timurufa86/kamaz_leveler/README.md

# Kamaz-Leveler

Прошивка системы выравнивания пневмоподвески (ESP32 + FreeRTOS + GitHub OTA).

- Базовая ветка разработки: **`refactor/modular-firmware`**
- Скетч: `kamaz_10_16_8_fr_adafruiti_OTA_NM/`
- Репозиторий: https://github.com/timurufa86/kamaz_leveler

## Аппаратная часть (PCB)

Проект платы (KiCad 10, 2 слоя, корпус 15-8) лежит в [`hardware/`](hardware/README.md).
Там же — документация, рендеры, производственные файлы и скрипты экспорта.

## Toolchain

- **arduino-cli** 1.5.1+
- Ядро: **esp32:esp32 3.3.11+**
- Библиотеки: из `C:\my\libraries` (подключаются через `arduino-cli.yaml`)

## Сборка

Библиотеки подключаются через проектный `arduino-cli.yaml`, где
`directories.user: C:/my` — то есть sketchbook указывает на `C:\my`, а
библиотеки берутся из `C:\my\libraries`.

```powershell
# Компиляция (экспортирует *.bin в build/esp32.esp32.esp32/)
./build.cmd

# Компиляция + прошивка на подключённую плату
./build.cmd COM5
```

Или напрямую:

```powershell
arduino-cli compile --config-file arduino-cli.yaml `
  -b "esp32:esp32:esp32:PartitionScheme=custom,FlashSize=4M" --warnings none --export-binaries `
  --build-property compiler.c.elf.extra_flags=-Wl,--allow-multiple-definition `
  kamaz_10_16_8_fr_adafruiti_OTA_NM
```

> `--warnings none` обязателен: библиотека GEM 1.8.1 содержит функцию без
> `return`, которую ядро ESP32 превращает в ошибку через `-Werror=return-type`.
> (Значение можно передавать как `-Wl,--allow-multiple-definition` или через
> `-D`, главное — попасть в `compiler.c.elf.extra_flags`.)

> `--build-property compiler.c.elf.extra_flags=-Wl,--allow-multiple-definition`
> обязателен, начиная с 8.6.0: библиотека GEM компилируется целиком (включая
> `GEM_u8g2.cpp`), из-за чего в сборку попадает библиотека `U8g2`, а её
> `src/clib/u8g2_fonts.c` дублирует символы шрифтов из
> `U8g2_for_Adafruit_GFX/src/u8g2_fonts.c`. Флаг разрешает дубликаты: линковщик
> оставляет первое определение, неиспользуемые секции удаляются `--gc-sections`.
> Без флага сборка падает на этапе линковки с `multiple definition of
> 'u8g2_font_...'`.

## Карта флеша (4 МБ, своя таблица разделов)

Плата оснащена **4 МБ** флеш-памяти. Штатные OTA-слоты ядра (1.25 МБ) малы
для скетча (~1.6 МБ), поэтому используется **своя схема разделов**
(`kamaz_10_16_8_fr_adafruiti_OTA_NM/partitions.csv`, `PartitionScheme=custom`):

| Раздел | Смещение | Размер | Назначение |
|---|---|---|---|
| `nvs` | 0x9000 | 20 КБ | Wi-Fi/настройки IDF |
| `otadata` | 0xe000 | 8 КБ | выбор OTA-слота |
| `app0` (ota_0) | 0x10000 | **1.75 МБ** | основной слот прошивки |
| `app1` (ota_1) | 0x1D0000 | **1.75 МБ** | слот для OTA-обновления |
| `spiffs` | 0x390000 | 384 КБ | LittleFS (`/config.txt`) |
| `coredump` | 0x3F0000 | 64 КБ | дамп при сбое |

Скетч ~1.6 МБ занимает ~87% слота; запас роста ~230 КБ на слот.

> ⚠️ **Смена карты флеша требует разовой прошивки по USB** (bootloader +
> partitions + app). OTA с прежней 16-мегабайтной схемы разделы НЕ переносит.

## Используемые библиотеки

Резолвятся из `C:\my\libraries`:

| Библиотека | Версия |
|---|---|
| ArduinoJson | 7.4.3 |
| Adafruit BusIO | 1.17.4 |
| Adafruit GFX Library | 1.12.6 |
| Adafruit ST7735 and ST7789 Library | 1.11.0 |
| Adafruit ADS1X15 | 2.6.2 |
| EncButton | 3.7.6 |
| GEM | 1.8.1 |
| GyverFilters | 3.2.0 |
| MPU6050 | 1.4.5 |
| U8g2_for_Adafruit_GFX | 1.8.0 |
| U8g2 (только как источник шрифтов, напрямую не подключается) | 2.36.19 |

## Настройки и сервис (8.8.0)

Новые параметры меню (все сохраняются в `/config.txt`, формат **3**, и подгружаются
при старте; старые `config.txt` форматов 1–2 читаются, новые поля = значения по умолчанию):

| Раздел меню | Пункты | Значение по умолчанию |
|---|---|---|
| Давление | Проверка МП,с | 240 |
| Клапаны | Макс.время,с; Зона нечувств.,бар | 10; 0.20 |
| Авторежим | Грубая зона; Точная зона; Порог «хуже» | 0.40; 0.15; 1.20 |
| Движение | Длительность,с; Успокоение,с; Проверка,с; Допуск,бар; Порог гиро; Порог аксель | 30/30/120/0.2/50/1000 |
| Дисплей | Гасить,мин (0 = никогда); Интервал,мс; Порог углов; Порог давл. | 0; 50; 0.05; 0.03 |
| IMU / MPU6050 | Порог детектора; Нуль X,град; Нуль Y,град | 100; 0.0; 0.0 |

Запись конфига — атомарная (`config.tmp` → `config.txt`, предыдущая версия в
`config.bak`), после записи файл проверяется чтением; при старте и после
сохранения в Serial печатается дамп всех значений (`[CFG] …`). Страница меню
**«Настройки»** показывает текущие значения на экране.

### Новые разделы меню

- **«IMU / MPU6050»**
  - **Обнулить углы** — текущее положение становится нулём (с подтверждением
    КН3/КН4); нуль сохраняется в конфиг и учитывается в показаниях и в авторежиме.
  - **Калибровка офсетов** — библиотечная `CalibrateGyro`/`CalibrateAccel` (DMP на
    время калибровки выключается), 6 офсетов сохраняются в конфиг и применяются при
    старте. Требуется ровная площадка и неподвижная машина 10–20 с.
  - **Диагностика MPU** — DeviceID, температура, углы, сырые `getMotion6`, офсеты,
    признак ошибки MPU.
  - **Порог детектора** — аппаратный `setMotionDetectionThreshold` (20…255).
- **Ручной тест клапанов** (раздел «Тестирование») — 6 выходов: ПЛ, ПП, ЗЛ, ЗП,
  НАКАЧКА, СБРОС. Кн1/Кн2 — выбор, **клапан открыт, пока удерживается КН3**,
  Кн4 — выход с закрытием всех клапанов; страховочный таймаут 15 с; доступно
  только в РУЧНОМ режиме без ошибок и вне OTA; аварийная остановка КН4+КН5
  также закрывает клапаны.
- **Гашение подсветки** — по бездействию N минут (`Дисплей → Гасить,мин`);
  первое нажатие только включает подсветку и не выполняет действие.

## Визуализация: экран ДВИЖЕНИЯ (8.9.0)

В режиме ДВИЖЕНИЯ главный экран автоматически сменяется отдельным «экраном движения»:

- цели передних/задних подушек (из настроек) vs текущие давления и рассогласование Δ
  с цветом по допуску (`Движение → Допуск,бар`);
- четыре карточки подушек: текущее значение, метка цели на полосе, Δ по каждой подушке;
- таймеры: «в движении N с», «СТАБИЛИЗАЦИЯ N с» (полоса), «след. проверка N с»,
  «последняя подкачка N с назад»;
- активные клапаны (накачка/сброс передних/задних) с анимацией «бегущих штрихов»;
- тренд (спарклайн) давлений за 30 с: две линии (перед/зад) + штриховые линии целей;
- режимные иконки из `icon.h` в статус-баре (20×20) и пульсирующий бейдж движения в шапке;
- сглаживание (интерполяция) значений и частичная перерисовка — без мерцания.

Логика движения и выравнивания не менялась — экран только читает данные. Наружу вынесены
две переменные времени последней корректировки (`movementLastAdjustFront/Rear`) и
добавлена отметка начала движения (`movementStartMs`).

## Меню и обновления (8.7.0)

- **Вход в меню** — удержание пары **КН3 + КН4** (GPIO15 + GPIO17, 2 с) из любого
  режима и экрана. **Аварийный стоп** — удержание пары **КН1 + КН4**
  (GPIO13 + GPIO17, 2 с); он обрабатывается первым и подавляет открытие меню.
- В меню: Кн1/Кн2 — навигация, Кн3 — ОК, Кн4 — назад (пункт «Назад» создаёт GEM для
  подстраниц), Кн5 — сохранить и выйти. Подсказка дублируется в шапке меню.
- Раздел **«Обновления»**: проверка GitHub, список до 3 релизов
  (`/releases?per_page=3`), карточка релиза (дата, размер, статус, SHA-256),
  установка последней или выбранной версии, режим ArduinoOTA (Wi-Fi).
- Экран прогресса обновления показывается в любом режиме, шапка «ОБНОВЛЕНИЕ»,
  крупный процент и предупреждение «Не выключайте питание».
- Wi-Fi: пароль единый (`asd12345`), экран выбора сети переведён на U8g2 (шкала
  уровня сигнала, усечение длинных имён).
- Страница «Информация» в меню — живая: версия, режим, MPU, давление в магистрали,
  Wi-Fi (SSID/RSSI), аптайм и свободная RAM, число активных ошибок.

## Home Assistant (10.16.0)

Интеграция по **HTTP REST**, включается в меню **Система → Дом (HA)**. Брокер не
нужен: устройство поднимает сервер на порту 80.

- `GET /api/state` — вся телеметрия; `GET /api/config` — все настройки;
  `POST /api/config` — безопасное подмножество; `POST /api/mode` — АВТО/РУЧНОЙ;
  `POST /api/manual` — start/stop/pulse; `POST /api/action` — reset/save/stop/restart.
- Необязательный токен `X-Api-Key` (Serial: `HA TOKEN <стр>`).
- Готовые файлы: `ha/kamaz_leveler_package.yaml`, `ha/kamaz_leveler_dashboard.yaml`,
  инструкция — `docs/HA_INTEGRATION.md`.
- На время OTA сервер останавливается (освобождает сокеты/кучу) и поднимается после.

## Версионирование и релиз

- SemVer: см. `.cursor/rules/semantic-versioning.mdc` (стиль папок/веток `9.0.0`).
- OTA-релиз: см. `.cursor/rules/github-ota-release.mdc`
  (ассеты `kamaz_leveler.bin` + `kamaz_leveler.bin.sha256`, тег `v9.0.0`).

## Типографика и визуализация (появились в 8.6.0)

Весь текст на экранах выводится через **U8g2_for_Adafruit_GFX** (UTF-8, честные
размеры шрифтов, кириллица) — слой из трёх модулей:

| Модуль | Назначение |
|---|---|
| `ui_theme.h` | палитра RGB565, сетка и метрики экрана (отступы, радиусы, высоты строк) |
| `ui_fonts.h` | шрифтовая лестница `UiFont` (Tiny…Huge) — кириллические шрифты U8g2 |
| `ui_text.h` / `.cpp` | класс `UiText` (экземпляр `ui`): печать по базовой линии, выравнивание и вертикальное центрирование в прямоугольнике, `printf`-варианты без динамической памяти, усечение строк с `..` |

Шрифтовая сетка (все с кириллицей):

| Роль | Шрифт | Применение |
|---|---|---|
| Tiny | `u8g2_font_5x7_t_cyrillic` | подсказки, подписи шкал |
| Small | `u8g2_font_6x13_t_cyrillic` | основной мелкий текст, списки |
| SmallB | `u8g2_font_6x13B_t_cyrillic` | акценты и подписи карточек |
| Body / BodyWide | `u8g2_font_7x13` / `8x13_t_cyrillic` | основной текст |
| Med | `u8g2_font_10x20_t_cyrillic` | заголовки экранов, значения |
| Large / XLarge / Huge | `u8g2_font_inr24/33/46_t_cyrillic` | крупные значения, сплэш |

Важно: `U8g2_for_Adafruit_GFX` **не масштабирует** текст (аналога `setTextSize`
нет), поэтому размер задаётся выбором шрифта — глифы остаются пиксель-в-пиксель
вместо растягивания. Меню GEM (`GEM_adafruit_gfx`) по-прежнему работает на
Adafruit-GFX-шрифтах `CourierCyr7`/`CourierCyr9` из `FontsRus/` — только для
пунктов меню; все остальные экраны переведены на U8g2.
