timurufa86/kamaz_leveler/PROMPT_hardware_schematic_pcb.md

# Промт: проект принципиальной схемы и трассировки платы Kamaz-Leveler

> Как использовать: открой новый проект в Cursor/Claude с этим репозиторием прошивки
> (`kamaz_leveler/`, ветка `refactor/modular-firmware`, скетч `kamaz_10_16_8_fr_adafruiti_OTA_NM/`),
> чтобы агент мог читать `app_pins.h`, `README.md`, `MODULES.md`.
> Скопируй текст ниже целиком как первое сообщение.

---

## 0. Роль

Ты — инженер-схемотехник и PCB-дизайнер с опытом автомобильной электроники (24 В бортсеть,
индуктивные нагрузки, EMC/ESD, ISO 7637-2 / ISO 16750-2). Ты ведёшь проект целиком: от
блок-схемы и принципиальной схемы до трассировки, проверок и выпуска файлов в производство.
Работай в **KiCad 8+** (проект, библиотеки, ERC/DRC, gerbers). Отвечай по-русски, кратко и
по делу; всё неизвестное помечай `TBD`, все допущения — `[ASSUMPTION]`. Ничего не выдумывай:
если данных нет — спрашивай.

## 1. Задача

Разработать с нуля **заказопригодный** проект печатной платы автомобильного блока
управления системой выравнивания пневмоподвески КАМАЗ:

- MCU: **ESP32-WROOM-32** (4 МБ флеш, Wi-Fi, OTA, **без PSRAM** — обязательно WROOM, не WROVER:
  GPIO16/17 заняты);
- 6 пневмоклапанов **24 В** (4 селектора подушек + НАКАЧКА + СБРОС), управление активным HIGH;
- 5 кнопок (на GND, с внешними подтяжками);
- TFT **ST7789 320×240** по SPI (до 40 МГц) с ШИМ-подсветкой;
- датчик давления **JHM1200** (I2C 0x78, 0…1 МПа) и **MPU6050** (I2C 0x68/0x69) на одной шине;
- питание от бортовой сети грузовика **24 В**, UART для прошивки и логов.

## 2. Неизменяемая часть — прошивка (источник истины по пинам)

Прошивка версии **10.16.8**; распиновка задана жёстко в
`kamaz_10_16_8_fr_adafruiti_OTA_NM/app_pins.h`. **Менять назначение GPIO без отдельного
письменного согласования запрещено.**

### 2.1 Занятые пины

| GPIO | Функция | Направление | Особенности / ограничения на плате |
|---|---|---|---|
| 21 | I2C SDA (JHM1200 0x78 + MPU6050 0x68/0x69) | bidir, open-drain | внешняя подтяжка 4.7 кОм к **3.3 В**, шина 100 кГц |
| 22 | I2C SCL | out, open-drain | подтяжка 4.7 кОм к 3.3 В |
| 23 | TFT MOSI (VSPI) | out | короткие дорожки, в стороне от силовых |
| 18 | TFT SCLK, 40 МГц | out | то же |
| 5 | TFT CS | out | **strap-пин**: при старте должен быть HIGH — внешняя подтяжка 10 кОм вверх |
| 16 | TFT DC | out | на WROVER занят PSRAM → только WROOM |
| 19 | TFT RST | out | в VSPI это MISO; MISO не используется, ничего не подключать |
| 4 | TFT BL (подсветка) | ШИМ (analogWrite/LEDC) | ключ на транзисторе/MOSFET + токоограничивающий резистор, если модуль без драйвера |
| 32 | Клапан BUB1 (ПЛ) | out | HIGH = катушка под напряжением |
| 33 | Клапан BUB2 (ПП) | out | HIGH = открыт |
| 25 | Клапан BUB3 (ЗЛ) | out | HIGH = открыт |
| 26 | Клапан BUB4 (ЗП) | out | HIGH = открыт |
| 27 | Клапан INFL (накачка) | out | HIGH = открыт |
| 14 | Клапан DEFL (сброс) | out | HIGH = открыт |
| 13 | КН1 | in, `INPUT_PULLUP` | кнопка на GND; RC-фильтр + ESD |
| 12 | КН2 | in, `INPUT_PULLUP` | **strap MTDI**: недопустим LOW в момент старта (см. §3.4) |
| 15 | КН3 | in, `INPUT_PULLUP` | **strap**: при старте HIGH — кнопка на GND совместима |
| 17 | КН4 | in, `INPUT_PULLUP` | кнопка на GND |
| 34 | КН5 | in, **input-only** | нет внутренних подтяжек → **обязателен внешний резистор 10 кОм на 3.3 В** |
| 1 / 3 | UART0 TX/RX (лог 115200, прошивка) | — | вывести на USB-UART и/или тестовый хедер |
| 6…11 | внутренняя SPI-флешь | — | **не занимать** |
| 0 / 2 | strap (boot) | — | использовать только при необходимости, с подтяжками |

### 2.2 Логика клапанов и безопасность

- `HIGH` = катушка под напряжением, `LOW` = закрыт.
- **Критично:** при отсутствии питания 3.3 В, в reset, при зависании MCU и во время загрузки
  (до `setup()`) все клапаны обязаны быть **аппаратно закрыты** → на каждом входе драйвера
  обязателен **pull-down 10 кОм** и отсутствие подтяжки вверх. Прошивка 10.15.x обесточивает
  выходы в первых строках `setup()`, но до старта ядра GPIO плавают.
- Прошивка не читает состояние клапанов (нет линий диагностики) — силовой каскад должен быть
  самозащищённым (токовое ограничение, термозащита) либо иметь внешние предохранители по каналу.

### 2.3 Датчики

- Давление в 4 подушках и в магистрали измеряется **одним** датчиком JHM1200 (0…1 МПа ≈ 10 бар
  избыточного) через пневматический мультиплексор (клапаны BUB1…4 + INFL/DEFL) → на плате
  **один** разъём датчика давления.
- I2C держать на **100 кГц** (на 400 кГц JHM1200 нестабилен рядом с MPU6050); при выносе
  датчиков — витая пара/экран + феррит, длина минимальна.

### 2.4 Питание и нагрузки

- Вход: бортсеть 24 В (реальный диапазон ~18…32 В + пуски и выбросы).
- Потребители: 6 катушек 24 В, ESP32 (пик до ~0.7 А по 3.3 В с Wi-Fi), TFT, датчики.
- Ток катушки и число одновременно открытых клапанов — **уточнить** (по логике прошивки
  одновременно возможны до 3: два селектора + один INFL/DEFL).

## 3. Обязательные требования к электрике

1. **Вход 24 В**: предохранитель (≥5 А, с расчётом), защита от обратной полярности
   (P-MOS / ideal diode), TVS-супрессор на load dump (ISO 7637-2 pulse 5 / ISO 16750-2),
   входной LC-фильтр (синфазный дроссель + X/Y-конденсаторы) для EMC, ESD-защита на всех
   внешних линиях (кнопки, датчики, разъёмы).
2. **Питание логики**: DC/DC 24→5 В (≥2 А, синхронный buck, вход до 40 В, automotive) и
   5→3.3 В (≥1 А) либо 24→3.3 В напрямую; ёмкости и фильтры по даташитам, thermal-расчёт.
3. **Драйверы клапанов**: защищённый ключ, рассчитанный на индуктивную нагрузку 24 В
   (smart low-side switch, например VNLD/BTS/VND…, либо N-MOSFET + gate resistor + pull-down +
   freewheel-диод/RC-снаббер). Расчёт тока удержания/броска, потерь и температуры корпуса.
4. **Поведение при отказах**: при пропаже 3.3 В или reset MCU — все каналы закрыты (pull-down).
   Опционально (по согласованию) — дублирующее реле/ключ обесточивания по аварийной паре кнопок.
5. **Земли**: единая сплошная GND-плоскость предпочтительна; силовой возврат катушек —
   отдельным путём к точке входа питания (звезда), не через аналоговую/I2C-зону; при 4 слоях
   L2 = сплошная GND.
6. **I2C**: подтяжки 4.7…10 кОм **только к 3.3 В**; дорожки короткие (<15 см).
7. **SPI TFT**: линии короткие, не параллельно силовым; BL через ключ (N-MOSFET/NPN + резистор),
   частота ШИМ ≥1 кГц.
8. **Прошивка/отладка**: USB-UART (CP2102N / CH340C) с auto-reset (DTR/RTS → EN/IO0) **или**
   внешний программатор — выбрать и обосновать; отдельный тестовый хедер TX/RX/GND/EN/IO0.
9. **Индикация**: светодиод питания и статусный светодиод.
10. **Опции** (только по согласованию): внешний watchdog (TPL5010/5011), CAN/RS-485, пищалка.

## 4. Конструктив и трассировка

- Слоёв: минимум 2, рекомендуется 4 (L1 сигнал, L2 GND, L3 питание, L4 сигнал/питание).
- Габарит и крепёж: предложить (ориентир 100×80 мм), 4×M3; согласовать до трассировки.
- Классы проводников: логика 0.25 мм; 3.3 В 0.5 мм; 5 В 1.0 мм; 24 В силовые 1.5…2.0 мм
  (из расчёта тока, ≥1 мм² на 2 А при допустимом перегреве); I2C 0.25 мм.
- Зазоры: 24 В ≥0.5 мм (при >60 В — слот/вырез), смешанные зоны ≥0.3 мм.
- Разъёмы: питание и клапаны — автомобильные с фиксацией (JST-XH/DT/AMP), запас по току,
  strain relief; подписать пины на шелкографии.
- Условия эксплуатации: −40…+85 °C, вибрация, конформное покрытие; тест-поинты GND/3.3/5/24 В,
  TX/RX, I2C, BL, EN/IO0; монтажная маркировка.

## 5. Deliverables

1. KiCad-проект: `.kicad_pro`, иерархия `.kicad_sch` (питание/защита, MCU, драйверы клапанов,
   UI/кнопки, датчики, разъёмы), `.kicad_pcb`, локальные библиотеки символов и футпринтов
   (только проверенные, с MPN).
2. ERC-отчёт: 0 ошибок (предупреждения — с обоснованием).
3. DRC-отчёт: 0 ошибок, 0 неразведённых цепей (ratsnest = 0), нет залитых «островов».
4. BOM CSV: RefDes, Value, MPN, Manufacturer, Package, Qty, поставщик/цена, аналоги + DNP-список.
5. Gerbers + NC drill + BOM/CPL (формат JLCPCB/PCBWay) одним zip, готовые к заказу; STEP 3D.
6. PDF: принципиальная схема (A3) + монтажные слои (F.Cu, F.Silk, F.Fab, F.Mask).
7. `HARDWARE.md`: таблица «GPIO ↔ цепь ↔ пин разъёма», токи/питание, тепловые расчёты
   драйверов и buck, перечень защит, ограничения монтажа, **сверка 1:1 с `app_pins.h`**.
8. Чек-лист ревью и список открытых `TBD`.

## 6. Правила работы

- Сначала — уточняющие вопросы (§7) и блок-схема. Генерацию файлов начинай после ответов;
  если ответов нет — прими явные `[ASSUMPTION]` и пометь их в отчёте.
- Не меняй распиновку прошивки. Предложения по переносу пинов (например GPIO12 из-за strap)
  оформляй отдельным пунктом с обоснованием и последствиями для кода.
- Каждый компонент — с реальным заказопригодным MPN; «Generic» в силовых цепях запрещён.
- Каждую силовую цепь сопровождай расчётом: ток, потери, температура, номинал предохранителя,
  сечение дорожки.
- Этапы с отчётом и подтверждением: **M1** блок-схема → **M2** принципиальная схема →
  **M3** футпринты и размещение → **M4** трассировка → **M5** проверки и выпуск файлов.
- Итоговый ответ по этапу: (1) что сделано, (2) список файлов, (3) ERC/DRC, (4) открытые TBD,
  (5) риски.

## 7. Вопросы до начала работы

1. Тип/модель пневмоклапанов: напряжение (24 В?), ток/мощность катушки, сколько могут быть
   открыты одновременно, требования по времени срабатывания.
2. Как сделано в существующем (as-built) жгуте: high-side или low-side, есть ли реле/драйверы,
   полярность управления (подтвердить HIGH = открыт).
3. Габариты платы, крепление, расположение и тип разъёмов, требования к корпусу и IP.
4. Есть ли в системе 5 В, нужно ли управление по зажиганию (IGN), допустимый ток потребления,
   нужна ли гальваническая развязка.
5. Внешние интерфейсы: только кнопки и экран или нужны CAN/RS-485/доп. датчики (в прошивке
   сейчас их нет).
6. Дисплей: точная модель ST7789 320×240 (2.4"/2.8"/3.5"), тип шлейфа/разъёма, на плату или
   на панель (вынос).
7. Датчики JHM1200 и MPU6050: на плате или выносные, длина шлейфа, нужна ли термостабилизация.
8. Кнопки: 5 шт. на плате или выносная панель; нужна ли подсветка/пищалка.
9. Требования EMC/сертификации, серийность (1 шт. / мелкая серия), бюджет, предпочтительные
   поставщики (JLCPCB/LCSC/Чип и Дип).
10. Обязательные стандарты: ISO 7637-2, ISO 16750-2, ведомственные ТУ/ГОСТ заказчика?

## 8. Критерии приёмки

- ERC и DRC чистые; таблица пинов совпадает с `app_pins.h` **1:1** (приложить сверку).
- Все 6 каналов закрыты при отсутствии 3.3 В, reset MCU и зажатой кнопке — подтверждено
  наличием pull-down на каждом драйвере.
- I2C подтянут к 3.3 В (не к 5 В); strap-требования GPIO12/15/5 выполнены и описаны.
- BOM заказопригоден, gerbers принимаются JLCPCB/PCBWay без правок.
- Есть тепловые расчёты драйверов и преобразователей, рассчитаны предохранитель и TVS.
- Приложены STEP, монтажные слои, PDF схемы, `HARDWARE.md`.

## 9. Запрещено

- Использовать GPIO 6…11; вешать на GPIO12 что-либо, создающее LOW при старте; занимать
  GPIO0/2 без нужды.
- Питать катушки 24 В от 3.3/5 В; ставить драйвер без freewheel-диода и без pull-down.
- Подавать 5 В логику на пины ESP32 без преобразования уровня.
- Оставлять в схеме плавающие входы, необозначенные цепи, «Generic» компоненты в силовых
  цепях, неразведённые узлы.
- Молча менять распиновку прошивки.

## 10. Первый ответ агента

Задай вопросы из §7, предложи блок-схему устройства и план этапов M1…M5 с ожидаемым объёмом
работ, затем жди подтверждения. Файлы не генерируй до подтверждения.
