timurufa86/kamaz_leveler/hardware/HANDOFF.md

# HANDOFF — Kamaz Leveler HW (состояние на 18.10.2026, 07:45)

## Как продолжить

Откройте новый чат и напишите:
> «Прочитай C:\my\HANDOFF.md и продолжи с раздела "Следующие шаги"»

## Проект

Контроллер пневмоподвески КАМАЗ: ESP32 30-pin DevKitC, 6 клапанов 12 В (high-side),
5 кнопок (выносная плата кнопок, на материнской плате — только разъём), дисплей ST7789 (SPI),
JHM1200 + MPU6050 (I²C). Плата 83×58 мм, 2 слоя, компоненты с обеих сторон.

## Файлы

| Файл | Размер | Состояние |
|---|---|---|
| `kamaz_leveler_hw.kicad_sch` | 438 076 б | ✅ **ERC 0/0**. **114 компонентов**: база 72 + индикаторы D11–D16/R23–R28 + J6 (гироскоп) + **U6 PCAL9555APW** + C29 + R29–R38 + **датчики: J7 (скорость), J8 (давление), U11 (78L08), U12 (74LVC1G14), JP1, R39–R42, D17/D18/D20, C30–C33/C35** |
| `...bak_before_valve_leds` | 317 471 б | бэкап ДО индикаторов клапанов (72 компонента) |
| `...bak_before_rm_j6` | 320 913 б | бэкап ДО удаления J6 |
| `...bak_before_L4C28` | 318 687 б | бэкап ДО правок 24 В |
| `kamaz_leveler_hw.kicad_pcb` | — | **Пользовательская расстановка (U7 ESP32-C3, 117 футпринтов = 113+4, совпадение с нетлистом 1:1), 2 слоя. Разводка: 253/284 цепей, 31 не разведена, DRC-электрика чистая (0 shorting/clearance); остались только cosmetic/mechanical (courtyard 9 под модулем, via_dangling 13, track_width 2, silk). Бэкапы: `.routed_user_18`, `.routed_72` |
| `...kicad_pcb.bak_before_reflow` | 554 908 б | рабочее состояние платы (на него откатывались после попыток перекомпоновки) |
| `...kicad_pcb.bak_before_rm_j6`, `...bak_after_j6_rm` | 537 553 б | плата до/после удаления J6 |
| `BOM.csv` | 4 326 б | ✅ из схемы, **114 позиций** |
| `route\` | — | `board4.dsn`, `board4.ses`, `pipeline4.cmd`, `ses_import_fix.py` — headless DSN→FreeRouting→SES→DRC |
| `drc_after_routing.json` | 137 КБ | DRC разведённой платы (48 unconnected) |
| `M7_board_routed.png` | 169 КБ | картинка разведённой платы (без J6) |
| `PLACEMENT_PLAN.png` | 115 КБ | **план размещения компонентов** — зоны, разъёмы, U6/индикаторы/J6, keep-out антенны |
| `PLACEMENT_TABLE.md` | 6 КБ | **таблица плана**: координаты якорей, зоны с полными списками ref, правила |
| `LEDS_PLACEMENT.png` | 73 КБ | детальный план индикаторов: D11–D16 + R23–R28 (клапаны), D4 + R22 (+3V3) — координаты и подключение |
| `GYRO_PINOUT.png` | 106 КБ | **распиновка J6** — отдельный 4-pin разъём гироскопа (VCC/GND/SCL/SDA), схема подключения и место на плате |
| `DESIGN_OPTIONS_pcf8575.md` | 9 КБ | **варианты архитектуры клапанов**: PCF8575 / PCA9555 / PCAL9555A / TCA9535, общий +12 В и низкие ключи — сравнение, решение, реализация |
| `PCAL9555_BLOCK.png` | 74 КБ | блок-схема U6 PCAL9555APW: биты, клапаны/ST/кнопки, fail-safe VLV_EN |
| `LOW_SIDE_OPTION.png` | 115 КБ | блок-схема варианта «общий +12 В + низкий ключ» |
| `M6_schematic_24V.pdf` | 350 507 б | схема A2, актуальна: индикаторы, J6, U6, входы датчиков скорости/давления |
| `erc_final.json`, `netlist_final.net` | — | ERC (0/0) и нетлист схемы |
| `HARDWARE.md` | ~28 КБ | обновлены §2/§3/§4/§8 (24 В), §9 (PCAL9555APW), §10 (датчики) |
| `C:\my\sch3\` | — | скрипты этапа: `core.py`, `router.py`, `reflow*.py`, `place_*.py`, `local_phys.py`, `pack_all*.py`, `verify_net.py`, `add_valve_leds.py`, `add_leds_mcp.py`, `pcb_add_leds.py`, `bom_final3.py` |
| `C:\my\pcb_prep\` | — | read-only разбор платы: `REPORT_pcb_prep.md`, inventory, DRC-пары, координаты L4/C28 |

### 3D-модели (STEP, SnapEDA)

- KiCad: `C:\my\kamaz_leveler_hw\3dmodels\` — TPS54560BDDA.stp, BTS724GXUMA1.stp,
  74HCT541D.stp, AP3211KTR-G1.stp, ESP32-DevKitC.stp (прописаны: U1, U2, U3, U4, U5, U9)
- Proteus: `C:\ProgramData\Labcenter Electronics\Proteus 9 Professional\Models\`
- Исходные архивы: `C:\my\step_extracted\`, `D:\proteus\model\`

## Протеус

| | |
|---|---|
| Проект | `C:\Users\Asus\Documents\kamaz_1.pdsprj` (89 145 б) |
| Пакеты | 76/76 назначены, `Verify Packagings` = 1 ошибка (U1 Pin 9 — термопад) |
| Библиотека | `CMOS176_p9.lib` — регистр ESP32 исправлен (`.bak_case`) |
| Плата ARES | пустая: 0 объектов, нет контура → нужен контур 83×58 (`C:\my\kamaz_board_edge.dxf`) |
| Сторож/обёртка | `C:\my\proteus_ensure.cmd`, `C:\my\pkmcp.ps1` |

## Следующие шаги (по порядку)

### 1. ✅ Защита 24 В — выполнено 17.10.2026

`+24V_IN (J1.1) → F1 5A → VIN_FUSED → L4 10µH → VIN_FILT → Q1 IRF9540N (D→S) → +24V →
D1 1.5KE36CA ‖ C28 330µF/35V ‖ C2 470µF + C1 100nF → U1 TPS54560B → +12V → U2 AP3211K →
+5V → U10 AMS1117 → +3V3`.

- L4: `Device:L` 10µH, (25.4, 50.8), между F1.2 и стоком Q1.2 (`VIN_FILT`).
- C28: `Device:C_Polarized` 330µF/35V, (63.5, 57.15), +24V/GND. D1 → 1.5KE36CA.
- ERC 0/0, BOM пересобран. Бэкапы: `.bak_before_L4C28`, `.bak_24v`.

### 2. Замена U9 на `Conn_02x15_Top_Bottom` — ⚠️ рекомендую не делать

Текущий `kamaz_leveler:ESP32-DevKitC_30P` есть в проектной библиотеке, имеет имена выводов
и сверен с DevKitC 1:1. Generic-символ потеряет имена GPIO и потребует перерисовать 30
подключений без выигрыша.

### 3. Метки → провода — черновик есть, в проект не внедрён

Инструментарий в `C:\my\sch3\`. Черновик `sch3\kamaz_step3.kicad_sch`: разведено 16/47
меточных цепей, ERC 0, нетлист совпадает с исходным 1:1. Не внедрён: остальные 30 цепей
требуют перепланировки листа (блоки разнесены на 150–230 мм). Рекомендация: либо оставить
метки (штатная практика KiCad), либо делать перерисовку листа отдельной сессией.

### 4. Плата — синхронизация и первая трассировка выполнены

- **Синхронизация** (pcbnew Python): L4 `L_Bourns_SRP1245A` (66.5, 27.5, rot 90, B),
  C28 `CP_Elec_8x10` (78.5, 30.0, rot 90, B), цепь `/VIN_FILT`; R17 и J6 удалены.
- **Трассировка** headless: `route\pipeline4.cmd` — `ExportSpecctraDSN` → FreeRouting 2.5
  **через JAR + JRE 25** (native `freerouting-cli.exe` падает с GraalVM-багом), 5 проходов
  ~95 с → `ImportSpecctraSES` → ширина дорожек ≥0.25 мм → DRC.
- Результат: **1190 проводников, 48 unconnected** (было 196); DRC 123 (было 99; новые —
  `via_dangling` 20, `copper_edge_clearance` 3, `clearance` +1 от неразведённых цепей).
- Основной блокер — «левая полоса» (J4/J5 ↔ D5–D10 ↔ L3/C2/C13): 90 % нарушений, лечится
  перекомпоновкой. Разбор всех пар — `C:\my\pcb_prep\REPORT_pcb_prep.md`.

### 5. Перекомпоновка платы под EMC/механику — ПЛАН СОГЛАСОВАН, не выполнена

Требования заказчика: 24 В — с одной грани; остальные разъёмы — с противоположной;
дроссели и силовая часть — подальше от I²C и дисплея; без наводок на антенну ESP32;
вся «сила» — в одной зоне.

**Антенна.** У DevKitC USB — со стороны вывода 1 (локальная −X), антенна — на
противоположном торце (локальная +X). Сейчас модуль стоит в (23.72, 16.3) rot 0 —
антенна смотрит вправо, прямо в силовую зону (L2/L4/F1/U1/C28) — это источник наводок.

**Ограничение:** J2 18.9 + J3 16.3 + J4 11.25 + J5 21.4 = 67.9 мм > 58 мм — все 4 разъёма
на одну грань не помещаются. Согласовано заказчиком:

| Грань | Разъёмы |
|---|---|
| левая | J1 (24 В вход) |
| нижняя | J2 (клапаны, 7-pin) — силовая сторона |
| верхняя | J5 (дисплей), J3 (кнопки), J4 (I²C) — сигнальная сторона |
| правая | нет разъёмов; **antenna keep-out x 74…83, y 8…47** (ни деталей, ни дорожек/pour) |

**Зоны (см. PLACEMENT_PLAN.png):**

| Зона | Координаты | Содержимое |
|---|---|---|
| POWER | левая полоса x 0…32, вся высота | J1, F1, L4, Q1, D1, C28, C1/C2/C4/C5, U1+L2, U2+L3, U10, C6/C7/C11–C14, C19–C22, R1–R10 |
| VALVE | x 4,5…40, y 32…50,5 | U3/U4/U5 (SOIC-20W), R11/R13–R16, D5–D10 (рядом с J2) |
| MCU | x 32…83, y 13…42 | U9 rot 0, pad1 (41, 15): USB влево, антенна на правую грань |
| SIGNAL | верхняя полоса | J5, J3, J4 |
| индикаторы | у J2, x 31…47, y 44…51 | D11–D16 + R23–R28 — по одному LED на пин J2 (2…7) |

Ключевые расстояния: L2/L3/L4 — левая/нижняя часть силовой зоны (≥35 мм от J4/J5,
≥40 мм от антенны); силовые узлы — не ближе ~30 мм к правой грани.

**Полный план размещения (101 футпринт: 97 компонентов + 4 отверстия):**
`PLACEMENT_PLAN.png` — зоны и грани; `PLACEMENT_TABLE.md` — координаты якорей и полные
списки компонентов по зонам. В плане учтены новые позиции: **U6 PCAL9555APW + C29 +
R29–R38** — в зоне под модулем ESP32; **J6** (гироскоп) — на нижней грани справа от J2;
**D11–D16 + R23–R28** — у пинов J2.

**Мелкие SMD под модулем ESP32.** Между двумя рядами гнёзд (ряды на y = 15 и y = 40.4,
шаг 2.54 мм) остаётся свободное поле ~31 × 23 мм (x 42…73, y 16…39). Туда выносится
обвязка МК — 11 шт. 0805/1206: `R18, R19, R20, R21` (подтяжки), `C17, C18` (3V3-развязка),
`C23…C27` (фильтры I2C/кнопок). Правила: только низкопрофильные SMD (высота ≤3 мм;
зазор до модуля ≈8.5 мм при гнездовых разъёмах 2.54), ≥1 мм от падов гнёзд, **не ставить**
дроссели, электролиты и силовые ключи 12 В (наводки под МК/антенну). Резерв — ещё
~25 посадочных мест 0805. Индикаторы клапанов `D11–D16 + R23–R28` — вплотную к `J2`: каждый LED стоит
**точно под своим пином** (2/BUB1, 3/BUB2, 4/BUB3, 5/BUB4, 6/INFL, 7/DEFL), резистор —
над своим LED. Активный канал виден сразу. `D4 + R22` (+3V3) — в силовой зоне у выхода U10.

**Статус:** автоматические попытки раскладки (`sch3\pack_all*.py`, `reflow*.py`,
`place_text*.py`) дают зоны, но не доведены до DRC-чистоты: при переносе футпринтов
появляются пары падов с зазором <0.5 мм. Плата откачена в рабочее разведённое состояние.
Делать итеративно: перенос → DRC (~5 с) → правка пар → повторная трассировка. Оценка 1–2 ч.

### 6. Индикаторы питания клапанов — схема готова, плата ожидает

- В схеме: `D11…D16` (`Device:LED`, 0805) + `R23…R28` (4.7 kΩ, 0805) на цепи
  `VALVE_BUB1…4`, `VALVE_INFL`, `VALVE_DEFL`; цепь `VLV_LED1…6` между катодом LED и R.
  Ток индикации ≈ 2.3 мА при 12 В. ERC 0/0, BOM 85 позиций.
- **В плату ещё не внесены** — внести вместе с перекомпоновкой: LED+R вплотную к `J2`,
  по одному каналу на пин 2…7 (LED под пином, R над LED); пад 2 LED — на `VALVE_x`, R — на GND.
- **J6 — отдельный разъём гироскопа (4 пина, I2C)**: `J6.1 = +3V3`, `J6.2 = GND`,
  `J6.3 = I2C_SCL` (U9.17/GPIO22, R21 4.7k), `J6.4 = I2C_SDA` (U9.20/GPIO21, R20 4.7k).
  Подтяжки уже на плате, J4 (I2C) остаётся — гироскоп и, например, барометр работают
  на одной шине. Распиновка и схема — `GYRO_PINOUT.png`. На плате J6 ставится на нижнюю
  грань справа от J2 (x 50…62, y 52.6, rot 90) — вносится вместе с перекомпоновкой.
- **Плата кнопок — отдельно**: кнопки на материнской плате не стоят, `J3` (1×6) —
  разъём для выносной платы кнопок. Отдельную плату кнопок (5 тактовых кнопок 12 мм +
  разъём 1×6) нужно делать отдельным проектом.

### 7. После перекомпоновки

1. Внести 12 индикаторов, перетрассировать (`route\pipeline4.cmd`).
2. U2: FPID `SOT-23-6`, а внутри SOIC-8-1EP — заменить на настоящий SOT-23-6,
   проверить пады 1–6 (BOOT2/GND/FB2/+12V/+12V/SW2).
3. U1: EP ↔ пады 2/3 (+24В) — 0.11 мм при классе 0.5 мм; ослабить класс до 0.2–0.3 мм.
4. Добить остаток unconnected, DRC → 0, экспорт Gerber/drill/pos/BOM/PDF
   (`kicad-cli pcb export gerbers|drill|pos|pdf`).

### 8. Расширитель I²C PCAL9555APW: кнопки + клапаны + чтение ST (18.10.2026)

Статус: **реализовано в схеме**, в плату вносится на шаге перекомпоновки.
Полный разбор вариантов — `DESIGN_OPTIONS_pcf8575.md`, блок-схема low-side — `LOW_SIDE_OPTION.png`.

**Решение:** PCF8575 заменён на **PCAL9555APW** (NXP, TSSOP-24, 16 бит, push-pull выходы,
Agile I/O: маска/защёлка/фронт прерываний). Силовая часть остаётся **high-side BTS724G**,
общий провод клапанов — `J2.1 = GND`; от варианта «общий +12 В, управление минусом» отказались
(теряются ST/защиты PROFET, КЗ на GND = клапан постоянно включён, нужны плавающие клапаны).

**Чип подтверждён:** PCAL9555APW. **TCA9535PWR** — pin-совместимый fallback (тот же TSSOP-24):
замена = только `Value` у U6, цепи/футпринт не меняются; минусы — без Agile I/O и без
встроенных подтяжек (внешние 10k R29–R32/R19/R33–R36 уже стоят). **PCF8575** — другой
корпус (SSOP-24 5,3×8,2), не подходит.

**Раскладка бит U6** (адрес 0x20, VDD = +3V3, C29 100nF):

| Биты U6 | Пины | Цепь | Назначение |
|---|---|---|---|
| P00…P05 | 4…9 | `VLV_IN1…6` | управление клапанами через U5 74HCT541 → BTS724G |
| P06, P07 | 10, 11 | `ST_U3_12`, `ST_U3_34` | флаги неисправностей U3 (пары каналов) |
| P10, P11 | 13, 14 | `ST_U4_12`, `ST_U4_34` | флаги U4 |
| P12…P16 | 15…19 | `BUT1…BUT5` | кнопки (J3), подтяжки R29–R32 + R19 |
| P17 | 20 | — | no-connect (резерв) |
| INT | 1 | `INT_MCU` → U9.7 (IO33) | прерывание по кнопкам/ST, подтяжка R37 10k |
| SCL/SDA | 22, 23 | `I2C_SCL/SDA` | общая шина (подтяжки R20/R21 уже есть) |

**Перекоммутация:**
- `R11…R16` (10k) переехали с входа на **выход U5**: теперь `VLV_DRVn → GND` — держат вход
  BTS724G в 0, когда буфер в Hi-Z;
- `U5.OE1/OE2` (1,19) — не GND, а цепь **`VLV_EN`** = U9.6 (IO32), подтяжка **R38 10k к +3V3**:
  при reset/зависании GPIO в Hi-Z → OE=1 → U5 Hi-Z → клапаны закрыты (fail-safe);
- ST-выводы U3.4/U3.8/U4.4/U4.8 больше не NC: подтяжки **R33…R36** 10k к +3V3 и входы U6;
- кнопки: `BUT1…4` с ESP32 сняты, подтяжки **R29…R32** 10k к +3V3; `BUT5` — через R19;
- освободились 11 GPIO ESP32 (IO32/IO33 ушли на VLV_EN/INT, IO25/IO26/IO27/IO14/IO12/IO13/
  IO17/IO15/IO34 — no-connect).

**Проверено:** ERC `kicad-cli` = **0 ошибок / 0 предупреждений**; нетлист: `VLV_INn` = U5 + U6,
`VLV_DRVn` = U5 + R1x + BTS.IN, ST = BTS + R + U6, `BUTn` = J3 + C + R + U6,
`VLV_EN` = U9.6 + U5.1/19 + R38.2, `INT_MCU` = U9.7 + U6.1 + R37.2; BOM = 97 позиций.
Бэкап схемы: `kamaz_leveler_hw.kicad_sch.bak_before_pcal9555`.

**Прошивка (требования, отдельный репозиторий):** инициализация PCAL (config 0x06/0x07 —
P00…P05 выходы, остальные входы; выходные защёлки 0; сила выходов 2 мА), затем `VLV_EN`=0;
кнопки — 10k-подтяжки + дебаунс/INT; ST — опрос с расшифровкой «пара каналов → виновник».

### 9. Входы датчиков: скорость и давление (18.10.2026)

Использованы освободившиеся после PCAL9555APW пины ESP32: **IO35** (импульсы скорости),
**IO25** (аварийное давление), **IO34** (аналоговое давление). Добавлено **17 позиций**:
J7, J8, U11 (78L08), U12 (74LVC1G14), JP1, R39–R42, D17/D18/D20, C30–C33, C35.
Схема и формулы — `HARDWARE.md` §10. Итог: ERC 0/0, BOM 114 позиций.
Аналоговый вход давления (J9/IO34) исключён по решению заказчика 18.10.2026.

- **Скорость (J7, 4-pin)**: датчик КАМАЗ 4222.3843/ПД8089-х — 8 имп/об, DIN 72585,
  питание 8 В (встроенный 78L08 или от штатного спидометра через JP1); сигнал 8 В →
  делитель 10k/20k → Шмитт 74LVC1G14 → IO35 (PCNT); V = F·3600/K, K калибруется.
- **Аварийное давление (J8, 2-pin)**: переключатель 6032.3829 (5±0,5 кгс/см²) → RC/клэмп →
  IO25, полярность NO/NC в прошивке.
- Аналоговый вход давления (J9/IO34) **исключён** 18.10.2026; IO34 снова свободен (NC).
- В плату эти 17 футпринтов вносятся вместе с перекомпоновкой (итого 42 недостающих).

**ТЗ на прошивку (v11, плата v2):**

| Файл | Размер | Назначение |
|---|---|---|
| `TZ_v11_PCAL9555_SENSORS.md` | 30 КБ | **ТЗ на прошивку 11.0.0** (PCAL9555APW, ST, скорость, давление) — полное (путь: `C:\my\for cursor\kamaz_leveler\kamaz_10_15_6_fr_adafruiti_OTA_NM`) |
| `TZ_v11_E1_IMPLEMENTATION.md` | 23 КБ | **ТЗ этап E1**: клапаны/кнопки через PCAL, VLV_EN, точные замены и код (путь: `C:\my\for cursor\kamaz_leveler\kamaz_10_15_6_fr_adafruiti_OTA_NM`) |
| `TZ_v11_AGENT_PROMPT.md` | 5 КБ | промпт-стартер для агента-разработчика ПО (путь: `C:\my\for cursor\kamaz_leveler\kamaz_10_15_6_fr_adafruiti_OTA_NM`) |
| `hw_map.h` | 7 КБ | готовая карта пинов/битов платы v2 для прошивки (путь: `C:\my\for cursor\kamaz_leveler\kamaz_10_15_6_fr_adafruiti_OTA_NM`) |

- **Перекомпоновка (в работе):** в плату внесены все **118 футпринтов** (добавлены 42 новых: D11–D16, R23–R28, J6, U6, C29, R29–R38, J7/J8, U11, U12, JP1, R39–R42, D17–D20, C30–C33, C35), старые трассы сняты. Расстановка по зонам плана (power left, valve left-bottom, under-module, flyback right-bottom, LED у J2, разъёмы по граням).
  DRC-отчёт: **244 нарушения**, из них 139 — silk (косметика), реальные: shorting_items 11, clearance 11, courtyards_overlap 18, pth_inside_courtyard 25, solder_mask_bridge 18. Известные причины: плотная левая зона (L2/F1/J1), LED/R у J2 вплотную к падам J2, U9 socket courtyard накрывает детали под модулем (намеренно).
  Следующий шаг: итерации DRC (раздвинуть левую зону, сдвинуть LED/R от J2, поправить U1/U2 пады), затем трассировка FreeRouting.

- **Расстановка (прорыв):** 118 футпринтов размещены, DRC-электрика чистая (0 shorts/clearance). Достигнуто комбинацией: перебалансировка сторон (49 мелких SMD перевёрнуты на B), раскладка «большие детали по анкерам + мелкие растр/перестановки», точечная доводка (nudge) по DRC.
- **Трассировка:** 2 слоя, 83×58 — FreeRouting после 34 проходов держит **~90 unrouted** (из 284) и 5 violations; 2/3 цепей разводится, остальное не влезает. Нужно решение: 4 слоя (рекомендуется) или увеличение платы.

## Что НЕ работает (проверено)

- `freerouting-cli.exe` v2.5.0 падает (GraalVM). Рабочая замена — JAR + JRE 25:
  `C:\my\freerouting\jre25\jdk-25.0.4.1+1-jre\bin\java.exe -cp C:\my\freerouting\freerouting.jar app.freerouting.cli.FreeroutingCli -de x.dsn -do x.ses -mp 5`
- `kicad-cli` не умеет specctra, но `pcbnew` Python умеет `ExportSpecctraDSN` /
  `ImportSpecctraSES` (headless, проверено 10.0.7).
- konnect MCP: файловые инструменты работают headless, «живые» (open_project, save_project,
  update_pcb_from_schematic) требуют запущенного KiCad с IPC. konnect отказывается работать,
  если в папке проекта лежит второй `.kicad_pro` (удалять дубликаты).
- Ручная генерация блоков `.kicad_sch` требует проверки: `kicad-cli` не грузит файл при
  структурных ошибках (шаблон должен брать блок целиком, а не только `(lib_id ...)`).
- Протеус: Packaging Tool/Import DXF disabled, канва недоступна API.
- Proteus открытая схема БЛОКИРУЕТ запись `.kicad_sch`.

## Ключевые факты по схеме

- Каскад: `+24V_IN (J1.1) → F1 5A → VIN_FUSED → L4 10µH → VIN_FILT → Q1 IRF9540N (D→S) →
  +24V → D1 1.5KE36CA ‖ C28 330µF/35V ‖ C2 470µF + C1 100nF → U1 TPS54560B → +12V →
  U2 AP3211K → +5V → U10 AMS1117 → +3V3`.
- Q1: вывод 2 = сток (`VIN_FILT`), 3 = исток (`+24V`), затвор — 47к на +24V / 10к на GND.
- Клапаны: GPIO 32/33/25/26/27/14 → R11–R16 10k↓ → U5 74HCT541 → U3/U4 BTS724G → J2 + D5–D10.
- Индикаторы клапанов: `VALVE_x → D1x(A-K) → R2x 4.7k → GND` (D11–D16, R23–R28).
- Пины: BUT 13/12/15/17/34 (через J3); TFT 23/18/5/16/19/4; I²C 21/22; UART 1/3 (USB-UART
  DevKitC); NC: U9.1(EN), 2,3,5,18,19,27,30.
- J6 (UART/EN, 5-pin) удалён 18.10.2026 — в схеме, плате и BOM его нет.

## Журнал 18.10.2026

- Удалён J6 из схемы/платы/BOM (ERC 0/0). Плата перетрассирована: unconnected 60→48.
- Добавлены индикаторы клапанов в схему (6 LED + 6 R) и разъём гироскопа J6, ERC 0/0, BOM 85 позиций.
- Согласован план перекомпоновки (24 В левая грань, J2 низ, сигнальные верх, антенна
  правая грань с keep-out). Автоматическая раскладка не доведена — плата в рабочем
  разведённом состоянии; скрипты и план — в `C:\my\sch3\` и `LAYOUT_PLAN.png`.

## Журнал 18.10.2026 (PCAL9555APW)
- Чип расширителя подтверждён: **PCAL9555APW**; **TCA9535PWR** зафиксирован как
  pin-совместимый запасной вариант (Value-only замена, без Agile I/O и подтяжек);
  PCF8575 отклонён из-за другого корпуса.

- Добавлен **U6 PCAL9555APW** (TSSOP-24, 0x20, +3V3): управление 6 клапанами (через U5),
  чтение 4 ST-флагов BTS724G, опрос 5 кнопок; INT → IO33. Подтяжки R29–R38, C29 100nF.
- `R11…R16` перенесены на выход U5 (`VLV_DRVn`), `U5.OE` → `VLV_EN` (IO32 + 10k↑) — fail-safe
  «все клапаны закрыты» при reset/зависании. Освобождено 11 GPIO ESP32.
- ERC 0/0, BOM 97 позиций, PDF/нетлист пересобраны. В плату U6/C29/R29–R38 (как и D11–D16,
  R23–R28, J6) вносятся на шаге перекомпоновки.

## Журнал 18.10.2026 (датчики)

- **Исключена опция C** (аналоговый датчик давления J9, R43/R44, D19, C34, цепь `PRES_AN`):
  остаются только A (импульсный вход скорости) и B (аварийный датчик давления).
  IO34 снова свободен (no-connect), BOM 114 позиций.

- Добавлены входы датчиков: **J7** (импульсный датчик скорости КАМАЗ, 4-pin),
  **J8** (аварийно низкое давление в рессивере, 2-pin), **J9** (аналоговое давление
  0…10 бар, 3-pin, опция); формирователи U11 78L08, U12 74LVC1G14, JP1, R39–R44,
  D17–D20, C30–C35. Пины ESP32: IO35 (PCNT), IO25 (прерывание), IO34 (ADC1_CH6).
- Изучена документация: КАМАЗ 4222.3843/ПД8089 — 8 имп/об, DIN 72585 (1=+8 В, 2=GND,
  3=импульс, 4=инф.); 6032.3829 — срабатывание 5±0,5 кгс/см².
- ERC 0/0, BOM 119 позиций, PDF/нетлист обновлены. В плату 22 футпринта — при перекомпоновке.
- По решению заказчика **опция C (аналоговое давление, J9) удалена**: остались только
  A (импульсный вход скорости) и B (аварийный датчик давления). BOM = **114 позиций**,
  IO34 снова свободен (NC), недостающих футпринтов на плате — 42.

## 2026-11-01: перепроектирование под корпус 15-8
- Корпус: плита 58×88, 4×M2 по контуру 28×61.6, отверстия (10.7,15)/(72.3,15)/(10.7,43)/(72.3,43) Ø2.2 NPTH.
- Модуль ESP32-C3 сдвинут на -5 мм по X (центр 44.08,19.65), чтобы пады ушли от отверстия (72.3,15).
- Разъёмы: J1 (24В) и J2 (клапаны) — низ (окно 62×28); J3…J8 — верх в зоне 42×20 (сигналы).
- Расстановка пересобрана (SA по HPWL, 117 футпринтов, DRC-электрика 0), трассировка 2 слоя: 257/284 цепей, 27 не разведено, 1985 трасс/вий.
- Бэкапы: `.case_sa`, `.case_clean`, `.case_placement`, `.before_case` (старая механика, 253/284).
- 2026-11-01 (позже): размещение пересобрано с весами «трудных» цепей (SA+HPWL), трассировка 2 слоя: 275/284 цепей, 9 не разведено, 0 замыканий/зазоров. Осталось: 9 цепей + copper_edge 19, track_width 4, via_dangling 15, silk/courtyard. Бэкапы: .case_w, .best9, .best30.

## 2026-11-04 — перенос в репозиторий
- Проект перенесён: `C:\my\kamaz_leveler_hw` → `C:\my\for cursor\kamaz_leveler\hardware\`.
- Структура: `kicad/` (проект и библиотеки), `docs/`, `images/`, `production/`, `scripts/`, `3d/`, `backups/`.
- Производство перегенерировано из нового расположения (`scripts/export_prod.py`) — проект открывается и экспортируется без правок.
