timurufa86/kamaz_leveler/hardware/docs/CALCULATIONS.md

# Kamaz-Leveler — электрические расчёты (M2)

Дата: 15.10.2026. Черновик; уточняется по мере выбора финальных MPN.

## 1. Предохранитель F1 (вход 24 В)

Потребители и их мощность:

| Потребитель | Напряжение | Ток | Мощность |
|---|---|---|---|
| 6 катушек клапанов (до 3 одновременно) | 12 В | 3 А | 36 Вт |
| Логика (ESP32 + дисплей + датчики) | 5/3.3 В | ~1 А (5 В) | ~5 Вт |
| Потери buck (КПД ~90 %) | — | — | ~4.6 Вт |
| **Итого** | 24 В | **~1.9 А** | **~45 Вт** |

- Номинал: ~2 А → предохранитель **5 А** (мини-блэйд) = запас ×2.5.
- Проверка пускового тока: 3 катушки с броском ≤2 А каждая ≈ 6 А кратковременно (<100 мс) — плавкий предохранитель 5 А такую перегрузку выдерживает (I²t), при этом защищает от КЗ.
- Сечение / класс дорожки 24 В: **1.5–2.0 мм** (по 3 А с запасом).

## 2. TVS на load dump (ISO 7637-2 p5 / ISO 16750-2)

- Рабочее напряжение борта: 18…32 В → напряжение standoff TVS должно быть **> 32 В**.
- Выбран **1.5KE33CA** (bidirectional, 1500 Вт, standoff 33 В, clamp ≈ **53.3 В** при 28.1 А).
- **⚠️ Критично:** clamp 53.3 В должен быть ниже входного максимума buck.
  - `TPS54560B` — до **60 В** ✅
  - `TPS54340` — до **42 В** ❌ (clamp 53.3 В его убьёт)

**Решение:** оба buck делать на **TPS54560BDDA (60 В)**, либо ставить последовательный ограничитель перед 42-В buck. Рекомендую **U2 = TPS54560BDDA** (тот же корпус SO-8, тот же пинаут) — снимает риск.

## 3. Buck 24→12 В, 4 А (U1 = TPS54560B)

- Pout = 12 × 4 = 48 Вт; при КПД 88 % Pin ≈ 54.5 Вт → из 24 В ≈ **2.27 А**.
- Потери ключа: Rds(on) ≈ 90 мОм, D = 12/24 = 0.5 → P = I²·R·D = 16 × 0.09 × 0.5 = **0.72 Вт**; + переключение/затвор ≈ 0.5 Вт → **~1.2 Вт**.
- Тепло: θja ≈ 40 °C/Вт с PowerPAD на меди → ΔT ≈ 48 °C. При +85 °C среды Tj ≈ **133 °C** — на пределе (Tj max 150 °C).
  - **Требование к PCB:** PowerPAD → массив термовизов + медная зона ≥ 400 мм² под U1. Иначе снизить макс. температуру среды или ток.
- Индуктор: 33 мкГн / ≥5 А, низкий DCR.

## 4. Buck 24→5 В, 2 А (U2)

- Pout = 10 Вт; Pin ≈ 11.4 Вт → **0.47 А** из 24 В.
- Потери ключа: 4 × 0.09 × 0.21 ≈ 0.08 Вт — нагрев пренебрежим.
- Индуктор: 22 мкГн / ≥3 А.

## 5. High-side драйверы клапанов (U3…U8 = BTS50055-1TMA)

- Ток канала 1 А, до 3 одновременно.
- Rds(on) ≈ 40 мОм → P = 1² × 0.04 = **0.04 Вт** на канал; 3 канала = 0.12 Вт суммарно.
- Тепло: TO-252 на медной зоне — нагрев пренебрежим.
- Встроены: токоограничение, термозащита, активный кламп индуктивной нагрузки (freewheel не нужен внешний).
- **Pull-down 10 кОм на входе IN каждого ключа** (обязательно, §2.2): при reset/зависании/без 3.3 В клапаны закрыты. Рассеяние: 3.3²/10к = 1.1 мВт — пренебрежимо.

## 6. Вспомогательные номиналы

| Цепь | Номинал | Расчёт |
|---|---|---|
| Подтяжки I2C (к 3.3 В) | 4.7 кОм | стандарт для 100 кГц |
| Подтяжка GPIO5 (TFT CS, strap) | 10 кОм вверх | обязательна при старте |
| Подтяжка GPIO34 (КН5, input-only) | 10 кОм вверх | нет внутренней |
| Подтяжка GPIO12 (КН2, strap MTDI) | внутренняя INPUT_PULLUP | внешний HIGH-резистор не требуется (кнопка на GND) |
| RC-фильтр кнопок | 10 кОм + 100 нФ | τ = 1 мс (антидребезг) |
| Резистор power LED | 1 кОм (от 5 В) | (5−2.0)/1к ≈ 3 мА |
| Делитель FB buck 12 В | R5=10к / R6=91к | Vout = 0.8 × (1 + 91/10) ≈ 8.1 В — **пересчитать** до 12 В: R_fb_low=1.15к → 0.8×(1+91/10) — уточнить по даташиту |
| Делитель FB buck 5 В | R9=10к / R10=33к | Vout = 0.8 × (1 + 33/10) ≈ 3.4 В — **пересчитать** до 5 В |

## 7. Открытые вопросы расчёта (TBD)

- Точные номиналы делителей FB и компенсации — по даташитам TPS54560 (M2, финал).
- Тип и размер индукторов (ток насыщения ≥ 1.3 × Iout).
- Проверка load-dump по полной осциллограмме ISO 7637-2 p5a (нужен даташит-калькулятор).
