timurufa86/kamaz_leveler/hardware/docs/DESIGN_OPTIONS_pcf8575.md

# ОБНОВЛЕНИЕ 18.10.2026: выбран PCAL9555APW (реализован в схеме)

## Сравнение расширителей

| | PCF8575 | PCA9555PW | **PCAL9555APW** | TCA9535PWR |
|---|---|---|---|---|
| Выходы | квазидвунаправленные (~100 мкА «1») | push-pull ±10 мА | **push-pull, программируемая сила, 1,65…5,5 В** | push-pull ±10 мА |
| Прерывания | общий INT, без масок | INT (без маски/защёлки) | **Agile I/O: маска, защёлка входов, выбор фронта** | INT (без маски/защёлки) |
| Регистры | 2 байта I/O | 0x00–0x07 | 0x00–0x07 + Agile 0x40–0x4F (совместим с PCA9555) | 0x00–0x07 |
| Корпус / совместимость | SSOP-24 5,3×8,2 — **не pin-compatible** | TSSOP-24 4,4×7,8 — pin-to-pin | **TSSOP-24 4,4×7,8 (PW) — pin-to-pin** | TSSOP-24 4,4×7,8 — pin-to-pin |
| Внутренние подтяжки | есть (~100 мкА) | есть (слабые) | есть (слабые) | **нет** («w/o pull-ups») |
| Цена/доступность | самая низкая | низкая | средняя | низкая |
| Когда выбирать | кнопки/светодиоды без требований | нужен push-pull | **кнопки + ST-флаги с прерываниями** | push-pull без Agile |

## Решение

- **Выбран PCAL9555APW** (U6): 16 бит хватает на всё — 6 клапанов (P00–P05), 4 ST (P06–P11),
  5 кнопок (P12–P16), INT на GPIO33. Адрес 0x20, питание +3V3, C29 100nF.
- **Силовая часть оставлена high-side** (2 × BTS724G, общий `J2.1 = GND`). Вариант
  «общий +12 В, управление минусом» отклонён: теряются ST/защиты PROFET, КЗ выхода на GND
  даёт постоянно включённый клапан, нужны плавающие клапаны, а дефолт расширителя («все 1»)
  включал бы все клапаны при старте.
- Fail-safe: `R11…R16` перенесены на выход U5 (`VLV_DRVn → GND`), `U5.OE` → `VLV_EN`
  (IO32 + R38 10k↑) — при reset/зависании буфер в Hi-Z и все клапаны закрыты.
- **Чип подтверждён 18.10.2026: PCAL9555APW.** TCA9535PWR — pin-совместимый fallback:
  замена = только `Value` у U6 (тот же корпус TSSOP-24, цепи не меняются); минусы —
  нет Agile I/O (маски/защёлки прерываний, настройки силы выходов) и нет встроенных
  подтяжек (внешние 10k уже стоят: R29–R32, R19, R33–R36). PCF8575 — другой корпус
  (SSOP-24 5,3×8,2), не подходит.
  Реализовано в схеме: ERC 0/0, нетлист проверен, BOM 97 позиций. В плату U6/C29/R29–R38
  вносятся на шаге перекомпоновки.

# Варианты архитектуры выходов клапанов: PCF8575 и низкие ключи

Дата: 18.10.2026. Статус: **исторический разбор вариантов**; актуальное решение —
в начале файла и в `HANDOFF.md` §8 (принят PCAL9555APW).

## Коротко

| Вопрос | Ответ |
|---|---|
| Можно ли PCF8575? | Можно как расширитель ввода/вывода, но **напрямую затворы MOSFET им управлять нельзя**: выход «1» у PCF8575 — это внутренняя подтяжка ~100 мкА, а не нормальный драйвер. Нужен буфер (у нас уже есть U5 74HCT541) или другой расширитель с push-pull выходами — **TCA9535 / PCAL9535A** (16 бит, I²C, ±10 мА, INT). |
| Даёт ли низкий ключ выигрыш? | Да: 6 N-MOSFET SOT-23 вместо 2 × BTS724G SOIC-20W — минус ~500 мм² платы, дешевле, меньше тепла (Rds(on) 30 мОм → 70 мВт на канал при 1,5 А). Но теряется токовая защита/диагностика PROFET, меняется жгут J2 и fail-safe становится хуже. |
| Что рекомендую | Освободить GPIO: **PCAL9555APW + оставить BTS724G (high-side)** — принято и реализовано. Упрощать силовую часть (низкие ключи) — не рекомендую: теряются ST/защиты PROFET и ухудшается fail-safe. PCF8575 без буфера — не рекомендую. TCA9535PWR — только как pin-совместимый запасной вариант при дефиците/цене. |

## Что такое PCF8575 и где он «не тянет»

- 16-битный I²C-расширитель, 400 кГц, INT, питание 2,5…6 В.
- Выходы **квазидвунаправленные** (open-drain + слабая подтяжка ~100 мкА): «1» — это не 5 В/3,3 В с драйвером, а подтяжка.
- Следствия для затвора MOSFET:
  - зарядить затвор (Qg ≈ 3…10 нК) через 100 мкА — десятки–сотни микросекунд (для статического клапана приемлемо, для PWM — нет);
  - нельзя поставить жёсткую подтяжку затвора к GND (100 к и меньше): подтяжка расширителя её не «победит» — клапан не включится;
  - помехоустойчивость слабая: наводка на затвор легко меняет состояние.
- Вывод: **PCF8575 → обязательно буфер** (74HCT541 — уже стоит как U5, 8 каналов) или брать расширитель с push-pull выходами: **PCAL9555APW** (принят; Agile I/O) или **TCA9535PWR** (дешевле, pin-to-pin, но без Agile I/O и без встроенных подтяжек).
- Полезное свойство расширителя: на 16 бит можно повесить **6 клапанов + 5 кнопок + 5 резерв** → освобождаются 11 GPIO ESP32 (пригодятся под дисплей/датчики).
- Важно: у PCF8575 после включения все выходы = «1» (слабая подтяжка). Если управлять затворами напрямую — **все клапаны включатся при старте**. С буфером/подтяжками это лечится, но инициализация «все закрыты» обязательна.

## Низкий ключ: что меняется в схеме

```
+12 В (общий) ── клапан ──┬── D5…D10 (катод на +12 В) ── +12 В
                          │
                          └── сток N-MOS ── исток ── GND
                                │
                                затвор ── 100 Ом ── буфер/расширитель
                                затвор ── 100 к ── GND (fail-safe: закрыт)
```

- **Мосфеты**: 6 × логический N-channel, 30 В, ≥4 А, Rds(on) ≤ 40 мОм при 3,3…4,5 В
  (AO3400A, IRLML6344, Si2302 — SOT-23). Затвор: резистор 100 Ом + подтяжка 100 к на GND.
- **Flyback**: D5–D10 остаются, включение не меняется: анод — на коммутируемый узел (сток),
  катод — на +12 В.
- **J2**: пин 1 теперь **+12 В** (был GND), пины 2…7 — коммутируемые «минусы».
  Меняется жгут; если нужен отдельный провод GND до блока клапанов — сделать J2 1×8
  (+12 В, GND, 6 выходов).
- **Индикаторы D11–D16**: переподключить — анод LED на +12 В, катод → R 4,7k → сток
  (коммутируемый узел). Логика та же: клапан включён → узел ≈ 0 В → LED горит.
- **Убирается**: U3, U4 (BTS724G), при TCA9535 — и U5 (74HCT541). Освобождается ~500 мм².
- **Остаётся**: D1 1.5KE36CA (защита +12 В от выбросов), F1, входной каскад 24 В.

## Плюсы и минусы по пунктам

**Плюсы**
1. Силовая часть проще и дешевле: 6 × SOT-23 против 2 × BTS724G (SOIC-20W).
2. Меньше тепла: 70 мВт/канал против ~200 мВт у PROFET при 1,5 А.
3. Затвор управляется логикой 3,3/5 В — высоковольтный драйвер не нужен.
4. Минус ~500 мм² платы → проще перекомпоновка (как раз то, что сейчас делаем).
5. Расширитель освобождает GPIO ESP32 (6 клапанов + 5 кнопок на одном I²C-чипе).
6. Меньше проводов в жгуте: общий +12 В вместо двух силовых на каждый клапан.

**Минусы / что обязательно учесть**
1. **Нет диагностики**: PROFET давал токовую защиту, детект КЗ и обрыва. Низкий ключ —
   «слепой». Варианты: шунт 10…50 мОм + INA219/INA226/ADC, либо smart low-side
   (HITFET BTS3405G/BTS3800SL, TPS274C65 — с ограничением тока и диагностикой).
2. **Fail-safe хуже**: КЗ провода клапана на GND оставит клапан включённым навсегда
   (для подвески — «залипание» стойки). High-side в этом случае уходит в ограничение тока.
   Меры: предохранитель/PTC на общий +12 В, smart-ключи, контроль тока.
3. **Общий +12 В = общий шум**: коммутационные токи клапанов идут через GND-полигон →
   звон и наводки на I²C/датчики. Нужны: отдельная силовая земля, звезда у J1/C28,
   толстая медь, RC-снабберы/феррит на выходе, развязка по питанию.
4. **Бюджет +12 В**: U1 TPS54560B — 5 А. Шесть клапанов по 1,5 А = 9 А → либо
   программное ограничение «не более N одновременно», либо другой U1 (на 8…10 А),
   либо оставить высокую сторону, где ограничение уже встроено.
5. **J2 и жгут** меняются (пин 1 = +12 В), нужна новая маркировка и проверка монтажа.
6. **Индикаторы** D11–D16 переподключаются (анод на +12 В).
7. **PCF8575**: при прямом управлении затвором — не работает нормально (см. выше);
   нужен буфер или TCA9535.

## Варианты (сравнение)

| | Сейчас (high-side) | PCF8575 + BTS724G | PCF8575 + буфер U5 + низкие ключи | **TCA9535 + низкие ключи** |
|---|---|---|---|---|
| Расширитель | — | PCF8575 | PCF8575 | TCA9535/PCAL9535A |
| Силовые ключи | 2 × BTS724G | 2 × BTS724G (не тянет по логике 3,3 В напрямую — нужен сдвиг/буфер) | 6 × N-MOS | 6 × N-MOS |
| Занимаемая площадь | ~2 × (12 × 13,4) мм | без изменений | ~+250 мм² (MOS) − U3/U4 − U5 ≈ −380 мм² | ≈ −500 мм² |
| Диагностика | ток/КЗ PROFET | ток/КЗ PROFET | нет (если не smart-ключи) | нет (если не smart-ключи) |
| Fail-safe | лучше | лучше | хуже | хуже |
| Стоимость | высокая | высокая + расширитель | низкая | низкая |
| Риск внедрения | — | средний (логика) | средний | средний |

## Рекомендация

1. **Если цель — только PCF8575 ради GPIO**: брать не PCF8575, а **TCA9535** и **оставить
   BTS724G**. Это даёт те же 16 бит и освобождение GPIO без переделки силовой части и без
   изменения жгута. Изменения минимальны: I²C-расширитель + 4 линии управления BTS724G
   через его 3,3-В совместимые входы (проверить Vih BTS724G ≥ 2,0 В — проходит).
2. **Если цель — упростить/удешевить силовую часть**: делать **TCA9535 + 6 низких ключей**
   (логические MOSFET), D5–D10 оставить, J2 → +12 В/выходы, индикаторы переподключить,
   и предусмотреть хотя бы защиту от КЗ (PTC или smart HITFET). Обязательно — подтяжки
   затворов 100 к и инициализация «все закрыты» в прошивке.
3. **Индикаторы** в любом варианте остаются: у низкого ключа — анод на +12 В, катод через
   4,7 к на коммутируемый узел; визуально «горит под своим пином J2» сохраняется.

## Что нужно для внедрения (оценка)

- Схема: заменить U3/U4 (и U5 при TCA9535) на 6 MOSFET + 6×100 Ом + 6×100 к;
  переподключить LED-индикаторы; расширитель на I²C (+ подтяжки 4,7 к уже есть, R20/R21).
- Плата: перекомпоновка (уже запланирована) — освобождается место под дроссели/электролиты.
- Прошивка: драйвер TCA9535 (16 бит, shadow-регистр), инициализация «все закрыты»,
  контроль одновременности, опционально токовая диагностика.
- Проверки: DRC, тепловой расчёт ключей, проверка бюджета +12 В под 6 клапанов.
