timurufa86/kamaz_leveler/hardware/docs/HARDWARE.md

# Kamaz-Leveler — аппаратная часть (черновик M1→M2)

Дата: 15.10.2026. Плата 83×58 мм, 4×M3. MCU: ESP32-DevKitC (WROOM-32, 4 МБ, без PSRAM).

## 1. Карта пинов (GPIO ↔ цепь ↔ разъём) — сверка с app_pins.h 10.15.0

| GPIO | Функция | Направление | Цепь / разъём | Примечание |
|---|---|---|---|---|
| 21 | I2C SDA | bidir OD | J-I2C.2 | подтяжка 4.7 кОм → 3.3 В |
| 22 | I2C SCL | out OD | J-I2C.3 | подтяжка 4.7 кОм → 3.3 В |
| 23 | TFT MOSI | out | J-DISP MOSI | VSPI, короткие дорожки |
| 18 | TFT SCLK | out | J-DISP SCK | до 40 МГц |
| 5 | TFT CS | out | J-DISP CS | **strap: внешняя подтяжка 10 кОм → 3.3 В** |
| 16 | TFT DC | out | J-DISP DC | на WROVER занят PSRAM → только WROOM |
| 19 | TFT RST | out | J-DISP RST | в VSPI это MISO (не используется) |
| 4 | TFT BL | ШИМ (LEDC) | J-DISP BL | ≥1 кГц, ключ уже на плате дисплея |
| 32 | клапан BUB1 (ПЛ) | out | драйвер 1 → J-VALVE BUB1+ | HIGH = открыт |
| 33 | клапан BUB2 (ПП) | out | драйвер 2 → J-VALVE BUB2+ | HIGH = открыт |
| 25 | клапан BUB3 (ЗЛ) | out | драйвер 3 → J-VALVE BUB3+ | HIGH = открыт |
| 26 | клапан BUB4 (ЗП) | out | драйвер 4 → J-VALVE BUB4+ | HIGH = открыт |
| 27 | клапан INFL | out | драйвер 5 → J-VALVE INFL+ | HIGH = открыт |
| 14 | клапан DEFL | out | драйвер 6 → J-VALVE DEFL+ | HIGH = открыт |
| 13 | КН1 | in (INPUT_PULLUP) | J-BUT.2 | RC-фильтр + ESD |
| 12 | КН2 | in (INPUT_PULLUP) | J-BUT.3 | **strap MTDI: запрещён LOW при старте** |
| 15 | КН3 | in (INPUT_PULLUP) | J-BUT.4 | strap: HIGH совместим |
| 17 | КН4 | in (INPUT_PULLUP) | J-BUT.5 | |
| 34 | КН5 | in (input-only) | J-BUT.6 | **обязателен внешний 10 кОм → 3.3 В** |
| 1 | UART0 TX | out | USB-UART DevKitC (встроен) | лог 115200 |
| 3 | UART0 RX | in | USB-UART DevKitC (встроен) | прошивка |
| 5V | питание | — | buck 24→5 В → DevKitC «VIN/5V» | |
| 3V3 | питание | — | выход AM1117 DevKitC | для логики/датчиков |

Запрещено занимать: GPIO 6…11 (флешь), GPIO 0/2 (strap boot) без нужды.

## 2. Дерево питания и бюджет

```
24 В (18…32 В) → J1 → F1 (5 А) → L4 (10 мкГн) → Q1 (обратная полярность) → +24V: D1 TVS + C28 (330 мкФ)
   ├─► U1 TPS54560B (60 В, 5 А, 24→12 В) ──► +12 В ──► U3/U4 BTS724G ──► катушки 12 В (1 А × до 3)
   └─► U2 AP3211K (12→5 В, 1.5 А) ──► +5 В ──► U9 VIN + U5 74HCT541 ──► U10 AMS1117 ──► 3.3 В
```

| Шина | Потребители | Ток (пик) | Источник |
|---|---|---|---|
| 12 В | 6 катушек (1 А, до 3 одновременно) | 3 А | U1 TPS54560B, 5 А |
| 5 В | U9 DevKitC VIN, U5 74HCT541, LED | ~1 А | U2 AP3211K (12→5, 1.5 А) |
| 3.3 В | ESP32 (пик ~0.5 А Wi-Fi) + дисплей (~65 мА) + датчики (~10 мА) | ~0.6 А | U10 AMS1117 |

## 3. Скелет BOM (активные компоненты, MPN — первая редакция)

| Позиция | Функция | MPN (предварительно) | Корпус | В Proteus? |
|---|---|---|---|---|
| F1 | предохранитель 5 А | мини-блэйд 5 А (Littlefuse) | держатель | импорт |
| Q1 | защита от переполюсовки | P-MOS **IRF9540N** / SMD: DMP4015SSSQ | TO-220/SO-8 | создать |
| D1 | TVS load dump | **1.5KE36CA** (36 В, 1500 Вт) | DO-201 | ✅ (SMBJ есть) |
| L4 | входной дроссель LC-фильтра | **10 мкГн / 5 А** | SMD (Bourns SRP1245A) | — |
| C28 | входной электролит | **330 мкФ / 35 В** | CP_Elec_8x10 | — |
| L1 | синфазный дроссель | Würth 744273-xxx | SMD | ✅ EPCOS/FBEADS |
| U1 | buck 24→12 В (≥4 А) | **TPS54560B** (60 В, 5 А) | SO-8 | создать |
| U2 | buck 12→5 В (1.5 А) | **AP3211K** (1.4 МГц) | SOT-23-6 | создать |
| U3, U4 | 2× high-side ключ 12 В, 4 канала | **BTS724G** (4×90 мОм, smart) | SOIC-20W | создать |
| U5 | согласователь 3.3→5 В, 6 каналов | **74HCT541** (буфер, 3-state) | SOIC-20W | создать |
| D5…D10 | обратные диоды катушек | **SS34** (40 В, 3 А) | SMA | создать |
| U9 | MCU | **ESP32-DevKitC** (WROOM-32, 30-pin) | модуль 2×15 | создать |
| — | USB-UART | встроен в DevKitC (CP2102) | — | — |
| J1 | питание 24 В | 2-pin авто | — | ✅/импорт |
| J2 | клапанный блок | 7-pin (GND + 6) | JST-XH | ✅/импорт |
| J3 | кнопки | 6-pin (GND + 5) | JST-XH | ✅ |
| J4 | I2C датчики | 4-pin (3V3/SDA/SCL/GND) | JST-XH | ✅ |
| J5 | дисплей | 8-pin FPC (0.5/1.0 мм) | FPC | импорт |
| D2 | power LED | + R 1 кОм | 0805 | ✅ |

Альтернатива драйвера клапанов (не используется, оставлено для истории): дискрет **P-MOS (IRF9540N) + N-MOS (BSS138) + freewheel (SS34)** на канал. Реализовано: 2× BTS724G + 74HCT541 + 6× SS34 (см. §7).

> **J6 (UART/EN, 5-pin) удалён** 18.10.2026 по решению заказчика — его нет в схеме, плате и BOM.
> UART0 по-прежнему доступен через встроенный USB-UART DevKitC (лог 115200, прошивка);
> на выводах ESP32 IO1/IO3 в схеме стоят флаги no-connect.

## 4. Защиты (требования §3)

- [x] Обратная полярность: Q1 IRF9540N (P-MOS, сток к потребителю, исток к нагрузке, делитель 47к/10к по затвору) — см. §8
- [x] TVS на load dump: D1 1.5KE36CA (клип ≈52 В, ниже 60 В TPS54560B) — см. §8
- [ ] EMI: CM-choke + X/Y-конденсаторы (частично — L4 10 мкГн + C28 330 мкФ, см. §8)
- [ ] ESD на всех внешних линиях (кнопки, I2C, дисплей)
- [x] pull-down 10 кОм на входе каждого high-side ключа (R11…R16, цепи `VLV_INn`) → клапаны закрыты при reset/зависании/без 3.3 В
- [x] freewheel/активный кламп на катушках: внешние **SS34 (D5…D10) на плате** + встроенный кламп BTS724G
- [ ] strap-требования: GPIO5 pull-up 10 кОм, GPIO12 не LOW при старте, GPIO15 совместим

## 5. Допущения [ASSUMPTION] и открытые TBD

| Пункт | Статус |
|---|---|
| MCU = классический ESP32-DevKitC (не S3) | [ASSUMPTION] |
| Ток катушки 1 А, ≤3 одновременно | [ASSUMPTION] (подтверждено «хватит») |
| Точный порядок пинов FPC дисплея (GMT024-08-SPI8P) | TBD — уточнить по даташиту/шелкографии |
| Тип разъёмов J-VALVE/J-BUT/J-I2C = JST-XH 2.54 мм | [ASSUMPTION] |
| IGN-управление отсутствует | [ASSUMPTION] |
| Стандарты: ISO 7637-2, ISO 16750-2 | [ASSUMPTION] |
| Точный MPN buck/драйвера/TVS | финализировать в M2 по даташитам + расчёты |

## 6. Правки по итогам M2 (схема собрана, ERC 0 ошибок)

| Что | Было | Стало | Причина |
|---|---|---|---|
| Делитель FB U1 (12 В) | R5 = 10k | **R5 = 6.49k** | Vout = 0.8·(1+91/6.49) ≈ 12.0 В (с 10k было 8.1 В) |
| Делитель FB U2 (5 В) | R10 = 33k | **R10 = 52.3k** | Vout = 0.8·(1+52.3/10) ≈ 5.0 В (с 33k было 3.4 В) |
| Buck 24→5 (U2) | TPS54340DDA (42 В) | **TPS54560BDDA (60 В)** | clamp TVS 53.3 В > 42 В — TPS54340 вышел бы из строя при load dump |
| Деление схемы | одна простыня | лист **A2** | 159 символов |

**Итог ERC (kicad-cli 10.0.7): 0 ошибок, 0 предупреждений** (на момент M2 было 2 предупреждения `unconnected_wire_endpoint`; устранены в M5 вместе с переработкой блока клапанов, см. §7).

**Ещё не сделано (TBD):** ESD-защита внешних линий, EMI-фильтр (L1 в схеме-скелете), подтверждение MPN/токов L2/L3/F1 по даташитам.

## 7. Блок клапанов: BTS724G + 74HCT541 + диоды (M5, 16.10.2026)

### 7.1 Что заменено

6× одиночных `Power_Management:BTS50055-1TMA` (U3…U8) заменены на:

| Позиция | Компонент | Роль |
|---|---|---|
| U3 | `Power_Management:BTS724G` | 4-канальный high-side ключ: BUB1…BUB4 |
| U4 | `Power_Management:BTS724G` | 4-канальный high-side ключ: INFL, DEFL (каналы 3,4 не используются) |
| U5 | `74xx:74HCT541` | согласователь уровней 3.3 В (ESP32) → 5 В (входы BTS724G), 6 из 8 каналов |
| D5…D10 | `Diode:SS34` | обратные (freewheel) диоды катушек, **на плате** |

Причина: 6× BTS50055-1TMA (TO-263-7, 6 мОм, 70 А) сильно избыточны для катушек 12 В / 1 А;
BTS724G даёт 4 канала в одном SOIC-20 при 90 мОм, что дешевле по BOM и по площади.
74HCT541 включён как формирователь/буфер: входы TTL-порогов (V_IH = 2.0 В) надёжно
принимают 3.3 В логику при питании 5 В, выходы дают 5 В CMOS-размах на входы PROFET.

**Обозначения:** позиции `D4…D9` из ТЗ заняты — `D4` уже используется светодиодом
индикации (`Device:LED`), `D1…D3` — входным TVS и диодами buck-преобразователей.
Поэтому обратные диоды пронумерованы **D5…D10** (сквозная нумерация проекта).

### 7.2 Таблица соответствия: клапан → GPIO → U5 → BTS724G → J2

Сверка с `app_pins.h` (kamaz_10_15_0_fr_adafruiti_OTA_NM), GPIO 32/33/25/26/27/14:

| Клапан | GPIO (app_pins.h) | Пин ESP32 (U9) | Цепь MCU | Подтяжка | U5 (74HCT541) | Цепь драйвера | BTS724G | Пин J2 |
|---|---|---|---|---|---|---|---|---|
| BUB1 (ПЛ) | `PIN_BUB1` = 32 | U9.6 (IO32) | `VLV_IN1` | R11 10k↓ | A0 (pin 2) → Y0 (pin 18) | `VLV_DRV1` | U3.IN1 (3) → U3.OUT1 (18) | J2.2 |
| BUB2 (ПП) | `PIN_BUB2` = 33 | U9.7 (IO33) | `VLV_IN2` | R12 10k↓ | A1 (pin 3) → Y1 (pin 17) | `VLV_DRV2` | U3.IN2 (5) → U3.OUT2 (17) | J2.3 |
| BUB3 (ЗЛ) | `PIN_BUB3` = 25 | U9.8 (IO25) | `VLV_IN3` | R13 10k↓ | A2 (pin 4) → Y2 (pin 16) | `VLV_DRV3` | U3.IN3 (7) → U3.OUT3 (14) | J2.4 |
| BUB4 (ЗП) | `PIN_BUB4` = 26 | U9.9 (IO26) | `VLV_IN4` | R14 10k↓ | A3 (pin 5) → Y3 (pin 15) | `VLV_DRV4` | U3.IN4 (9) → U3.OUT4 (13) | J2.5 |
| INFL | `PIN_INFL` = 27 | U9.10 (IO27) | `VLV_IN5` | R15 10k↓ | A4 (pin 6) → Y4 (pin 14) | `VLV_DRV5` | U4.IN1 (3) → U4.OUT1 (18) | J2.6 |
| DEFL | `PIN_DEFL` = 14 | U9.11 (IO14) | `VLV_IN6` | R16 10k↓ | A5 (pin 7) → Y5 (pin 13) | `VLV_DRV6` | U4.IN2 (5) → U4.OUT2 (17) | J2.7 |

Имена цепей `VLV_IN1…VLV_IN6` (со стороны MCU) сохранены без изменений —
прошивка и разводка со стороны ESP32 не затронуты. Общий провод клапанов — J2.1 (GND).

Цепь каждого клапана целиком: `GPIO → VLV_INn → U5.An → U5.Yn → VLV_DRVn → U3/U4.INn → U3/U4.OUTn → VALVE_xxx → J2.pin → катушка → GND`.
Диод `D5…D10`: анод на `VALVE_xxx`, катод на `+12V`.

### 7.3 Питание и служебные выводы

| Вывод | Цепь | Примечание |
|---|---|---|
| U3.VBB (1, 10, 11, 12, 15, 16, 19, 20) | **+12V** | все 8 выводов VBB запараллелены (символ ставит их в одну точку) |
| U4.VBB (1, 10, 11, 12, 15, 16, 19, 20) | **+12V** | |
| U3.GND1/2 (2), U3.GND3/4 (6) | GND | |
| U4.GND1/2 (2), U4.GND3/4 (6) | GND | |
| U3/U4.ST1/2 (4), ST3/4 (8) | **no-connect** | open-collector статус; прошивка их не читает |
| U4.IN3 (7), IN4 (9) | GND | неиспользуемые каналы принудительно выключены |
| U4.OUT3 (14), OUT4 (13) | no-connect | каналы не используются |
| U5.VCC (20) | **+5V** | питание буфера; входы 3.3 В совместимы (HCT, TTL-пороги) |
| U5.GND (10) | GND | |
| U5.OE1/G1 (1), OE2/G2 (19) | GND | активный низкий → выходы всегда включены |
| U5.A6 (8), A7 (9) | GND | неиспользуемые входы |
| U5.Y6 (12), Y7 (11) | no-connect | неиспользуемые выходы |
| D5…D10.K (1) | **+12V** | катоды всех шести диодов |
| D5…D10.A (2) | `VALVE_BUB1…BUB4`, `VALVE_INFL`, `VALVE_DEFL` | аноды на выходах ключей |
| R11…R16 | 10 кОм вниз, `VLV_INn` → GND | **сохранены**: удерживают клапаны закрытыми при reset/зависании/без 3.3 В |

Проверено по нетлисту: **GPIO-цепи клапанов с BTS724G напрямую не соединены** —
`VLV_INn` содержит только `R1x.1`, `U5.A`, `U9.IOxx`; `VLV_DRVn` — только `U5.Y` и `U3/U4.IN`.
`+12V` после правки питает только VBB обоих BTS724G и катоды D5…D10 (остальные
потребители +12V — без изменений). `+5V` получил единственного нового потребителя — U5.VCC.

### 7.4 Расположение на листе

Новые компоненты размещены в освободившейся зоне бывшего блока клапанов
(U3, U4 — x≈254 мм, U5 — x≈197 мм, D5…D10 — колонка x=317.5 мм); существующие
компоненты (R11…R16, J2, ESP32 U9 и др.) **не перемещались**. Два прежних символа
`power:+12V` (#PWR041, #PWR042), стоявшие на выводах Vbb удалённых BTS50055,
переиспользованы под VBB новых U3/U4; четыре осиротевших (#PWR043…#PWR046) удалены.

### 7.5 ERC и нетлист

- ERC `kicad-cli 10.0.7`: **0 ошибок, 0 предупреждений** (`C:\my\e2.json`).
- Нетлист `C:\my\n2.net`: 65 цепей; все 6 каналов прослежены от GPIO до J2 (см. §7.2).
- Бэкап схемы до правки: `C:\my\_sch_backups\before_bts724g.kicad_sch`.

**TBD:** обновление печатной платы (`kamaz_leveler_hw.kicad_pcb`) под новый блок
клапанов не выполнялось — требуется заново разместить U3/U4/U5/D5…D10 и развести
силовые цепи; корпус D5…D10 выбран по библиотеке KiCad (`Diode_SMD:D_SMA`, DO-214AC) —
при желании заменить на SMC (`D_SMC`) для лучшего теплового запаса.

## 8. Защита от бортсети КАМАЗа (+24 В) — M6

### 8.1 Реальность бортсети грузовика

| Явление | Значение | Комментарий |
|---|---|---|
| Номинал | 24 В (2 × 12 В АКБ) | — |
| Рабочее (генератор) | **28,8 В** | напряжение подзаряда |
| Пуск двигателя | **просадка до 12–16 В** | стартер; контроллер должен переживать |
| Выбросы генератора | 40–60 В | коммутация нагрузки |
| **Load dump** | **60–120 В**, 0,5–5 Дж | отключение АКБ на ходу — самый опасный случай |
| Импульсы ISO 7637-2 | ±100…300 В, 2 мс | быстрые помехи |
| Реверс полярности | −24 В | ошибка подключения |

### 8.2 Что было и чего не хватало

Было: `+24V → F1 5A → Q1 IRF9540N (100 В, реверс) → D1 1.5KE33CA → C11/C12 → U1 TPS54560B (60 В)`.

| Элемент | Оценка |
|---|---|
| F1 5 А | ✅ |
| Q1 IRF9540N (100 В) | ✅ реверс и до 100 В |
| D1 1.5KE33CA | ⚠️ клип ~45 В — запас до 60 В всего 15 В; при load dump 1–5 Дж может деградировать |
| TPS54560B (60 В) | ✅ но без второго барьера |

### 8.3 Доработка (3 элемента)

1. **D1: 1.5KE33CA → `1.5KE36CA`** — standoff 36 В, клип ≈ 52 В. Остаётся ниже 60 В (предел TPS54560B), но энергии рассеивает больше, чем 33CA при том же импульсе.
2. **L4: дроссель 10 µГн / 5 А** последовательно после F1 (или феррит-бусина) — задерживает фронт, даёт TVS время сработать; совместно с C2 470 µФ и C4/C5 10 µФ на входе U1 образует LC-фильтр.
3. **C28: электролит 330 µФ / 35 В** на `+24V` после TVS — поглощает остаточные выбросы, снижает пульсации на входе U1.

### 8.4 Итоговая цепь питания

```
J1 (+24V_IN) → F1 5A → (VIN_FUSED) → L4 10µH → (VIN_FILT) → Q1 IRF9540N (D→S)
            → (+24V) → D1 1.5KE36CA ‖ C28 330µF/35V ‖ C2 470µF + C1 100nF → U1 TPS54560B → +12V
```

Итого 4 детали (~150 ₽). Ожидаемая стойкость: load dump до 120 В / 2 Дж без повреждения.

### 8.5 Статус и реализация в схеме (17.10.2026)

Реализовано в `kamaz_leveler_hw.kicad_sch`:

- [x] **L4** — `Device:L` = 10 µH, корпус `Inductor_SMD:L_Bourns_SRP1245A`, позиция (25.4, 50.8), вывод 1 подключён проводом к F1.2 (цепь `VIN_FUSED`), вывод 2 — метка `VIN_FILT` к стоку Q1.2 (вывод 2 IRF9540N). Дроссель стоит **после F1 и до стока Q1** (в разрыв входной цепи), а не между истоком и шиной +24V.
- [x] **C28** — `Device:C_Polarized` = 330 µF/35 V, корпус `Capacitor_SMD:CP_Elec_8x10`, позиция (63.5, 57.15) под D1: «+» на `+24V` (#PWR085), минус на `GND` (#PWR086).
- [x] **D1** — значение заменено на `1.5KE36CA` (корпус `Diode_THT:D_DO-201AD_P15.24mm_Horizontal`).
- [x] **BOM.csv** пересобран из схемы (`kicad-cli sch export bom`): 73 позиции, добавлены L4/C28, убраны несуществующие C15/C16/R7/R8/R17, синхронизированы D1/D3/L3/U2.
- [x] **ERC** (`kicad-cli sch erc`): **0 ошибок**, 1 предупреждение (`isolated_pin_label` метки `EN` в блоке U9 — было и до правки).
- [x] **Нетлист** (`kicad-cli sch export netlist`): `+24V` = C1.1 C2.1 **C28.1** C4.1 C5.1 D1.1 Q1.3 R2.1 U1.2 U1.3; `VIN_FUSED` = F1.2 **L4.1**; `VIN_FILT` = **L4.2** Q1.2; `GND` включает **C28.2**.
- [ ] Внести L4/C28/D1 в печатную плату (см. `HANDOFF.md`, шаг 4).

Бэкап схемы до правки: `kamaz_leveler_hw.kicad_sch.bak_before_L4C28`.

## 9. Расширитель I/O PCAL9555APW (18.10.2026)

Схема переведена на NXP **PCAL9555APW** (TSSOP-24, I²C 16 бит, 0x20, питание +3V3).
Один чип закрывает: 6 клапанов (через существующий буфер U5 74HCT541 на BTS724G),
4 статус-флага BTS724G (`ST1/2`, `ST3/4`) и 5 кнопок; INT выведен на IO33.

### 9.0 Выбор микросхемы

- **PCAL9555APW** — принят: 16 бит, push-pull выходы, Agile I/O (маска/защёлка прерываний, настройка силы выходов), встроенные слабые подтяжки; корпус TSSOP-24 4,4×7,8.
- **TCA9535PWR** — pin-совместимый fallback (тот же TSSOP-24): замена = только `Value` у U6. Минусы: нет Agile I/O и **нет встроенных подтяжек**; у нас на всех входах уже стоят внешние 10k (R29–R32, R19, R33–R36), поэтому схемотехнически совместим.
- **PCF8575** — не подходит: другой корпус (SSOP-24 5,3×8,2), квазидвунаправленные выходы.

### 9.1 Цепи и биты

| Биты | Пины U6 | Цепь | Куда |
|---|---|---|---|
| P00–P05 | 4–9 | `VLV_IN1…VLV_IN6` | U5.A0…A5 (далее BTS724G.IN) |
| P06, P07 | 10, 11 | `ST_U3_12`, `ST_U3_34` | U3.4, U3.8 (+ R33, R34 10k к +3V3) |
| P10, P11 | 13, 14 | `ST_U4_12`, `ST_U4_34` | U4.4, U4.8 (+ R35, R36 10k) |
| P12–P16 | 15–19 | `BUT1…BUT5` | J3.2…J3.6 (+ R29–R32 10k, R19 для BUT5) |
| P17 | 20 | — | no-connect |
| INT | 1 | `INT_MCU` | U9.7 (IO33) + R37 10k |
| SCL/SDA | 22, 23 | `I2C_SCL/SDA` | общая шина, R20/R21 4.7k |
| VDD/VSS | 24 / 12 | +3V3 / GND | C29 100nF у вывода VDD |

Адрес: A0…A2 = GND → 0x20 (не конфликтует с MPU6050/JHM1200 0x68).

### 9.2 Fail-safe

`R11…R16` (10k) перенесены на **выход** буфера `VLV_DRVn → GND`. `U5.OE1/OE2` (1,19)
подключены к `VLV_EN` (U9.6/IO32) с подтяжкой **R38 10k к +3V3**. При включении/сбросе/
зависании MCU линия `VLV_EN` в Hi-Z → OE=1 → U5 в Hi-Z → входы BTS724G удерживаются в 0 →
**все клапаны закрыты**. PCAL после сброса — все пины входы; прошивка обязана записать
«0» в выходные защёлки и только потом опустить `VLV_EN`.

### 9.3 GPIO ESP32 после правки

Освободились IO25, IO26, IO27, IO14, IO12, IO13, IO17, IO15, IO34 (на них no-connect);
IO32 → `VLV_EN`, IO33 → `INT_MCU`. Остальные функции (дисплей, I²C, UART, клапаны через
расширитель) не менялись.

### 9.4 Проверки

- ERC `kicad-cli sch erc`: **0 ошибок / 0 предупреждений**.
- Нетлист: `VLV_INn` = {U5.An, U6.P0x}; `VLV_DRVn` = {U5.Yn, R1x.1, U3/U4.INn};
  ST = {U3/U4.ST, R3x.2, U6}; `BUTn` = {J3, C2x.1, R2x.2, U6}; `VLV_EN` = {U9.6, U5.1, U5.19, R38.2};
  `INT_MCU` = {U9.7, U6.1, R37.2}.
- BOM: 97 позиций; PDF схемы обновлён.
- Плата: U6, C29, R29–R38 ещё не внесены — на шаге перекомпоновки (см. HANDOFF §5).

## 10. Внешние датчики: скорость автомобиля и давление (18.10.2026)

Добавлены два входных узла на свободные пины ESP32 (были NC): IO35 и IO25.
Аналоговый вход давления (J9/IO34) из плана исключён по решению заказчика — только
дискретный аварийный датчик давления.
Питание узлов — от существующих +12 В / +5 В / +3V3. Разъёмы — на свободных местах граней.

### 10.1 Датчик скорости КАМАЗ (импульсный вход) — J7

| Что | Данные |
|---|---|
| Датчики | 4222.3843 / ПД8089-х (и аналоги), 8 импульсов на оборот |
| Разъём | DIN 72585 (4 контакта); на плате — J7 (1×4, 2.54 мм) |
| Жгут | 1 = +8 В питание датчика, 2 = «−», 3 = сигнальный импульс, 4 = информационный (не используется) |
| Питание | 8 В от штатного спидометра (81.3802/87.3802) либо от бортового U11 (78L08) |
| Альтернатива | снять готовую линию «импульсы скорости» (8 В) с выхода спидометра — J7.3, питание не нужно |

Схема: `J7.1 → +8V_SENS` (U11 78L08 от +12 В, C30 10 µF, C31 100 нФ; `JP1` выбирает
встроенные 8 В или внешние с J7.4); `J7.2 → GND`; `J7.3 → SPEED_SIG → R39 10k → SP_DIV →
R40 20k на GND (8 В → 2,67 В) → D17 BZX84C3V3 (клэмп) + C32 100 нФ → U12 74LVC1G14
(Шмитт, 3,3 В) → SPEED_PULSE → **ESP32 IO35** (PCNT). TVS D20 SMAJ12A на `SPEED_SIG`.

Прошивка: счёт импульсов PCNT за окно 1 с → `F` [Гц]; **V[км/ч] = F·3600 / K**, где
`K` — программируемый коэффициент (имп/км, у штатных спидометров 1001…25000).
Одометр — интеграл импульсов. Если датчик индуктивный 2-проводный (старые исполнения) —
нужен отдельный фронт-энд (LM1815/MAX9924), схема рассчитана на активный импульсный выход.

### 10.2 Датчик аварийно низкого давления в рессивере — J8

| Что | Данные |
|---|---|
| Датчик | 6032.3829 (аналоги ММ124Д, 2702.3829), КАМАЗ/УРАЛ/МАЗ/ЗИЛ |
| Срабатывание | 5 ± 0,5 кгс/см² (≈ 4,9 бар) |
| Разъём | J8 (1×2): 1 = сигнал, 2 = GND |

Схема: `J8.1 → PRES_IN → R42 10k → PRES_SW`; `R41 100k↑ к +3V3`, `D18 BZX84C3V3` +
`C33 100 нФ` на GND; `PRES_SW → ESP32 IO25` (прерывание, антидребезг 50 мс).
Полярность NO/NC — параметр прошивки; в диагностике — контроль «залипания» (нет изменения
при наборе давления).

### 10.3 Свободные ресурсы после добавления

- ESP32: IO34, IO36, IO39, IO25/26/27, IO14/12/13/17/15, IO2 — свободны.
- Аналоговые входы ADC1 свободны: IO34, IO36, IO39 (IO35 занят импульсным входом) —
  до 3 аналоговых каналов без внешнего АЦП.
- PCAL9555APW: 1 свободный бит (P17) — например, второй дискретный вход.
- Кандидаты на следующую итерацию: выход управления компрессором (P17 → MOSFET + реле),
  4 датчика положения подвески через ADS1115 (I²C), CAN (SN65HVD230) при наличии J1939,
  температура компрессора (DS18B20), зуммер аварийного давления, сервисный UART.

### 10.4 Проверки

- ERC `kicad-cli`: **0 ошибок / 0 предупреждений**.
- Нетлист: `SPEED_PULSE` = {U12.4, U9.5}; `PRES_SW` = {J8, R41/R42, D18, C33, U9.8};
  `+8V_SENS` = {U11.1, J7.1, JP1.1, C31.1}; U9.4 (IO34) — no-connect.
- BOM: **114 позиций**; PDF/нетлист обновлены. Плата: +17 футпринтов вносятся при перекомпоновке.
