timurufa86/kamaz_leveler/hardware/docs/PLACEMENT_TABLE.md

# План размещения компонентов — Kamaz Leveler HW

Плата **83 × 58 мм**, 2 слоя, детали с двух сторон. В схеме 114 компонентов; на плате
дополнительно 4 монтажных отверстия → **118 футпринтов**. Координаты — в мм от левого
верхнего угла платы (как в `.kicad_pcb`, начало координат в углу Edge.Cuts).

## 1. Фиксированные позиции (якоря)

| Поз. | Что | X | Y | Поворот | Слой |
|---|---|---|---|---|---|
| J1 | разъём 24 В (1×2) — левая грань | 3,5 | 20,0 | 0° | F |
| J2 | клапаны (1×7) — нижняя грань | 30,0 | 52,6 | 90° | F |
| J6 | гироскоп (1×4, I²C) — нижняя грань | 56,0 | 52,6 | 90° | F |
| J5 | дисплей (1×8) — верхняя грань | 32,2 | 5,0 | 90° | F |
| J3 | кнопки (1×6) — верхняя грань | 46,9 | 5,0 | 90° | F |
| J4 | I²C (1×4) — верхняя грань | 64,3 | 5,0 | 90° | F |
| H1–H4 | монтажные отверстия | 3,5/79,5 | 3,5/54,5 | — | — |
| J7 | датчик скорости (1×4), нижняя грань справа | 68,0 | 52,6 | 90° | F |
| J8 | аварийное давление (1×2), нижняя грань слева | 10,0 | 52,6 | 90° | F |
| U9 | ESP32 DevKitC: pad1 (41,0; 15,0), антенна → правая грань | 41,0 | 15,0 | 0° | F |

**Keep-out антенны:** x 74…83, y 8…47 — без меди, дорожек, полигонов и деталей.

## 2. Зоны размещения

### 2.1 СИЛОВАЯ ЗОНА — левая полоса x 0…32, y 0…32 (F и B)

| Поз. | Компонент | Примечание |
|---|---|---|
| F1 | держатель предохранителя 5×20 (THT) | вход 24 В |
| D1 | 1.5KE36CA (DO-201AD, THT) | защита от выбросов |
| C28 | 330 µF/35 В (CP_Elec_8x10) | после Q1 |
| C2 | 470 µF (CP_Elec_8x10) | вход U1 |
| C6 | 100 µF (CP_Elec_8x10) | вход U2 |
| Q1 | IRF9540N (TO-220, THT) | защита от переполюсовки |
| U1 + L2 | TPS54560B (SOIC-8-1EP) + 33 µH | 24 → 12 В |
| U2 + L3 | AP3211K (SOT-23-6) + 10 µH | 12 → 5 В |
| L4 | 10 µH (SRP1245A) | входной дроссель |
| U10 | AMS1117-3.3 (SOT-223) | 5 → 3,3 В |
| D2, D3 | SS54 / SS34 (SMC) | диоды buck-каскадов |
| C1, C3–C5, C7–C14, C19–C22 | керамика 100 нФ / 10 µF | обвязка U1/U2/U10 |
| R1–R10 | делители/обратные связи (10k, 47k, 100k, 6,49k, 91k, 52,3k) | у соответствующих преобразователей |
| D4 + R22 | LED + 1k — индикатор +3V3 | у выхода U10 |

### 2.2 ДРАЙВЕРЫ КЛАПАНОВ — низ-лево x 0…40, y 32…50,5

| Поз. | Компонент | Примечание |
|---|---|---|
| U3, U4 | BTS724G (SOIC-20W) | high-side 4-канальные ключи |
| U5 | 74HCT541 (SOIC-20W) | буфер 3,3 → 5 В, OE → VLV_EN |
| R11–R16 | 10k на `VLV_DRVn` → GND | fail-safe: держат входы BTS в 0 |
| R38 | 10k к +3V3 на `VLV_EN` | разрешение буфера, fail-safe |

### 2.3 ПОД МОДУЛЕМ ESP32 — x 42…73, y 16…39 (между рядами гнёзд)

| Поз. | Компонент | Примечание |
|---|---|---|
| U6 | PCAL9555APW (TSSOP-24 4,4×7,8) | 16 бит: 6 клапанов + 4 ST + 5 кнопок |
| C29 | 100 нФ | развязка U6 |
| R29–R32 | 10k к +3V3 | подтяжки кнопок BUT1–4 |
| R33–R36 | 10k к +3V3 | подтяжки ST-флагов U3/U4 |
| R37 | 10k к +3V3 | подтяжка INT (INT_MCU) |
| R18–R21 | 10k / 4,7k | подтяжки DISP_CS, BUT5, I²C |
| C17, C18 | 100 нФ / 10 µF | развязка +3V3 у MCU |
| C23–C27 | 100 нФ | фильтры кнопок/шины |

**Ограничения:** только низкопрофильные SMD **(высота ≤ 3 мм)**, зазор ≥ 1 мм от падов
гнёзд; **не ставить** дроссели, электролиты и силовые ключи 12 В (наводки под МК и антенну).
Свободного места хватает ещё примерно на 25 посадок 0805.

### 2.4 ИНДИКАТОРЫ — у J2, x 31…47, y 44…51 (лицевая сторона)

| Поз. | Компонент | Привязка |
|---|---|---|
| D11 | LED 0805, x = 32,54 | пин 2 J2 = `VALVE_BUB1` |
| D12 | LED 0805, x = 35,08 | пин 3 = `VALVE_BUB2` |
| D13 | LED 0805, x = 37,62 | пин 4 = `VALVE_BUB3` |
| D14 | LED 0805, x = 40,16 | пин 5 = `VALVE_BUB4` |
| D15 | LED 0805, x = 42,70 | пин 6 = `VALVE_INFL` |
| D16 | LED 0805, x = 45,24 | пин 7 = `VALVE_DEFL` |
| R23–R28 | 4,7k, y = 45,9 (над своим LED) | катод LED → GND |

Ряд LED: y = 49,2; J2 — y = 52,6. Каждый светодиод стоит точно под своим пином J2,
шелкография подписывает `2/BUB1 … 7/DEFL`.

### 2.5 FLYBACK — x 48…73, y 43…50,6

| Поз. | Компонент | Примечание |
|---|---|---|
| D5–D10 | SS34 (SMA) | анод на `VALVE_x`, катод на +12 В |

### 2.6 РАЗЪЁМЫ ПО ГРАНЯМ (сводно)

- **левая:** J1 (24 В);
- **нижняя:** J2 (клапаны) + J6 (гироскоп);
- **верхняя:** J5 (дисплей), J3 (кнопки), J4 (I²C);
- **правая:** разъёмов нет — граница keep-out антенны.

### 2.7 ВХОДЫ ДАТЧИКОВ (новое, 17 позиций)

| Поз. | Компонент | Размещение |
|---|---|---|
| J7 | разъём 1×4 датчика скорости | нижняя грань, x≈68, y=52,6 |
| J8 | разъём 1×2 аварийного давления | нижняя грань, x≈10 |
| U11 | 78L08 (SOT-89) + C30 10 µF / C31 100 нФ | силовая зона, у +12 В |
| JP1 | перемычка 8 В (встроенные/внешние) | рядом U11 |
| U12 | 74LVC1G14 (SOT-23-5) + C32 | под модулем ESP32 |
| R39/R40, D17, C32 | делитель и клэмп скорости | под модулем ESP32 |
| D20 | SMAJ12A (TVS входа скорости) | у J7 |
| R41/R42, D18, C33 | вход аварийного давления | под модулем ESP32 |
| C35 | 100 нФ развязка U12 (+3V3) | под модулем ESP32 |

Правило: импульсные и аналоговые цепи — вне силовой зоны, ≥ 15 мм от дросселей L2/L3/L4;
входы защищены TVS/клэмпами, «земля» — на общий GND-полигон у разъёмов.

## 3. Правила и приоритеты

1. Сначала фиксируются якоря (разъёмы, отверстия, U9) — они определяют механику.
2. Силовая часть — только в левой полосе; дроссели L2/L3/L4 и электролиты C2/C6/C28 —
   как можно дальше от J4/J5 (≥ 35 мм) и от антенны (≥ 40 мм).
3. Мелкая обвязка МК и расширитель U6 — под модулем (короткие связи I²C/кнопки/ST).
4. Индикаторы D11–D16 — строго у J2, по одному на пин (видно активный канал).
5. Правая полоса x 74…83 — keep-out антенны: меди, деталей и дорожек нет.
6. После расстановки — DRC: цель 0 `courtyard_overlap` / `shorting`; затем трассировка.

## 4. Ориентировочный объём

| Зона | Кол-во |
|---|---|
| силовая (F+B) | 46 |
| драйверы клапанов | 9 |
| под модулем ESP32 | 21 |
| индикаторы | 12 |
| flyback | 6 |
| разъёмы + модуль + отверстия | 3 + U9 + 4 |
| **итого** | **118 футпринтов** |
