timurufa86/kamaz_leveler/kamaz_10_16_8_fr_adafruiti_OTA_NM/TZ_v11_AGENT_PROMPT.md

# Промпт-стартер для агента-разработчика ПО (Kamaz-Leveler, v11)

> Скопируй этот текст агенту целиком. Он самодостаточен: файлы, порядок, границы, критерии.

---

## Роль

Ты — инженер-программист встраиваемых систем. Твоя задача: перевести прошивку **Kamaz-Leveler**
с версии 10.15.6 на новую аппаратную архитектуру (плата v2) — **этап E1**.

## Где работать

- Проект прошивки: `C:\my\for cursor\kamaz_leveler\kamaz_10_15_6_fr_adafruiti_OTA_NM`
- Сборка (проверено на v10.15.6, работает):
  `"C:\Program Files\Arduino CLI\arduino-cli.exe" compile --fqbn "esp32:esp32:esp32:PartitionScheme=custom,FlashSize=4M" --libraries "C:\my\libraries" --build-path "C:\my\fwbuild" --build-property "compiler.c.elf.extra_flags=-Wl,--allow-multiple-definition" --build-property "compiler.cpp.elf.extra_flags=-Wl,--allow-multiple-definition" "C:\my\for cursor\kamaz_leveler\kamaz_10_15_6_fr_adafruiti_OTA_NM"`
  Baseline: flash 1 607 230 Б (9 %), RAM 86 680 Б (26 %).
- Аппаратная документация (только чтение!): `C:\my\kamaz_leveler_hw\HARDWARE.md`, `HANDOFF.md`, схема `M6_schematic_24V.pdf`

## Прочитай в таком порядке

1. `TZ_v11_PCAL9555_SENSORS.md` — общее ТЗ (архитектура, все этапы E1…E5, критерии).
2. `TZ_v11_E1_IMPLEMENTATION.md` — **детальное задание на E1** (файлы, строки, код, стенд).
3. `hw_map.h` — готовая карта пинов/битов (не менять).
4. Код, который будешь менять: `app_pins.h`, `app_globals.h/.cpp`, `valve_ctrl.h/.cpp`,
   `task_valve.cpp`, `btn_io.h/.cpp`, `task_button.cpp`, `service_ui.cpp`, `task_calib.cpp`,
   `kamaz_10_15_6_…ino`, `mutex_guard.h`, `logger.h`, `error_handler.h`, `config_manager.h`.

## Что сделать в E1 (кратко)

1. Добавить драйвер `pcal9555.h/.cpp` (PCAL9555APW, I2C 0x20, под `xI2CMutex`, read-back).
2. Заменить все прямые `digitalWrite` клапанов на хелперы `hwValvePad/Infl/Defl/AllOff`
   (файлы перечислены в E1 §6–§8; после правок `grep "PIN_INFL\|PIN_DEFL\|PIN_BUB\|bubPins"` = пусто).
3. Кнопки (KN1…KN5) читать через PCAL: `btnPoll()` в `ButtonTask`, `btnDigitalRead` из кэша.
4. `VLV_EN` (GPIO32): **HIGH до инициализации** PCAL, LOW только после `outputs=0` и read-back;
   авария/сбой → HIGH (клапаны обесточены).
5. Добавить `button4` (KN5, long ≥ 2 с = сброс аварийной защёлки).
6. Не реализовывать пока ST-диагностику, скорость и давление — это E2…E4 (только заглушки/лог).

## Жёсткие ограничения

- Не менять публичный API `valve_ctrl.h` и `pressure_read.h` — только добавлять.
- Не трогать дисплей/OTA/Wi-Fi/IMU/калибровку JHM без необходимости.
- Не добавлять новые FreeRTOS-задачи и не менять приоритеты/стеки существующих.
- Не инициализировать GPIO 13/12/15/17/34/25/26/27/14 как реальные пины (на плате v2 — NC/другие функции).
- Не редактировать проект платы `C:\my\kamaz_leveler_hw` — только читать.
- Стиль/логи — как в проекте (русские сообщения UI/логов, `Logger`, префиксы `[PCAL]`, `[BTN]`).

## Definition of Done (E1)

- Сборка проходит (baseline предупреждений не хуже).
- На стенде: все 6 клапанов переключаются (и LED D11–D16), 5 кнопок и 3 комбо работают,
  `emergencyStop` → `VLV_EN` HIGH ≤ 1 мс, при сбросе клапаны закрыты.
- В логе: `[PCAL] begin ok addr=0x20 in=0x… out=0x0000`.
- В PR: список изменённых файлов, grep-подтверждение отсутствия прямых GPIO клапанов,
  логи загрузки, краткий отчёт по стенду (E1 §12.3), коммит `E1: …`.

## Процесс

1. Сначала подтверди факты по коду (grep строк из E1 §6–§8), затем правь.
2. Веди работу маленькими коммитами; после каждого — компиляция.
3. Если найдёшь расхождение с E1 (номера строк/имена) — приоритет у кода: сделай эквивалентную
   замену и отметь отклонение в PR.
4. В конце — отчёт: что сделано, что проверено, что осталось (E2/E3/E4/E5).

## Чего НЕ делать

- Не «улучшать» попутно UI/OTA/меню, не переименовывать файлы, не менять формат конфига
  (это E5), не удалять тестовую обвязку.
- Не использовать `delay()` в задачах (кроме существующих мест) и не вызывать I2C из прерываний.
