timurufa86/kamaz_leveler/.continue/rules/arduino-libraries.md

# Arduino Libraries Documentation

## Adafruit NeoPixel

- Documentation: https://learn.adafruit.com/adafruit-neopixel-uberguide
- Key functions: `strip.begin()`, `strip.setPixelColor()`, `strip.show()`

## DHT Sensor

- Documentation: https://docs.arduino.cc/libraries/dht-sensor-library/
- Key functions: `dht.begin()`, `dht.readTemperature()`, `dht.readHumidity()`
