timurufa86/kamaz_leveler/_PARKED_FILES.md

# Отложенные файлы (не трогать до отдельной команды)

Статус: **запаркованы по просьбе владельца** 18.10.2026. Не читать, не коммитить,
не удалять и не использовать в работе, пока владелец не скажет «посмотри в них».

## В папке скетча `kamaz_10_16_0_fr_adafruiti_OTA_NM/` (untracked, не в git)

| Файл | Размер | Дата |
|---|---|---|
| `TZ_v11_AGENT_PROMPT.md` | 5 626 Б | 18.10.2026 14:04 |
| `TZ_v11_E1_IMPLEMENTATION.md` | 24 612 Б | 18.10.2026 14:04 |
| `TZ_v11_PCAL9555_SENSORS.md` | 31 026 Б | 18.10.2026 14:04 |
| `hw_map.h` | 8 141 Б | 18.10.2026 13:43 |

По названиям похоже на ТЗ/реализацию v11 (расширитель PCAL9555 и карта железа),
но содержимое не анализировалось — открывать только по команде.

## В корне репозитория (untracked)

| Файл | Размер | Дата |
|---|---|---|
| `PROMPT_hardware_schematic_pcb.md` | 17 761 Б | 18.10.2026 14:26 |

Промт для проекта схемы/трассировки платы (создан ранее, в git не добавлялся).

## Напоминание
- Ветка: `refactor/modular-firmware`, latest-релиз **v10.16.0** (Home Assistant).
- Плата работает на `V 10.16.0` (установлена по OTA).
