timurufa86/kamaz_leveler/hardware/images/BOARD_2L_case_275of284.png

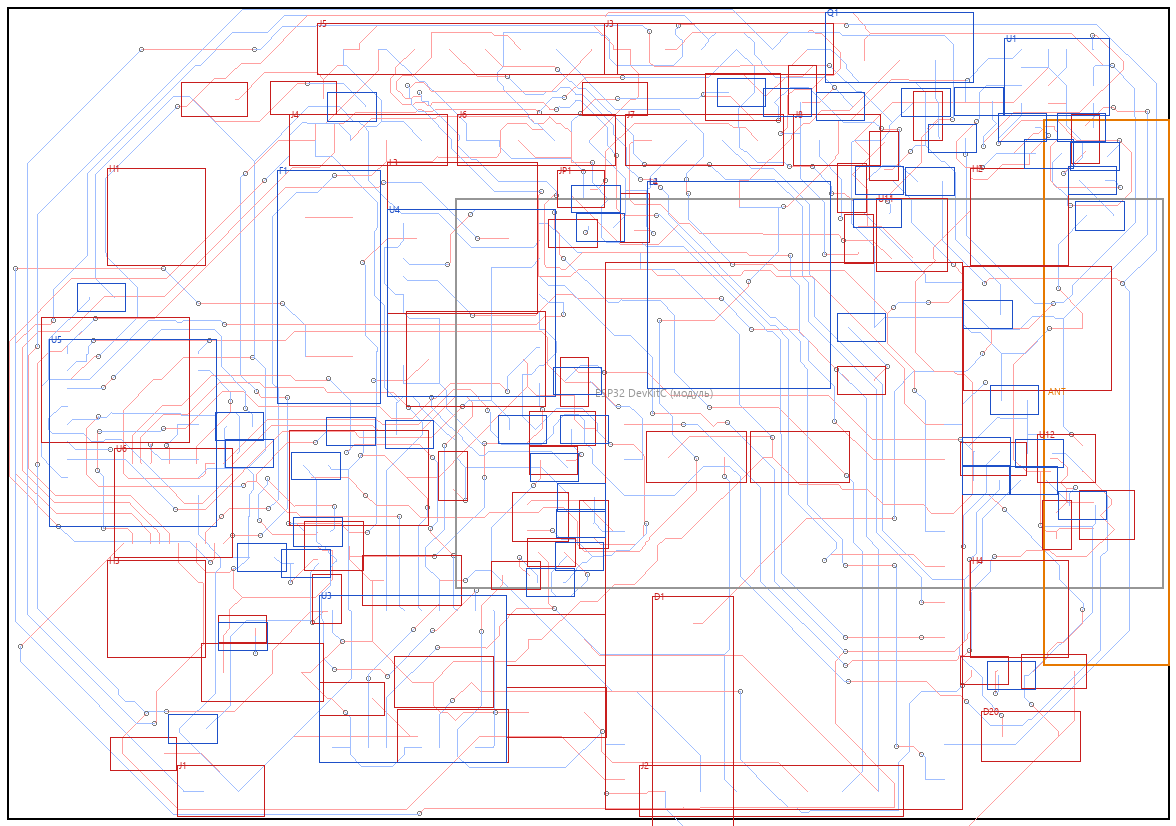
hardware/images/BOARD_2L_case_275of284.png
