timurufa86/kamaz_leveler/hardware/images/BOARD_2L_case_placement.png

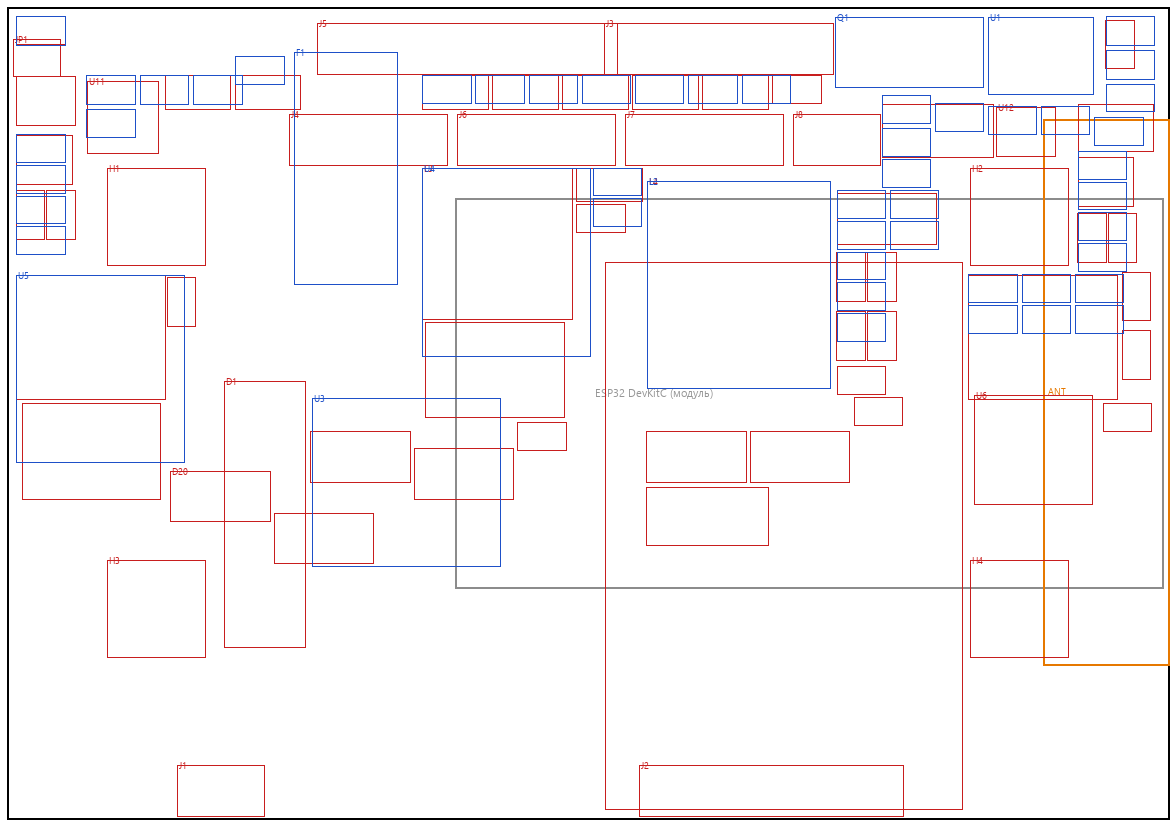
hardware/images/BOARD_2L_case_placement.png
