timurufa86/kamaz_leveler/hardware/images/BOARD_placement.png

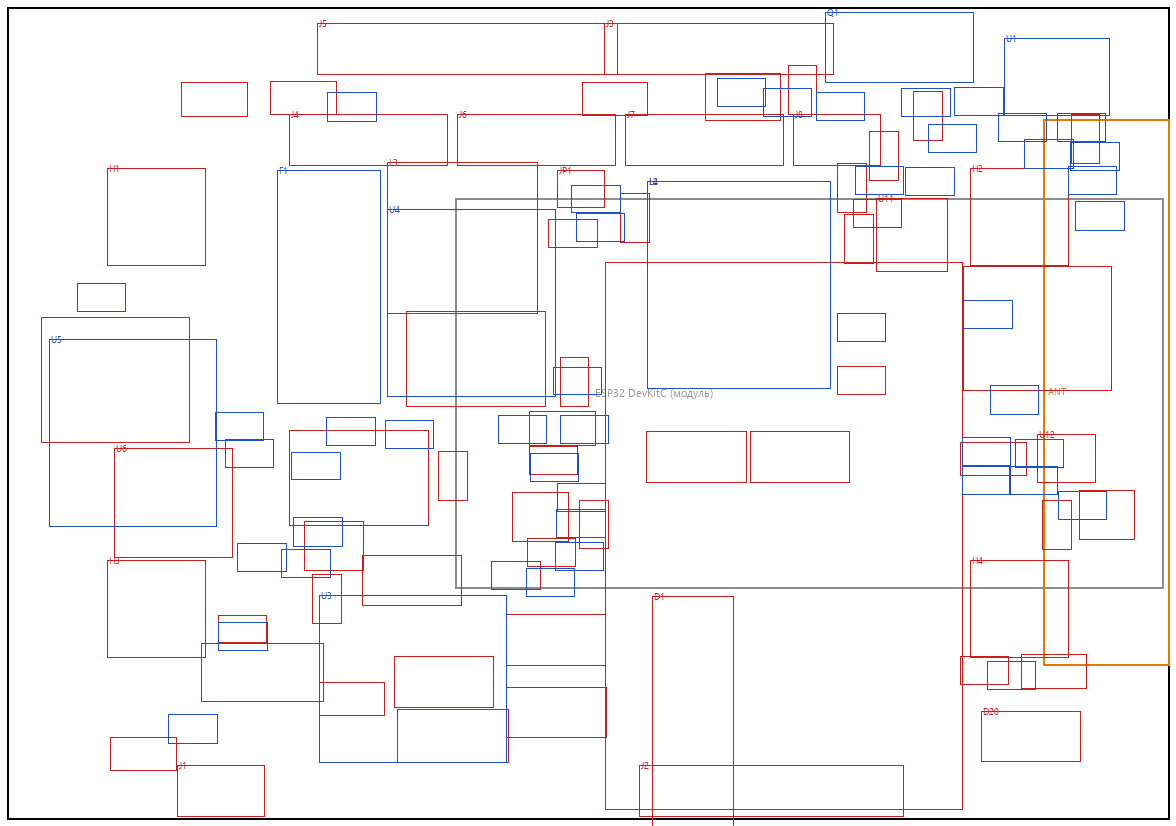
hardware/images/BOARD_placement.png
