timurufa86/kamaz_leveler/hardware/images/SCHEMATIC_esp32.png

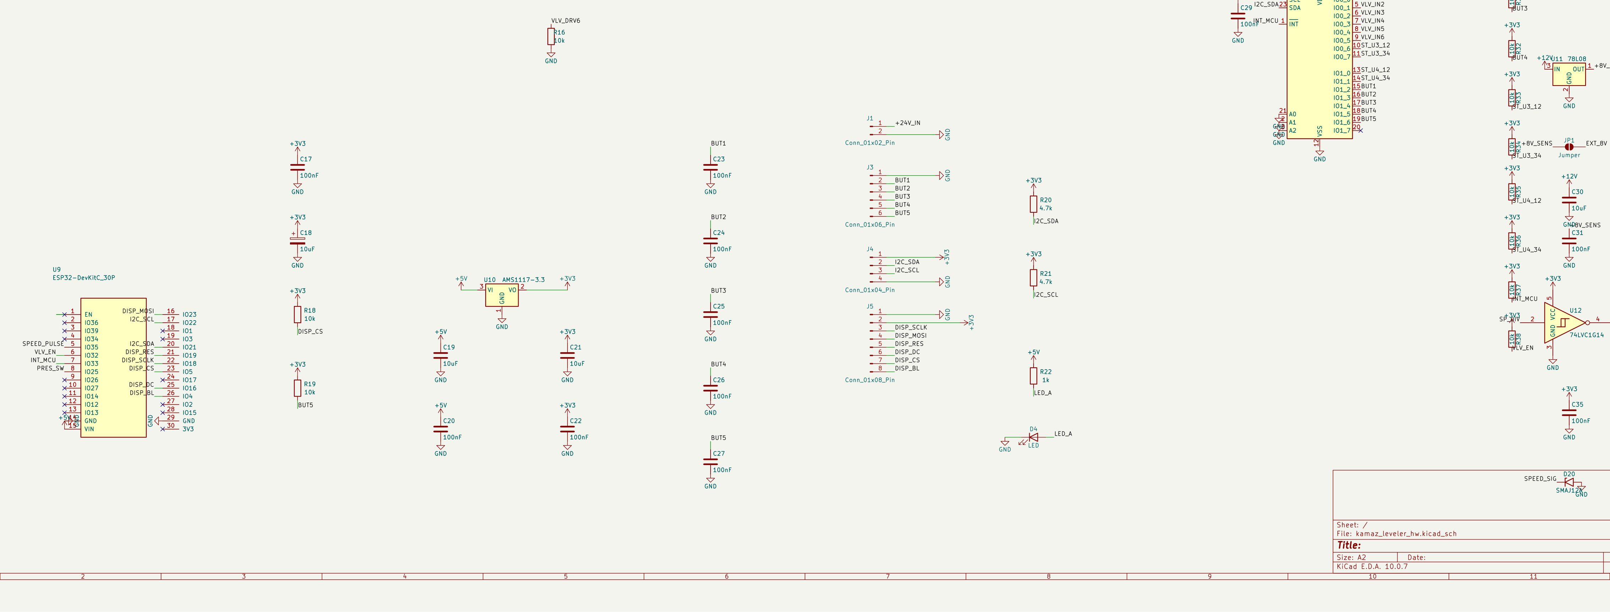
hardware/images/SCHEMATIC_esp32.png
