timurufa86/kamaz_leveler/hardware/images/SCHEMATIC_full.png

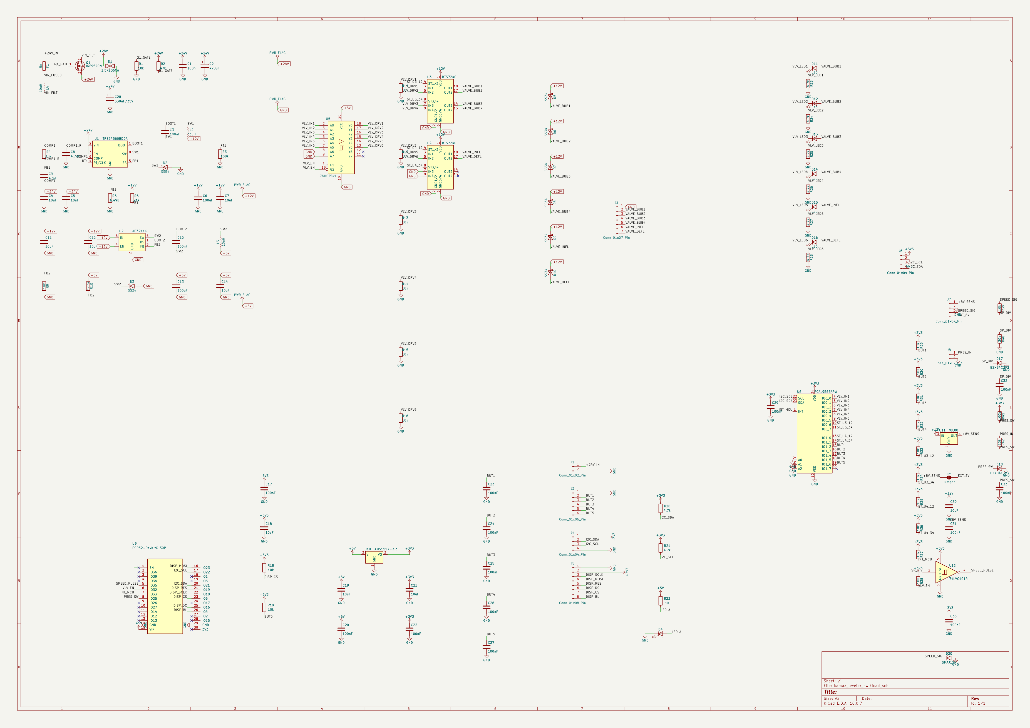
hardware/images/SCHEMATIC_full.png
