timurufa86/kamaz_leveler/hardware/images/SCHEMATIC_sensors.png

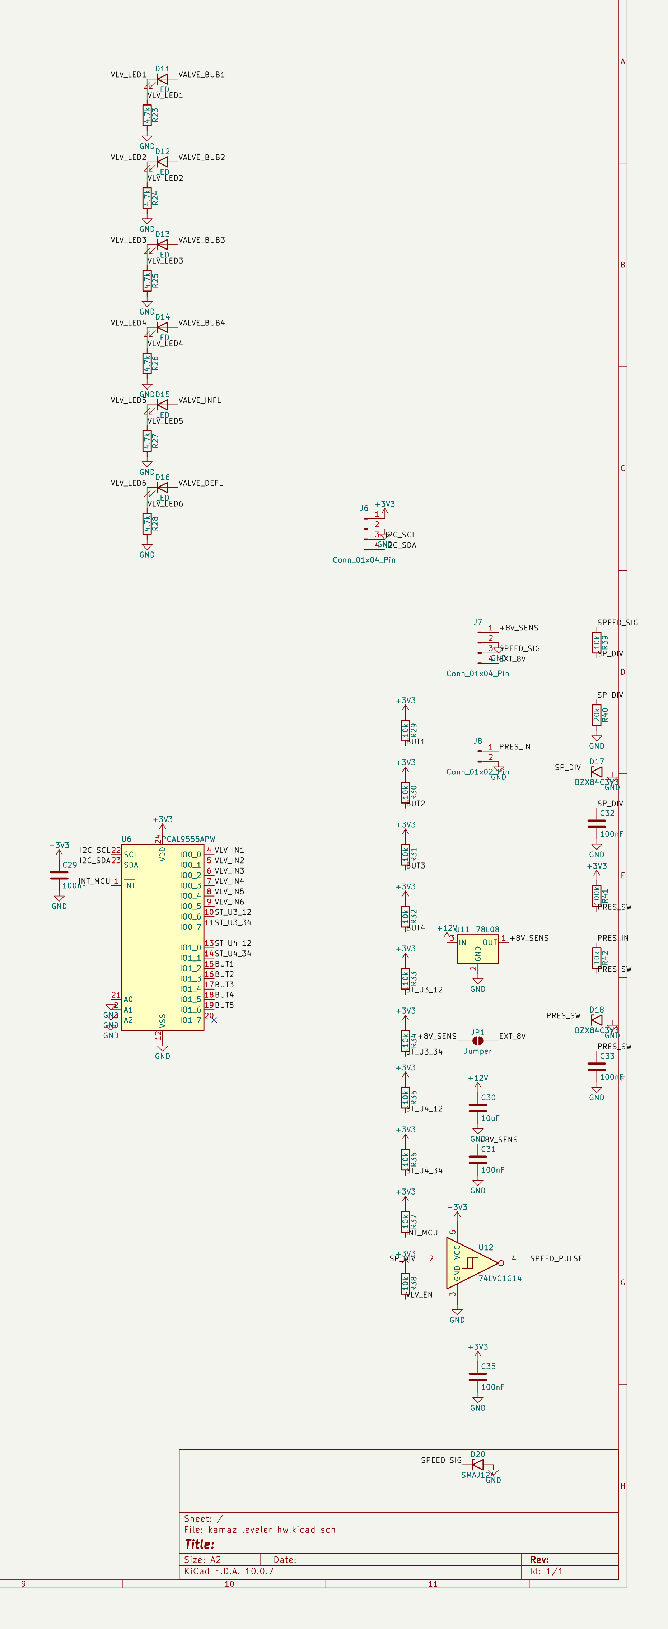
hardware/images/SCHEMATIC_sensors.png
