timurufa86/kamaz_leveler/hardware/images/SCHEMATIC_valves.png

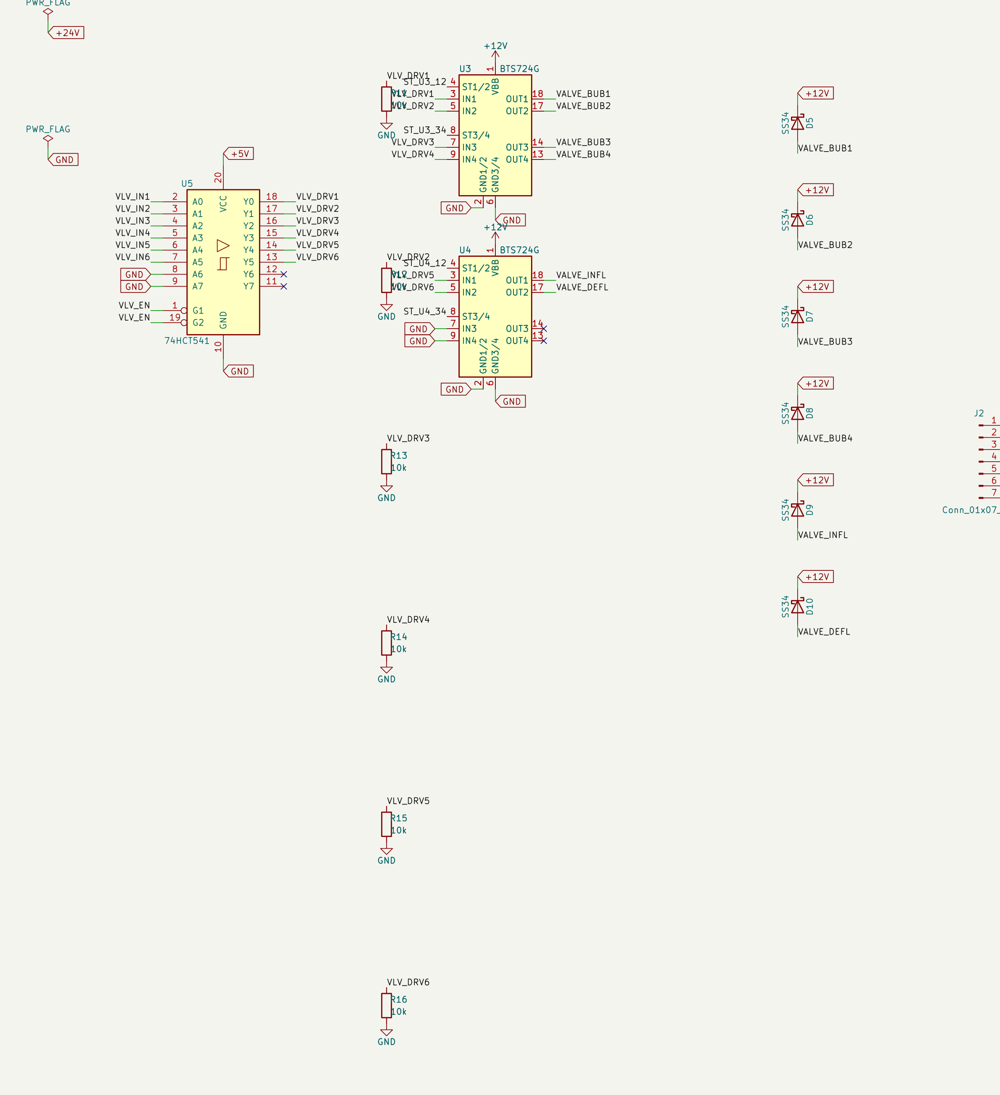
hardware/images/SCHEMATIC_valves.png
