timurufa86/kamaz_leveler/hardware/kicad/BOM.csv

Reference | Value | Footprint | Description
C1,C3,C10,C17,C20,C22-C27,C29,C31-C33,C35 | 100nF | Capacitor_SMD:C_0805_2012Metric | Unpolarized capacitor
C2 | 470uF | Capacitor_SMD:CP_Elec_8x10 | Polarized capacitor
C4,C5,C7,C11,C12,C14,C19,C21,C30 | 10uF | Capacitor_SMD:C_1206_3216Metric | Unpolarized capacitor
C6,C13 | 100uF | Capacitor_SMD:CP_Elec_8x10 | Polarized capacitor
C8 | 4.7nF | Capacitor_SMD:C_0805_2012Metric | Unpolarized capacitor
C9 | 47pF | Capacitor_SMD:C_0805_2012Metric | Unpolarized capacitor
C18 | 10uF | Capacitor_SMD:CP_Elec_5x5.4 | Polarized capacitor
C28 | 330uF/35V | Capacitor_SMD:CP_Elec_8x10 | Polarized capacitor
D1 | 1.5KE36CA | Diode_THT:D_DO-201AD_P15.24mm_Horizontal | 1500W bidirectional TVS diode, DO-201AE
D2 | SS54 | Diode_SMD:D_SMC | Schottky diode
D3 | SS34 | Diode_SMD:D_SMC | Schottky diode
D4,D11-D16 | LED | LED_SMD:LED_0805_2012Metric | Light emitting diode
D5-D10 | SS34 | Diode_SMD:D_SMA | 40V 3A Schottky diode, DO-214AC (SMA) - freewheel diode for valve coil (anode to valve output, cathode to +12V)
D17,D18 | BZX84C3V3 | Package_TO_SOT_SMD:SOT-23 | Zener diode
D20 | SMAJ12A | Diode_SMD:D_SMA | 400W unidirectional Transient Voltage Suppressor, 12.0Vr, SMA(DO-214AC)
F1 | 5A | Fuse:Fuseholder_Blade_Mini_Keystone_3568 | Fuse
J1,J8 | Conn_01x02_Pin | Connector_PinHeader_2.54mm:PinHeader_1x02_P2.54mm_Vertical | Generic connector, single row, 01x02, script generated
J2 | Conn_01x07_Pin | Connector_PinHeader_2.54mm:PinHeader_1x07_P2.54mm_Vertical | Generic connector, single row, 01x07, script generated
J3 | Conn_01x06_Pin | Connector_PinHeader_2.54mm:PinHeader_1x06_P2.54mm_Vertical | Generic connector, single row, 01x06, script generated
J4,J6,J7 | Conn_01x04_Pin | Connector_PinHeader_2.54mm:PinHeader_1x04_P2.54mm_Vertical | Generic connector, single row, 01x04, script generated
J5 | Conn_01x08_Pin | Connector_PinHeader_2.54mm:PinHeader_1x08_P2.54mm_Vertical | Generic connector, single row, 01x08, script generated
JP1 | Jumper | Jumper:SolderJumper-2_P1.3mm_Open_RoundedPad1.0x1.5mm | Solder Jumper, 2-pole, open
L2 | 33uH | Inductor_SMD:L_Bourns_SRP1245A | Inductor
L3 | 10uH | Inductor_SMD:L_Bourns-SRN1060 | Inductor
L4 | 10uH | Inductor_SMD:L_Bourns_SRP1245A | Inductor
Q1 | IRF9540N | Package_TO_SOT_THT:TO-220-3_Vertical | -23A Id, -100V Vds, 117mOhm Rds, P-Channel HEXFET Power MOSFET, TO-220
R1,R4,R9,R11-R16,R18,R19,R29-R39,R42 | 10k | Resistor_SMD:R_0805_2012Metric | Resistor
R2 | 47k | Resistor_SMD:R_0805_2012Metric | Resistor
R3,R41 | 100k | Resistor_SMD:R_0805_2012Metric | Resistor
R5 | 6.49k | Resistor_SMD:R_0805_2012Metric | Resistor
R6 | 91k | Resistor_SMD:R_0805_2012Metric | Resistor
R10 | 52.3k | Resistor_SMD:R_0805_2012Metric | Resistor
R20,R21,R23-R28 | 4.7k | Resistor_SMD:R_0805_2012Metric | Resistor
R22 | 1k | Resistor_SMD:R_0805_2012Metric | Resistor
R40 | 20k | Resistor_SMD:R_0805_2012Metric | Resistor
U1 | TPS54560BDDA | Package_SO:SOIC-8-1EP_3.9x4.9mm_P1.27mm_EP2.95x4.9mm_Mask2.71x3.4mm_ThermalVias | 5A, Step Down DC-DC Converter, 4.5-60V Input Voltage, Texas R-PDSO-G8
U2 | AP3211K | Package_TO_SOT_SMD:SOT-23-6 | 1.5A, Adjustable Step-Down Voltage Regulator, 1.4MHz Frequency, Vin=4.5..18V, Vout=0.81..15V, SOT-23-6
U3,U4 | BTS724G | Package_SO:Infineon_SOIC-20W_7.6x12.8mm_P1.27mm | Smart High-Side Power Switch, PROFET, 4 Channels, RON 90mOhm, IL(NOM) 3.3A, Vbb 5.5...40V, SOIC-20 - valve drivers (U3: BUB1-BUB4, U4: INFL/DEFL)
U5 | 74HCT541 | Package_SO:SOIC-20W_7.5x12.8mm_P1.27mm | 8-bit buffer/line driver, 3-state outputs, TTL input thresholds - 3.3V MCU to 5V level shifter for valve drivers
U6 | PCAL9555APW | Package_SO:TSSOP-24_4.4x7.8mm_P0.65mm | IO expander 16 GPIO, I2C 400kHz, Interrupt, 2.3 - 5.5V, TSSOP-24
U9 | ESP32-DevKitC_30P | kamaz_leveler:ESP32-DevKitC_Socket_2x15_P2.54mm | ESP32 30-pin (15+15) devkit board with USB Type-C, placed in 2x15 socket
U10 | AMS1117-3.3 | Package_TO_SOT_SMD:SOT-223-3_TabPin2 | 1A Low Dropout regulator, positive, 3.3V fixed output, SOT-223
U11 | 78L08 | Package_TO_SOT_SMD:SOT-89-3 | Positive 100mA 30V Linear Regulator, Fixed Output 8V, SOT-89
U12 | 74LVC1G14 | Package_TO_SOT_SMD:SOT-23-5 | Single Schmitt NOT Gate, Low-Voltage CMOS
