timurufa86/kamaz_leveler/menu_tree_10_6_2.xlsx

Sheet: README
Kamaz-Leveler menu tree — V 10.6.3
КАК ПРАВИТЬ
1. Открой лист menu — там все пункты в порядке экрана.
2. Колонку id НЕ меняй и НЕ удаляй — по ней код найдёт пункт.
3. Править можно только колонки new_* , action и comment.
4. Текущие label/unit/min/max/step/options — справочные (как сейчас в прошивке).
КОЛОНКА action (оставь пустой = без изменений по этой строке):
rename — только название/ед. (new_label, new_unit, new_options)
limits — только пределы (new_min, new_max, new_step)
both — и название, и пределы
move — перенос: заполни new_path и/или new_order
delete — убрать пункт из меню
add — новая строка: заполни id (уникальный), path, order, type, new_*
Если заполнил любой new_* без action — будет применено как both/rename по заполненным полям.
ЛИСТ pages — переименование заголовков страниц (new_title).
После правок пришли этот же xlsx в чат. Агент применит изменения в ui_menu_build.cpp.
Версия прошивки-источника: V 10.6.3 FreeRTOS OTA
Файл сгенерирован tools/gen_menu_tree_xlsx.py

Sheet: menu
id | path | order | type | label | unit | min | max | step | options | notes | new_label | new_unit | new_min | new_max | new_step | new_options | new_path | new_order | action | comment
linkSystem | Главное | 1 | link | Система | — |  |  |  |  | → страница Система
linkValveBlock | Главное | 2 | link | Клапанный блок | — |  |  |  |  | → страница Клапанный блок
linkAuto | Главное | 3 | link | Авторежим | — |  |  |  |  | → страница Авторежим
linkMovement | Главное | 4 | link | Движение | — |  |  |  |  | → страница Движение
linkImu | Главное | 5 | link | MPU | — |  |  |  |  | → страница MPU / фильтры
linkSettings | Главное | 6 | link | Просмотр | — |  |  |  |  | → страница Просмотр
itemReset | Главное / Система | 1 | button | Сброс ошибок | —
itemWiFi | Главное / Система | 2 | button | Настроить WiFi | —
linkOta | Главное / Система | 3 | link | Обновления | — |  |  |  |  | → Обновления
linkDisplay | Главное / Система | 4 | link | Дисплей | — |  |  |  |  | → Дисплей
linkInfo | Главное / Система | 5 | link | Информация | — |  |  |  |  | → Информация
itemOtaCurrent | Главное / Система / Обновления | 1 | label | Версия: … | — |  |  |  |  | живая метка; префикс Верс:
itemOtaStatus | Главное / Система / Обновления | 2 | label | Статус: … | — |  |  |  |  | живая метка
itemOtaList | Главное / Система / Обновления | 3 | button | Список прошивок | — |  |  |  |  | → Прошивки (GitHub)
itemOtaInstallLast | Главное / Система / Обновления | 4 | button | Установить последнюю | —
itemOtaArduino | Главное / Система / Обновления | 5 | button | Режим ArduinoOTA (Wi-Fi) | —
itemOtaExit | Главное / Система / Обновления | 6 | button | Выход из режима OTA | — |  |  |  |  | скрыт если OTA не активен
itemOtaListHdr | Главное / Система / Обновления / Прошивки | 1 | label | Статус: … | — |  |  |  |  | заголовок списка
itemOtaRel0 | Главное / Система / Обновления / Прошивки | 2 | button | — | — |  |  |  |  | слот релиза 0 (тег подставляется)
itemOtaRel1 | Главное / Система / Обновления / Прошивки | 3 | button | — | — |  |  |  |  | слот релиза 1
itemOtaRel2 | Главное / Система / Обновления / Прошивки | 4 | button | — | — |  |  |  |  | слот релиза 2
itemCardTag | Главное / Система / Обновления / Прошивки / Релиз | 1 | label | Релиз: — | —
itemCardInfo | Главное / Система / Обновления / Прошивки / Релиз | 2 | label | данных нет | — |  |  |  |  | на экране Инфо:
itemCardStatus | Главное / Система / Обновления / Прошивки / Релиз | 3 | label | обновите список | — |  |  |  |  | на экране Статус:
itemCardSha | Главное / Система / Обновления / Прошивки / Релиз | 4 | label | SHA-256: не проверен | —
itemCardInstall | Главное / Система / Обновления / Прошивки / Релиз | 5 | button | УСТАНОВИТЬ | —
itemCardCheckSha | Главное / Система / Обновления / Прошивки / Релиз | 6 | button | Проверить SHA-256 | —
itemContrast | Главное / Система / Дисплей | 1 | spinner | Яркость,% | % | 10 | 100 | 1 |  | живой preview PWM
itemBacklightOff | Главное / Система / Дисплей | 2 | spinner | Приглуш.,мин | мин | 0 | 30 | 1 |  | 0 = выкл
itemFrameMs | Главное / Система / Дисплей | 3 | spinner | Интервал,мс | мс | 20 | 200 | 5 |  | интервал кадра
itemRedrawAngle | Главное / Система / Дисплей | 4 | spinner | Порог углов,гра | ° | 0.01 | 0.5 | 0.01 |  | порог перерисовки
itemRedrawPressure | Главное / Система / Дисплей | 5 | spinner | Порог давл,бар | бар | 0.01 | 0.5 | 0.01 |  | порог перерисовки
itemInfoVersion | Главное / Система / Информация | 1 | label | Версия: … | — |  |  |  |  | VERSION
itemInfoMode | Главное / Система / Информация | 2 | label | Режим: … | — |  |  |  |  | АВТО/ДВИЖ/РУЧ
itemInfoMpu | Главное / Система / Информация | 3 | label | MPU: … | — |  |  |  |  | OK/ОШИБКА
itemInfoMaster | Главное / Система / Информация | 4 | label | МП: … | бар |  |  |  |  | мастер-давление
itemInfoWiFi | Главное / Система / Информация | 5 | label | Wi-Fi: … | —
itemInfoSystem | Главное / Система / Информация | 6 | label | Аптайм: … | — |  |  |  |  | часы + RAM
itemInfoErrors | Главное / Система / Информация | 7 | label | Ошибки: … | —
linkPressure | Главное / Клапанный блок | 1 | link | Давление | — |  |  |  |  | → Давление
linkValve | Главное / Клапанный блок | 2 | link | Клапаны | — |  |  |  |  | → Клапаны
linkTest | Главное / Клапанный блок | 3 | link | Тестирование | — |  |  |  |  | → Тестирование
itemPressureMin | Главное / Клапанный блок / Давление | 1 | spinner | min Р под, бар | бар | 0.1 | 5 | 0.1
itemPressureMax | Главное / Клапанный блок / Давление | 2 | spinner | max Р под., бар | бар | 1 | 8 | 0.1
itemMasterLow | Главное / Клапанный блок / Давление | 3 | spinner | min P Маг., бар | бар | 0 | 4 | 0.1 |  | подпись 0.00…4.00; пишет в рантайм сразу
itemDeadband | Главное / Клапанный блок / Давление | 4 | spinner | Гистерезис, бар | бар | 0.05 | 0.5 | 0.05
itemMasterCheck | Главное / Клапанный блок / Давление | 5 | spinner | Проверка МП,с | с | 30 | 600 | 30
itemPressStabilize | Главное / Клапанный блок / Давление | 6 | spinner | Выравн.МП,мс | мс | 100 | 2000 | 50
itemPressIdle | Главное / Клапанный блок / Давление | 7 | spinner | Цикл опроса, мин | мин | 2 | 30 | 1
itemReleaseDelay | Главное / Клапанный блок / Клапаны | 1 | spinner | Сброс,с | с | 1 | 10 | 1 |  | импульс сброса
itemInflateDelay | Главное / Клапанный блок / Клапаны | 2 | spinner | Накачка,с | с | 1 | 10 | 1 |  | импульс накачки
itemManualMaxTime | Главное / Клапанный блок / Клапаны | 3 | spinner | Макс.время,с | с | 1 | 30 | 1 |  | лимит ручной операции
itemTest | Главное / Клапанный блок / Тестирование | 1 | button | Запустить тест | — |  |  |  |  | только MANUAL, без ошибок
itemValveTestManual | Главное / Клапанный блок / Тестирование | 2 | button | Тест клапанов (ручной) | —
itemTiltX | Главное / Авторежим | 1 | spinner | Поперечный,гра | ° | 0 | 3 | 0.1
itemTiltY | Главное / Авторежим | 2 | spinner | Продольный,гра | ° | 0 | 3 | 0.1
itemCoarseZone | Главное / Авторежим | 3 | spinner | Грубая,пор. | доля | 0.2 | 0.9 | 0.05 |  | множитель (setMultiplySep)
itemFineZone | Главное / Авторежим | 4 | spinner | Точная,пор. | доля | 0.05 | 0.3 | 0.01 |  | множитель
itemWorsening | Главное / Авторежим | 5 | spinner | Хуже | — | 1.05 | 2 | 0.05 |  | множитель; ед. в подписи нет
itemNivCount | Главное / Авторежим | 6 | spinner | Попыток в час | шт | 1 | 20 | 1
itemTimeInterval | Главное / Авторежим | 7 | spinner | Интервал,мин | мин | 1 | 60 | 1
itemMovementEnabled | Главное / Движение | 1 | checkbox | Режим Движение | вкл/выкл |  |  |  |  | по умолчанию вкл
itemMovementFront | Главное / Движение | 2 | spinner | Давл.перед,бар | бар | 1 | 6 | 0.1
itemMovementRear | Главное / Движение | 3 | spinner | Давл.зад,бар | бар | 1 | 6 | 0.1
itemParkingPressure | Главное / Движение | 4 | spinner | Давл.стоянки,бар | бар | 0 | 6 | 0.1 |  | 0 = как в движении
itemMoveDuration | Главное / Движение | 5 | spinner | До входа,с | с | 10 | 120 | 5
itemMoveSettle | Главное / Движение | 6 | spinner | Успокоение,с | с | 10 | 120 | 5
itemMoveCheck | Главное / Движение | 7 | spinner | Проверка давл.,с | с | 30 | 300 | 10
itemMoveTolerance | Главное / Движение | 8 | spinner | Допуск давл.,бар | бар | 0.1 | 1 | 0.05
itemImuZero | Главное / MPU | 1 | button | Обнулить углы | —
itemImuCalib | Главное / MPU | 2 | button | Калибровка офсетов | —
itemImuDiag | Главное / MPU | 3 | button | Диагностика MPU | —
itemImuAccelFs | Главное / MPU | 4 | spinner | Диапазон accel | G | 0 | 3 | 1 | ±2G|±4G|±8G|±16G | индекс 0…3
itemImuDlpf | Главное / MPU | 5 | spinner | Фильтр DLPF | Гц | 0 | 6 | 1 | 256 Гц|188 Гц|98 Гц|42 Гц|20 Гц|10 Гц|5 Гц | индекс 0…6
itemImuMotionDet | Главное / MPU | 6 | spinner | Чувств. MOT | мг | 20 | 255 | 5 |  | подпись thr×2 мг
itemGyroThr | Главное / MPU | 7 | spinner | Чувств. вибрации | 1…25 | 1 | 25 | 1 |  | слаб≤8 / норм≤16 / жёстк
itemGyroBump | Главное / MPU | 8 | spinner | Чувств. неровн. | 1…25 | 1 | 25 | 1 |  | слаб/норм/жёстк
itemAccelThr | Главное / MPU | 9 | spinner | Чувств. ускорения | LSB | 0 | 4 | 1 | 200 слаб|500 норм|1000|1500|2000 жёстк | индекс 0…4
itemZeroAngleX | Главное / MPU | 10 | spinner | Нуль крен,гра | ° | -45 | 45 | 0.01
itemZeroAngleY | Главное / MPU | 11 | spinner | Нуль тангаж,гра | ° | -45 | 45 | 0.01
itemImuPreset | Главное / MPU | 12 | spinner | Плавность углов | — | 0 | 2 | 1 | Плавно|Быстро|Баланс | грузит скрытые Kalman/EMA/slew
itemImuPollMs | Главное / MPU | 13 | spinner | Опрос,мс | мс | 15 | 100 | 5
itemImuSlew | Главное / MPU | 14 | spinner | Макс.скорость,гра/с | °/с | 5 | 120 | 5
itemSet1 | Главное / Просмотр | 1 | label | Давление: … | — |  |  |  |  | живая сводка
itemSet2 | Главное / Просмотр | 2 | label | Наклон: … | — |  |  |  |  | живая сводка
itemSet3 | Главное / Просмотр | 3 | label | Клапаны: … | — |  |  |  |  | живая сводка
itemSet4 | Главное / Просмотр | 4 | label | Авторежим: … | — |  |  |  |  | живая сводка
itemSet5 | Главное / Просмотр | 5 | label | Движение: … | — |  |  |  |  | живая сводка
itemSet6 | Главное / Просмотр | 6 | label | Дисплей: … | — |  |  |  |  | живая сводка
itemSet7 | Главное / Просмотр | 7 | label | MPU: … | — |  |  |  |  | живая сводка

Sheet: pages
page_id | title | path | new_title | action | comment
mainPage | Главное меню | Главное
systemPage | Система | Главное / Система
valveBlockPage | Клапанный блок | Главное / Клапанный блок
autoPage | Авторежим | Главное / Авторежим
movementPage | Движение | Главное / Движение
imuPage | MPU / фильтры | Главное / MPU
settingsViewPage | Просмотр | Главное / Просмотр
otaPage | Обновления | Главное / Система / Обновления
otaListPage | Прошивки (GitHub) | Главное / Система / Обновления / Прошивки
otaCardPage | Релиз | Главное / Система / Обновления / Прошивки / Релиз
displayPage | Дисплей | Главное / Система / Дисплей
infoPage | Информация | Главное / Система / Информация
pressurePage | Давление | Главное / Клапанный блок / Давление
valvePage | Клапаны | Главное / Клапанный блок / Клапаны
testPage | Тестирование | Главное / Клапанный блок / Тестирование

Sheet: legend
Цвет | Значение
Оранжевый id | НЕ МЕНЯТЬ — ключ для применения в коде
Серый | Текущее состояние прошивки (справочно)
Жёлтый | Поля для твоих правок
type | смысл
link | переход на другую страницу
spinner | числовое значение с min/max/step
checkbox | вкл/выкл
button | действие по нажатию
label | только чтение / живая строка
