timurufa86/kamaz_leveler/hardware/3d/kamaz_leveler_hw.step

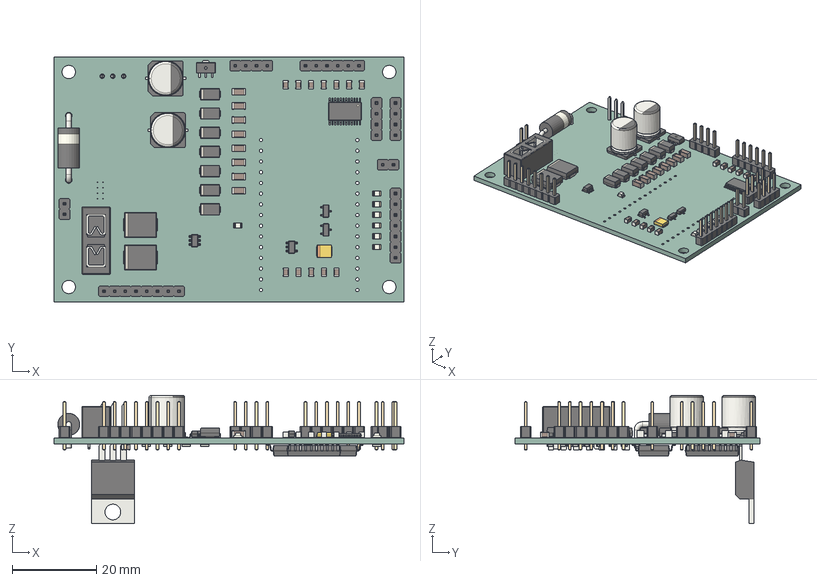
[picture p8: CAD file, 2026-11-04]
hardware/3d/kamaz_leveler_hw.step
83.0 x 58.0 x 30.5 mm
D_SMC x 2
PinHeader_1x04_P254mm_Vertical x 3
C_0805_2012Metric x 19
C_1206_3216Metric x 8
D_DO-201AD_P15.24mm_Horizontal
SOT-23-6
PinHeader_1x07_P254mm_Vertical
LED_0805_2012Metric x 7
D_SMA x 7
PinHeader_1x02_P254mm_Vertical x 2
SOT-23 x 2
A_Keystone_3568
CP_EIA_3528_12_Kemet_T
CP_Elec_8x10 x 2
TSSOP-24_4.4x7.8mm_P0.65mm
PinHeader_1x08_P254mm_Vertical
PinHeader_1x06_P254mm_Vertical
SOT-23-5
adbeea57-9c39-11ed-93f0-dde97e994e83_part
adbeea58-9c39-11ed-93f0-dde97e994e83_part
adbeea59-9c39-11ed-93f0-dde97e994e83_part
R_0805_2012Metric x 39
SOIC-20W_7.5x12.8mm_P1.27mm x 3
TO-220-3_Vertical
kamE6A1_PCB
