timurufa86/kamaz_leveler/hardware/kicad/3dmodels/ESP32-DevKitC.stp

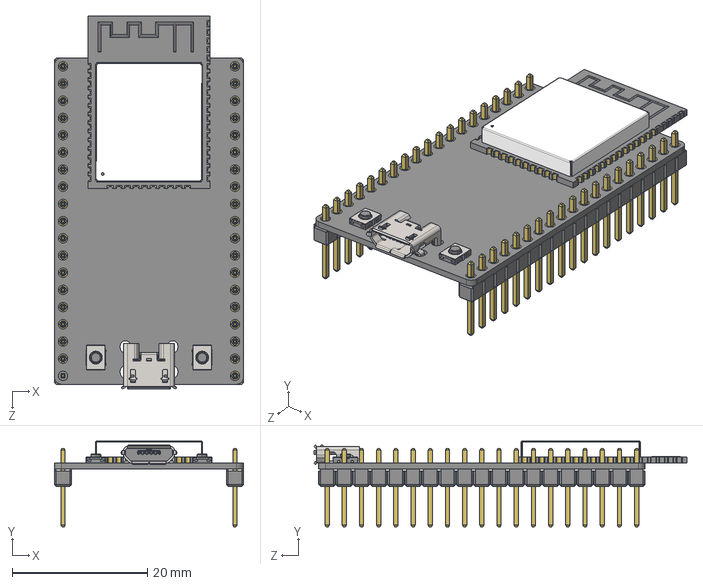
[picture p9: CAD file, 2026-11-04]
hardware/kicad/3dmodels/ESP32-DevKitC.stp
27.9 x 12.7 x 55.1 mm
