timurufa86/kamaz_leveler/hardware/kicad/3dmodels/74HCT541D.stp

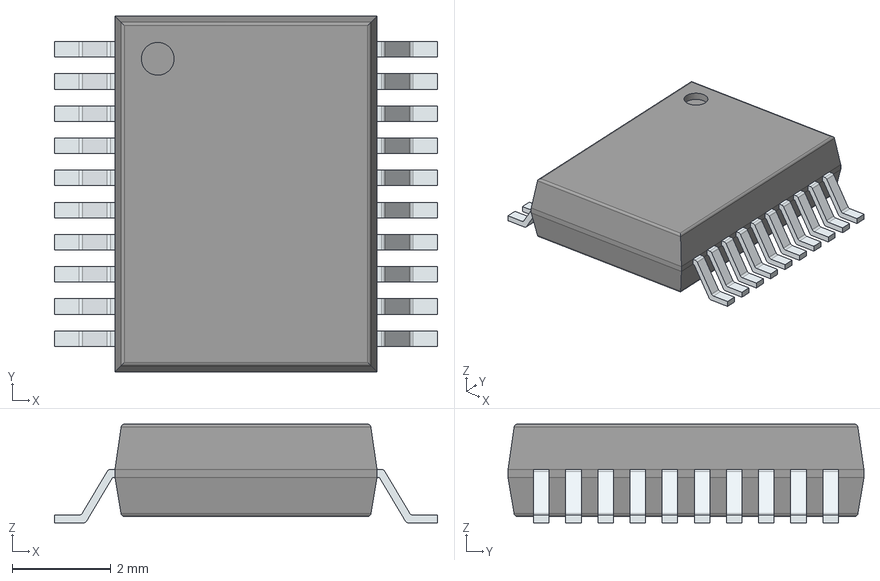
[picture p11: CAD file, 2026-11-04]
hardware/kicad/3dmodels/74HCT541D.stp
7.75 x 7.20 x 2.00 mm
PinsArrayLR
