timurufa86/kamaz_leveler/hardware/kicad/3dmodels/BTS724GXUMA1.stp

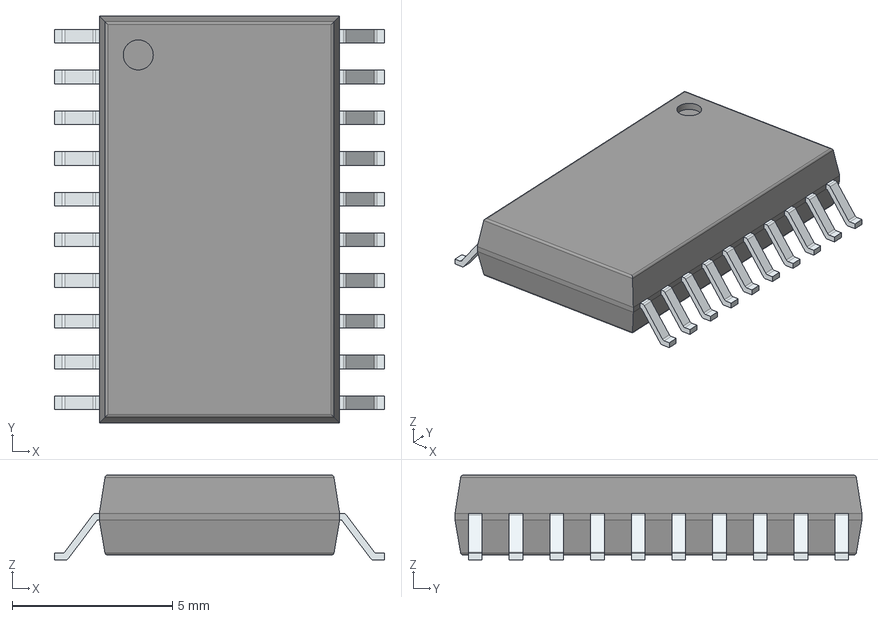
[picture p12: CAD file, 2026-11-04]
hardware/kicad/3dmodels/BTS724GXUMA1.stp
10.3 x 12.7 x 2.65 mm
PinsArrayLR
