timurufa86/kamaz_leveler/hardware/kicad/3dmodels/AP3211KTR-G1.stp

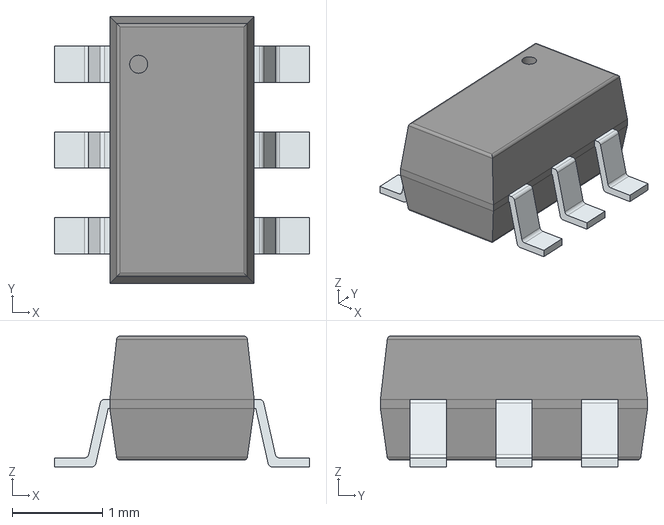
[picture p13: CAD file, 2026-11-04]
hardware/kicad/3dmodels/AP3211KTR-G1.stp
2.83 x 2.96 x 1.45 mm
PinsArrayLR
