timurufa86/kamaz_leveler/runs/wdt_verify.csv

t_ms | mot | mot_st | gyro | gdlt | thr | busy | bump | bdlt | bthr | bbusy | lin | ldlt | lthr | lbusy | hold | was | mode | age | enter | settle_left | exit | pulse_ms | need_ms | int
26303 | 0 | 0x00 | 2.0 | 0.0 | 16.0 | 0 | 1.0 | 0.0 | 16.0 | 0 | 10659.0 | 8.0 | 100.0 | 0 | 0 | 0 | MANUAL | 0.00 | -1.00 | 0.00 | -1.00 | 0 | 25000 | 0x03
26424 | 0 | 0x00 | 2.0 | 0.0 | 16.0 | 0 | 2.0 | 1.0 | 16.0 | 0 | 10658.0 | 9.0 | 100.0 | 0 | 0 | 0 | MANUAL | 0.00 | -1.00 | 0.00 | -1.00 | 0 | 25000 | 0x03
26535 | 0 | 0x00 | 2.0 | 0.0 | 16.0 | 0 | 2.0 | 1.0 | 16.0 | 0 | 10675.0 | 8.0 | 100.0 | 0 | 0 | 0 | MANUAL | 0.00 | -1.00 | 0.00 | -1.00 | 0 | 25000 | 0x03
26651 | 0 | 0x00 | 1.0 | 0.0 | 16.0 | 0 | 1.0 | 0.0 | 16.0 | 0 | 10671.0 | 3.0 | 100.0 | 0 | 0 | 0 | MANUAL | 0.00 | -1.00 | 0.00 | -1.00 | 0 | 25000 | 0x03
26765 | 0 | 0x00 | 1.0 | 0.0 | 16.0 | 0 | 1.0 | 0.0 | 16.0 | 0 | 10669.0 | 3.0 | 100.0 | 0 | 0 | 0 | MANUAL | 0.00 | -1.00 | 0.00 | -1.00 | 0 | 25000 | 0x03
26883 | 0 | 0x00 | 2.0 | 0.0 | 16.0 | 0 | 1.0 | 0.0 | 16.0 | 0 | 10673.0 | 7.0 | 100.0 | 0 | 0 | 0 | MANUAL | 0.00 | -1.00 | 0.00 | -1.00 | 0 | 25000 | 0x03
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
