timurufa86/kamaz_leveler/kamaz_10_6_2_fr_adafruiti_OTA_NM/RELEASE_NOTES.md

# V 10.6.2

- Nested menus: Система / Клапанный блок; removed redundant СОХРАНИТЬ (exit still saves)
- Larger GEM checkbox sprites (2×)
- Menu toggle to disable MOVEMENT mode
- World-frame linear accel for motion RMS (Electronic Cats DMP)
- MPU menu regroup, ±8G accel FS, DLPF default BW_5

## Earlier (10.4.1)

- Fix OTA TLS heap alloc; SHA-256 integrity of `kamaz_leveler.bin`
- Custom 4MB partition table (1.75MB OTA slots)
