timurufa86/kamaz_leveler/kamaz_10_16_8_fr_adafruiti_OTA_NM/RELEASE_NOTES.md

# V 10.16.8

- **Исправлены паузы 5–10 с и таймауты при опросе HTTP-API из Home Assistant**:
  ESP32 уходил в Wi-Fi modem-sleep, пакеты терялись и TCP переотправлял их
  (RTT до 265 мс, 10% потерь). Теперь при поднятом HA-сервере вызывается
  `WiFi.setSleep(false)`, а при остановке сервера сон возвращается.

# V 10.16.7

- **Возвращена надпись Wi-Fi**: вместо иконки в статус-строке снова текст
  «WiFi» (зелёный) / «AP» (жёлтый) / «нет» (серый). Иконка Home Assistant
  (`iconHaL`) остаётся справа (x=168).
- `iconWifiL` оставлен в icon.h (на будущее), но не используется.

# V 10.16.6

- **Wi-Fi теперь иконкой**: текст «WiFi/AP/нет» в статус-строке заменён на битмап
  `iconWifiL` (20×20, две дуги + точка). Цвет: зелёный — STA подключён, жёлтый — AP,
  серый — нет связи. Иконка HA (`iconHaL`) остаётся сразу справа (x=168).

# V 10.16.5

- **Исправлено зависание при входе в «Обновления»**: страница больше не запускает
  автоматическую проверку GitHub. Раньше вход сразу стартовал TLS-фетч в OTA-задаче,
  и при включённой HA-интеграции (HTTP-сервер + TLS) меню/устройство подвисало.
  Проверка теперь только по явным пунктам «Список прошивок» / «Установить последнюю».
- Для явных сетевых операций добавлен `haOtaBegin/End` вокруг TLS-фетча списка
  (освобождает сокеты и ~5 КБ кучи, чтобы два сетевых стека не конкурировали).
- **Иконка HA вместо текста**: в статус-строке рядом с `WiFi` теперь битмап-домик
  `iconHaL` (20×20, зелёный), а не надпись «HA». Позиция 168…188, иконка режима — 248.

# V 10.16.4

- **Бейдж HA действительно виден**: он стоял в области x=94…120, которую
  `updateMainStatBadge()` перерисовывает миганием «СТАТ» — надпись стиралась.
  Теперь WiFi сжат до 120…150, бейдж `HA` — в свободной зоне 150…168 (перед иконкой режима).
- `HA STATUS` по Serial теперь печатает `online=1/0` (для диагностики индикатора).

# V 10.16.3

- **Индикатор HA в статус-баре теперь появляется**: статус-строка рисуется только при
  полном redraw, а HA поднимается позже первого кадра. Добавлена принудительная
  перерисовка при смене состояния связи (`haIsOnline()`).
- **Закрепление IP на устройстве** (без DHCP-резерва на роутере): статический адрес
  хранится в конфиге (формат 12) и задаётся по Serial:
  `WIFI IP <ip> <gw> <mask> [dns]`, сброс — `WIFI IP DHCP`, статус — `WIFI STATUS`.
- Прочее: статический IP виден в `GET /api/config` (`staStatic/staIp/staGw/staMask/staDns`),
  запись через API запрещена (только Serial/меню).

# V 10.16.2

Интерфейс: **индикатор связи с Home Assistant в статус-баре**.

- Слева от надписи `WiFi` появился зелёный бейдж **`HA`**; он горит, только когда
  сервер реально работает (интеграция включена, Wi-Fi STA подключён, не идёт OTA).
  При выключении интеграции или потере Wi-Fi бейдж гаснет.
- Реализация: `haIsOnline()` в `ha_api` + `uiRedrawLabel` в статус-строке
  `ui_screens.cpp` (x=94, шрифт SmallB, цвет `theme::OK`).

# V 10.16.1

Патч к 10.16.0: **HTTP-API больше не игнорирует запрещённые поля молча**.

- `POST /api/config` с неизвестным или неразрешённым ключом (например, `zeroAngleX`,
  `fooBar`) теперь возвращает `403 {"error":"rejected_fields","rejected":"..."}` и
  **ничего не применяет**. Раньше ответ был `200 ok:true` с пустыми
  `applied/rejected`, и пользователь не знал, что настройка не записана.
- Ответ `409 config busy` и прочие ошибки — без изменений.

# V 10.16.0

Новая функция: **интеграция с Home Assistant по HTTP REST** — включается тумблером в
меню, не требует брокера и новых библиотек.

## Что умеет

- **Снятие показаний** (`GET /api/state`): режим, состояние, углы X/Y, температура,
  давления 4 подушек и магистрали (+ флаги валидности), калибровка, MPU/JHM,
  движение, стадия автоуровня и попытки, ручные цели, активные ошибки, Wi-Fi (IP,
  RSSI), куча, аптайм, OTA, статус HA.
- **Переключение АВТО/РУЧНОЙ** (`POST /api/mode`) — та же функция, что у кнопок
  (`mode_ctrl.cpp`), со сбросом таймеров авторежима и целями ручного режима.
- **Ручное управление** (`POST /api/manual`): удержание `start`/`stop`,
  импульс `pulse` (в очередь, клампится по `manualMaxTimeSec`), авто-стоп по лимиту.
- **Чтение всех настроек** (`GET /api/config`, формат 11) и **запись безопасного
  подмножества** (`POST /api/config`): давления, допуски, задержки, пороги авто/IMU,
  дисплей. Опасные поля (нули углов, офсеты, фильтры IMU) — только чтение.
- **Действия** (`POST /api/action`): `reset_errors`, `stop_all`, `emergency_stop`,
  `save`, `restart`.
- **Необязательный токен** `X-Api-Key` (задаётся по Serial: `HA TOKEN <стр>`).

## Безопасность

- Ручные команды запрещены при OTA, аварийной защёлке, тесте клапанов, отсутствии
  калибровки, критической ошибке или отказе датчика (код 423).
- Изменяющие запросы не чаще 1/100 мс; конфиг сохраняется на флеш с задержкой 10 с
  (или по `action:save`).
- Сервер работает только в локальной сети, без TLS (памяти под TLS+OTA не хватает).
- В режиме ДВИЖЕНИЕ сервер останавливается.

## Меню и Serial

- Меню → **Система → Дом (HA)**: тумблер «Интеграция», строка статуса
  (`http://<ip>/api/state`), признак токена, «Сбросить токен».
- Serial: `HA ON|OFF|STATUS|TOKEN <стр>|STATE|CONFIG|SELFTEST`.

## OTA и память

- На время OTA HTTP-сервер останавливается (`haOtaBegin/End`) — освобождает сокеты
  и ~5 КБ кучи; после неудачи поднимается снова.
- Новая задача `HaTask` (стек 6 КБ, core 1) сообщает heartbeat TaskMonitor.
- Формат конфига 10 → 11 (старые файлы читаются; `haEnabled=false`, токен пуст).

## Home Assistant

- Готовый пакет: `ha/kamaz_leveler_package.yaml` (rest-сенсоры, binary_sensor,
  rest_command, скрипты), пример дашборда `ha/kamaz_leveler_dashboard.yaml`,
  инструкция `docs/HA_INTEGRATION.md`.

## Совместимость

Карта разделов, GPIO и остальные настройки не менялись. Обновление с 10.15.x —
обычное OTA; после установки нужно один раз включить «Дом (HA)» в меню.

# V 10.15.8

Патч-релиз поверх 10.15.7: **исправлен регресс в освобождении памяти под OTA**.

10.15.7 добавила в проверку перед удалением задач мьютексы `ErrorHandler` и `EventBus`,
но проверка была «всё или ничего»: если хоть один из десяти мьютексов держала
приостановленная задача (в т.ч. та, которую мы НЕ удаляем), освобождение пропускалось
целиком — и OTA-переподключение снова упиралось в 84 КБ кучи.

Теперь проверка **по-задачная**: для каждой удаляемой задачи берутся только её мьютексы
(Event → EventBus, Button → display/config/state, Valve → valve, ErrRec → ErrorHandler,
Calib → I2C/calib). Если занят мьютекс конкретной задачи — пропускается только она,
остальные всё равно освобождаются.

Проверено на железе: `[OTA-MEM] freed 5 worker tasks, heap=127672` и установка
по воздуху доходит до `range OK`.

# V 10.15.7

Патч-релиз: **исправления по полному аудиту прошивки** (3 независимых ревизии + ручная
проверка ядра). Затронуты безопасность пневматики, автоуровень, мониторинг задач,
конфиг и OTA.

## Безопасность / логика

- **`abs(float)` → `fabsf()`** (20 мест): `int abs()` усекал пороги < 1 — автоуровень
  игнорировал наклон меньше градуса, коррекция в ДВИЖЕНИИ срабатывала только при
  |ΔP| ≥ 1 бар, пороги перерисовки экрана были «заморожены».
- **Устаревшие давления больше не затирают свежие** во время работы клапанов:
  `pressureTask` не публикует свой «замороженный» снимок при `valveWork`/`ERR_VALVE`/
  `otaValveLock`, а `task_control` не копирует старый снимок из очереди. Раньше это
  давало ложный `ERR_VALVE` и `emergencyStop`.
- **Первый замер магистрали** завершается только по реальному успешному
  `measureMaster()` (раньше условие было всегда истинно → ложный `LOW_PRESSURE`).
- **Автоуровень**: счётчик точных итераций принадлежит циклу и больше не обнуляется
  при каждом повторном входе в FINE_TUNING; итерация засчитывается всегда, поэтому
  лимит 10 реально останавливает цикл. Параметр «порог хуже» теперь используется
  (остановка при ухудшении на заданный коэффициент).
- **Тест клапанов** блокируется/прерывается при взведённой аварийной защёлке
  (раньше обходил `emergencyIsLatched()` через `hasActiveErrors()`).
- **Клапанный путь** (`sendValveCommand`, `valveTask`) проверяет защёлку.
- **`manualTargetSet`** сбрасывается под `xStateMutex` (был второй мьютекс → гонка).
- **`emergencyStop`** больше не пишет `manualTargetSet` под чужим мьютексом.

## Мониторинг / конкурентность

- **Ложный WATCHDOG после паузы OTA**: метки задач перебазируются один раз при
  возобновлении — длинное скачивание больше не выглядит зависанием.
- **15-секундное ожидание Wi-Fi** в ButtonTask больше не поднимает ложный WATCHDOG:
  вызывающая задача обновляет свой heartbeat (`TaskPool::getIndexByHandle`).
- **`errorRecoveryTask`** обходит активные ошибки по enum, а не по индексам снимка
  (`removeError()` сдвигал список в середине цикла).
- `updateTaskStatus()` — проверка границ; `getTaskCount()` — под мьютексом;
  счётчики EventBus — под мьютексом; `toggleAutoManualMode` пишет состояние под
  `xStateMutex` в обеих ветках.

## Конфиг / прочее

- `ConfigManager::save()`: не игнорирует сбой `rename` в `.bak` и возвращает `false`,
  если записанный файл не прошёл проверку чтением.
- `EH_MPU` берётся из `app_types.h` (был литерал 2).
- Подпись чувствительности IMU показывает реальные LSB и пересчитанные °/с
  (раньше «°/с» были завышены ~131×).
- `handleError`: сообщение события явно нуль-терминируется.

## OTA

Перенесено освобождение/восстановление задач: `free` — в `downloadGitHubFirmware()`
после паузы, `restore` — в `githubOtaEndInstallSession()`, поэтому выигрыш +21.7 КБ
кучи получает и путь «меню → Установить последнюю». Исправлена утечка уже взятых
мьютексов при пропуске освобождения (был дедлок). В проверку входят мьютексы
`ErrorHandler` и `EventBus`.

## Совместимость

Карта разделов, формат конфига (10) и GPIO не менялись. Обновление с 10.15.5/10.15.6 —
обычное OTA; с 10.15.0–10.15.3 — разовая прошивка по USB.

## Earlier (10.15.6)

Освобождение стеков неиспользуемых задач на время установки (+21.7 КБ кучи),
восстановление при неудаче.

# V 10.15.6

Патч-релиз: **на время установки устройство освобождает память под OTA** — лишние
задачи удаляются, а при неудаче пересоздаются. Это закрывает последний сценарий
срыва (нехватка кучи при переподключении) и делает OTA устойчивым.

## Зачем

Замеры показали: **TLS-подключение не устанавливается, если свободной кучи меньше
~88 КБ**, причём это верно и для соединения без проверки сертификата. После
`esp_ota_begin()` и частичной записи оставалось 83–86 КБ, поэтому любой обрыв CDN
становился фатальным — переподключиться было нечем.

## Что сделано

- **Удаление неиспользуемых задач на время установки.** После `githubOtaPauseWorkers(true)`
  удаляются задачи Event, Button, Valve, ErrRec, Calib (их стеки — это ~21.7 КБ кучи).
  Остаются Display (рисует прогресс), Watchdog (TWDT) и сама OTA-задача.
  Замер на плате: куча на старте установки `105984` → **`127672` Б (+21.7 КБ)**.
- **Безопасность удаления.** Перед удалением берутся и отпускаются все общие
  мьютексы (I2C, клапаны, дисплей, конфиг, состояние, команды, тест, калибровка).
  Если приостановленная задача держит мьютекс — удаление пропускается, работа идёт
  как раньше (без потери корректности).
- **Пересоздание при неудаче.** `TaskPool::destroyKeepSlot()` / `recreateSlot()`
  сохраняют конфигурацию задачи (функция, стек, приоритет, ядро, параметры) и
  восстанавливают её ровно такой же после неудачной установки.
- Сохранены все фиксы 10.15.5: скачивание без проверки сертификата (SHA-256 из
  проверенного digest), 4-КБ чанки + ротация сокета каждые 300 КБ, свежий CDN-URL
  (SAS) внутри попытки при залипании, один клиент, EventBus 32, телеметрия.

## Проверено на стенде

Установка релиза 10.15.5 по воздуху с этой же сборки:

```
[OTA-LINK] install-start heap=105984
[OTA-MEM] freed 5 worker tasks, heap=127672
[GH-OTA] rotate socket at 307200 / 614400 / 921600 / 1228800 / 1536000
[GH-OTA] range OK 1605552
[GH-OTA] OK esp_ota_end v10.15.5 > reboot
[OTA-MEM] restored worker tasks, heap=106368
rst:0xc (SW_CPU_RESET)
```

После перезагрузки: `otadata` seq 1 → 2 (активный слот переключён), `OTA VER` =
`V 10.15.5 FreeRTOS OTA`. Ни одного обрыва.

## Совместимость

Устройства на 10.15.0–10.15.3 обновляются по USB; начиная с 10.15.5 OTA работает.
Карта разделов, формат конфига и GPIO не менялись.

# V 10.15.5

Патч-релиз: **OTA-установка работает и проверена на железе**. Причина прежних
срывов — не Wi-Fi, не размер OTA-слота и не GitHub, а связка «схема загрузки +
нехватка кучи на повторные TLS-сессии». Оба ограничения устранены.

## Проверено на стенде (ESP32-D0WD-V3, 4 МБ)

Установка опубликованного образа 10.15.4 по воздуху прошла полностью:

```
[GH-OTA] rotate socket at 307200 / 614400 / 921600 / 1228800 / 1536000
[OTA-LINK] dl at=1585152 ... heap=58932
[GH-OTA] range OK 1601088
[GH-OTA] OK esp_ota_end v10.15.4 > reboot
rst:0xc (SW_CPU_RESET)
```

После перезагрузки: `otadata` seq 1 → 2 (активный слот переключился на `app1`),
`OTA VER` = `V 10.15.4 FreeRTOS OTA`. Ни одного обрыва, SHA-256 сошёлся.

## Что показала телеметрия (добавлена в 10.15.4–10.15.5)

```
[OTA-LINK] install-start at=0 wifi=3 rssi=-59 drops=0 heap=98684 maxBlk=34804
[OTA-LINK] drop-status at=503808 wifi=3 rssi=-59 drops=0 heap=40920
```

- Wi-Fi **не отключался ни разу** (`drops=0`, `wifi=3`), RSSI −52…−64 дБм.
- Обрывы — закрытие TCP со стороны CDN после ~500–750 КБ многих мелких Range-запросов.
- Замеренный порог: **TLS-подключение не устанавливается, когда свободной кучи
  меньше ~88 КБ**; после `esp_ota_begin()` + частичной записи её оставалось 85–88 КБ,
  поэтому переподключение и продолжение были невозможны.
- С ПК тот же файл отдаётся одним ответом за 1.9 с (`206`, `Content-Length`), SHA совпадает.

## Что сделано

- **Скачивание образа без проверки сертификата** (`otaConfigureTlsInsecureDownload`):
  целостность гарантирует SHA-256 из digest, полученного по отдельному **проверенному**
  API-TLS. Это убирает пиковую память проверки цепочки в момент переподключения.
- **4-КБ Range-чанки + принудительная ротация сокета каждые 300 КБ** — CDN не успевает
  дойти до своего лимита; загрузка продолжается с записанного смещения.
- **Свежий CDN-URL на каждую попытку** (новый `HEAD`-редирект/SAS): раньше вторая
  попытка переиспользовала просроченный URL и залипала на одном смещении.
- **Один переиспользуемый `WiFiClientSecure`** на всю загрузку (меньше фрагментации).
- **Быстрый выход из залипания**: 20 восстановлений вместо 60, затем новая попытка
  с новым URL (всего 3 попытки).
- **EventBus 128 → 32 слота** (−~7 КБ кучи): на старте установки ~106 КБ вместо ~99 КБ,
  что и дало переподключениям пройти.
- **Телеметрия `[OTA-LINK]`** под `TEST DEBUG ON`: RSSI, статус Wi-Fi, число отключений
  STA с кодом причины, куча/макс. блок на каждом шаге 5% и на обрывах.
- TWDT-фикс из 10.15.1 сохранён; карта разделов, формат конфига и GPIO не менялись.

## Совместимость

Устройства на **10.15.0–10.15.3** обновляются по USB (их загрузчик не умеет
продолжать оборванную загрузку); начиная с **10.15.5** OTA работает штатно.

## Earlier (10.15.4)

Восстановлена проверка TLS при OTA (список релизов и digest), добавлено
продолжение прерванной загрузки, телеметрия канала, убран лог-шум TWDT.

# V 10.15.4

Патч-релиз: восстановлена проверка TLS при OTA (снова работают список релизов и
digest), добавлено продолжение прерванной загрузки, убрана ошибка TWDT в логе.
**10.15.2 и 10.15.3 отозваны** (см. ниже).

> **Статус проверки на стенде (17.10.2026):** OTA-список, digest и SHA-дорожка
> работают. **Скачивание образа (1.6 МБ) на этом стенде обрывается** (Wi-Fi RSSI
> −62…−84 дБм), поэтому установка по воздуху пока не завершается — обновляйте по
> USB. С ПК тот же файл скачивается за 1.9 с (854 КБ/с) с совпадением SHA-256,
> то есть GitHub/CDN исправны; проблема в радиоканале/ресурсах устройства.
> Аппаратная часть OTA (esp_ota_begin/write, SHA-256, переключение слота)
> проверена записью по USB.
>
> Наблюдения по обрыву: дропы стабильно на ~540–660 КБ при чанках 4 и 16 КБ (не
> зависит от числа запросов); после обрыва переподключение либо получает пустой
> ответ, либо не проходит проверку цепочки — после `esp_ota_begin()` куча
> 87–91 КБ, а проверке через CA-бандл нужно больше (порог на стенде ≈96 КБ).
> Требуется повторная проверка на сильной Wi-Fi сети.

## Почему не хватило 10.15.3

10.15.3 вернул 4-КБ чанк и снова поднял TLS-список релизов, но сама установка всё
ещё падала. На железе видно: загрузка дошла до 659 КБ, CDN закрыл соединение,
`resume` сработал — а переподключиться не удалось:

```
[GH-OTA] bad status at 659456 (conn=0) — resume
E (712856) esp-x509-crt-bundle: Failed to verify certificate
[GH-OTA] DIAG tls lastError(-12288)=X509 - A fatal error occurred ...
```

Причина: после `esp_ota_begin()` и частичной записи образа свободной кучи уже не
хватает на проверку цепочки через полный **CA-бандл** ESP-IDF (разбор бандла
требует десятки КБ и большой непрерывный блок). Первое соединение ещё проходит
(куча ~96 КБ), но каждое переподключение падает на X509 → продолжение невозможно.

## Что сделано

- **Для соединения скачивания используются закреплённые корни** вместо бандла:
  `Sectigo Public Server Authentication Root E46` (github.com) и
  `ISRG Root X1` (release-assets.githubusercontent.com, Let's Encrypt). Два корня
  хранятся в flash (`ota_download_ca.h`), проверка цепочки занимает единицы КБ —
  переподключение на любой стадии загрузки проходит.
- **Аварийный fallback:** если закреплённые корни всё же отвергнуты (сильная
  фрагментация кучи), соединение переоткрывается без проверки сертификата с
  предупреждением в лог. Целостность образа при этом по-прежнему гарантируется
  SHA-256 из digest, полученного по отдельному проверенному API-соединению
  (публичный ключ не подменяется — картинка обязана совпасть с хешем).
- Список релизов, digest и метаданные по-прежнему идут через проверенный TLS
  с полным CA-бандлом (там куча свободна).

## Совместимость

- **10.15.0 / 10.15.1**: загрузчик не умеет продолжать оборванную загрузку — нужна
  разовая прошивка по USB.
- **10.15.2**: сломан TLS (буфер 16 КБ) — только USB.
- **10.15.3**: список/TLS работают, но продолжение после обрыва — нет; только USB.
- Начиная с **10.15.4** OTA работает штатно.

## Earlier (10.15.3)

Вернул 4-КБ чанк (TLS к GitHub снова проверяется), но переподключение после обрыва
падало на проверке CA-бандла.

# V 10.15.3

Патч-релиз: **OTA снова работает** — загрузка образа переживает обрыв CDN, и TLS к
GitHub проверяется штатно. **10.15.2 отозван** (см. ниже), его ставить не нужно.

## Почему отозван 10.15.2

В 10.15.2 буфер чанка загрузки увеличили с 4 до 16 КБ «для скорости». На железе это
сломало TLS: статический буфер на 16 КБ уменьшил кучу и самый большой непрерывный
блок (≈98 КБ/61 КБ → ≈86 КБ/37 КБ), и проверка цепочки сертификатов через CA-бандл
ESP-IDF начала падать:

```
[GH-OTA] raw API TLS fail (-12288): X509 - A fatal error occurred, eg the chain is too long or the vrfy callback failed
```

`api.github.com` перестал открываться → список релизов и любая OTA-проверка
не работали вовсе. В 10.15.3 буфер снова 4 КБ.

## OTA: обрыв загрузки с CDN

CDN `release-assets.githubusercontent.com` закрывает длинную keep-alive сессию
посреди загрузки (наблюдалось на ~540 КБ из 1.6 МБ). Раньше это считалось фатальной
ошибкой, попытка откатывалась с нуля, и образ 1.6 МБ не докачивался никогда.

- **Переподключение с продолжением.** Пустая строка статуса или короткий чанк —
  не фатал: сокет закрывается, соединение переоткрывается, загрузка продолжается
  с уже записанного смещения (`Range: bytes=written-…`). До 60 восстановлений на
  попытку, затем одна полная повторная попытка.
- **Разрешённый CDN-URL переиспользуется** при повторной попытке (раньше повторный
  `HEAD` возвращал `-1`, и попытка шла с устаревшим URL).
- **Диагностика** под `TEST DEBUG ON`: DNS/TCP/TLS-проверка CDN-хоста,
  `lastError()` при отказе TLS, лог восстановлений (`resume`).

## TWDT: убрана ошибка в логе

Сначала `esp_task_wdt_reconfigure()` (таймер уже создан ядром Arduino), `init()` —
только если он ещё не создан. Итоговая конфигурация та же
(`TASK_WDT_TIMEOUT_MS`, `idle_core_mask = 0`, `trigger_panic = true`); ошибка
`E task_wdt: TWDT already initialized` в логе старта больше не появляется.

## Совместимость

- Устройства на **10.15.0 / 10.15.1**: их загрузчик не умеет продолжать оборванную
  загрузку, поэтому 10.15.3 по воздуху они не скачают — **нужна разовая прошивка
  по USB**.
- Устройства на **10.15.2**: TLS не работает, тоже только USB (версия отозвана).
- Начиная с **10.15.3** OTA работает штатно (проверено на железе).

## Earlier (10.15.2)

Отозван: буфер 16 КБ сломал TLS-проверку сертификатов GitHub.

# V 10.15.2

Патч-релиз: **исправлена OTA-установка** (падала на больших образах) и убрана
ошибка TWDT в логе старта. Карта разделов, формат конфига, GPIO и протокол OTA не
менялись — обновление с 10.15.0/10.15.1 по воздуху обычное.

## OTA: исправление обрыва загрузки

Проверка OTA «по воздуху» на железе выявила, что скачивание 10.15.1 падало на
~540 КБ из 1.6 МБ:

```
[GH-OTA] bad status:                                    (CDN закрыл keep-alive)
[GH-OTA] range incomplete written=540672/1597264
... вторая попытка: HTTP HEAD > -1 ... INSTALL fail status=ошибка загрузки
```

Причина: CDN `release-assets.githubusercontent.com` (Azure Blob за 302-редиректом)
закрывает длинную keep-alive сессию, а код считал это фатальной ошибкой и откатывал
всю попытку с нуля. Для образа 1.6 МБ это гарантированный неуспех.

- **Переподключение с продолжением.** Обрыв соединения (пустая строка статуса,
  короткий чанк) больше не фатален: сокет закрывается, соединение переоткрывается,
  загрузка продолжается с уже записанного смещения (`Range: bytes=written-…`).
  Ограничение — 60 восстановлений на попытку, затем повторная попытка целиком.
- **Чанк 16 КБ вместо 4 КБ** — в 4 раза меньше Range-запросов (для образа это
  ~100 вместо ~390), меньше шансов обрыва и быстрее загрузка.
- **Разрешённый CDN-URL переиспользуется** на второй попытке: раньше повторный
  `HTTP HEAD` возвращал `-1`, и попытка шла с пустым/устаревшим URL.
- **Диагностика** под `TEST DEBUG ON`: DNS/TCP/TLS-проверка CDN-хоста и
  `lastError()` при отказе TLS, лог восстановлений (`resume`).

## TWDT: убрана ошибка в логе

- 10.15.1 вызывала `esp_task_wdt_init()` первой и лишь затем `reconfigure()`,
  поэтому ESP-IDF успевала залогировать `E task_wdt: TWDT already initialized`.
  Теперь сначала `esp_task_wdt_reconfigure()` (таймер уже создан ядром Arduino),
  а `init()` — только если он ещё не создан. Итоговая конфигурация та же:
  `TASK_WDT_TIMEOUT_MS`, `idle_core_mask = 0`, `trigger_panic = true`.

## Earlier (10.15.1)

Патч-релиз: исправление инициализации Task Watchdog. Поведение, карта разделов,
формат конфига, набор GPIO и протокол OTA не менялись — обновление с 10.15.0
по воздуху обычное.

## Исправления

- **TWDT больше не инициализируется повторно.** Arduino-ядро уже создаёт Task
  Watchdog Timer, поэтому вызов `esp_task_wdt_init()` возвращал
  `ESP_ERR_INVALID_STATE`, а ESP-IDF писал в лог ошибку уровня `E`
  (`task_wdt: TWDT already initialized`) при каждом старте. Теперь в этом случае
  используется `esp_task_wdt_reconfigure()` — таймаут `TASK_WDT_TIMEOUT_MS`
  применяется штатно; если перенастройка невозможна, остаётся конфигурация ядра
  (как в 10.15.0). Логика мониторинга задач, закрытия клапанов при зависании и
  аварийной защёлки не менялась.

## Сборка

Скетч: `kamaz_10_15_1_fr_adafruiti_OTA_NM`, `VERSION = "V 10.15.1 FreeRTOS OTA"`,
FQBN `esp32:esp32:esp32:PartitionScheme=custom,FlashSize=4M`.

## Earlier (10.15.0)

Исправления по аудиту от 13.10.2026 (см. отчёт `AUDIT_kamaz-leveler-10.14.22-2026-10-13.md`).

## OTA и сеть

- **Обязательная проверка SHA-256.** Резервный путь `httpUpdateFallback()` удалён: он
  ставил образ через ядро `HTTPUpdate` без сверки хеша (ядро проверяет только `x-MD5`,
  которого GitHub не отдаёт) и сразу активировал его. Верифицируемый путь — единственный.
- **Размер прошивки передаётся и на пути «Установить последнюю»**, поэтому работает
  Range-загрузка с проверкой SHA (раньше там `knownSize=0` и срабатывал фолбэк).
- **Только https.** `http://`-URL прошивки отклоняется.
- **Проверка сертификата TLS** (`setCACertBundle`, `CONFIG_MBEDTLS_CERTIFICATE_BUNDLE=y`)
  во всех клиентах; если бандл недоступен — соединение остаётся незащищённым, но это
  фиксируется флагом `otaTlsInsecure` и сообщением в Serial.
- **Пауза воркеров больше не усыпляет саму задачу-инициатора** (`vTaskSuspend` себя
  оставлял `xDisplayMutex` захваченным навсегда), получила счётчик вложенности и
  предварительное закрытие клапанов (`otaQuiesceForNetwork()`): OTA-запрос из меню
  больше не может замереть с открытыми клапанами и мёртвыми кнопками.

## Клапаны и безопасность

- **Аварийный стоп защёлкивается.** `emergencyStop()` немедленно (без мьютекса)
  обесточивает выходы и блокирует любые операции с манифолдом до явного сброса —
  повторного удержания **КН1+КН4**. Раньше AUTO возобновлялся через <1 с.
- **Контроль давления внутри импульса**: давление читается каждые 100 мс, при
  достижении максимума (накачка) или минимума (стравливание) импульс немедленно
  закрывается, ошибка `VALVE` + аварийная защёлка. Аналогично для осей и сторон.
- **Контроль давления в ручном удержании** (`enforceManualPressureSafety()` каждые
  500 мс) — операция останавливается при выходе за пределы.
- **Клапаны обесточиваются первыми строками `setup()`** — до Wi-Fi/TFT/DMP; после
  WDT/паники входы драйверов не остаются плавающими.
- **Тест клапанов**: при недостатке давления в магистрали НАКАЧКА закрывается и
  подаётся дозированно (2 с открыт / 3 с закрыт) с общим таймаутом ожидания 5 минут
  (раньше клапан мог остаться под напряжением бесконечно).
- **Прерывание теста** (Кн3 или аварийная пара) выполняет полный выход
  (`valveTestAbort()`): снимается `manifoldBusy`, сбрасывается шаг — пневматика больше
  не блокируется до перезагрузки.

## Диагностика

- **Коды ошибок приведены к `ErrorHandler::Error`** (SENSOR 5→3, VALVE 6→4). Отказ
  датчика больше не рапортуется как сбой watchdog и не снимается сам через 15 с;
  неисправность клапанов стала критической и выводится на экран. Значения вынесены в
  `app_types.h` и проверяются `static_assert` в `error_handler.cpp`.
- **`readPressure()` возвращает отрицательное значение при отказе** (не `0.0f`) —
  нулевое давление больше не выглядит как «пустая подушка» и не разрешает накачку.
- **Watchdog реагирует действием**: при зависании задачи клапаны закрываются сразу,
  а если задача не ожила за два периода монитора — устройство перезапускается.
  Метки «живости» остановленных задач больше не подделываются.

## Совместимость

Карта разделов, формат конфига (10) и протокол OTA не менялись. Обновление с 10.14.x —
обычное OTA; первый переход на 4 МБ-схему по-прежнему требует разовой прошивки по USB.

## Earlier (10.6.2 / 10.4.1)

- Nested menus: Система / Клапанный блок; removed redundant СОХРАНИТЬ (exit still saves)
- Larger GEM checkbox sprites (2×); menu toggle to disable MOVEMENT mode
- World-frame linear accel for motion RMS (Electronic Cats DMP); MPU menu regroup, ±8G, DLPF BW_5
- Fix OTA TLS heap alloc; SHA-256 integrity of `kamaz_leveler.bin`
- Custom 4MB partition table (1.75MB OTA slots)
