timurufa86/kamaz_leveler/hardware/production/schematic.pdf

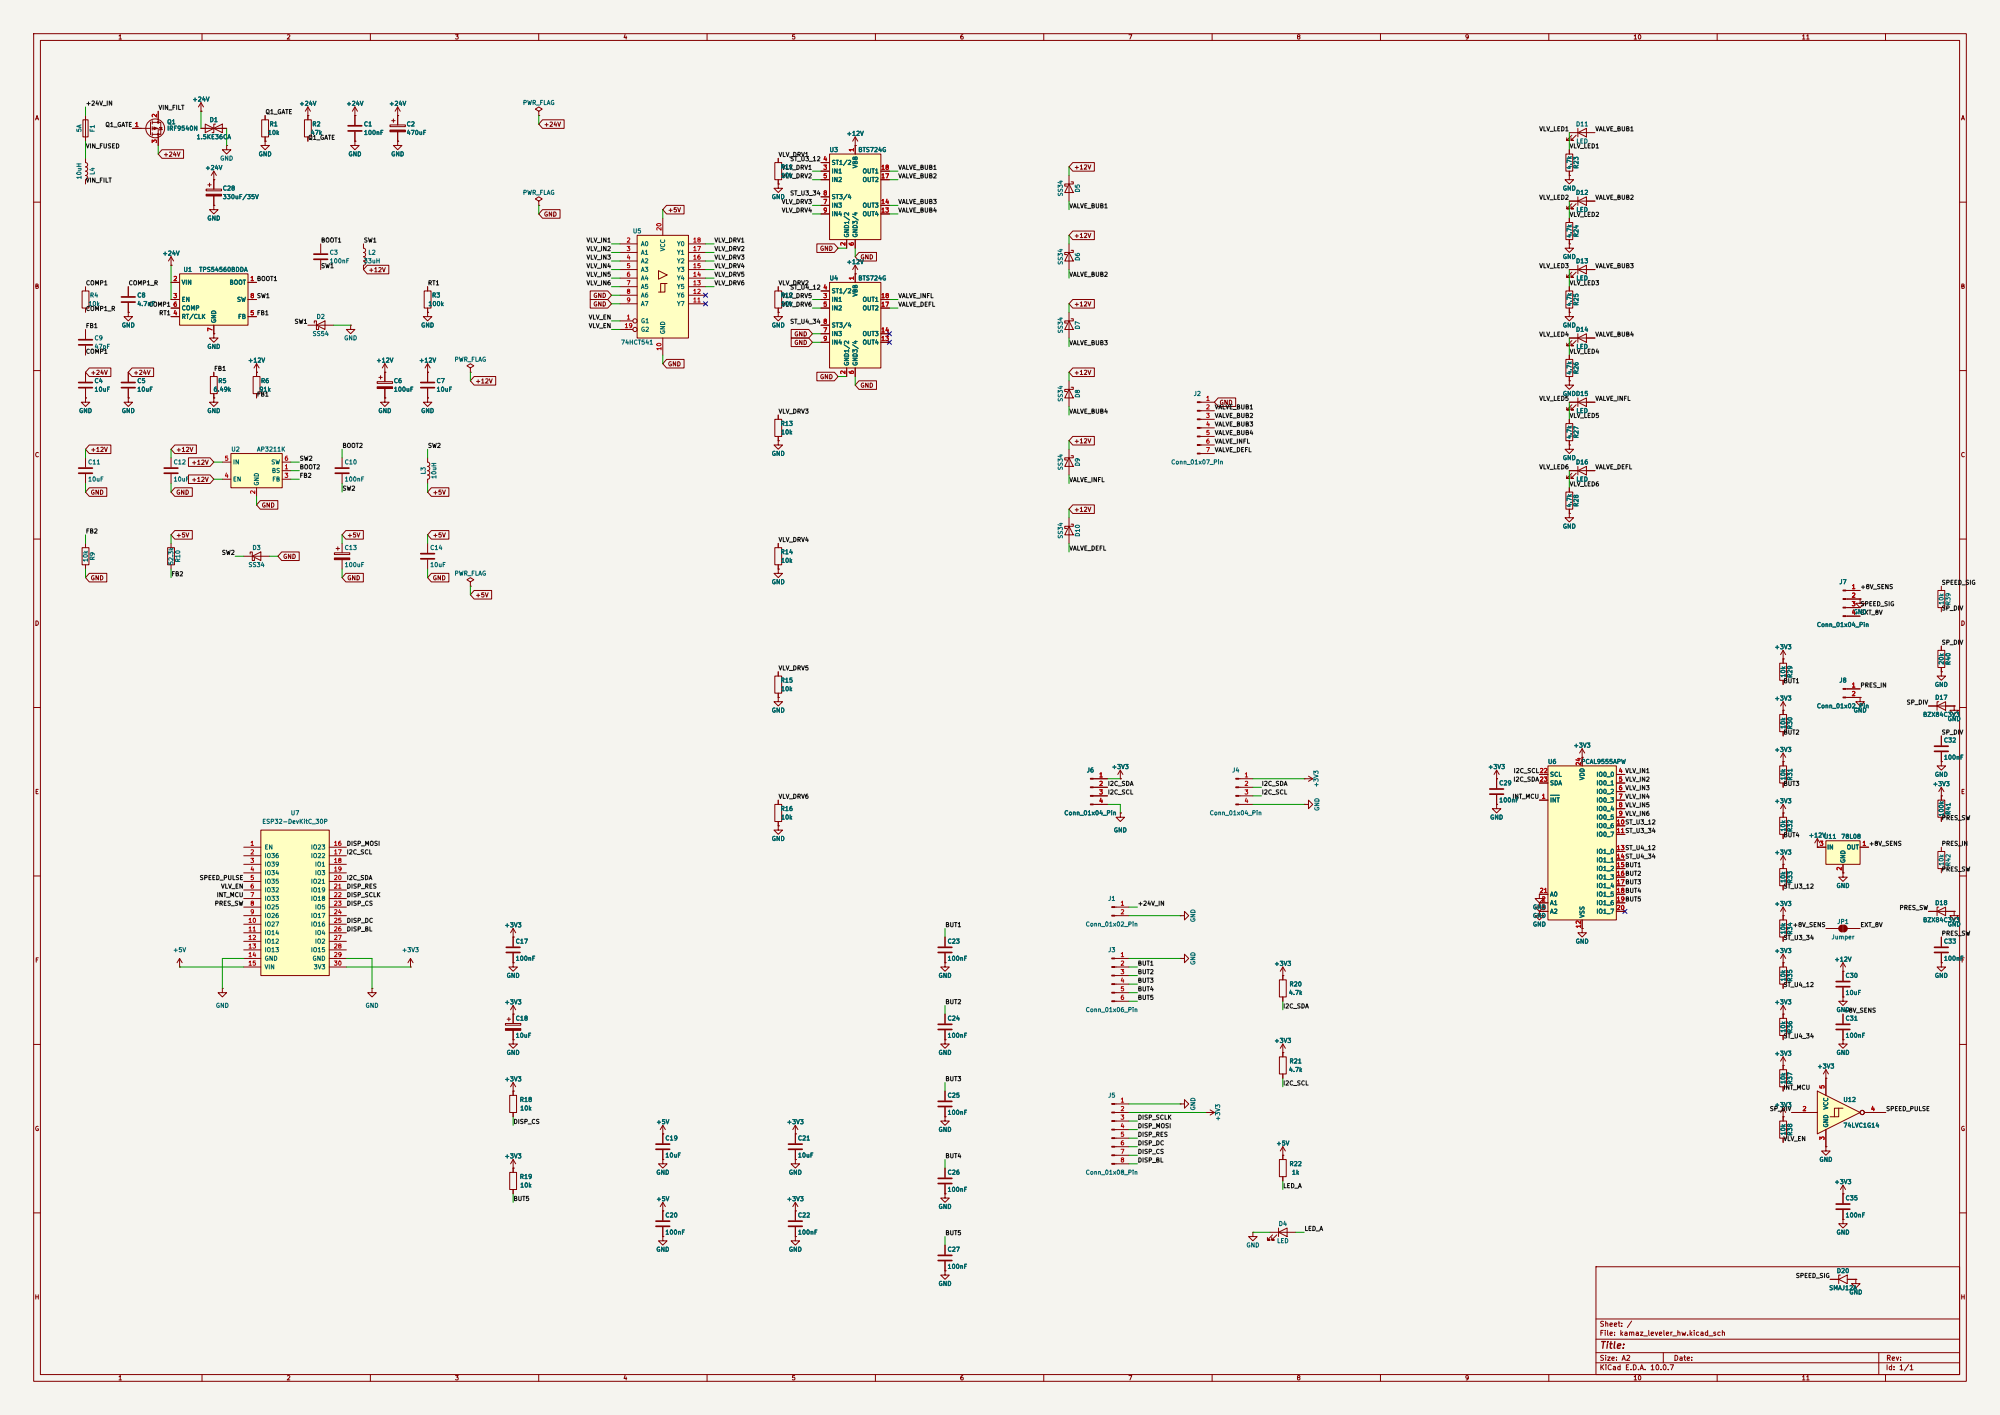
[picture p14: page 1]

Size: A2 | Rev:
KiCad E.D.A. 10.0.7 | Id: 1/1
