timurufa86/kamaz_leveler/hardware/production/board.pdf

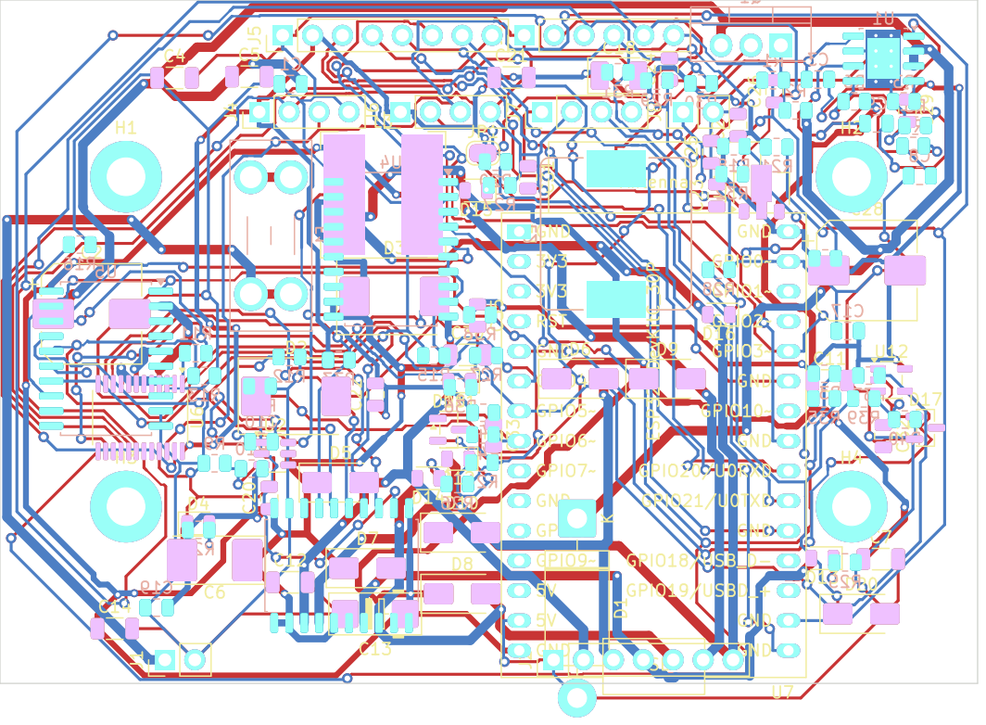
[picture p15: page 1]
