timurufa86/kamaz_leveler/hardware/kicad/kamaz_leveler_hw.kicad_pcb

## KiCad design hardware/kicad/kamaz_leveler_hw.kicad_pcb (2026-11-04)

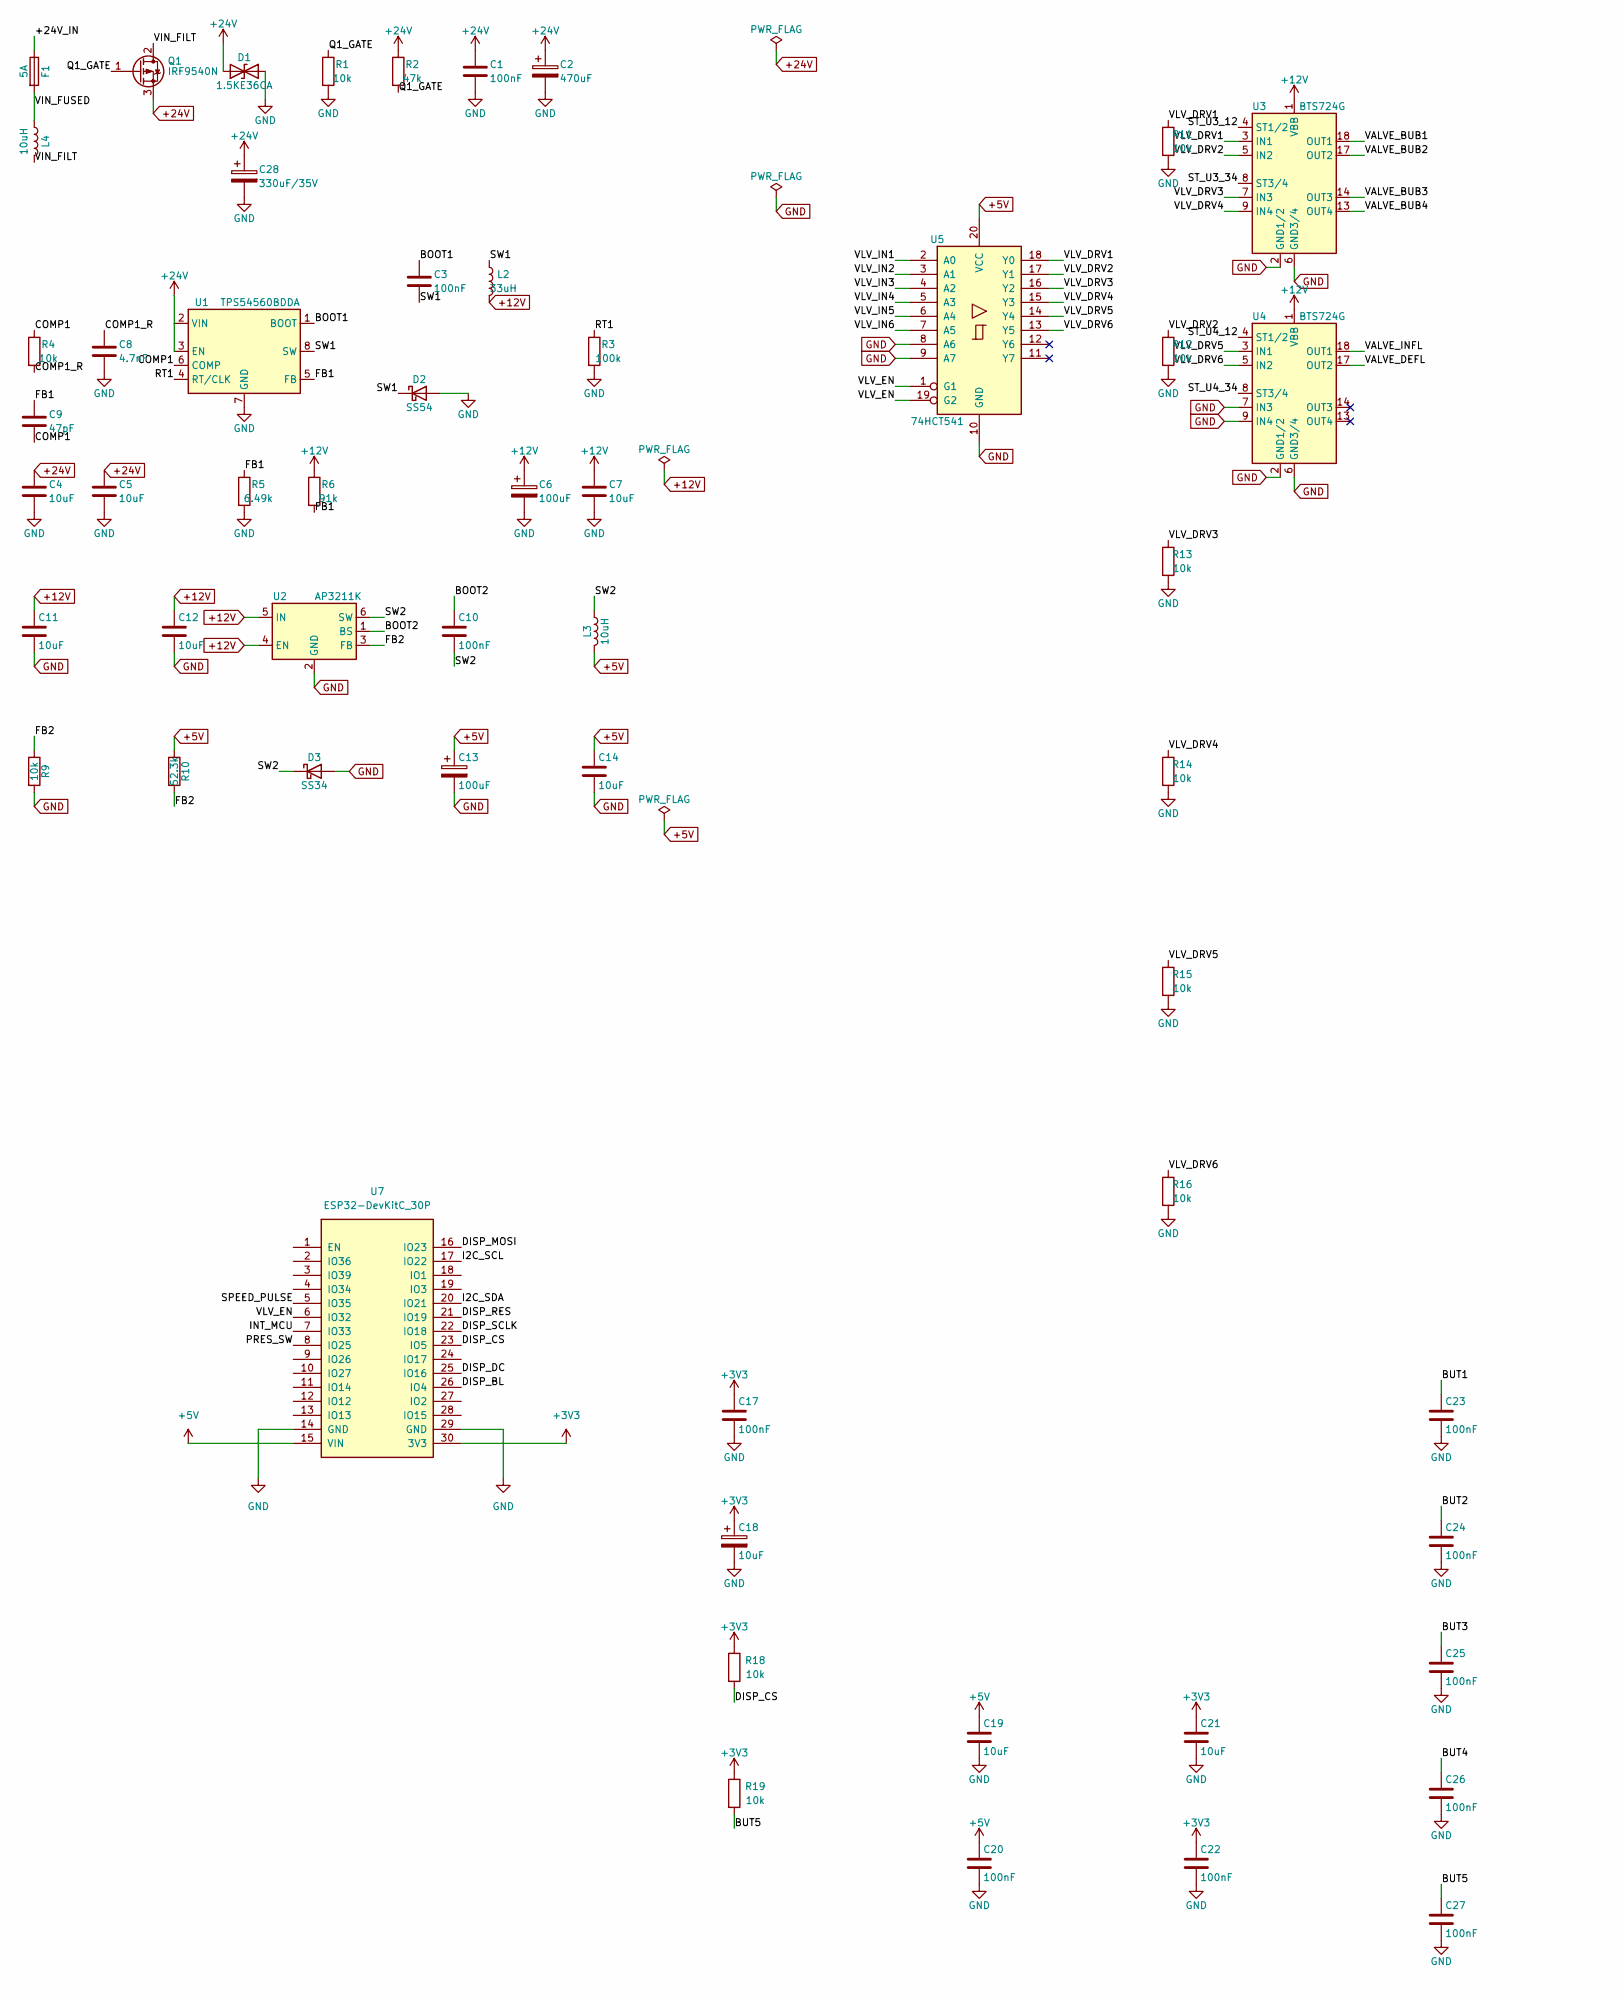
[picture p16: schematic kamaz_leveler_hw.kicad_sch, part in row 1, column 1]

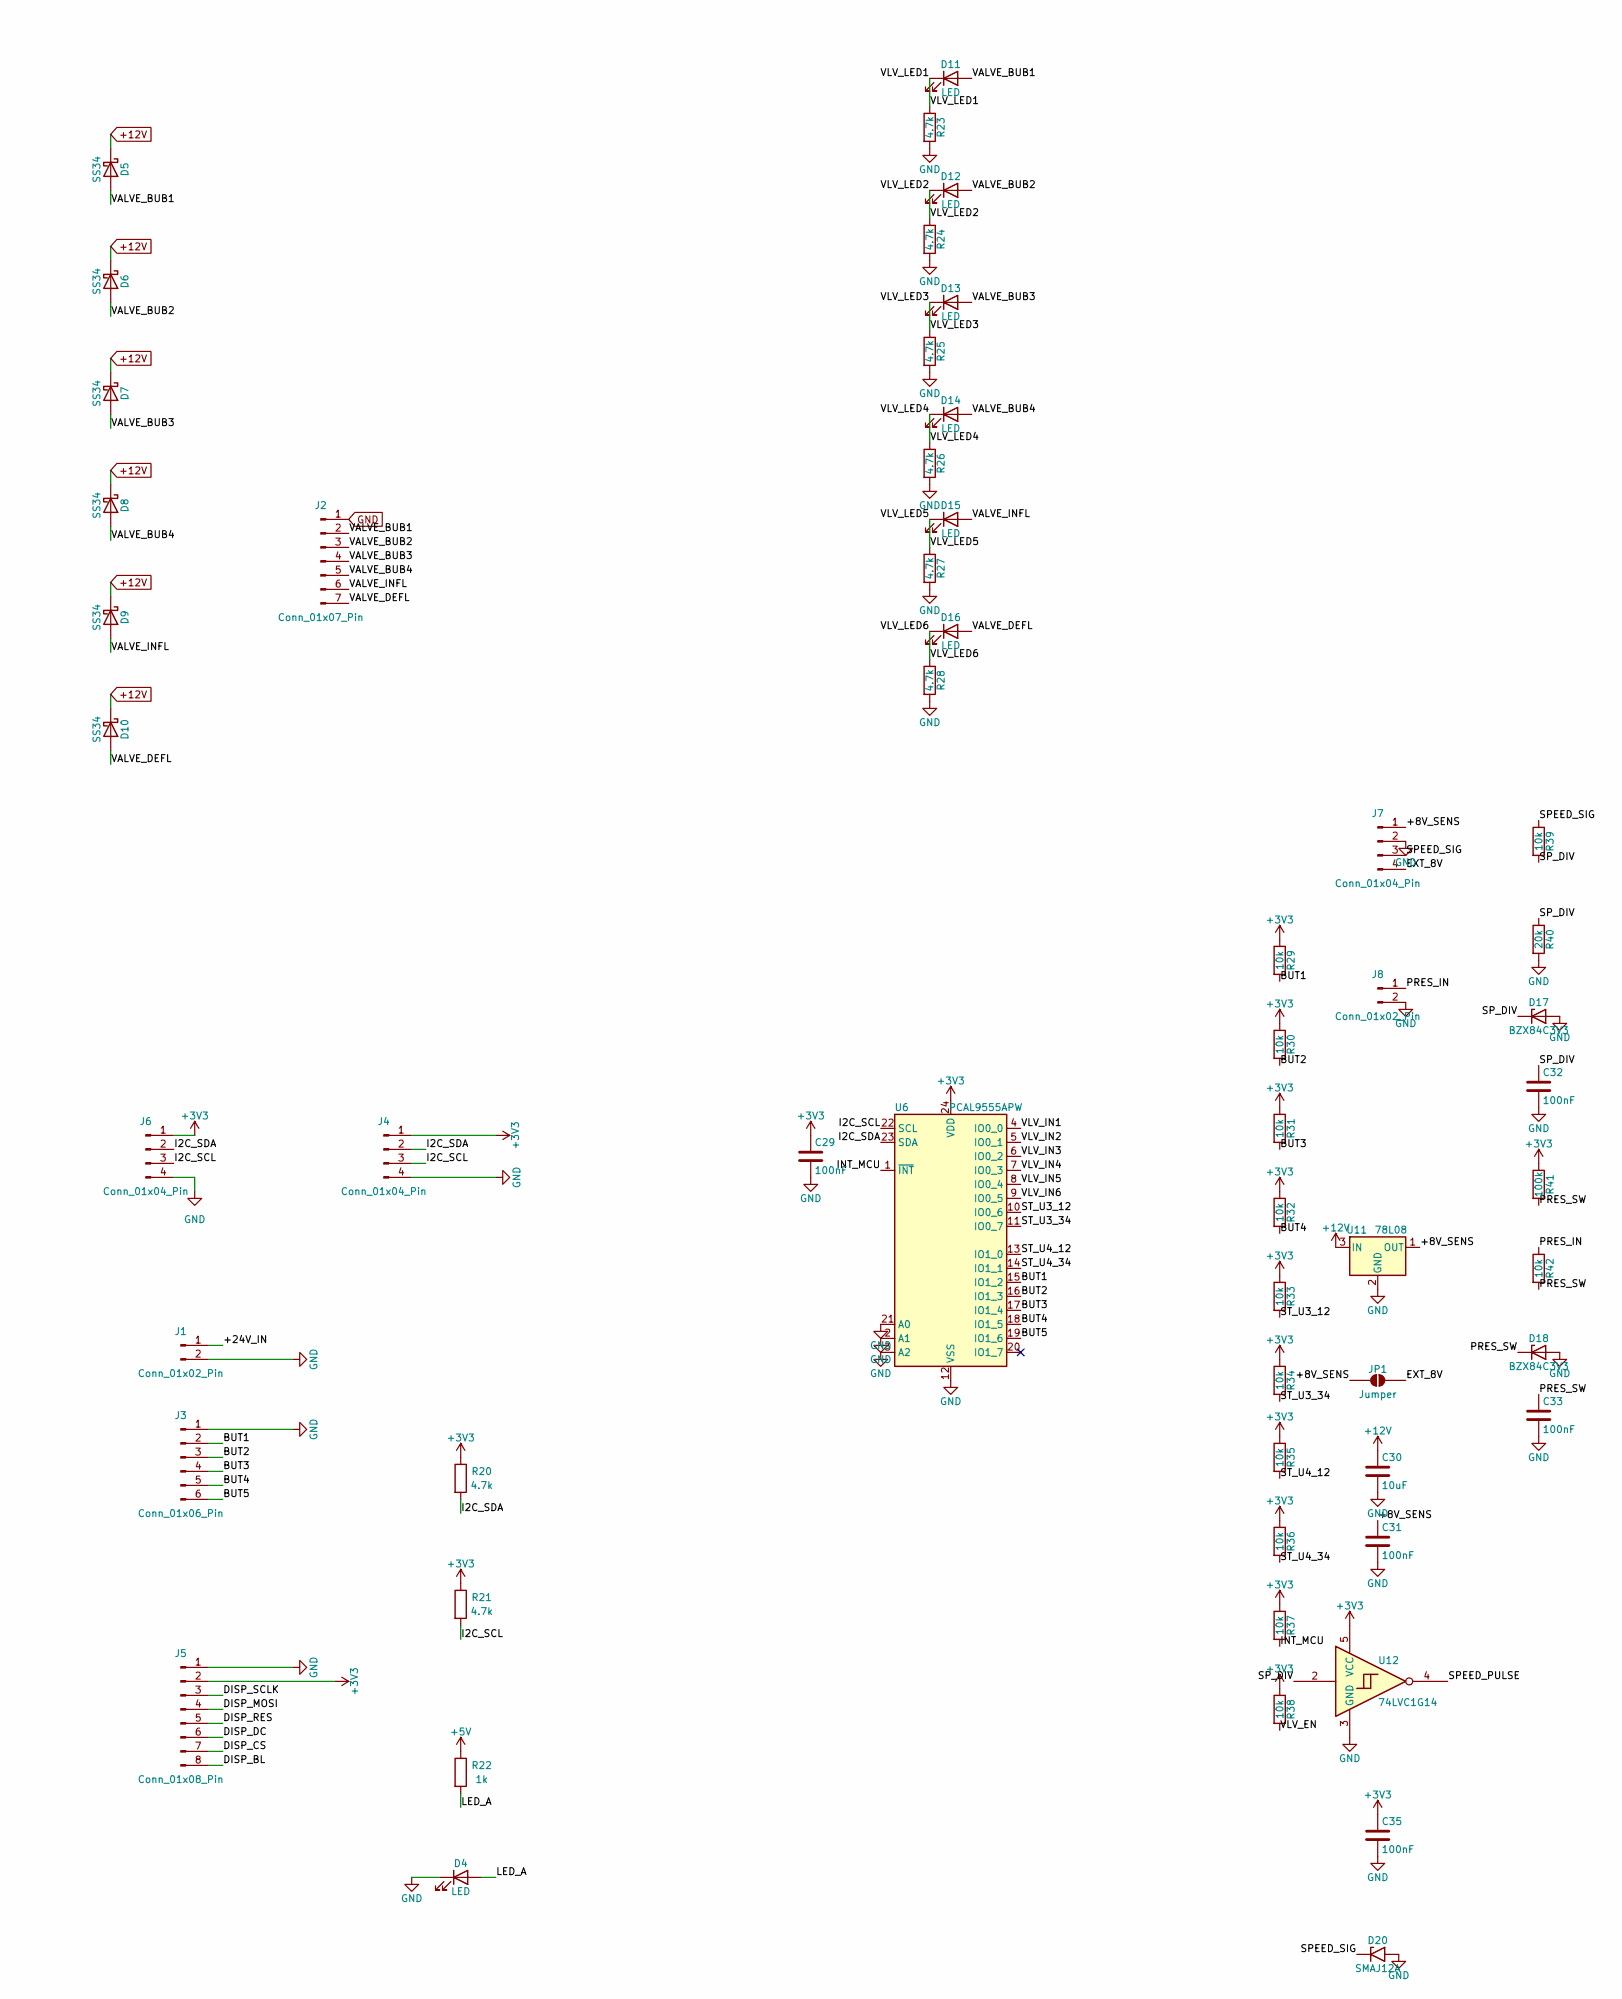
[picture p17: schematic kamaz_leveler_hw.kicad_sch, part in row 1, column 2]

Parts:
C1, C3, C10, C17, C20, C22, C23, C24, C25, C26, C27, C29, C31, C32, C33, C35: 100nF; C_0805_2012Metric
C2: 470uF; CP_Elec_8x10
C4, C5, C7, C11, C12, C14, C21, C30: 10uF; C_1206_3216Metric
C6: 100uF; CP_EIA-7132-20_AVX-U
C8: 4.7nF; C_0805_2012Metric
C9: 47pF; C_0805_2012Metric
C13: 100uF; CP_EIA-6032-15_Kemet-U_Pad2.25x2.35mm_HandSolder
C18: 10uF; CP_EIA-3528-12_Kemet-T_HandSolder
C19: 10uF; C_0805_2012Metric
C28: 330uF/35V; CP_Elec_8x10
D1: 1.5KE36CA; D_DO-201AD_P15.24mm_Horizontal
D2: SS54; D_SMC
D3: SS34; D_SMC
D4, D11, D12, D13, D14, D15, D16: LED; LED_0805_2012Metric
D5, D6, D7, D8, D9, D10: SS34; D_SMA
D17, D18: BZX84C3V3; SOT-23
D20: SMAJ12A; D_SMA
F1: 5A; Fuseholder_Blade_Mini_Keystone_3568
J1, J8: Conn_01x02_Pin; PinHeader_1x02_P2.54mm_Vertical
J2: Conn_01x07_Pin; PinHeader_1x07_P2.54mm_Vertical
J3: Conn_01x06_Pin; PinHeader_1x06_P2.54mm_Vertical
J4, J6, J7: Conn_01x04_Pin; PinHeader_1x04_P2.54mm_Vertical
J5: Conn_01x08_Pin; PinHeader_1x08_P2.54mm_Vertical
JP1: Jumper; SolderJumper-2_P1.3mm_Open_RoundedPad1.0x1.5mm
L2: 33uH; L_Bourns_SRP1245A
L3: 10uH; L_Bourns-SRN1060
L4: 10uH; L_Bourns_SRP1245A
Q1: IRF9540N; TO-220-3_Vertical
R1, R4, R9, R11, R12, R13, R14, R15, R16, R18, R19, R29, R30, R31, R32, R33, R34, R35, R36, R37, R38, R39, R42: 10k; R_0805_2012Metric
R2: 47k; R_0805_2012Metric
R3, R41: 100k; R_0805_2012Metric
R5: 6.49k; R_0805_2012Metric
R6: 91k; R_0805_2012Metric
R10: 52.3k; R_0805_2012Metric
R20, R21, R23, R24, R25, R26, R27, R28: 4.7k; R_0805_2012Metric
R22: 1k; R_0805_2012Metric
R40: 20k; R_0805_2012Metric
U1: TPS54560BDDA; SOIC-8-1EP_3.9x4.9mm_P1.27mm_EP2.95x4.9mm_Mask2.71x3.4mm_Th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
U2: AP3211K; SOT-23-6
U3, U4: BTS724G; Infineon_SOIC-20W_7.6x12.8mm_P1.27mm
U5: 74HCT541; SOIC-20W_7.5x12.8mm_P1.27mm
U6: PCAL9555APW; TSSOP-24_4.4x7.8mm_P0.65mm
U7: ESP32-DevKitC_30P; ESP32-C3-DevKitC-02
U11: 78L08; SOT-89-3
U12: 74LVC1G14; SOT-23-5

Connections:
+3V3: C17.1, C18.1, C21.1, C22.1, C29.1, C35.1, J4.1, J5.2, J6.1, R18.1, R19.1, R20.1, R21.1, R29.1, R30.1, R31.1, R32.1, R33.1, R34.1, R35.1, R36.1, R37.1, R38.1, R41.1, U6.24 (VDD), U7.30 (3V3), U12.5 (VCC)
+5V: C13.1, C14.1, C19.1, C20.1, L3.2, R10.1, R22.1, U5.20 (VCC), U7.15 (VIN)
+12V: C6.1, C7.1, C11.1, C12.1, C30.1, D5.1 (K), D6.1 (K), D7.1 (K), D8.1 (K), D9.1 (K), D10.1 (K), L2.2, R6.1, U2.4 (EN), U2.5 (IN), U3.1 (VBB), U3.10 (VBB), U3.11 (VBB), U3.12 (VBB), U3.15 (VBB), U3.16 (VBB), U3.19 (VBB), U3.20 (VBB), U4.1 (VBB), U4.10 (VBB), U4.11 (VBB), U4.12 (VBB), U4.15 (VBB), U4.16 (VBB), U4.19 (VBB), U4.20 (VBB), U11.3 (IN)
+24V: C1.1, C2.1, C4.1, C5.1, C28.1, D1.1 (A1), Q1.3 (S), R2.1, U1.2 (VIN), U1.3 (EN)
/+8V_SENS: C31.1, J7.1, JP1.1 (A), U11.1 (OUT)
/+24V_IN: F1.1, J1.1
/BOOT1: C3.1, U1.1 (BOOT)
/BOOT2: C10.1, U2.1 (BS)
/BUT1: C23.1, J3.2, R29.2, U6.15 (IO1_2)
/BUT2: C24.1, J3.3, R30.2, U6.16 (IO1_3)
/BUT3: C25.1, J3.4, R31.2, U6.17 (IO1_4)
/BUT4: C26.1, J3.5, R32.2, U6.18 (IO1_5)
/BUT5: C27.1, J3.6, R19.2, U6.19 (IO1_6)
/COMP1: C9.2, R4.1, U1.6 (COMP)
/COMP1_R: C8.1, R4.2
/DISP_BL: J5.8, U7.26 (IO4)
/DISP_CS: J5.7, R18.2, U7.23 (IO5)
/DISP_DC: J5.6, U7.25 (IO16)
/DISP_MOSI: J5.4, U7.16 (IO23)
/DISP_RES: J5.5, U7.21 (IO19)
/DISP_SCLK: J5.3, U7.22 (IO18)
/EXT_8V: J7.4, JP1.2 (B)
/FB1: C9.1, R5.1, R6.2, U1.5 (FB)
/FB2: R9.1, R10.2, U2.3 (FB)
/I2C_SCL: J4.3, J6.3, R21.2, U6.22 (SCL), U7.17 (IO22)
/I2C_SDA: J4.2, J6.2, R20.2, U6.23 (SDA), U7.20 (IO21)
/INT_MCU: R37.2, U6.1 (~INT), U7.7 (IO33)
/LED_A: D4.2 (A), R22.2
/PRES_IN: J8.1, R42.1
/PRES_SW: C33.1, D18.1 (K), R41.2, R42.2, U7.8 (IO25)
/Q1_GATE: Q1.1 (G), R1.1, R2.2
/RT1: R3.1, U1.4 (RT/CLK)
/SPEED_PULSE: U7.5 (IO35), U12.4
/SPEED_SIG: D20.1 (A1), J7.3, R39.1
/SP_DIV: C32.1, D17.1 (K), R39.2, R40.1, U12.2
/ST_U3_12: R33.2, U3.4 (ST1/2), U6.10 (IO0_6)
/ST_U3_34: R34.2, U3.8 (ST3/4), U6.11 (IO0_7)
/ST_U4_12: R35.2, U4.4 (ST1/2), U6.13 (IO1_0)
/ST_U4_34: R36.2, U4.8 (ST3/4), U6.14 (IO1_1)
/SW1: C3.2, D2.1 (K), L2.1, U1.8 (SW)
/SW2: C10.2, D3.1 (K), L3.1, U2.6 (SW)
/VALVE_BUB1: D5.2 (A), D11.2 (A), J2.2, U3.18 (OUT1)
/VALVE_BUB2: D6.2 (A), D12.2 (A), J2.3, U3.17 (OUT2)
/VALVE_BUB3: D7.2 (A), D13.2 (A), J2.4, U3.14 (OUT3)
/VALVE_BUB4: D8.2 (A), D14.2 (A), J2.5, U3.13 (OUT4)
/VALVE_DEFL: D10.2 (A), D16.2 (A), J2.7, U4.17 (OUT2)
/VALVE_INFL: D9.2 (A), D15.2 (A), J2.6, U4.18 (OUT1)
/VIN_FILT: L4.2, Q1.2 (D)
/VIN_FUSED: F1.2, L4.1
/VLV_DRV1: R11.1, U3.3 (IN1), U5.18 (Y0)
/VLV_DRV2: R12.1, U3.5 (IN2), U5.17 (Y1)
/VLV_DRV3: R13.1, U3.7 (IN3), U5.16 (Y2)
/VLV_DRV4: R14.1, U3.9 (IN4), U5.15 (Y3)
/VLV_DRV5: R15.1, U4.3 (IN1), U5.14 (Y4)
/VLV_DRV6: R16.1, U4.5 (IN2), U5.13 (Y5)
/VLV_EN: R38.2, U5.1 (G1), U5.19 (G2), U7.6 (IO32)
/VLV_IN1: U5.2 (A0), U6.4 (IO0_0)
/VLV_IN2: U5.3 (A1), U6.5 (IO0_1)
/VLV_IN3: U5.4 (A2), U6.6 (IO0_2)
/VLV_IN4: U5.5 (A3), U6.7 (IO0_3)
/VLV_IN5: U5.6 (A4), U6.8 (IO0_4)
/VLV_IN6: U5.7 (A5), U6.9 (IO0_5)
/VLV_LED1: D11.1 (K), R23.1
/VLV_LED2: D12.1 (K), R24.1
/VLV_LED3: D13.1 (K), R25.1
/VLV_LED4: D14.1 (K), R26.1
/VLV_LED5: D15.1 (K), R27.1
/VLV_LED6: D16.1 (K), R28.1
GND: C1.2, C2.2, C4.2, C5.2, C6.2, C7.2, C8.2, C11.2, C12.2, C13.2, C14.2, C17.2, C18.2, C19.2, C20.2, C21.2, C22.2, C23.2, C24.2, C25.2, C26.2, C27.2, C28.2, C29.2, C30.2, C31.2, C32.2, C33.2, C35.2, D1.2 (A2), D2.2 (A), D3.2 (A), D4.1 (K), D17.2 (A), D18.2 (A), D20.2 (A2), J1.2, J2.1, J3.1, J4.4, J5.1, J6.4, J7.2, J8.2, R1.2, R3.2, R5.2, R9.2, R11.2, R12.2, R13.2, R14.2, R15.2, R16.2, R23.2, R24.2, R25.2, R26.2, R27.2, R28.2, R40.2, U1.7 (GND), U1.9 (GND), U2.2 (GND), U3.2 (GND1/2), U3.6 (GND3/4), U4.2 (GND1/2), U4.6 (GND3/4), U4.7 (IN3), U4.9 (IN4), U5.8 (A6), U5.9 (A7), U5.10 (GND), U6.2 (A1), U6.3 (A2), U6.12 (VSS), U6.21 (A0), U7.14 (GND), U7.29 (GND), U11.2 (GND), U12.3 (GND)

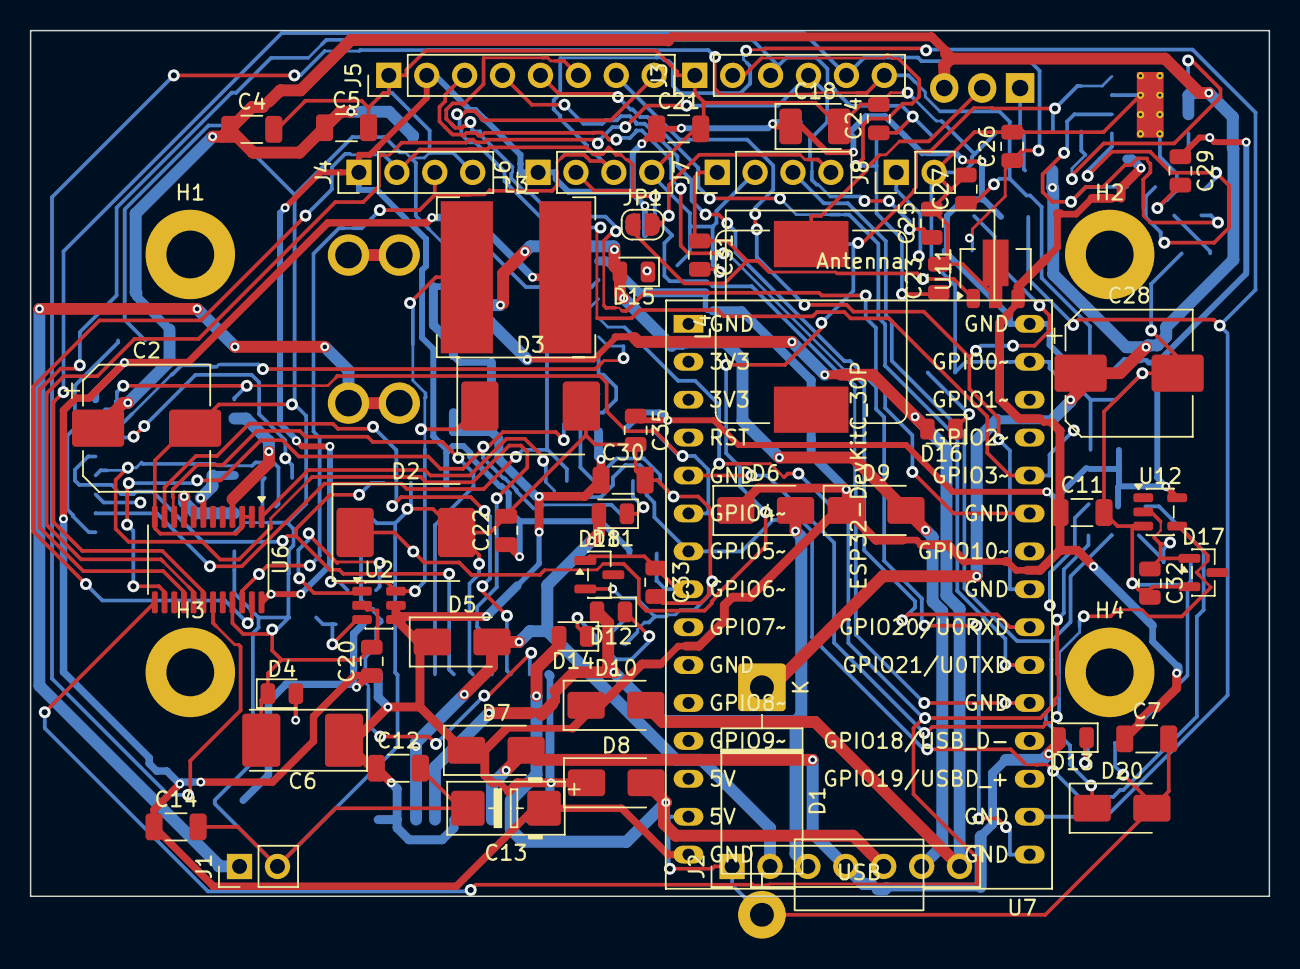
[picture p18: board kamaz_leveler_hw.kicad_pcb from above]

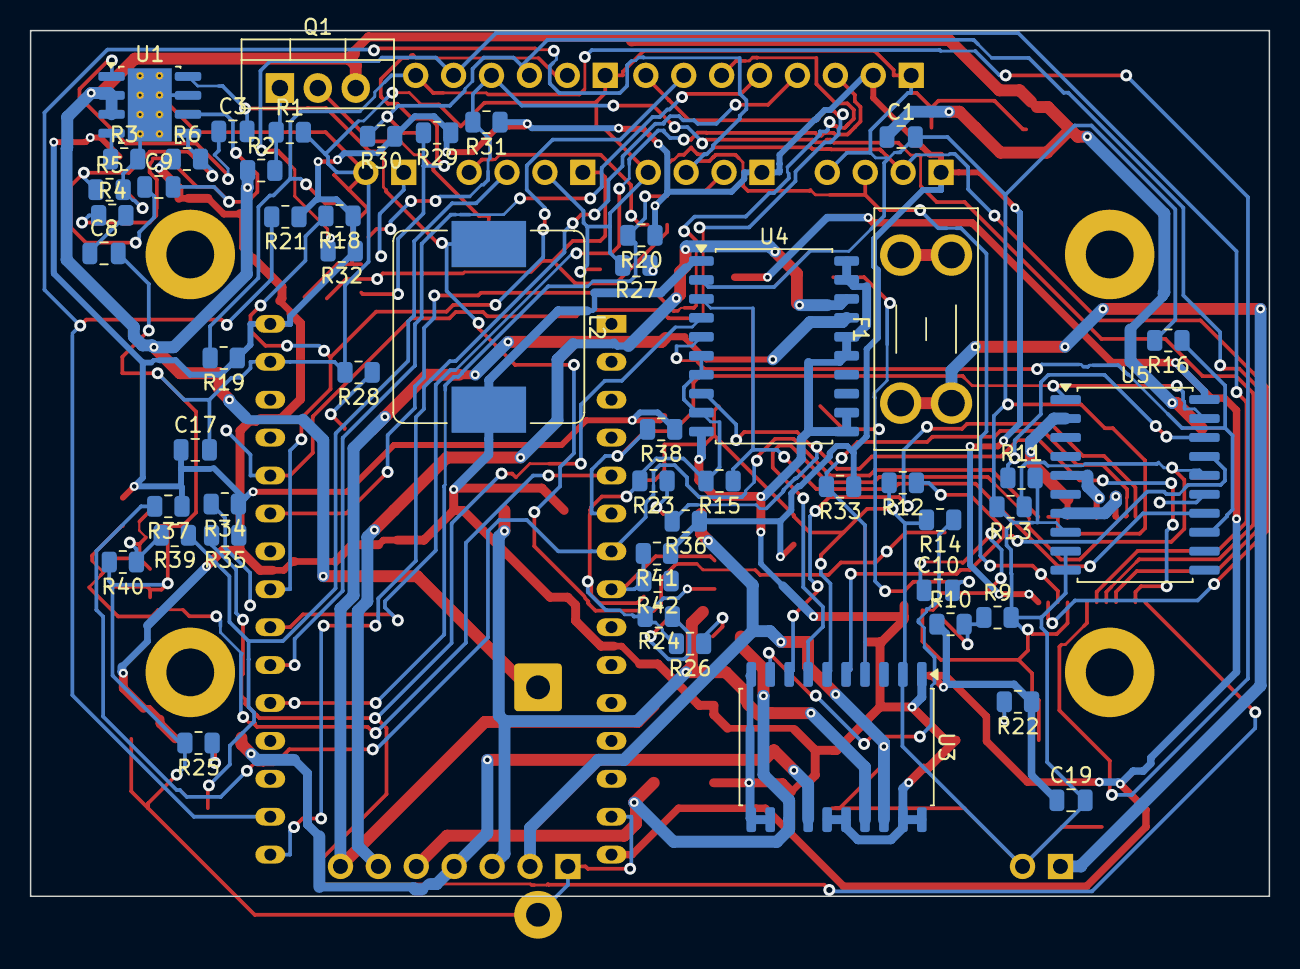
[picture p19: board kamaz_leveler_hw.kicad_pcb from below]

Board: 2 copper layers, 83.0 x 58.0 mm, 117 parts (53 on the bottom side), 69 nets.

Other parts of the board:
H1, H2, H3, H4: MountingHole; MountingHole_3.2mm_M3_Pad6
