timurufa86/kamaz_leveler/kamaz_8_9_0_fr_adafruiti_OTA_NM/kamaz_8_9_0_fr_adafruiti_OTA_NM.ino

/****************************************************************************************
 *  Kamaz-Leveler - FreeRTOS + OTA (версия 8.7.0)
 *  Оптимизации: RAII мьютексы, EventBus, TaskPool, улучшенная обработка ошибок
 *  Типографика: U8g2_for_Adafruit_GFX (модули ui_theme.h / ui_fonts.h / ui_text.*)
 *  Меню: вход — удержание пары КН3+КН4 (GPIO15+GPIO17); аварийный стоп — КН4+КН5
 *****************************************************************************************/

#include <Arduino.h>
#include "mutex_guard.h"
#include "semver_utils.h"
#include "github_ota_request.h"
#include "icon.h"
#include "ui_theme.h"    // палитра и сетка UI
#include "ui_fonts.h"    // шрифтовая сетка U8g2
#include "ui_text.h"     // типографский слой (единственный экземпляр: ui)
#include <ArduinoOTA.h>
#include <WiFi.h>
#include <WiFiClientSecure.h>
#include <HTTPClient.h>
#include <Update.h>
#include <LittleFS.h>
#include <ArduinoJson.h>
#include <esp_task_wdt.h>
#include "I2Cdev.h"
#include "MPU6050_6Axis_MotionApps20.h"
#include <GyverFilters.h>
#include <Adafruit_GFX.h>
#include <Adafruit_ST7789.h>
#include <Adafruit_ADS1X15.h>
#include <U8g2_for_Adafruit_GFX.h>   // типографика (также включается из ui_fonts.h/ui_text.h)
#include <SPI.h>
#include <EncButton.h>

#include <freertos/FreeRTOS.h>
#include <freertos/task.h>
#include <freertos/semphr.h>
#include <freertos/queue.h>
#include "FontsRus/CourierCyr7.h"   // GFX-шрифты оставлены только для GEM-меню
#include "FontsRus/CourierCyr9.h"

#include <esp_heap_caps.h>
#include <cstring>
#include <cstdlib>
#include <mbedtls/sha256.h>
#include <GEM_adafruit_gfx.h>

// Forward declaration
class ErrorHandler;

/* ====================  РЕЖИМЫ СИМУЛЯЦИИ ==================== */
#define ENABLE_MPU6050 1
#define ENABLE_SIMULATION 0
#define SIMULATE_AUTO_MODE 0
#define SIMULATE_ERRORS 0
#define SIMULATE_MENU_AUTO_ENTER 0
#define DEBUG_PRINT 0
#define DEBUG_STACK 0

#define EB_NO_FOR
#define EB_NO_CALLBACK
#define EB_NO_COUNTER
#define EB_NO_BUFFER

#define EB_DEB_TIME 50
#define EB_CLICK_TIME 500
#define EB_HOLD_TIME 600
#define EB_STEP_TIME 200

//const uint8_t PAD_COUNT = 4;
#define PAD_COUNT 4

bool adsInitialized = false;  // флаг готовности ADS1015

/* ====================  КОНСТАНТЫ ==================== */
constexpr int16_t SCREEN_WIDTH = 320;
constexpr int16_t SCREEN_HEIGHT = 240;

constexpr uint32_t DISPLAY_UPDATE_INTERVAL_MS = 50;

/* ====================  НАСТРОЙКИ МЕНЮ ====================  ST77XX_WHITE */
constexpr uint8_t MENU_COLS = 60;          // символов в строке
constexpr uint8_t MENU_ROWS = 9;           // строк на экране (240/24 ≈ 10)
constexpr uint8_t MENU_TOP_OFFSET = 14;    // отступ сверху
constexpr uint8_t MENU_LEFT_PADDING = 15;  // отступ слева (для внешних панелей)
constexpr uint8_t ROW_HEIGHT = 22;         // высота строки (важно!)
constexpr uint8_t CURSOR_WIDTH = 2;
// Колонка значений в меню GEM. Раньше сюда ошибочно ставился MENU_LEFT_PADDING (15),
// из-за чего длина заголовка считалась как (15-5)/6 = 1 символ и подписи пунктов
// обрезались до одной буквы. 150 px даёт 24 символа заголовка и 27 символов значения.
constexpr uint8_t MENU_VALUES_LEFT_OFFSET = 150;

/* ====================  КОМБИНАЦИИ КНОПОК ====================
 *  Меню открывается удержанием ПАРЫ кнопок «КН3 + КН4» (GPIO15 + GPIO17)
 *  из любого режима и экрана. Аварийная остановка — удержание пары
 *  «КН4 + КН5» (GPIO17 + GPIO34); она обрабатывается первой и подавляет меню.
 */
constexpr uint32_t MENU_COMBO_HOLD_MS = 2000;      // удержание пары для меню
constexpr uint32_t MENU_COMBO_DEBOUNCE_MS = 50;    // антидребезг пары
constexpr uint32_t EMERGENCY_HOLD_MS = 2000;       // удержание пары для аварийного стопа
constexpr uint16_t MENU_BG_COLOR = ST77XX_BLACK;
constexpr uint16_t MENU_TEXT_COLOR = ST77XX_WHITE;
constexpr uint16_t MENU_SEL_COLOR = ST77XX_BLUE;

/* ====================  НАСТРОЙКИ ТЕСТА ==================== */
constexpr uint32_t TEST_VALVE_OPEN_TIME_MS = 1500;
constexpr uint32_t TEST_STABILIZE_TIME_MS = 500;
constexpr uint32_t TEST_PRESSURE_EQUALIZE_TIME_MS = 3000;
constexpr uint32_t TEST_TIMEOUT_MS = 90000;
constexpr float TEST_MIN_PRESS_FOR_TEST = 0.8f;
constexpr float TEST_ZERO_THRESHOLD = 0.1f;
constexpr float TEST_PRESSURE_CHANGE_THRESHOLD = 0.2f;



/* ====================  ПЕРЕМЕННЫЕ ==================== */
uint32_t uptimeHours = 0;

/* ====================  ПАРАМЕТРЫ ==================== */
constexpr const char *VERSION = "V 8.9.0 FreeRTOS OTA";

/* 8.9.0: предварительное объявление типа — Arduino автогенерирует прототипы функций
   и вставляет их ВЫШЕ первого определения функции в файле, поэтому тип для
   прототипов (MvData — структура данных экрана ДВИЖЕНИЯ) объявляем заранее. */
struct MvData;

/* Пины */
constexpr uint8_t PIN_OLED_SDA = 21;
constexpr uint8_t PIN_OLED_SCL = 22;
constexpr uint8_t PIN_TFT_MOSI = 23;
constexpr uint8_t PIN_TFT_SCLK = 18;
constexpr uint8_t PIN_TFT_CS = 5;
constexpr uint8_t PIN_TFT_DC = 16;
constexpr uint8_t PIN_TFT_RST = 19;
constexpr uint8_t PIN_TFT_BL = 4;

constexpr uint8_t PIN_BUB1 = 32;
constexpr uint8_t PIN_BUB2 = 33;
constexpr uint8_t PIN_BUB3 = 25;
constexpr uint8_t PIN_BUB4 = 26;
constexpr uint8_t PIN_INFL = 27;
constexpr uint8_t PIN_DEFL = 14;

constexpr uint8_t PIN_BUT1 = 13;
constexpr uint8_t PIN_BUT2 = 12;
constexpr uint8_t PIN_BUT3 = 15;
constexpr uint8_t PIN_BUT4 = 17;
// GPIO34 is input-only and has no internal pull-up. Use an external pull-up.
constexpr uint8_t PIN_BUT5 = 34;


// ========== ADS1015 НАСТРОЙКИ ==========
constexpr uint8_t ADS1015_ADDRESS = 0x48;        // Адрес по умолчанию
uint8_t adsDetectedAddress = ADS1015_ADDRESS;
constexpr uint8_t ADS1015_PRESSURE_CHANNEL = 0;  // Канал 0 для датчика давления
constexpr float ADS1015_MAX_VOLTAGE = 3.3f;      // Опорное напряжение
constexpr uint16_t ADS1015_MAX_VALUE = 2047;     // 11-битный АЦП (2048 шагов)

/* Параметры времени */
constexpr uint32_t CALIB_TIME_MS = 15000;
constexpr uint32_t MANUAL_MAX_TIME = 10000;
constexpr uint32_t MASTER_PRESSURE_CHECK_INTERVAL_MS = 240000;
constexpr uint32_t MANUAL_PRESSURE_CHECK_INTERVAL_MS = 120000;
constexpr uint32_t LEVELING_ATTEMPT_COOLDOWN_MS = 3600000;
constexpr uint32_t PRESSURE_LIMIT_WARNING_DURATION_MS = 5000;
constexpr uint32_t MOVEMENT_PRESSURE_CHECK_INTERVAL_MS = 120000;
constexpr uint32_t MOVEMENT_DURATION_MS = 30000;
constexpr uint32_t MOVEMENT_SETTLE_TIME_MS = 30000;
constexpr float MOVEMENT_PRESSURE_TOLERANCE = 0.2f;
constexpr int GYRO_MOTION_THRESHOLD = 50;
constexpr int ACCEL_MOTION_THRESHOLD = 1000;

/* Переменные для меню */
static int editReleaseDelay;
static int editInflateDelay;
static float editTiltX;
static float editTiltY;
static float editPressureMin;
static float editPressureMax;
static int editNivCount;
static int editTimeInterval;
static int editContrast;
static float editMovementPressureFront;
static float editMovementPressureRear;
static bool settingsChanged = false;

/* ===== 8.8.0: зеркала новых параметров меню ===== */
static int   editMasterCheck;        // период проверки магистрали, с
static int   editManualMaxTime;      // максимальное время ручной операции, с
static float editDeadband;           // зона нечувствительности по давлению, бар
static float editCoarseZone;         // грубая зона авторежима (доля порога)
static float editFineZone;           // точная зона авторежима (доля порога)
static float editWorsening;          // порог «стало хуже» (множитель)
static int   editMoveDuration;       // длительность ожидания движения, с
static int   editMoveSettle;         // время успокоения после движения, с
static int   editMoveCheck;          // период проверки давления после движения, с
static float editMoveTolerance;      // допуск давления после движения, бар
static int   editGyroThreshold;      // порог гироскопа детектора движения
static int   editAccelThreshold;     // порог акселерометра детектора движения
static int   editBacklightOff;       // гашение подсветки, мин (0 = никогда)
static int   editFrameMs;            // интервал кадра дисплея, мс
static float editRedrawAngle;        // порог перерисовки по углу, °
static float editRedrawPressure;     // порог перерисовки по давлению, бар
static int   editImuMotionDet;       // аппаратный порог детектора движения MPU
static float editZeroAngleX;         // программный нуль углов X, °
static float editZeroAngleY;         // программный нуль углов Y, °

/* 8.8.0: обработчик изменения пункта меню со спиннером объявлен НИЖЕ по файлу
   (перед initGEM) — в .ino первое определение функции не должно предшествовать
   объявлению типов/enum'ов и глобальных переменных, иначе автогенерация прототипов
   Arduino вставляет прототипы в начало файла и компиляция падает. */


/* ====================  SPINNER ДЛЯ МЕНЮ ==================== */

// --- Spinner для целых чисел (1-10, шаг 1) ---
GEMSpinnerBoundariesInt spinnerInt1_10 = { .step = 1, .min = 1, .max = 10 };
GEMSpinner spinnerRelease(spinnerInt1_10);  // Вр.СБРОС
GEMSpinner spinnerInflate(spinnerInt1_10);  // Вр.НАКАЧ

// --- Spinner для целых чисел (1-20, шаг 1) ---
GEMSpinnerBoundariesInt spinnerInt1_20 = { .step = 1, .min = 1, .max = 20 };
GEMSpinner spinnerNivCount(spinnerInt1_20);  // Попыток в час

// --- Spinner для целых чисел (1-60, шаг 1) ---
GEMSpinnerBoundariesInt spinnerInt1_60 = { .step = 1, .min = 1, .max = 60 };
GEMSpinner spinnerTimeInterval(spinnerInt1_60);  // Интервал

// --- Spinner для целых чисел (1-100, шаг 1) ---
GEMSpinnerBoundariesInt spinnerInt1_100 = { .step = 1, .min = 1, .max = 100 };
GEMSpinner spinnerContrast(spinnerInt1_100);  // Яркость

// --- Spinner для float (0.0-3.0, шаг 0.1) ---
GEMSpinnerBoundariesFloat spinnerFloat0_3 = { .step = 0.1f, .min = 0.0f, .max = 3.0f };
GEMSpinner spinnerTiltX(spinnerFloat0_3);  // Поперечный
GEMSpinner spinnerTiltY(spinnerFloat0_3);  // Продольный

// --- Spinner для float (0.1-5.0, шаг 0.1) ---
GEMSpinnerBoundariesFloat spinnerFloat0_1_5 = { .step = 0.1f, .min = 0.1f, .max = 5.0f };
GEMSpinner spinnerPressureMin(spinnerFloat0_1_5);  // P.МИНИМУМ

// --- Spinner для float (1.0-8.0, шаг 0.1) ---
GEMSpinnerBoundariesFloat spinnerFloat1_8 = { .step = 0.1f, .min = 1.0f, .max = 8.0f };
GEMSpinner spinnerPressureMax(spinnerFloat1_8);  // P.МАКСИМУМ

// --- Spinner для float (1.0-6.0, шаг 0.1) ---
GEMSpinnerBoundariesFloat spinnerFloat1_6 = { .step = 0.1f, .min = 1.0f, .max = 6.0f };
GEMSpinner spinnerMovementFront(spinnerFloat1_6);  // ПЕРЕДНИЕ
GEMSpinner spinnerMovementRear(spinnerFloat1_6);   // ЗАДНИЕ

/* ===== 8.8.0: спиннеры новых параметров ===== */
// --- целочисленные ---
GEMSpinnerBoundariesInt spinnerInt30_600 = { .step = 30, .min = 30, .max = 600 };     // Проверка МП
GEMSpinnerBoundariesInt spinnerInt1_30 = { .step = 1, .min = 1, .max = 30 };          // Макс. время операции
GEMSpinnerBoundariesInt spinnerInt10_120 = { .step = 5, .min = 10, .max = 120 };      // Длительность/успокоение
GEMSpinnerBoundariesInt spinnerInt30_300 = { .step = 10, .min = 30, .max = 300 };     // Проверка давления
GEMSpinnerBoundariesInt spinnerInt10_200 = { .step = 5, .min = 10, .max = 200 };      // Порог гироскопа
GEMSpinnerBoundariesInt spinnerInt200_3000 = { .step = 100, .min = 200, .max = 3000 }; // Порог акселерометра
GEMSpinnerBoundariesInt spinnerInt0_30 = { .step = 1, .min = 0, .max = 30 };          // Гасить подсветку
GEMSpinnerBoundariesInt spinnerInt20_200 = { .step = 5, .min = 20, .max = 200 };      // Интервал кадра
GEMSpinnerBoundariesInt spinnerInt20_255 = { .step = 5, .min = 20, .max = 255 };      // Порог детектора MPU

// --- float ---
GEMSpinnerBoundariesFloat spinnerFloat005_05 = { .step = 0.05f, .min = 0.05f, .max = 0.5f };  // Зона нечувствительности
GEMSpinnerBoundariesFloat spinnerFloat02_09 = { .step = 0.05f, .min = 0.2f, .max = 0.9f };    // Грубая зона
GEMSpinnerBoundariesFloat spinnerFloat005_03 = { .step = 0.01f, .min = 0.05f, .max = 0.3f };  // Точная зона
GEMSpinnerBoundariesFloat spinnerFloat105_2 = { .step = 0.05f, .min = 1.05f, .max = 2.0f };   // «Стало хуже»
GEMSpinnerBoundariesFloat spinnerFloat01_1 = { .step = 0.05f, .min = 0.1f, .max = 1.0f };     // Допуск давления
GEMSpinnerBoundariesFloat spinnerFloat001_05 = { .step = 0.01f, .min = 0.01f, .max = 0.5f };  // Пороги перерисовки
GEMSpinnerBoundariesFloat spinnerFloatNeg3_3 = { .step = 0.01f, .min = -3.0f, .max = 3.0f };  // Нуль углов

GEMSpinner spinnerMasterCheck(spinnerInt30_600);        // Проверка МП
GEMSpinner spinnerManualMaxTime(spinnerInt1_30);        // Макс. время операции
GEMSpinner spinnerDeadband(spinnerFloat005_05);         // Зона нечувствительности
GEMSpinner spinnerCoarseZone(spinnerFloat02_09);        // Грубая зона
GEMSpinner spinnerFineZone(spinnerFloat005_03);         // Точная зона
GEMSpinner spinnerWorsening(spinnerFloat105_2);         // Порог «стало хуже»
GEMSpinner spinnerMoveDuration(spinnerInt10_120);       // Длительность движения
GEMSpinner spinnerMoveSettle(spinnerInt10_120);         // Время успокоения
GEMSpinner spinnerMoveCheck(spinnerInt30_300);          // Проверка давления после движения
GEMSpinner spinnerMoveTolerance(spinnerFloat01_1);      // Допуск давления
GEMSpinner spinnerGyroThr(spinnerInt10_200);            // Порог гироскопа
GEMSpinner spinnerAccelThr(spinnerInt200_3000);         // Порог акселерометра
GEMSpinner spinnerBacklightOff(spinnerInt0_30);         // Гасить подсветку, мин
GEMSpinner spinnerFrameMs(spinnerInt20_200);            // Интервал кадра
GEMSpinner spinnerRedrawAngle(spinnerFloat001_05);      // Порог перерисовки углов
GEMSpinner spinnerRedrawPressure(spinnerFloat001_05);   // Порог перерисовки давления
GEMSpinner spinnerImuMotionDet(spinnerInt20_255);       // Порог детектора движения MPU
GEMSpinner spinnerZeroAngleX(spinnerFloatNeg3_3);       // Нуль углов X
GEMSpinner spinnerZeroAngleY(spinnerFloatNeg3_3);       // Нуль углов Y

/* Переменные состояния */
enum Pad : uint8_t {
  PAD_FRONT_LEFT,
  PAD_FRONT_RIGHT,
  PAD_REAR_LEFT,
  PAD_REAR_RIGHT,
  PAD_COUNT_ENUM
};

enum class SystemState {
  BOOT,
  CALIBRATING,
  RUNNING,
  ERROR,
  OTA_MODE
};

enum class SystemMode : uint8_t {
  MANUAL,
  AUTO,
  MOVEMENT
};

enum class TestState {
  IDLE,
  STARTING,
  TESTING_PAD,
  WAITING_BETWEEN_PHASES,
  COMPLETED
};

enum class Mode : uint8_t {
  MANUAL,
  AUTO
};

enum class TestStep : uint8_t {
  IDLE = 0,
  PREPARE_CHECK_SUPPLY,
  PREPARE_WAIT_PRESSURIZE,
  PREPARE_EQUALIZE_PADS,
  TEST_DEFLATE_VALVE,
  TEST_INFLATE_VALVE,
  TEST_PAD_VALVE_RESET,
  TEST_PAD_VALVE_OPEN,
  TEST_PAD_VALVE_CLOSE,
  COMPLETED
};

constexpr uint16_t COLOR_BG = ST77XX_BLACK;
constexpr uint16_t COLOR_TEXT = ST77XX_WHITE;
constexpr uint16_t COLOR_HIGHLIGHT = ST77XX_BLUE;
constexpr uint16_t COLOR_ERROR = ST77XX_RED;
constexpr uint16_t COLOR_SUCCESS = ST77XX_GREEN;
constexpr uint16_t COLOR_WARNING = ST77XX_YELLOW;
constexpr uint16_t COLOR_OTA = ST77XX_CYAN;
constexpr uint16_t COLOR_WHITE = ST77XX_WHITE;

/* Глобальные переменные */
bool errorScreenBlocking = false;

volatile bool calibrationCompleted = false;          // флаг калибровки
volatile bool firstPressureMeasurementDone = false;  // ← ДОБАВИТЬ

bool forceErrorScreenRedraw = false;


#define COLOR_SKY ST77XX_CYAN
#define COLOR_GROUND ST77XX_ORANGE
#define COLOR_HORIZON ST77XX_WHITE
#define COLOR_ROLL ST77XX_WHITE

char wifi_ssid[32] = "Kamaz-OTA-AP";
char wifi_password[64] = "";
char sta_ssid[33] = "";
constexpr char WIFI_STA_PASSWORD[] = "asd12345";
constexpr uint8_t WIFI_SCAN_MAX_NETWORKS = 8;
char wifi_scan_ssids[WIFI_SCAN_MAX_NETWORKS][33] = {};
int8_t wifi_scan_rssi[WIFI_SCAN_MAX_NETWORKS] = {};
uint8_t wifi_scan_count = 0;
uint8_t wifi_scan_selected = 0;
volatile bool wifiSetupActive = false;
volatile bool wifiScanInProgress = false;
volatile bool wifiConnected = false;
IPAddress local_ip(192, 168, 4, 1);
IPAddress gateway(192, 168, 4, 1);
IPAddress subnet(255, 255, 255, 0);

constexpr uint16_t OTA_PORT = 8266;
constexpr char OTA_HOSTNAME[] = "Kamaz-leveling-system";
char ota_password[64] = "";
constexpr char GITHUB_API_URL[] =
    "https://api.github.com/repos/timurufa86/kamaz_leveler/releases/latest";
constexpr char GITHUB_ASSET_NAME[] = "kamaz_leveler.bin";
constexpr char GITHUB_SHA256_ASSET_NAME[] = "kamaz_leveler.bin.sha256";
constexpr uint32_t VALVE_OPERATION_TIMEOUT_MS = 15000;
constexpr uint32_t VALVE_MAX_COMMAND_MS = 15000;
// 8.8.0: формат конфигурации 3 — добавлены параметры меню (магистраль/клапаны/авторежим/
// движение/дисплей) и калибровка IMU. Файлы версий 1 и 2 читаются, новые поля = значения по умолчанию.
constexpr uint32_t CONFIG_FORMAT_VERSION = 3;

constexpr uint32_t WDT_TIMEOUT_MS = 30000;
constexpr uint32_t TASK_WDT_TIMEOUT_MS = 10000;
constexpr uint8_t TASK_COUNT = 10;

constexpr uint32_t MANUAL_TARGET_CHECK_INTERVAL_MS = 120000;
constexpr uint32_t MANUAL_ADJUSTMENT_COOLDOWN_MS = 3000;
constexpr float MANUAL_PRESSURE_TOLERANCE = 0.1f;

/* ========== МЬЮТЕКС ДЛЯ ЗАЩИТЫ currentState ========== */
SemaphoreHandle_t xStateMutex = nullptr;

SystemState currentState = SystemState::BOOT;
SystemMode currentSystemMode = SystemMode::MANUAL;
SystemMode previousMode = SystemMode::MANUAL;
TestState currentTestState = TestState::IDLE;

// ========== ГЛОБАЛЬНАЯ ПЕРЕМЕННАЯ displayDirty (ОБЪЯВЛЕНА) ==========
volatile bool displayDirty = true;




/* ========== БЕЗОПАСНЫЕ ФУНКЦИИ ДЛЯ РАБОТЫ С СОСТОЯНИЕМ ========== */
bool setSystemState(SystemState newState) {
  if (xStateMutex == nullptr) return false;

  if (!takeMutexWithRetry(xStateMutex, pdMS_TO_TICKS(100), 3, "setSystemState")) {
    Serial.println("[STATE] Failed to take state mutex");
    return false;
  }

  SystemState oldState = currentState;
  currentState = newState;
  xSemaphoreGive(xStateMutex);

  Serial.printf("[STATE] Changed from %d to %d\n", (int)oldState, (int)newState);
  displayDirty = true;
  return true;
}

SystemState getSystemState() {
  if (xStateMutex == nullptr) return SystemState::ERROR;

  MutexGuard guard(xStateMutex);
  if (!guard) return SystemState::ERROR;

  return currentState;
}

/* ====================  EventBus ==================== */
enum class EventType : uint8_t {
  NONE = 0,
  IMU_UPDATE,
  PRESSURE_UPDATE,
  MODE_CHANGE,
  ERROR_OCCURRED,
  ERROR_CLEARED,
  VALVE_COMMAND,
  LEVELING_START,
  LEVELING_END,
  MOVEMENT_DETECTED,
  MOVEMENT_ENDED,
  OTA_START,
  OTA_PROGRESS,
  OTA_END,
  OTA_ERROR,
  DISPLAY_UPDATE,
  CONFIG_CHANGED,
  CALIBRATION_DONE,
  TEST_STATE_CHANGE,
  MANUAL_OPERATION_START,
  MANUAL_OPERATION_END,
  LOW_MEMORY_WARNING,
  CRITICAL_MEMORY
};

struct Event {
  EventType type;
  uint32_t timestamp;
  union {
    struct {
      float angleX, angleY, temperature;
    } imu;
    struct {
      float pressure[4], masterPressure;
    } pressure;
    struct {
      uint8_t pad;
      bool inflate;
      uint32_t duration;
    } valve;
    struct {
      uint8_t errorCode;
      char message[64];
    } error;
    struct {
      uint8_t fromMode, toMode;
    } modeChange;
    struct {
      uint8_t progress;
      char status[32];
    } ota;
    struct {
      uint8_t testState;
      uint8_t padIndex;
    } test;
    struct {
      uint8_t pad;
      bool inflate;
    } manualOp;
    struct {
      uint32_t freeHeap;
      uint32_t minHeap;
    } memory;
  } data;
};

class EventBus {
private:
  static QueueHandle_t eventQueue_;
  static constexpr size_t QUEUE_SIZE = 128;
  static SemaphoreHandle_t mutex_;
  static uint32_t droppedEvents_;
  static uint32_t maxDepth_;

public:
  static bool init() {
    mutex_ = xSemaphoreCreateMutex();
    if (mutex_ == nullptr) return false;

    eventQueue_ = xQueueCreate(QUEUE_SIZE, sizeof(Event));
    if (eventQueue_ == nullptr) return false;

    Serial.println("[EVENTBUS] Queue created");
    return true;
  }

  static bool publish(const Event &event, TickType_t timeout = pdMS_TO_TICKS(100)) {
    if (eventQueue_ == nullptr) return false;

    if (xSemaphoreTake(mutex_, pdMS_TO_TICKS(10)) == pdTRUE) {
      if (uxQueueSpacesAvailable(eventQueue_) == 0) {
        droppedEvents_++;
        if (droppedEvents_ % 10 == 1) {
          Serial.printf("[WARN] EventBus queue full, dropped %d events\n", droppedEvents_);
        }
        xSemaphoreGive(mutex_);
        return false;
      }
      xSemaphoreGive(mutex_);
    }

    Event eventCopy = event;
    BaseType_t result = xQueueSend(eventQueue_, &eventCopy, timeout);
    size_t depth = uxQueueMessagesWaiting(eventQueue_);
    if (depth > maxDepth_) maxDepth_ = depth;
    if (result != pdTRUE) droppedEvents_++;
    return result == pdTRUE;
  }

  static bool receive(Event &event, TickType_t timeout = portMAX_DELAY) {
    if (eventQueue_ == nullptr) return false;
    return xQueueReceive(eventQueue_, &event, timeout) == pdTRUE;
  }

  static size_t available() {
    if (eventQueue_ == nullptr) return 0;
    return uxQueueMessagesWaiting(eventQueue_);
  }

  static void flush() {
    if (eventQueue_ == nullptr) return;
    xQueueReset(eventQueue_);
    droppedEvents_ = 0;
  }

  static uint32_t getDroppedCount() {
    return droppedEvents_;
  }

  static uint32_t dropped() { return droppedEvents_; }
  static uint32_t maxDepth() { return maxDepth_; }
};

QueueHandle_t EventBus::eventQueue_ = nullptr;
SemaphoreHandle_t EventBus::mutex_ = nullptr;
uint32_t EventBus::droppedEvents_ = 0;
uint32_t EventBus::maxDepth_ = 0;

/* ====================  TaskPool ==================== */
struct TaskConfig {
  const char *name;
  TaskFunction_t function;
  uint32_t stackSize;
  UBaseType_t priority;
  BaseType_t coreId;
  uint32_t periodMs;
  void *parameters;
};

class TaskPool {
private:
  struct TaskHandle {
    TaskHandle_t handle;
    const char *name;
    uint32_t periodMs;
    uint32_t lastRun;
    bool enabled;
    UBaseType_t minStackFree;
  };

  static TaskHandle tasks_[16];
  static uint8_t taskCount_;
  static SemaphoreHandle_t poolMutex_;

public:
  static bool init() {
    poolMutex_ = xSemaphoreCreateMutex();
    return poolMutex_ != nullptr;
  }

  static uint8_t addTask(const TaskConfig &config) {
    if (poolMutex_ == nullptr) return 0xFF;
    if (xSemaphoreTake(poolMutex_, pdMS_TO_TICKS(100)) != pdTRUE) return 0xFF;

    if (taskCount_ >= 16) {
      xSemaphoreGive(poolMutex_);
      return 0xFF;
    }

    TaskHandle_t handle = nullptr;
    BaseType_t result = xTaskCreatePinnedToCore(
      config.function,
      config.name,
      config.stackSize,
      config.parameters,
      config.priority,
      &handle,
      config.coreId);

    if (result != pdPASS) {
      xSemaphoreGive(poolMutex_);
      return 0xFF;
    }

    tasks_[taskCount_].handle = handle;
    tasks_[taskCount_].name = config.name;
    tasks_[taskCount_].periodMs = config.periodMs;
    tasks_[taskCount_].lastRun = 0;
    tasks_[taskCount_].enabled = true;
    tasks_[taskCount_].minStackFree = uxTaskGetStackHighWaterMark(handle);

    uint8_t index = taskCount_++;
    xSemaphoreGive(poolMutex_);
    return index;
  }

  static bool removeTask(uint8_t index) {
    if (poolMutex_ == nullptr) return false;
    if (xSemaphoreTake(poolMutex_, pdMS_TO_TICKS(100)) != pdTRUE) return false;

    if (index >= taskCount_) {
      xSemaphoreGive(poolMutex_);
      return false;
    }

    if (tasks_[index].handle != nullptr) {
      vTaskDelete(tasks_[index].handle);
      vTaskDelay(pdMS_TO_TICKS(10));
    }

    for (uint8_t i = index; i < taskCount_ - 1; i++) {
      tasks_[i] = tasks_[i + 1];
    }
    taskCount_--;

    xSemaphoreGive(poolMutex_);
    return true;
  }

  static void enableTask(uint8_t index) {
    if (poolMutex_ == nullptr) return;
    if (index >= taskCount_) return;

    if (xSemaphoreTake(poolMutex_, pdMS_TO_TICKS(10)) == pdTRUE) {
      if (index < taskCount_) tasks_[index].enabled = true;
      xSemaphoreGive(poolMutex_);
    }
  }

  static void disableTask(uint8_t index) {
    if (poolMutex_ == nullptr) return;
    if (xSemaphoreTake(poolMutex_, pdMS_TO_TICKS(10)) == pdTRUE) {
      if (index < taskCount_) tasks_[index].enabled = false;
      xSemaphoreGive(poolMutex_);
    }
  }

  static bool isTaskEnabled(uint8_t index) {
    if (poolMutex_ == nullptr) return false;
    bool result = false;
    if (xSemaphoreTake(poolMutex_, pdMS_TO_TICKS(10)) == pdTRUE) {
      if (index < taskCount_) result = tasks_[index].enabled;
      xSemaphoreGive(poolMutex_);
    }
    return result;
  }

  static const char *getTaskName(uint8_t index) {
    if (poolMutex_ == nullptr) return nullptr;
    const char *name = nullptr;
    if (xSemaphoreTake(poolMutex_, pdMS_TO_TICKS(10)) == pdTRUE) {
      if (index < taskCount_) name = tasks_[index].name;
      xSemaphoreGive(poolMutex_);
    }
    return name;
  }

  static void markRun(uint8_t index) {
    if (poolMutex_ == nullptr) return;
    if (index >= taskCount_) return;

    if (xSemaphoreTake(poolMutex_, pdMS_TO_TICKS(10)) == pdTRUE) {
      if (index < taskCount_) {
        tasks_[index].lastRun = millis();
        if (tasks_[index].handle != nullptr) {
          UBaseType_t currentStack = uxTaskGetStackHighWaterMark(tasks_[index].handle);
          if (currentStack < tasks_[index].minStackFree) {
            tasks_[index].minStackFree = currentStack;
            if (currentStack < 200) {
              Serial.printf("[TASKPOOL] ⚠️ Task '%s' stack critical: %d bytes free\n",
                            tasks_[index].name, currentStack);
            }
          }
        }
      }
      xSemaphoreGive(poolMutex_);
    }
  }

  static uint32_t getTimeUntilNextRun(uint8_t index) {
    if (poolMutex_ == nullptr) return UINT32_MAX;
    uint32_t result = UINT32_MAX;
    if (xSemaphoreTake(poolMutex_, pdMS_TO_TICKS(10)) == pdTRUE) {
      if (index < taskCount_ && tasks_[index].enabled) {
        uint32_t elapsed = millis() - tasks_[index].lastRun;
        if (tasks_[index].periodMs > elapsed) {
          result = tasks_[index].periodMs - elapsed;
        } else {
          result = 0;
        }
      }
      xSemaphoreGive(poolMutex_);
    }
    return result;
  }

  static uint8_t getTaskCount() {
    return taskCount_;
  }

  static UBaseType_t getTaskMinStack(uint8_t index) {
    if (poolMutex_ == nullptr) return 0;
    UBaseType_t result = 0;
    if (xSemaphoreTake(poolMutex_, pdMS_TO_TICKS(10)) == pdTRUE) {
      if (index < taskCount_) result = tasks_[index].minStackFree;
      xSemaphoreGive(poolMutex_);
    }
    return result;
  }
};

TaskPool::TaskHandle TaskPool::tasks_[16];
uint8_t TaskPool::taskCount_ = 0;
SemaphoreHandle_t TaskPool::poolMutex_ = nullptr;

uint8_t taskIndex_Event = 0xFF;
uint8_t taskIndex_Button = 0xFF;
uint8_t taskIndex_Display = 0xFF;
uint8_t taskIndex_IMU = 0xFF;
uint8_t taskIndex_Pressure = 0xFF;
uint8_t taskIndex_Control = 0xFF;
uint8_t taskIndex_Calib = 0xFF;
uint8_t taskIndex_Watchdog = 0xFF;
uint8_t taskIndex_OTA = 0xFF;
uint8_t taskIndex_ErrRec = 0xFF;
uint8_t taskIndex_Valve = 0xFF;

/* ====================  ГЛОБАЛЬНЫЕ ПЕРЕМЕННЫЕ ==================== */
SPIClass spi(VSPI);
Adafruit_ST7789 tft(&spi, PIN_TFT_CS, PIN_TFT_DC, PIN_TFT_RST);
GEM_adafruit_gfx gem(tft);  // передаём ссылку на TFT

void menuExitAction();   // Кн4 на главной странице меню: сохранить и закрыть

GEMPage mainPage("Главное меню", menuExitAction);
// Подстраницы создаются сразу с родителем: GEM сам добавляет первым пунктом
// «Назад» (стрелка влево) и корректно обрабатывает возврат по Кн4.
GEMPage systemPage("Система", mainPage);
GEMPage testPage("Тестирование", mainPage);
GEMPage valvePage("Клапаны", mainPage);
GEMPage tiltPage("Наклон", mainPage);
GEMPage pressurePage("Давление", mainPage);
GEMPage autoPage("Авторежим", mainPage);
GEMPage displayPage("Дисплей", mainPage);
GEMPage movementPage("Движение", mainPage);
GEMPage infoPage("Информация", mainPage);
// 8.8.0: новые страницы — ручной тест клапанов, IMU/MPU6050 и просмотр настроек
GEMPage imuPage("IMU / MPU6050", mainPage);
GEMPage settingsViewPage("Настройки", mainPage);

/* --- Страница «Информация»: строки обновляются динамически (refreshInfoPage) ---
 * Важно: LABEL-пункт создаётся конструктором с ОДНИМ аргументом (GEMItem.cpp:43
 * выставляет type = GEM_ITEM_LABEL). Вариант ("текст", nullptr, GEM_ITEM_LABEL)
 * даёт readonly-ссылку, а не метку.
 */
static GEMItem itemInfoVersion("Версия: …");
// 8.8.0: строки страницы «Настройки» (обновляются в refreshSettingsView)
static GEMItem itemSet1("Давление: …");
static GEMItem itemSet2("Наклон: …");
static GEMItem itemSet3("Клапаны: …");
static GEMItem itemSet4("Авторежим: …");
static GEMItem itemSet5("Движение: …");
static GEMItem itemSet6("Дисплей: …");
static GEMItem itemSet7("IMU: …");
static GEMItem itemInfoMode("Режим: …");
static GEMItem itemInfoMpu("MPU: …");
static GEMItem itemInfoMaster("МП: …");
static GEMItem itemInfoWiFi("Wi-Fi: …");
static GEMItem itemInfoSystem("Аптайм: …");
static GEMItem itemInfoErrors("Ошибки: …");


MPU6050 mpu;
GKalman filterX(40, 40, 0.5f);
GKalman filterY(40, 40, 0.5f);
GMedian<5, int> pressureFilter;

// ========== ADS1015 ==========
Adafruit_ADS1015 ads;  // Объект для работы с ADS1015

Button button0(PIN_BUT1, INPUT_PULLUP, LOW);
Button button1(PIN_BUT2, INPUT_PULLUP, LOW);
Button button2(PIN_BUT3, INPUT_PULLUP, LOW);
Button button3(PIN_BUT4, INPUT_PULLUP, LOW);
// GPIO34 has no internal pull-up; install an external pull-up resistor.
Button button4(PIN_BUT5, INPUT, LOW);

VirtButton emergencyButton;
VirtButton menuCombo;   // пара КН3+КН4 (GPIO15+GPIO17) — открытие меню

SemaphoreHandle_t xValveMutex = nullptr;
SemaphoreHandle_t xDisplayMutex = nullptr;
SemaphoreHandle_t xConfigMutex = nullptr;
SemaphoreHandle_t xCalibMutex = nullptr;
SemaphoreHandle_t xTestMutex = nullptr;
SemaphoreHandle_t xCommandMutex = nullptr;

QueueHandle_t xIMUQueue = nullptr;
QueueHandle_t xPressureQueue = nullptr;
QueueHandle_t xValveQueue = nullptr;
QueueHandle_t xPressureWakeupQueue = nullptr;

struct ValveCommandMsg {
  union {
    struct {
      Pad pad;
      bool inflate;
      uint32_t durationMs;
      QueueHandle_t ackQueue;
    } sync;
    struct {
      Pad pad;
      bool inflate;
      TickType_t duration;
    } async;
  };
};

struct IMUData {
  float angleX;
  float angleY;
  float temperature;
};

struct PressureData {
  float pressure[PAD_COUNT];
  float masterPressure;
};

float angleX = 0, angleY = 0, temperature = 0;
float pressure[PAD_COUNT] = { 0 };
float masterPressure = 0;
volatile bool mpuOk = false;
volatile bool menuVisible = false;
//bool menuRendered = false;         // ← ДОБАВИТЬ!
uint32_t lastMenuInteraction = 0;  // ← ДОБАВИТЬ!

bool isMoving = false;
bool prolongedMovementDetected = false;
//uint32_t lastMovementTime = 0;
uint32_t movementStartTime = 0;

bool manualControlActive = false;
Pad manualPadIndex = PAD_FRONT_LEFT;
bool manualInflate = false;
uint32_t manualStartTime = 0;

Mode currentMode = Mode::MANUAL;

bool otaMode = false;
volatile bool otaInProgress = false;
volatile bool otaValveLock = false;
int otaProgress = 0;
char otaStatus[32] = "";

constexpr uint8_t bubPins[PAD_COUNT] = { PIN_BUB1, PIN_BUB2, PIN_BUB3, PIN_BUB4 };
constexpr const char *padNames[PAD_COUNT] = { "ПЛ", "ПП", "ЗЛ", "ЗП" };

uint32_t lastLevelingCheckTime = 0;
uint32_t lastLevelingAttemptTime = 0;
volatile uint32_t levelingAttemptsThisHour = 0;
uint32_t lastHourResetTime = 0;

uint32_t lastMasterPressureCheckTime = 0;
uint32_t lastManualPressureCheckTime = 0;
float manualTargetPressure[PAD_COUNT] = { 3.0f, 3.0f, 3.0f, 3.0f };
bool manualTargetSet[PAD_COUNT] = { true, true, true, true };
bool pressureLimitReached = false;

uint32_t movementEndTime = 0;
bool movementModeActive = false;
uint32_t movementPressureLastCheck = 0;

/* ===== 8.9.0: данные для «живого» экрана ДВИЖЕНИЯ ===== */
uint32_t movementLastAdjustFront = 0;     // время последней корректировки передних подушек
uint32_t movementLastAdjustRear = 0;      // время последней корректировки задних подушек
int8_t movementLastAdjustFrontDir = 0;    // +1 — накачка, -1 — стравливание
int8_t movementLastAdjustRearDir = 0;
uint32_t movementStartMs = 0;             // начало обнаруженного движения (для «в движении N с»)
bool mvScreenWasActive = false;           // активен ли сейчас экран ДВИЖЕНИЯ

volatile bool calibrationValid = false;
int g_pressureZeroRaw = 0;


IMUData lastDisplayedIMU = { 0 };
PressureData lastDisplayedPressure = { 0 };
SystemMode lastDisplayedMode = SystemMode::MANUAL;
bool lastDisplayedMoving = false;

struct LastCommand {
  uint32_t startTime = 0;
  uint32_t duration = 0;
  Pad pad;
  bool inflate;
  float pressureBefore = 0;
  bool waitingForCompletion = false;
  bool commandActive = false;
};

struct ValveErrorCounter {
  uint8_t consecutiveFailures = 0;
  uint8_t requiredFailures = 3;
  uint32_t lastFailureTime = 0;
  bool valveErrorActive = false;
};

static LastCommand lastCmd;
static ValveErrorCounter valveErrorCounter;
static volatile uint32_t valveQueueDropCount = 0;
static volatile uint32_t eventQueueDropCount = 0;
static volatile uint32_t imuQueueDropCount = 0;
static volatile uint32_t pressureQueueDropCount = 0;
static volatile uint32_t valveEmergencyStopCount = 0;
static volatile uint32_t maxValveQueueDepth = 0;
static volatile uint32_t maxEventQueueDepth = 0;
static volatile uint32_t maxStackLowEvents = 0;
static volatile bool valveStopRequested = false;

static TestStep currentTestStep = TestStep::IDLE;
static uint32_t testStepStartTime = 0;
static uint8_t testPadIndex = 0;
static float testReferencePressure = 0;
static uint32_t testStartTime = 0;
static bool waitingForUser = false;

struct TestResult {
  bool supplyPressureOk;
  float supplyPressure;
  float equalizedPressure;
  bool inflateValveWorks;
  bool deflateValveWorks;
  bool padValvesWorks[PAD_COUNT];
  float pressureReadings[PAD_COUNT][3];
};

static TestResult testResult;

/* ====================  ПРОТОТИПЫ ==================== */
void setDisplayDirty();
void emergencyStop();
void startManualOperation(Pad padIdx, bool inflate);
void stopManualOperation();
void closeAllValves();
void setValve(Pad pad, bool state);
void sendValveCommand(Pad pad, bool inflate, uint32_t durationMs);
float readPressure();
void initWatchdog();
void initOTA();
void startOTAMode();
void stopOTAMode();
void handleOTA();
void displayOTAScreen();
void displayWiFiSetupScreen();
void displayErrorScreen();
void displayMainScreen();
void displayCalibrationScreen();
//void buildMenu(gm::Builder &b);
bool initFileSystem();
bool loadConfig();
bool saveConfig();
bool loadWiFiConfig();
bool saveWiFiConfig();
void startWiFiSetup();
void connectConfiguredWiFi();
void startFallbackAccessPoint();
void initializeDMP();
void resetSystemErrors();
bool checkPressureLimits();
void saveMenuSettings();
void applyRuntimeSettings();  // 8.8.0: применение настроек к железу без перезагрузки
bool sendValveCommandSync(Pad pad, bool inflate, uint32_t durationMs, uint32_t waitAfterMs);
void maintainMovementPressure();
bool detectMotionFromIMU();
void checkAndAdjustMasterPressure();
void maintainManualPressure();
void setManualTargetPressure(Pad pad);
void setAllManualTargetsFromCurrent();
void startValveTest();
void runValveTestLogic();
void updateTestDisplay();
void requestPressureMeasurement();
void forceDisplayReset(bool force = false);
void initializeDefaultCredentials();
bool checkGitHubUpdate(bool install);
bool downloadGitHubFirmware(const char *firmwareUrl, const char *sha256Url,
                            const char *releaseTag);

void buttonTask(void *pvParameters);
void displayTask(void *pvParameters);
void imuTask(void *pvParameters);
void pressureTask(void *pvParameters);
void controlTask(void *pvParameters);
void calibrationTask(void *pvParameters);
void watchdogTask(void *pvParameters);
void otaTask(void *pvParameters);
void errorRecoveryTask(void *pvParameters);
void valveTask(void *pvParameters);
void eventHandlerTask(void *pvParameters);

void drawIconB(int16_t x, int16_t y, const unsigned char *icon, uint16_t color);
void drawIcon(int16_t x, int16_t y, const unsigned char *icon, uint16_t color);
void drawIconL(int16_t x, int16_t y, const unsigned char *icon, uint16_t color);

/* ====================  ConfigManager ==================== */
/* ====================  РАЗДЕЛ «ОБНОВЛЕНИЯ» (GitHub)  ====================
 *  Список последних релизов, карточка релиза и установка выбранной версии.
 *  Сетевые операции выполняет otaTask (см. github_ota_request.h), здесь —
 *  хранение списка, страницы GEM и обработчики пунктов меню.
 */
constexpr uint8_t OTA_LIST_MAX = 5;
constexpr char GITHUB_RELEASES_URL[] =
    "https://api.github.com/repos/timurufa86/kamaz_leveler/releases?per_page=5";

struct OtaRelease {
  char tag[16] = "";
  char date[11] = "";   // YYYY-MM-DD
  uint32_t size = 0;
  char binUrl[176] = "";
  char shaUrl[176] = "";
  char sha256[65] = "";  // заполняется проверкой sha256-ассета
};

OtaRelease otaReleases[OTA_LIST_MAX];
volatile uint8_t otaReleaseCount = 0;
volatile int8_t otaSelectedIndex = -1;
char otaListStatus[64] = "список не загружен";

// --- Страницы раздела ---
GEMPage otaPage("Обновления", mainPage);
GEMPage otaListPage("Прошивки (GitHub)", otaPage);
GEMPage otaCardPage("Релиз", otaListPage);

// --- Прототипы обработчиков пунктов (реализация ниже) ---
static void otaFetchList();
static void otaInstallLast();
static void otaSelectRelease(uint8_t idx);
static void otaCardInstall();
static void otaCardCheckSha();
static void otaArduinoMode();
static void otaExitMode();
static void otaListRefresh();
static void refreshOtaCard();

// --- Пункты страницы «Обновления» ---
static GEMItem itemOtaCurrent("Версия: …");
static GEMItem itemOtaStatus("Состояние: …");
static GEMItem itemOtaFetch("Проверить обновления", []() { otaFetchList(); });
static GEMItem itemOtaList("Список прошивок", otaListPage);
static GEMItem itemOtaInstallLast("Установить последнюю", []() { otaInstallLast(); });
static GEMItem itemOtaArduino("Режим ArduinoOTA (Wi-Fi)", []() { otaArduinoMode(); });
static GEMItem itemOtaExit("Выход из режима OTA", []() { otaExitMode(); });

// --- Пункты страницы «Прошивки (GitHub)» ---
static char otaItemTitle[OTA_LIST_MAX][34];
static GEMItem itemOtaRel0("— нет данных —", []() { otaSelectRelease(0); });
static GEMItem itemOtaRel1("— нет данных —", []() { otaSelectRelease(1); });
static GEMItem itemOtaRel2("— нет данных —", []() { otaSelectRelease(2); });
static GEMItem itemOtaRel3("— нет данных —", []() { otaSelectRelease(3); });
static GEMItem itemOtaRel4("— нет данных —", []() { otaSelectRelease(4); });
static GEMItem *const otaRelItems[OTA_LIST_MAX] = {
  &itemOtaRel0, &itemOtaRel1, &itemOtaRel2, &itemOtaRel3, &itemOtaRel4
};
static GEMItem itemOtaListRefresh("Обновить список", []() { otaListRefresh(); });

// --- Пункты карточки релиза ---
static GEMItem itemCardTag("Релиз: —");
static GEMItem itemCardInfo("данных нет");
static GEMItem itemCardStatus("обновите список");
static GEMItem itemCardSha("SHA-256: не проверен");
static GEMItem itemCardInstall("УСТАНОВИТЬ", []() { otaCardInstall(); });
static GEMItem itemCardCheckSha("Проверить SHA-256", []() { otaCardCheckSha(); });

/* --- Сетевые операции (вызываются из otaTask) --- */

/** Загрузить список последних релизов. true, если получен хотя бы один. */
static bool fetchGitHubReleaseList() {
  if (WiFi.status() != WL_CONNECTED) {
    strlcpy(otaListStatus, "нет Wi-Fi", sizeof(otaListStatus));
    Serial.println("[GH-OTA] Список: нет Wi-Fi");
    return false;
  }

  WiFiClientSecure client;
  client.setInsecure();
  HTTPClient http;
  if (!http.begin(client, GITHUB_RELEASES_URL)) {
    strlcpy(otaListStatus, "ошибка соединения", sizeof(otaListStatus));
    return false;
  }
  http.addHeader("User-Agent", "kamaz-leveler");
  http.setFollowRedirects(HTTPC_STRICT_FOLLOW_REDIRECTS);
  const int code = http.GET();
  if (code != HTTP_CODE_OK) {
    snprintf(otaListStatus, sizeof(otaListStatus), "GitHub HTTP %d", code);
    Serial.printf("[GH-OTA] Список: HTTP %d\n", code);
    http.end();
    return false;
  }

  JsonDocument filter;
  filter[0]["tag_name"] = true;
  filter[0]["published_at"] = true;
  filter[0]["assets"][0]["name"] = true;
  filter[0]["assets"][0]["size"] = true;
  filter[0]["assets"][0]["browser_download_url"] = true;

  JsonDocument doc;
  const DeserializationError err =
      deserializeJson(doc, http.getStream(), DeserializationOption::Filter(filter));
  http.end();
  if (err) {
    strlcpy(otaListStatus, "ошибка JSON", sizeof(otaListStatus));
    Serial.printf("[GH-OTA] Список: JSON %s\n", err.c_str());
    return false;
  }

  uint8_t n = 0;
  for (JsonObject rel : doc.as<JsonArray>()) {
    if (n >= OTA_LIST_MAX) break;
    OtaRelease &r = otaReleases[n];
    strlcpy(r.tag, rel["tag_name"] | "", sizeof(r.tag));
    const char *published = rel["published_at"] | "";
    if (strlen(published) >= 10) {
      memcpy(r.date, published, 10);
      r.date[10] = '\0';
    } else {
      r.date[0] = '\0';
    }
    r.size = 0;
    r.binUrl[0] = '\0';
    r.shaUrl[0] = '\0';
    r.sha256[0] = '\0';

    for (JsonObject asset : rel["assets"].as<JsonArray>()) {
      const char *name = asset["name"] | "";
      const char *url = asset["browser_download_url"] | "";
      if (strcmp(name, GITHUB_ASSET_NAME) == 0) {
        strlcpy(r.binUrl, url, sizeof(r.binUrl));
        r.size = asset["size"] | 0UL;
      } else if (strcmp(name, GITHUB_SHA256_ASSET_NAME) == 0) {
        strlcpy(r.shaUrl, url, sizeof(r.shaUrl));
      }
    }
    if (r.binUrl[0] != '\0' && r.shaUrl[0] != '\0') n++;
  }

  otaReleaseCount = n;
  snprintf(otaListStatus, sizeof(otaListStatus), "релизов: %u", n);
  Serial.printf("[GH-OTA] Получено релизов: %u\n", n);
  return n > 0;
}

/** Скачать sha256-ассет релиза (только проверка, без установки). */
static bool fetchReleaseSha256(uint8_t idx) {
  if (idx >= otaReleaseCount) return false;
  OtaRelease &r = otaReleases[idx];
  if (r.shaUrl[0] == '\0' || WiFi.status() != WL_CONNECTED) return false;

  WiFiClientSecure client;
  client.setInsecure();
  HTTPClient http;
  if (!http.begin(client, r.shaUrl)) return false;
  http.addHeader("User-Agent", "kamaz-leveler");
  http.setFollowRedirects(HTTPC_STRICT_FOLLOW_REDIRECTS);
  const int code = http.GET();
  String body = (code == HTTP_CODE_OK) ? http.getString() : String();
  http.end();
  body.trim();
  if (body.length() < 64) {
    strlcpy(otaListStatus, "sha256 недоступен", sizeof(otaListStatus));
    return false;
  }
  strlcpy(r.sha256, body.substring(0, 64).c_str(), sizeof(r.sha256));
  strlcpy(otaListStatus, "sha256 получен", sizeof(otaListStatus));
  Serial.printf("[GH-OTA] %s sha256: %s\n", r.tag, r.sha256);
  return true;
}

/** Установить релиз из списка (вызывается из otaTask). */
static bool installGitHubReleaseIndex(int8_t idx) {
  if (idx < 0 || idx >= static_cast<int8_t>(otaReleaseCount)) return false;
  const OtaRelease &r = otaReleases[idx];
  if (r.binUrl[0] == '\0' || r.shaUrl[0] == '\0') return false;

  Serial.printf("[GH-OTA] Установка релиза %s\n", r.tag);
  otaValveLock = true;
  emergencyStop();
  if (!downloadGitHubFirmware(r.binUrl, r.shaUrl, r.tag)) {
    otaValveLock = false;
    return false;
  }
  ESP.restart();
  return true;
}

/* --- Обработчики пунктов меню --- */

static void otaFetchList() {
  requestGitHubOtaFetchList();
  strlcpy(otaListStatus, "запрос отправлен…", sizeof(otaListStatus));
  displayDirty = true;
  Serial.println("[GH-OTA] Запрос списка релизов отправлен в otaTask");
}

static void otaListRefresh() { otaFetchList(); }

static void otaInstallLast() {
  requestGitHubOtaCheckAndInstall();
  menuVisible = false;   // показываем экран прогресса установки
  displayDirty = true;
  Serial.println("[GH-OTA] Запрос на установку последнего релиза");
}

static void otaSelectRelease(uint8_t idx) {
  if (idx >= otaReleaseCount) {
    strlcpy(otaListStatus, "сначала обновите список", sizeof(otaListStatus));
    displayDirty = true;
    return;
  }
  otaSelectedIndex = static_cast<int8_t>(idx);
  gem.setMenuPageCurrent(otaCardPage);
  displayDirty = true;
}

static void otaCardInstall() {
  if (otaSelectedIndex < 0) return;
  requestGitHubOtaInstallIndex(otaSelectedIndex);
  menuVisible = false;   // показываем экран прогресса установки
  displayDirty = true;
  Serial.printf("[GH-OTA] Запрос на установку релиза #%d\n", (int)otaSelectedIndex);
}

static void otaCardCheckSha() {
  if (otaSelectedIndex < 0 || otaSelectedIndex >= static_cast<int8_t>(otaReleaseCount)) return;
  // Ассет 64 байта — качаем синхронно (короткая операция), затем обновляем карточку.
  fetchReleaseSha256(static_cast<uint8_t>(otaSelectedIndex));
  refreshOtaCard();
  displayDirty = true;
}

static void otaArduinoMode() {
  menuVisible = false;
  displayDirty = true;
  startOTAMode();
}

static void otaExitMode() {
  stopOTAMode();
  displayDirty = true;
}

class ConfigManager {
private:
  struct Config {
    uint32_t formatVersion = CONFIG_FORMAT_VERSION;
    // ===== прежние параметры (8.6.x / 8.7.x) =====
    float pressureMin = 1.0f;
    float pressureMax = 7.0f;
    float tiltThresholdX = 0.5f;
    float tiltThresholdY = 0.5f;
    int contrast = 50;
    int nivCount = 5;
    int timeInterval = 5;
    int inflateDelay = 4;
    int releaseDelay = 7;
    float movementPressureFront = 3.5f;
    float movementPressureRear = 4.0f;

    // ===== 8.8.0: магистраль / клапаны =====
    int masterCheckSec = 240;        // период проверки магистрали, с
    int manualMaxTimeSec = 10;       // максимальное время ручной операции, с
    float pressureDeadband = 0.2f;   // зона нечувствительности по давлению, бар

    // ===== 8.8.0: авторежим =====
    float coarseZoneRatio = 0.4f;    // грубая зона = доля порога
    float fineZoneRatio = 0.15f;     // точная зона = доля порога
    float worseningRatio = 1.2f;     // порог «стало хуже» (множитель)

    // ===== 8.8.0: движение =====
    int movementDurationSec = 30;    // длительность ожидания движения, с
    int movementSettleSec = 30;      // время успокоения после движения, с
    int movementCheckSec = 120;      // период проверки давления после движения, с
    float movementTolerance = 0.2f;  // допуск давления после движения, бар
    int gyroThreshold = 50;          // порог гироскопа для детектора движения
    int accelThreshold = 1000;       // порог акселерометра для детектора движения

    // ===== 8.8.0: дисплей =====
    int backlightOffMin = 0;         // гашение подсветки, мин (0 = никогда)
    int frameMs = 50;                // интервал кадра дисплея, мс
    float redrawAngleThr = 0.05f;    // порог перерисовки по углу, °
    float redrawPressureThr = 0.03f; // порог перерисовки по давлению, бар

    // ===== 8.8.0: IMU / MPU6050 =====
    int imuMotionDet = 100;          // аппаратный порог детектора движения MPU
    int imuGyroOffX = 0;             // офсеты гироскопа (калибровка)
    int imuGyroOffY = 0;
    int imuGyroOffZ = 0;
    int imuAccelOffX = 0;            // офсеты акселерометра (калибровка)
    int imuAccelOffY = 0;
    int imuAccelOffZ = 0;
    float zeroAngleX = 0.0f;         // программный нуль углов (поперечный), °
    float zeroAngleY = 0.0f;         // программный нуль углов (продольный), °
  };

  static Config currentConfig;

public:
  static bool load() {
    Serial.println("[CFG] Загрузка конфигурации");

    if (!LittleFS.totalBytes()) {
      Serial.println("[CFG] LittleFS не смонтирована");
      return false;
    }

    MutexGuard guard(xConfigMutex, pdMS_TO_TICKS(500));
    if (!guard) {
      Serial.println("[CFG] Не удалось получить доступ к мьютексу конфигурации!");
      return false;
    }

    File file = LittleFS.open("/config.txt", "r");
    if (!file) {
      Serial.println("[CFG] Нет файла конфигурации — применяю значения по умолчанию");
      currentConfig = Config{};  // 8.8.0: все дефолты заданы в структуре Config
      currentConfig.formatVersion = CONFIG_FORMAT_VERSION;
      dumpToSerial();
      return true;
    }

    StaticJsonDocument<2048> doc;
    DeserializationError error = deserializeJson(doc, file);
    file.close();

    if (error) {
      Serial.println("[CFG] Ошибка десериализации JSON");
      return false;
    }

    uint32_t formatVersion = doc["formatVersion"] | 1;
    if (formatVersion > CONFIG_FORMAT_VERSION) {
      Serial.printf("[CFG] Неподдерживаемая версия конфигурации: %u\n", formatVersion);
      return false;
    }

    // 8.8.0: стартуем с дефолтов — поля, которых нет в старом файле (форматы 1 и 2),
    // останутся значениями по умолчанию из структуры Config
    currentConfig = Config{};
    currentConfig.formatVersion = CONFIG_FORMAT_VERSION;
    float val = doc["pressureMin"] | 1.0f;
    currentConfig.pressureMin = constrain(val, 0.1f, 5.0f);

    val = doc["pressureMax"] | 7.0f;
    currentConfig.pressureMax = constrain(val, 1.0f, 8.0f);

    val = doc["tiltThresholdX"] | 0.5f;
    currentConfig.tiltThresholdX = constrain(val, 0.0f, 5.0f);

    val = doc["tiltThresholdY"] | 0.5f;
    currentConfig.tiltThresholdY = constrain(val, 0.0f, 5.0f);

    currentConfig.contrast = constrain(doc["contrast"] | 50, 1, 100);
    currentConfig.nivCount = constrain(doc["nivCount"] | 5, 1, 20);
    currentConfig.timeInterval = constrain(doc["timeInterval"] | 5, 1, 60);
    currentConfig.inflateDelay = constrain(doc["inflateDelay"] | 4, 1, 10);
    currentConfig.releaseDelay = constrain(doc["releaseDelay"] | 7, 1, 10);

    val = doc["movementPressureFront"] | 3.5f;
    currentConfig.movementPressureFront = constrain(val, 1.0f, 6.0f);

    val = doc["movementPressureRear"] | 4.0f;
    currentConfig.movementPressureRear = constrain(val, 1.0f, 6.0f);

    // ===== 8.8.0: магистраль / клапаны =====
    currentConfig.masterCheckSec = constrain((int)(doc["masterCheckSec"] | 240), 30, 600);
    currentConfig.manualMaxTimeSec = constrain((int)(doc["manualMaxTimeSec"] | 10), 1, 30);
    val = doc["pressureDeadband"] | 0.2f;
    currentConfig.pressureDeadband = constrain(val, 0.05f, 0.5f);

    // ===== 8.8.0: авторежим =====
    val = doc["coarseZoneRatio"] | 0.4f;
    currentConfig.coarseZoneRatio = constrain(val, 0.2f, 0.9f);
    val = doc["fineZoneRatio"] | 0.15f;
    currentConfig.fineZoneRatio = constrain(val, 0.05f, 0.3f);
    val = doc["worseningRatio"] | 1.2f;
    currentConfig.worseningRatio = constrain(val, 1.05f, 2.0f);

    // ===== 8.8.0: движение =====
    currentConfig.movementDurationSec = constrain((int)(doc["movementDurationSec"] | 30), 10, 120);
    currentConfig.movementSettleSec = constrain((int)(doc["movementSettleSec"] | 30), 10, 120);
    currentConfig.movementCheckSec = constrain((int)(doc["movementCheckSec"] | 120), 30, 300);
    val = doc["movementTolerance"] | 0.2f;
    currentConfig.movementTolerance = constrain(val, 0.1f, 1.0f);
    currentConfig.gyroThreshold = constrain((int)(doc["gyroThreshold"] | 50), 10, 200);
    currentConfig.accelThreshold = constrain((int)(doc["accelThreshold"] | 1000), 200, 3000);

    // ===== 8.8.0: дисплей =====
    currentConfig.backlightOffMin = constrain((int)(doc["backlightOffMin"] | 0), 0, 30);
    currentConfig.frameMs = constrain((int)(doc["frameMs"] | 50), 20, 200);
    val = doc["redrawAngleThr"] | 0.05f;
    currentConfig.redrawAngleThr = constrain(val, 0.01f, 0.5f);
    val = doc["redrawPressureThr"] | 0.03f;
    currentConfig.redrawPressureThr = constrain(val, 0.01f, 0.5f);

    // ===== 8.8.0: IMU / MPU6050 =====
    currentConfig.imuMotionDet = constrain((int)(doc["imuMotionDet"] | 100), 20, 255);
    currentConfig.imuGyroOffX = constrain((int)(doc["imuGyroOffX"] | 0), -32768, 32767);
    currentConfig.imuGyroOffY = constrain((int)(doc["imuGyroOffY"] | 0), -32768, 32767);
    currentConfig.imuGyroOffZ = constrain((int)(doc["imuGyroOffZ"] | 0), -32768, 32767);
    currentConfig.imuAccelOffX = constrain((int)(doc["imuAccelOffX"] | 0), -32768, 32767);
    currentConfig.imuAccelOffY = constrain((int)(doc["imuAccelOffY"] | 0), -32768, 32767);
    currentConfig.imuAccelOffZ = constrain((int)(doc["imuAccelOffZ"] | 0), -32768, 32767);
    val = doc["zeroAngleX"] | 0.0f;
    currentConfig.zeroAngleX = constrain(val, -3.0f, 3.0f);
    val = doc["zeroAngleY"] | 0.0f;
    currentConfig.zeroAngleY = constrain(val, -3.0f, 3.0f);

    Serial.printf("[CFG] Конфигурация загружена успешно (формат файла: %u)\n", formatVersion);
    dumpToSerial();
    return true;
  }

  static bool save() {
    Serial.println("[CFG] Сохранение конфигурации");

    if (!LittleFS.totalBytes()) {
      Serial.println("[CFG] LittleFS не смонтирована");
      return false;
    }

    MutexGuard guard(xConfigMutex, pdMS_TO_TICKS(500));
    if (!guard) {
      Serial.println("[CFG] Не удалось получить доступ к мьютексу конфигурации!");
      return false;
    }

    StaticJsonDocument<2048> doc;  // 8.8.0: увеличено под новые параметры
    doc["pressureMin"] = currentConfig.pressureMin;
    doc["formatVersion"] = CONFIG_FORMAT_VERSION;
    doc["pressureMax"] = currentConfig.pressureMax;
    doc["tiltThresholdX"] = currentConfig.tiltThresholdX;
    doc["tiltThresholdY"] = currentConfig.tiltThresholdY;
    doc["contrast"] = currentConfig.contrast;
    doc["nivCount"] = currentConfig.nivCount;
    doc["timeInterval"] = currentConfig.timeInterval;
    doc["inflateDelay"] = currentConfig.inflateDelay;
    doc["releaseDelay"] = currentConfig.releaseDelay;
    doc["movementPressureFront"] = currentConfig.movementPressureFront;
    doc["movementPressureRear"] = currentConfig.movementPressureRear;

    // ===== 8.8.0 =====
    doc["masterCheckSec"] = currentConfig.masterCheckSec;
    doc["manualMaxTimeSec"] = currentConfig.manualMaxTimeSec;
    doc["pressureDeadband"] = currentConfig.pressureDeadband;
    doc["coarseZoneRatio"] = currentConfig.coarseZoneRatio;
    doc["fineZoneRatio"] = currentConfig.fineZoneRatio;
    doc["worseningRatio"] = currentConfig.worseningRatio;
    doc["movementDurationSec"] = currentConfig.movementDurationSec;
    doc["movementSettleSec"] = currentConfig.movementSettleSec;
    doc["movementCheckSec"] = currentConfig.movementCheckSec;
    doc["movementTolerance"] = currentConfig.movementTolerance;
    doc["gyroThreshold"] = currentConfig.gyroThreshold;
    doc["accelThreshold"] = currentConfig.accelThreshold;
    doc["backlightOffMin"] = currentConfig.backlightOffMin;
    doc["frameMs"] = currentConfig.frameMs;
    doc["redrawAngleThr"] = currentConfig.redrawAngleThr;
    doc["redrawPressureThr"] = currentConfig.redrawPressureThr;
    doc["imuMotionDet"] = currentConfig.imuMotionDet;
    doc["imuGyroOffX"] = currentConfig.imuGyroOffX;
    doc["imuGyroOffY"] = currentConfig.imuGyroOffY;
    doc["imuGyroOffZ"] = currentConfig.imuGyroOffZ;
    doc["imuAccelOffX"] = currentConfig.imuAccelOffX;
    doc["imuAccelOffY"] = currentConfig.imuAccelOffY;
    doc["imuAccelOffZ"] = currentConfig.imuAccelOffZ;
    doc["zeroAngleX"] = currentConfig.zeroAngleX;
    doc["zeroAngleY"] = currentConfig.zeroAngleY;

    File file = LittleFS.open("/config.tmp", "w");
    if (!file) {
      Serial.println("[CFG] Не удалось создать временный файл");
      return false;
    }

    size_t bytesWritten = serializeJson(doc, file);
    file.close();

    if (bytesWritten == 0) {
      Serial.println("[CFG] Ошибка записи JSON");
      LittleFS.remove("/config.tmp");
      return false;
    }

    // 8.8.0: сохраняем предыдущую версию как резервную копию
    if (LittleFS.exists("/config.txt")) {
      LittleFS.remove("/config.bak");
      LittleFS.rename("/config.txt", "/config.bak");
    }
    if (LittleFS.rename("/config.tmp", "/config.txt")) {
      // 8.8.0: проверяем, что записанный файл читается и содержит нужную версию формата
      bool verified = false;
      File check = LittleFS.open("/config.txt", "r");
      if (check) {
        String content = check.readString();
        check.close();
        verified = (content.length() > 0) &&
                   (content.indexOf(String("\"formatVersion\":") + String(CONFIG_FORMAT_VERSION)) >= 0);
      }
      Serial.printf("[CFG] Конфигурация сохранена (%u Б, проверка чтением: %s)\n",
                    (unsigned)bytesWritten, verified ? "OK" : "ОШИБКА");
      if (!verified) {
        Serial.println("[CFG] ВНИМАНИЕ: файл конфигурации не прошёл проверку — оставлена копия /config.bak");
      }
      dumpToSerial();

      Event event;
      event.type = EventType::CONFIG_CHANGED;
      event.timestamp = millis();
      EventBus::publish(event);
      return true;
    } else {
      Serial.println("[CFG] Ошибка переименования файла");
      LittleFS.remove("/config.tmp");
      return false;
    }
  }

  static float getPressureMin() {
    return currentConfig.pressureMin;
  }
  static float getPressureMax() {
    return currentConfig.pressureMax;
  }
  static float getTiltThresholdX() {
    return currentConfig.tiltThresholdX;
  }
  static float getTiltThresholdY() {
    return currentConfig.tiltThresholdY;
  }
  static int getContrast() {
    return currentConfig.contrast;
  }
  static int getNivCount() {
    return currentConfig.nivCount;
  }
  static int getTimeInterval() {
    return currentConfig.timeInterval;
  }
  static int getInflateDelay() {
    return currentConfig.inflateDelay;
  }
  static int getReleaseDelay() {
    return currentConfig.releaseDelay;
  }
  static float getMovementPressureFront() {
    return currentConfig.movementPressureFront;
  }
  static float getMovementPressureRear() {
    return currentConfig.movementPressureRear;
  }

  static float getMovementPressure(int pad) {
    return (pad == PAD_FRONT_LEFT || pad == PAD_FRONT_RIGHT)
             ? currentConfig.movementPressureFront
             : currentConfig.movementPressureRear;
  }

  static void setPressureMin(float v) {
    currentConfig.pressureMin = v;
  }
  static void setPressureMax(float v) {
    currentConfig.pressureMax = v;
  }
  static void setTiltThresholdX(float v) {
    currentConfig.tiltThresholdX = v;
  }
  static void setTiltThresholdY(float v) {
    currentConfig.tiltThresholdY = v;
  }
  static void setContrast(int v) {
    currentConfig.contrast = v;
  }
  static void setNivCount(int v) {
    currentConfig.nivCount = v;
  }
  static void setTimeInterval(int v) {
    currentConfig.timeInterval = v;
  }
  static void setInflateDelay(int v) {
    currentConfig.inflateDelay = v;
  }
  static void setReleaseDelay(int v) {
    currentConfig.releaseDelay = v;
  }
  static void setMovementPressureFront(float v) {
    currentConfig.movementPressureFront = v;
  }
  static void setMovementPressureRear(float v) {
    currentConfig.movementPressureRear = v;
  }

  /* ===== 8.8.0: аксессоры новых параметров ===== */
#define CFG_INT_ACCESSOR(Name, field)                     \
  static int get##Name() { return currentConfig.field; }  \
  static void set##Name(int v) { currentConfig.field = v; }
#define CFG_FLOAT_ACCESSOR(Name, field)                     \
  static float get##Name() { return currentConfig.field; }  \
  static void set##Name(float v) { currentConfig.field = v; }

  CFG_INT_ACCESSOR(MasterCheckSec, masterCheckSec)
  CFG_INT_ACCESSOR(ManualMaxTimeSec, manualMaxTimeSec)
  CFG_FLOAT_ACCESSOR(PressureDeadband, pressureDeadband)
  CFG_FLOAT_ACCESSOR(CoarseZoneRatio, coarseZoneRatio)
  CFG_FLOAT_ACCESSOR(FineZoneRatio, fineZoneRatio)
  CFG_FLOAT_ACCESSOR(WorseningRatio, worseningRatio)
  CFG_INT_ACCESSOR(MovementDurationSec, movementDurationSec)
  CFG_INT_ACCESSOR(MovementSettleSec, movementSettleSec)
  CFG_INT_ACCESSOR(MovementCheckSec, movementCheckSec)
  CFG_FLOAT_ACCESSOR(MovementTolerance, movementTolerance)
  CFG_INT_ACCESSOR(GyroThreshold, gyroThreshold)
  CFG_INT_ACCESSOR(AccelThreshold, accelThreshold)
  CFG_INT_ACCESSOR(BacklightOffMin, backlightOffMin)
  CFG_INT_ACCESSOR(FrameMs, frameMs)
  CFG_FLOAT_ACCESSOR(RedrawAngleThr, redrawAngleThr)
  CFG_FLOAT_ACCESSOR(RedrawPressureThr, redrawPressureThr)
  CFG_INT_ACCESSOR(ImuMotionDet, imuMotionDet)
  CFG_INT_ACCESSOR(ImuGyroOffX, imuGyroOffX)
  CFG_INT_ACCESSOR(ImuGyroOffY, imuGyroOffY)
  CFG_INT_ACCESSOR(ImuGyroOffZ, imuGyroOffZ)
  CFG_INT_ACCESSOR(ImuAccelOffX, imuAccelOffX)
  CFG_INT_ACCESSOR(ImuAccelOffY, imuAccelOffY)
  CFG_INT_ACCESSOR(ImuAccelOffZ, imuAccelOffZ)
  CFG_FLOAT_ACCESSOR(ZeroAngleX, zeroAngleX)
  CFG_FLOAT_ACCESSOR(ZeroAngleY, zeroAngleY)
#undef CFG_INT_ACCESSOR
#undef CFG_FLOAT_ACCESSOR

  /** 8.8.0: разовый перенос офсетов IMU (после калибровки) — без отдельных сеттеров. */
  static void setImuOffsets(int gx, int gy, int gz, int ax, int ay, int az) {
    currentConfig.imuGyroOffX = gx;
    currentConfig.imuGyroOffY = gy;
    currentConfig.imuGyroOffZ = gz;
    currentConfig.imuAccelOffX = ax;
    currentConfig.imuAccelOffY = ay;
    currentConfig.imuAccelOffZ = az;
  }

  /** 8.8.0: печать всех параметров конфигурации в Serial (проверка после загрузки и сохранения). */
  static void dumpToSerial() {
    Serial.printf("[CFG] v%u | Pmin=%.2f Pmax=%.2f Наклон X=%.2f Y=%.2f Ярк=%d Попыток=%d Инт=%d СБРОС=%d НАКАЧ=%d\n",
                  (unsigned)currentConfig.formatVersion, currentConfig.pressureMin, currentConfig.pressureMax,
                  currentConfig.tiltThresholdX, currentConfig.tiltThresholdY, currentConfig.contrast,
                  currentConfig.nivCount, currentConfig.timeInterval,
                  currentConfig.releaseDelay, currentConfig.inflateDelay);
    Serial.printf("[CFG] Движение: перед=%.2f зад=%.2f длит=%dс усп=%dс пров=%dс доп=%.2f гиро=%d акс=%d\n",
                  currentConfig.movementPressureFront, currentConfig.movementPressureRear,
                  currentConfig.movementDurationSec, currentConfig.movementSettleSec, currentConfig.movementCheckSec,
                  currentConfig.movementTolerance, currentConfig.gyroThreshold, currentConfig.accelThreshold);
    Serial.printf("[CFG] Магистраль=%dс | Клапаны: макс=%dс зона=%.2f | Авто: грубая=%.2f точная=%.2f хуже=%.2f\n",
                  currentConfig.masterCheckSec, currentConfig.manualMaxTimeSec, currentConfig.pressureDeadband,
                  currentConfig.coarseZoneRatio, currentConfig.fineZoneRatio, currentConfig.worseningRatio);
    Serial.printf("[CFG] Дисплей: подсветка=%dмин кадр=%dмс углы=%.2f давл=%.2f | IMU: det=%d гиро=%d,%d,%d акс=%d,%d,%d нуль=%.2f,%.2f\n",
                  currentConfig.backlightOffMin, currentConfig.frameMs, currentConfig.redrawAngleThr,
                  currentConfig.redrawPressureThr, currentConfig.imuMotionDet,
                  currentConfig.imuGyroOffX, currentConfig.imuGyroOffY, currentConfig.imuGyroOffZ,
                  currentConfig.imuAccelOffX, currentConfig.imuAccelOffY, currentConfig.imuAccelOffZ,
                  currentConfig.zeroAngleX, currentConfig.zeroAngleY);
  }
};

ConfigManager::Config ConfigManager::currentConfig;



/* ====================  ErrorHandler ==================== */
class ErrorHandler {
public:
  enum class Error : uint8_t {
    NONE = 0,
    LOW_PRESSURE,
    MPU,
    SENSOR,
    VALVE,
    WATCHDOG,
    OTA,
    COUNT
  };

  struct ActiveError {
    Error error;
    uint32_t lastSeenTime;
  };

  struct PendingClear {
    Error error;
    uint32_t clearRequestTime;
  };

  // ========== ДОБАВЛЕН МЬЮТЕКС ==========
  static SemaphoreHandle_t mutex_;

  static ActiveError activeErrors[8];
  static uint8_t activeCount;
  static PendingClear pendingClear[8];
  static uint8_t pendingCount;
  static constexpr uint32_t ERROR_TIMEOUT_MS = 3000;
  static uint8_t currentDisplayIndex;
  static uint32_t lastDisplaySwitch;
  static bool hasError;

  // ========== ИНИЦИАЛИЗАЦИЯ МЬЮТЕКСА ==========
  static bool initMutex() {
    mutex_ = xSemaphoreCreateMutex();
    return mutex_ != nullptr;
  }

  static void handleError(Error error, const char *message) {
    if ((uint8_t)error >= (uint8_t)Error::COUNT) {
      Serial.printf("[ERROR] Invalid error code %d\n", (int)error);
      return;
    }

    if (error == Error::LOW_PRESSURE) {
      static uint32_t lastAttempt = 0;
      if (millis() - lastAttempt < 1500) return;
      lastAttempt = millis();
    }

    MutexGuard guard(mutex_, pdMS_TO_TICKS(100));
    if (!guard) {
      Serial.println("[ERROR] Failed to lock mutex in handleError!");
      return;
    }

    Serial.printf("[ERROR] %s\n", message);
    removeFromPendingClearLocked(error);
    updateActiveBufferLocked(error);
    hasError = true;

    if (isCriticalError(error)) emergencyStop();

    Event event;
    event.type = EventType::ERROR_OCCURRED;
    event.timestamp = millis();
    event.data.error.errorCode = static_cast<uint8_t>(error);
    strncpy(event.data.error.message, message, sizeof(event.data.error.message) - 1);
    EventBus::publish(event);
  }

  static void updateErrorTime(Error error) {
    bool found = false;

    // Проверяем, есть ли уже такая ошибка
    {
      MutexGuard guard(mutex_, pdMS_TO_TICKS(100));
      if (guard) {
        for (int i = 0; i < activeCount; i++) {
          if (activeErrors[i].error == error) {
            activeErrors[i].lastSeenTime = millis();
            found = true;
            break;
          }
        }
      }
      // Мьютекс освободится здесь автоматически
    }

    // Если не нашли - создаем новую (без мьютекса, handleError сама захватит)
    if (!found) {
      handleError(error, "Error detected");
    }
  }

  static void markErrorCleared(Error error) {
    MutexGuard guard(mutex_, pdMS_TO_TICKS(100));
    if (!guard) return;

    bool found = false;
    for (int i = 0; i < activeCount; i++) {
      if (activeErrors[i].error == error) {
        found = true;
        break;
      }
    }
    if (!found) return;

    for (int i = 0; i < pendingCount; i++) {
      if (pendingClear[i].error == error) {
        pendingClear[i].clearRequestTime = millis();
        return;
      }
    }

    if (pendingCount < 8) {
      pendingClear[pendingCount].error = error;
      pendingClear[pendingCount].clearRequestTime = millis();
      pendingCount++;
      Serial.printf("[ERROR] Ошибка %d будет удалена через 3 сек\n", (int)error);
    }
  }

  static bool isCriticalError(Error error) {
    return error == Error::MPU || error == Error::VALVE || error == Error::WATCHDOG;
  }

  static void forceClearAllErrors() {
    MutexGuard guard(mutex_, pdMS_TO_TICKS(100));
    if (!guard) return;

    activeCount = 0;
    pendingCount = 0;
    hasError = false;
    errorScreenBlocking = false;
    currentDisplayIndex = 0;
    lastDisplaySwitch = 0;
    memset(activeErrors, 0, sizeof(activeErrors));
    memset(pendingClear, 0, sizeof(pendingClear));
    forceDisplayReset(true);
    Serial.println("[ERROR] Все ошибки сброшены");
  }

  static bool getErrorInfo(int index, Error &error, int &total) {
    MutexGuard guard(mutex_, pdMS_TO_TICKS(100));
    if (!guard) return false;

    pruneActiveBufferLocked();
    total = activeCount;
    if (index >= 0 && index < activeCount) {
      error = activeErrors[index].error;
      return true;
    }
    return false;
  }

  static bool hasActiveErrors() {
    MutexGuard guard(mutex_, pdMS_TO_TICKS(100));
    if (!guard) return false;
    pruneActiveBufferLocked();
    return activeCount > 0;
  }

  static int getActiveErrorCount() {
    MutexGuard guard(mutex_, pdMS_TO_TICKS(100));
    if (!guard) return 0;
    pruneActiveBufferLocked();
    return activeCount;
  }

  static bool isErrorActive(Error error) {
    MutexGuard guard(mutex_, pdMS_TO_TICKS(100));
    if (!guard) return false;
    pruneActiveBufferLocked();
    for (int i = 0; i < activeCount; i++) {
      if (activeErrors[i].error == error) return true;
    }
    return false;
  }

  static void removeError(Error error) {
    MutexGuard guard(mutex_, pdMS_TO_TICKS(100));
    if (!guard) return;

    for (int i = 0; i < activeCount; i++) {
      if (activeErrors[i].error == error) {
        for (int j = i; j < activeCount - 1; j++) {
          activeErrors[j] = activeErrors[j + 1];
        }
        activeCount--;
        break;
      }
    }
    removeFromPendingClearLocked(error);

    if (activeCount == 0) {
      hasError = false;
      errorScreenBlocking = false;
      forceDisplayReset(true);
    }
    displayDirty = true;
  }

  static Error getCurrentActiveError() {
    MutexGuard guard(mutex_, pdMS_TO_TICKS(100));
    if (!guard) return Error::NONE;

    pruneActiveBufferLocked();
    if (activeCount == 0) return Error::NONE;

    if (currentDisplayIndex >= activeCount) {
      currentDisplayIndex = 0;
    }

    uint32_t now = millis();
    static bool initialized = false;
    if (!initialized) {
      initialized = true;
      currentDisplayIndex = 0;
      lastDisplaySwitch = now;
    }

    if (activeCount > 1 && (now - lastDisplaySwitch) >= 2000) {
      currentDisplayIndex = (currentDisplayIndex + 1) % activeCount;
      lastDisplaySwitch = now;
    }

    if (currentDisplayIndex >= activeCount) {
      currentDisplayIndex = 0;
    }

    return activeErrors[currentDisplayIndex].error;
  }

  static int getCurrentDisplayIndex() {
    MutexGuard guard(mutex_, pdMS_TO_TICKS(100));
    if (!guard) return 0;
    return currentDisplayIndex;
  }

  static Error getActiveErrorAt(int index) {
    MutexGuard guard(mutex_, pdMS_TO_TICKS(100));
    if (!guard) return Error::NONE;
    pruneActiveBufferLocked();
    if (index >= 0 && index < activeCount) {
      return activeErrors[index].error;
    }
    return Error::NONE;
  }

  static const char *getErrorMessage(Error error) {
    switch (error) {
      case Error::NONE: return "НЕТ ОШИБКИ";
      case Error::LOW_PRESSURE: return "НИЗКОЕ ДАВЛЕНИЕ";
      case Error::MPU: return "ОШИБКА MPU6050";
      case Error::SENSOR: return "ОШИБКА ДАТЧИКА ДАВЛЕНИЯ";
      case Error::VALVE: return "ОШИБКА КЛАПАНА";
      case Error::WATCHDOG: return "ОШИБКА WATCHDOG";
      case Error::OTA: return "ОШИБКА OTA";
      default: return "НЕИЗВЕСТНАЯ ОШИБКА";
    }
  }

  static bool isPendingClear(Error error) {
    MutexGuard guard(mutex_, pdMS_TO_TICKS(100));
    if (!guard) return false;
    for (int i = 0; i < pendingCount; i++) {
      if (pendingClear[i].error == error) return true;
    }
    return false;
  }

static void cancelClear(Error error) {
    MutexGuard guard(mutex_, pdMS_TO_TICKS(100));
    if (!guard) return;
    
    for (int i = 0; i < pendingCount; i++) {
        if (pendingClear[i].error == error) {
            for (int j = i; j < pendingCount - 1; j++) {
                pendingClear[j] = pendingClear[j + 1];
            }
            pendingCount--;
            Serial.printf("[ERROR] Отменено удаление ошибки %d\n", (int)error);
            return;
        }
    }
}

private:
  static void updateActiveBufferLocked(Error error) {
    uint32_t now = millis();
    for (int i = 0; i < activeCount; i++) {
      if (activeErrors[i].error == error) {
        activeErrors[i].lastSeenTime = now;
        return;
      }
    }
    if (activeCount < 8) {
      activeErrors[activeCount].error = error;
      activeErrors[activeCount].lastSeenTime = now;
      activeCount++;
    }
  }

  static void removeFromPendingClearLocked(Error error) {
    for (int i = 0; i < pendingCount; i++) {
      if (pendingClear[i].error == error) {
        for (int j = i; j < pendingCount - 1; j++) {
          pendingClear[j] = pendingClear[j + 1];
        }
        pendingCount--;
        break;
      }
    }
  }

  static void pruneActiveBufferLocked() {
    uint32_t now = millis();
    bool anyRemoved = false;

    for (int i = 0; i < pendingCount;) {
      if (now - pendingClear[i].clearRequestTime > ERROR_TIMEOUT_MS) {
        bool found = false;
        for (int j = 0; j < activeCount; j++) {
          if (activeErrors[j].error == pendingClear[i].error) {
            for (int k = j; k < activeCount - 1; k++) {
              activeErrors[k] = activeErrors[k + 1];
            }
            activeCount--;
            found = true;
            anyRemoved = true;
            Serial.printf("[ERROR] Удалена ошибка %d\n", (int)pendingClear[i].error);
            break;
          }
        }

        for (int k = i; k < pendingCount - 1; k++) {
          pendingClear[k] = pendingClear[k + 1];
        }
        pendingCount--;
      } else {
        i++;
      }
    }

    if (anyRemoved) {
      displayDirty = true;
    }

    if (activeCount == 0 && hasError) {
      hasError = false;
      errorScreenBlocking = false;
      forceDisplayReset(true);
      Serial.println("[ERROR] Все ошибки удалены");
    }
  }
};

// ========== ОПРЕДЕЛЕНИЕ СТАТИЧЕСКИХ ЧЛЕНОВ ==========
SemaphoreHandle_t ErrorHandler::mutex_ = nullptr;
ErrorHandler::ActiveError ErrorHandler::activeErrors[8];
uint8_t ErrorHandler::activeCount = 0;
ErrorHandler::PendingClear ErrorHandler::pendingClear[8];
uint8_t ErrorHandler::pendingCount = 0;
uint8_t ErrorHandler::currentDisplayIndex = 0;
uint32_t ErrorHandler::lastDisplaySwitch = 0;
bool ErrorHandler::hasError = false;



class ZeroCalibrator {
private:
  bool calibrationDone_ = false;
  uint32_t stepStartTime_ = 0;
  enum CalibStep : uint8_t {
    STEP_IDLE,
    STEP_OPEN_VALVE,
    STEP_WAIT_STABILIZE,
    STEP_MEASURE,
    STEP_CLOSE_VALVE,
    STEP_DONE
  } currentStep_ = STEP_IDLE;
  int measurements_[20] = { 0 };
  uint8_t measureCount_ = 0;
  int finalZeroValue_ = 0;
  
  // Константы калибровки
  static constexpr int ZERO_MIN = 80;      // Минимальное значение АЦП при 0 давлении
  static constexpr int ZERO_MAX = 140;     // Максимальное значение АЦП при 0 давлении
  static constexpr int ZERO_ERROR_THRESHOLD_LOW = 50;   // Ниже этого - обрыв цепи
  static constexpr int ZERO_ERROR_THRESHOLD_HIGH = 180;  // Выше этого - завышение

public:
  void start() {
    if (calibrationDone_) {
      Serial.println("[CALIB] start() ignored - already done");
      return;
    }
    if (currentStep_ != STEP_IDLE) {
      Serial.println("[CALIB] start() ignored - already started");
      return;
    }

#if ENABLE_SIMULATION
    Serial.println("[CALIB] SIM: Запуск калибровки пропущен");
    calibrationDone_ = true;
    return;
#else
    calibrationDone_ = false;
    currentStep_ = STEP_OPEN_VALVE;
    stepStartTime_ = millis();
    measureCount_ = 0;
    
    int testRaw = ads.readADC_SingleEnded(ADS1015_PRESSURE_CHANNEL);
    Serial.printf("[CALIB] start(): testRaw=%d\n", testRaw);
    
    for (int i = 0; i < 5; i++) {
        int raw = ads.readADC_SingleEnded(ADS1015_PRESSURE_CHANNEL);
        if (raw > 10 && raw < 2040) {
            pressureFilter.filtered(raw);
        }
        vTaskDelay(pdMS_TO_TICKS(50));
    }
    Serial.println("[CALIB] Фильтр инициализирован");
    
    Serial.println("\n========================================");
    Serial.println("     АВТОМАТИЧЕСКАЯ КАЛИБРОВКА НУЛЯ");
    Serial.println("========================================");
#endif
  }

  void process() {
    if (calibrationDone_) return;

#if ENABLE_SIMULATION
    calibrationDone_ = true;
    Serial.println("[CALIB] SIM: Калибровка пропущена");
    return;
#endif

    uint32_t now = millis();

    switch (currentStep_) {
      case STEP_OPEN_VALVE:
        {
          MutexGuard guard(xValveMutex);
          if (guard) {
            closeAllValves();
            digitalWrite(PIN_DEFL, HIGH);
            Serial.println("[CALIB] Клапан сброса ОТКРЫТ");
            currentStep_ = STEP_WAIT_STABILIZE;
            stepStartTime_ = now;
          }
          break;
        }

      case STEP_WAIT_STABILIZE:
        {
          uint32_t elapsed = now - stepStartTime_;
          if (elapsed >= 3000) {
            Serial.printf("[CALIB] Ожидание стабилизации завершено (прошло %d мс)\n", elapsed);
            currentStep_ = STEP_MEASURE;
            stepStartTime_ = now;
            measureCount_ = 0;
          }
          break;
        }

      case STEP_MEASURE:
        if (measureCount_ < 20) {
          static uint32_t lastMeasureTime = 0;
          if (now - lastMeasureTime >= 200) {
            int raw = ads.readADC_SingleEnded(ADS1015_PRESSURE_CHANNEL);

#if ENABLE_SIMULATION
            if (raw == 0) raw = 512;
#endif

            if (raw == 0) {
              static uint32_t lastWarn = 0;
              if (now - lastWarn > 3000) {
                lastWarn = now;
                Serial.printf("[CALIB] ⚠️ Ошибка чтения ADS1015! raw=%d (пропуск)\n", raw);
              }
              lastMeasureTime = now;  // не копим одно и то же, ждём следующее окно
              break;
            }

            int filtered = pressureFilter.filtered(raw);
            measurements_[measureCount_++] = filtered;
            lastMeasureTime = now;

            Serial.printf("[CALIB] Измерение %d: raw=%d, filtered=%d\n",
                          measureCount_, raw, filtered);
          }
        } else {
          // Вычисляем среднее
          long sum = 0;
          int minVal = measurements_[5];
          int maxVal = measurements_[5];

          for (int i = 5; i < 20; i++) {
            sum += measurements_[i];
            if (measurements_[i] < minVal) minVal = measurements_[i];
            if (measurements_[i] > maxVal) maxVal = measurements_[i];
          }

          int range = maxVal - minVal;
          finalZeroValue_ = sum / 15;

          Serial.printf("[CALIB] Среднее (последние 15): %d, Разброс: %d\n",
                        finalZeroValue_, range);

          // ============================================================
          // ✅ ПРОВЕРКА ДАТЧИКА
          // ============================================================
          
          // 1. Проверка на обрыв цепи (слишком низкое значение)
          if (finalZeroValue_ < ZERO_ERROR_THRESHOLD_LOW) {
            Serial.printf("[CALIB] ❌ ОБРЫВ ЦЕПИ! АЦП=%d (норма: %d-%d)\n",
                          finalZeroValue_, ZERO_MIN, ZERO_MAX);
            if (!ErrorHandler::isErrorActive(ErrorHandler::Error::SENSOR)) {
              ErrorHandler::handleError(ErrorHandler::Error::SENSOR,
                                        "Датчик давления - обрыв цепи");
            } else {
              ErrorHandler::updateErrorTime(ErrorHandler::Error::SENSOR);
            }
            // Сохраняем значение, но помечаем как невалидное
            calibrationValid = false;
          }
          // 2. Проверка на КЗ (слишком высокое значение)
          else if (finalZeroValue_ > ZERO_ERROR_THRESHOLD_HIGH) {
            Serial.printf("[CALIB] ❌ ДАТЧИК ЗАВЫШАЕТ ПОКАЗАНИЯ! АЦП=%d (норма: %d-%d)\n",
                          finalZeroValue_, ZERO_MIN, ZERO_MAX);
            Serial.println("[CALIB] При открытом клапане сброса давление должно быть 0");
            Serial.println("[CALIB] Датчик завышает показания! Требуется проверка.");
            
            if (!ErrorHandler::isErrorActive(ErrorHandler::Error::SENSOR)) {
              ErrorHandler::handleError(ErrorHandler::Error::SENSOR,
                                        "Датчик давления завышает показания");
            } else {
              ErrorHandler::updateErrorTime(ErrorHandler::Error::SENSOR);
            }
            // Сохраняем значение, но помечаем как невалидное
            calibrationValid = false;
          }
          // 3. Датчик исправен
          else if (finalZeroValue_ >= ZERO_MIN && finalZeroValue_ <= ZERO_MAX) {
            Serial.printf("[CALIB] ✅ Датчик исправен (АЦП=%d в норме %d-%d)\n",
                          finalZeroValue_, ZERO_MIN, ZERO_MAX);
            
            // Удаляем ошибку SENSOR, если она была
            if (ErrorHandler::isErrorActive(ErrorHandler::Error::SENSOR)) {
              ErrorHandler::removeError(ErrorHandler::Error::SENSOR);
              Serial.println("[CALIB] Ошибка SENSOR удалена (датчик исправен)");
            }
            calibrationValid = true;
          }
          // 4. Пограничное значение - предупреждение
          else {
            Serial.printf("[CALIB] ⚠️ НЕОБЫЧНОЕ ЗНАЧЕНИЕ НУЛЯ: %d! (норма: %d-%d)\n",
                          finalZeroValue_, ZERO_MIN, ZERO_MAX);
            Serial.println("[CALIB] Датчик работает, но возможны проблемы.");
            // Не создаём ошибку, но помечаем как сомнительное
            calibrationValid = true;
          }

          // Проверка стабильности
          if (range > 15) {
            Serial.printf("[CALIB] ⚠️ Нестабильные измерения! Разброс: %d\n", range);
            Serial.println("[CALIB] Возможны проблемы с питанием или датчиком.");
          }

          currentStep_ = STEP_CLOSE_VALVE;
          stepStartTime_ = now;
        }
        break;

      case STEP_CLOSE_VALVE:
        {
          MutexGuard guard(xValveMutex);
          if (guard) {
            digitalWrite(PIN_DEFL, LOW);
            Serial.println("[CALIB] Клапан сброса ЗАКРЫТ");
            currentStep_ = STEP_DONE;
          }
          break;
        }

      case STEP_DONE:
        {
          MutexGuard guard(xCalibMutex);
          if (guard) {
            int correctedZero = finalZeroValue_;
            if (correctedZero < 0) correctedZero = 0;

            // Сохраняем значение даже если датчик неисправен
            g_pressureZeroRaw = correctedZero;
            calibrationDone_ = true;
            
            // Если датчик исправен - устанавливаем флаг
            if (calibrationValid) {
              calibrationValid = true;
            }

            Serial.printf("[CALIB] Исходное среднее: %d\n", finalZeroValue_);
            Serial.printf("[CALIB] Новая калибровка: filtered -= %d\n", g_pressureZeroRaw);
            Serial.println("========================================");
            Serial.println("     КАЛИБРОВКА НУЛЯ ЗАВЕРШЕНА");
            Serial.println("========================================\n");

            Event event;
            event.type = EventType::CALIBRATION_DONE;
            event.timestamp = millis();
            EventBus::publish(event);
          }
          break;
        }

      default: break;
    }
  }

  bool isDone() const {
    return calibrationDone_;
  }
  int getZeroValue() const {
    return finalZeroValue_;
  }
};


/* ====================  ПЕРЕМЕННЫЕ ДЛЯ СИМУЛЯЦИИ ==================== */
// Эти переменные используются даже когда симуляция выключена
float simAngleX = 0;
float simAngleY = 0;
float simPressures[PAD_COUNT] = { 2.0f, 2.5f, 3.0f, 3.5f };
float simMasterPressure = 4.0f;
int simDirectionX = 1;
int simDirectionY = 1;
uint32_t lastSimUpdate = 0;

// ✅ ДОБАВЛЕНО: Эти переменные теперь всегда объявлены
// чтобы их можно было использовать в forceDisplayReset()
static uint32_t menuAutoEnterTime = 0;
static bool menuAutoEnterDone = false;
static bool errorSimulated = false;
static ErrorHandler::Error simulatedError = ErrorHandler::Error::NONE;

#if ENABLE_SIMULATION
// Эти переменные нужны только когда симуляция включена
static uint32_t lastAutoSimTime = 0;
static uint32_t autoSimPhase = 0;
static uint32_t lastErrorSimTime = 0;
#endif





/* ====================  Logger ==================== */
class Logger {
public:
  enum Level { DEBUG = 0,
               INFO = 1,
               WARNING = 2,
               ERROR = 3 };

  static void log(Level level, const char *tag, const char *message) {
    const char *levelStr[] = { "DEBUG", "INFO", "WARNING", "ERROR" };
    Serial.printf("[%s][%s] %s\n", levelStr[level], tag, message);
  }

  static void logf(Level level, const char *tag, const char *format, ...) {
    const char *levelStr[] = { "DEBUG", "INFO", "WARNING", "ERROR" };
    Serial.printf("[%s][%s] ", levelStr[level], tag);
    va_list args;
    va_start(args, format);
    vprintf(format, args);
    va_end(args);
    Serial.println();
  }
};

/* ====================  TaskMonitor ==================== */
class TaskMonitor {
private:
  struct TaskInfo {
    const char *name;
    uint32_t lastRunTime;
    bool isRunning;
  };
  static TaskInfo tasks[TASK_COUNT];

public:
  enum TaskIndex : uint8_t {
    TASK_EVENT = 0,
    TASK_BUTTON,
    TASK_DISPLAY,
    TASK_IMU,
    TASK_PRESSURE,
    TASK_CONTROL,
    TASK_CALIB,
    TASK_WATCHDOG,
    TASK_OTA,
    TASK_VALVE,
    TASK_ERROR_RECOVERY
  };

  static void updateTaskStatus(TaskIndex index) {
    tasks[index].lastRunTime = millis();
    tasks[index].isRunning = true;
  }

  static void checkTasks() {
    uint32_t currentTime = millis();
    for (int i = 0; i < TASK_COUNT; i++) {
      if (currentTime - tasks[i].lastRunTime > TASK_WDT_TIMEOUT_MS) {
        Logger::logf(Logger::ERROR, "WATCHDOG", "Task %s is not responding", tasks[i].name);
        ErrorHandler::handleError(ErrorHandler::Error::WATCHDOG, "Task timeout");
      }
    }
  }

  static void init() {
    tasks[TASK_EVENT] = { "Event", 0, false };
    tasks[TASK_BUTTON] = { "Button", 0, false };
    tasks[TASK_DISPLAY] = { "Display", 0, false };
    tasks[TASK_IMU] = { "IMU", 0, false };
    tasks[TASK_PRESSURE] = { "Pressure", 0, false };
    tasks[TASK_CONTROL] = { "Control", 0, false };
    tasks[TASK_CALIB] = { "Calib", 0, false };
    tasks[TASK_WATCHDOG] = { "Watchdog", 0, false };
    tasks[TASK_OTA] = { "OTA", 0, false };
    tasks[TASK_VALVE] = { "Valve", 0, false };
    tasks[TASK_ERROR_RECOVERY] = { "ErrorRecovery", 0, false };
  }
};

TaskMonitor::TaskInfo TaskMonitor::tasks[TASK_COUNT];

/* ====================  MemoryMonitor ==================== */
class MemoryMonitor {
private:
  static uint32_t lastCheckTime;
  static uint32_t minFreeHeap;
  static uint32_t lastWarningTime;
  static constexpr uint32_t LOW_MEMORY_THRESHOLD = 8192;
  static constexpr uint32_t CRITICAL_MEMORY_THRESHOLD = 4096;
  static bool lowMemoryReported;
  static bool criticalMemoryReported;

public:
  static void init() {
    lastCheckTime = millis();
    minFreeHeap = ESP.getFreeHeap();
    lastWarningTime = 0;
    lowMemoryReported = false;
    criticalMemoryReported = false;
    Serial.printf("[MEM] Начально свободно: %d байт\n", minFreeHeap);
  }

  static void checkMemory() {
    uint32_t currentFree = ESP.getFreeHeap();
    uint32_t now = millis();

    if (currentFree < minFreeHeap) {
      minFreeHeap = currentFree;
      Serial.printf("[MEM] Новый минимум: %d байт\n", minFreeHeap);
    }

    if (currentFree < CRITICAL_MEMORY_THRESHOLD) {
      if (!criticalMemoryReported) {
        criticalMemoryReported = true;
        Serial.printf("[MEM] ⚠️ КРИТИЧЕСКИЙ УРОВЕНЬ ПАМЯТИ! %d байт\n", currentFree);

        Event event;
        event.type = EventType::CRITICAL_MEMORY;
        event.timestamp = now;
        event.data.memory.freeHeap = currentFree;
        event.data.memory.minHeap = minFreeHeap;
        EventBus::publish(event);

        emergencyStop();
        closeAllValves();
      }
    } else if (currentFree < LOW_MEMORY_THRESHOLD) {
      if (!lowMemoryReported && (now - lastWarningTime > 60000)) {
        lowMemoryReported = true;
        lastWarningTime = now;
        Serial.printf("[MEM] ⚠️ НИЗКИЙ УРОВЕНЬ ПАМЯТИ! %d байт\n", currentFree);

        Event event;
        event.type = EventType::LOW_MEMORY_WARNING;
        event.timestamp = now;
        event.data.memory.freeHeap = currentFree;
        event.data.memory.minHeap = minFreeHeap;
        EventBus::publish(event);
      }
    } else {
      if (criticalMemoryReported && currentFree > CRITICAL_MEMORY_THRESHOLD + 2048) {
        criticalMemoryReported = false;
        Serial.printf("[MEM] ✅ Память восстановлена: %d байт\n", currentFree);
      }
      if (lowMemoryReported && currentFree > LOW_MEMORY_THRESHOLD + 2048) {
        lowMemoryReported = false;
        Serial.printf("[MEM] ✅ Уровень памяти нормализован: %d байт\n", currentFree);
      }
    }

    if (now - lastCheckTime > 60000) {
      lastCheckTime = now;
      Serial.printf("[MEM] Свободно: %d байт (минимум: %d)\n", currentFree, minFreeHeap);
    }
  }
};

uint32_t MemoryMonitor::lastCheckTime = 0;
uint32_t MemoryMonitor::minFreeHeap = 0;
uint32_t MemoryMonitor::lastWarningTime = 0;
bool MemoryMonitor::lowMemoryReported = false;
bool MemoryMonitor::criticalMemoryReported = false;

/* ====================  РЕАЛИЗАЦИЯ ФУНКЦИЙ ==================== */

void setDisplayDirty() {
  displayDirty = true;
  Event event;
  event.type = EventType::DISPLAY_UPDATE;
  event.timestamp = millis();
  EventBus::publish(event, 0);
}

void closeAllValves() {
  for (auto pin : bubPins) digitalWrite(pin, LOW);
  digitalWrite(PIN_INFL, LOW);
  digitalWrite(PIN_DEFL, LOW);
}

void setValve(Pad pad, bool state) {
  if (pad >= PAD_COUNT) return;
  digitalWrite(bubPins[pad], state);
}

void emergencyStop() {
  static SemaphoreHandle_t mutex = nullptr;
  if (mutex == nullptr) mutex = xSemaphoreCreateMutex();

  if (!takeMutexWithRetry(mutex, pdMS_TO_TICKS(100), 3, "emergencyStop/outer")) {
    Serial.println("[EMERGENCY] outer mutex failed — forcing valve pins LOW");
    for (auto pin : bubPins) digitalWrite(pin, LOW);
    digitalWrite(PIN_INFL, LOW);
    digitalWrite(PIN_DEFL, LOW);
    valveStopRequested = true;
    return;
  }

  if (!takeMutexWithRetry(xValveMutex, pdMS_TO_TICKS(150), 3, "emergencyStop/valve")) {
    Serial.println("[EMERGENCY] valve mutex failed — forcing valve pins LOW");
    closeAllValves();
    valveStopRequested = true;
    xSemaphoreGive(mutex);
    return;
  }

  Logger::log(Logger::WARNING, "EMERGENCY", "Остановка всех клапанов!");
  closeAllValves();
  manualControlActive = false;
  for (int i = 0; i < PAD_COUNT; i++) {
    manualTargetSet[i] = false;
  }
  valveStopRequested = true;
  valveEmergencyStopCount++;
  xSemaphoreGive(xValveMutex);
  xSemaphoreGive(mutex);
}

void sendValveCommand(Pad pad, bool inflate, uint32_t durationMs) {
  for (int attempt = 0; attempt < 3; attempt++) {
    MutexGuard commandGuard(xCommandMutex, pdMS_TO_TICKS(100));
    if (!commandGuard) {
      if (attempt == 2) {
        Serial.println("[VALVE] Command state mutex unavailable after retries");
      }
      continue;
    }

    if (xValveQueue == nullptr) {
      Serial.println("[ERROR] Valve queue not created!");
      return;
    }

    if (otaMode || otaInProgress || otaValveLock) {
      Serial.println("[VALVE] Command rejected while OTA mode is active");
      lastCmd.waitingForCompletion = false;
      lastCmd.commandActive = false;
      return;
    }

    if (pad >= PAD_COUNT) {
      Serial.printf("[ERROR] Invalid pad: %d\n", (int)pad);
      return;
    }

    if (durationMs > 0) {
      float currentMaster;
      {
        MutexGuard guard(xStateMutex);
        if (!guard) return;
        currentMaster = masterPressure;
      }

      float minPressure = ConfigManager::getPressureMin();
      if (currentMaster < minPressure - ConfigManager::getPressureDeadband()) {
        static uint32_t lastLog = 0;
        if (millis() - lastLog > 5000) {
          lastLog = millis();
          Serial.printf("[VALVE] ❌ Команда заблокирована! Давление: %.1f бар (мин: %.1f)\n",
                        currentMaster, minPressure);
        }

        lastCmd.waitingForCompletion = false;
        lastCmd.commandActive = false;
        return;
      }
    }
    uint32_t safeDuration;
    if (durationMs == 0 || durationMs == UINT32_MAX) {
      safeDuration = 0;
    } else {
      safeDuration = (durationMs > VALVE_MAX_COMMAND_MS) ? VALVE_MAX_COMMAND_MS : durationMs;
    }

    if (safeDuration > 0 && durationMs != UINT32_MAX && !ErrorHandler::isErrorActive(ErrorHandler::Error::SENSOR) && !ErrorHandler::isErrorActive(ErrorHandler::Error::MPU)) {

      if (lastCmd.waitingForCompletion) {
        Serial.println("[VALVE] Новая команда до анализа предыдущей, предыдущая отменена");
        lastCmd.waitingForCompletion = false;
      }

      lastCmd.startTime = millis();
      lastCmd.duration = safeDuration;
      lastCmd.pad = pad;
      lastCmd.inflate = inflate;
      lastCmd.waitingForCompletion = true;
      lastCmd.commandActive = true;

      MutexGuard guard(xStateMutex);
      if (guard) {
        lastCmd.pressureBefore = pressure[pad];
      }
    }

    ValveCommandMsg cmd;
    memset(&cmd, 0, sizeof(cmd));
    cmd.async.pad = pad;
    cmd.async.inflate = inflate;
    cmd.async.duration = (safeDuration == 0) ? 0 : pdMS_TO_TICKS(safeDuration);

    BaseType_t result = xQueueSend(xValveQueue, &cmd, pdMS_TO_TICKS(100));
    if (result != pdTRUE) {
      valveQueueDropCount++;
      Serial.println("[ERROR] Failed to send to valve queue!");
      return;
    }
    uint32_t depth = uxQueueMessagesWaiting(xValveQueue);
    if (depth > maxValveQueueDepth) maxValveQueueDepth = depth;

    if (safeDuration > 0 || durationMs == UINT32_MAX) {
      Event event;
      event.type = EventType::VALVE_COMMAND;
      event.timestamp = millis();
      event.data.valve.pad = static_cast<uint8_t>(pad);
      event.data.valve.inflate = inflate;
      event.data.valve.duration = durationMs;
      EventBus::publish(event, pdMS_TO_TICKS(100));
    }
    return;
  }
}

/* ===== 8.8.0: состояние подсветки и «служебных экранов» ===== */
bool backlightOff = false;        // подсветка погашена по таймауту бездействия
uint32_t lastUserActivityMs = 0;  // время последнего нажатия любой кнопки

/** 8.8.0: применение настроек к железу сразу после сохранения (без перезагрузки). */
void applyRuntimeSettings() {
  // Яркость подсветки (пункт «Дисплей → Яркость»)
  analogWrite(PIN_TFT_BL, map(constrain(ConfigManager::getContrast(), 1, 100), 1, 100, 0, 255));

  // Политика гашения подсветки: 0 = никогда
  if (ConfigManager::getBacklightOffMin() == 0) {
    backlightOff = false;
  }
  lastUserActivityMs = millis();

  // Аппаратный порог детектора движения MPU применяем на ходу
  if (mpuOk) {
    mpu.setMotionDetectionThreshold(ConfigManager::getImuMotionDet());
    Serial.printf("[IMU] Порог детектора движения MPU: %d\n", ConfigManager::getImuMotionDet());
  }

  Serial.printf("[MENU] Применено: кадр=%d мс, подсветка=%d мин, зона=%.2f бар, допуск=%.2f бар\n",
                ConfigManager::getFrameMs(), ConfigManager::getBacklightOffMin(),
                ConfigManager::getPressureDeadband(), ConfigManager::getMovementTolerance());
  displayDirty = true;
  forceDisplayReset(true);
}

/* ============================================================================
   8.8.0: СЛУЖЕБНЫЕ ЭКРАНЫ — ручной тест клапанов, IMU (нуль углов, калибровка
   офсетов), диагностика MPU6050.
   Управление: Кн1/Кн2 — выбор, Кн3 — действие/подтверждение, Кн4 — выход.
   Аварийная остановка (Кн4+Кн5) закрывает все клапаны и выходит из экрана.
   ============================================================================ */
enum class ServiceScreen : uint8_t {
  NONE = 0,
  VALVE_TEST,        // ручной тест клапанов (6 выходов, «пока держишь Кн3»)
  IMU_ZERO_CONFIRM,  // подтверждение обнуления углов по текущему положению
  IMU_CALIB,         // калибровка офсетов IMU
  MPU_DIAG           // диагностика MPU6050
};

volatile ServiceScreen serviceScreen = ServiceScreen::NONE;

// --- ручной тест клапанов: 4 подушечных + накачка + сброс ---
constexpr uint8_t MANUAL_VALVE_COUNT = 6;
const char *const manualValveNames[MANUAL_VALVE_COUNT] = { "ПЛ", "ПП", "ЗЛ", "ЗП", "НАКАЧКА", "СБРОС" };
const uint8_t manualValvePins[MANUAL_VALVE_COUNT] = { PIN_BUB1, PIN_BUB2, PIN_BUB3, PIN_BUB4, PIN_INFL, PIN_DEFL };
uint8_t manualValveIndex = 0;
uint8_t manualValveOpenIndex = 0xFF;  // 0xFF — ничего не открыто
uint32_t manualValveOpenSince = 0;

// --- IMU: калибровка офсетов ---
int8_t imuCalibResult = 0;  // 0 — не запускалась, 1 — успех, -1 — ошибка
uint32_t imuCalibLastRun = 0;

/** Доступ к служебным операциям: только РУЧНОЙ режим, без ошибок и вне OTA. */
static bool serviceOpsAllowed() {
  if (otaMode || otaInProgress || otaValveLock) return false;
  if (ErrorHandler::hasActiveErrors()) return false;
  if (currentSystemMode != SystemMode::MANUAL) return false;
  if (currentTestState != TestState::IDLE && currentTestState != TestState::COMPLETED) return false;
  return true;
}

/** Открыть/закрыть один клапан вручную под мьютексом клапанов. */
static void manualValveSet(uint8_t idx, bool open) {
  if (idx >= MANUAL_VALVE_COUNT) return;
  bool locked = (xValveMutex != nullptr) && (xSemaphoreTake(xValveMutex, pdMS_TO_TICKS(150)) == pdTRUE);
  digitalWrite(manualValvePins[idx], open ? HIGH : LOW);
  if (locked) xSemaphoreGive(xValveMutex);
  Serial.printf("[VALVE-TEST] Клапан %s: %s\n", manualValveNames[idx], open ? "ОТКРЫТ" : "ЗАКРЫТ");
}

/** Закрыть все 6 клапанов (выход, ошибка, аварийная остановка). */
static void manualValveCloseAll() {
  bool locked = (xValveMutex != nullptr) && (xSemaphoreTake(xValveMutex, pdMS_TO_TICKS(150)) == pdTRUE);
  for (uint8_t i = 0; i < MANUAL_VALVE_COUNT; i++) digitalWrite(manualValvePins[i], LOW);
  if (locked) xSemaphoreGive(xValveMutex);
  manualValveOpenIndex = 0xFF;
  Serial.println("[VALVE-TEST] Все клапаны закрыты");
}

/** Открыть экран ручного теста клапанов. */
void openValveTestScreen() {
  if (!serviceOpsAllowed()) {
    Logger::log(Logger::WARNING, "VALVE-TEST", "Только РУЧНОЙ режим, без ошибок и вне OTA");
    return;
  }
  saveMenuSettings();  // сохраняем возможные изменения меню
  manualValveCloseAll();
  manualValveIndex = 0;
  manualValveOpenIndex = 0xFF;
  serviceScreen = ServiceScreen::VALVE_TEST;
  menuVisible = false;
  forceDisplayReset(true);
  displayDirty = true;
  Serial.println("[VALVE-TEST] Кн1/Кн2 — выбор, удерживайте Кн3 для открытия, Кн4 — выход");
}

/** Открыть подтверждение обнуления углов по текущему положению. */
void openImuZeroConfirm() {
  if (!serviceOpsAllowed()) {
    Logger::log(Logger::WARNING, "IMU", "Обнуление углов: только РУЧНОЙ режим без ошибок");
    return;
  }
  serviceScreen = ServiceScreen::IMU_ZERO_CONFIRM;
  menuVisible = false;
  forceDisplayReset(true);
  displayDirty = true;
}

/** Открыть экран калибровки офсетов IMU. */
void openImuCalibScreen() {
  if (!mpuOk) {
    Logger::log(Logger::ERROR, "IMU", "Калибровка недоступна: MPU6050 не отвечает");
    return;
  }
  if (!serviceOpsAllowed()) {
    Logger::log(Logger::WARNING, "IMU", "Калибровка: только РУЧНОЙ режим без ошибок");
    return;
  }
  serviceScreen = ServiceScreen::IMU_CALIB;
  menuVisible = false;
  forceDisplayReset(true);
  displayDirty = true;
}

/** Открыть экран диагностики MPU6050. */
void openMpuDiagScreen() {
  serviceScreen = ServiceScreen::MPU_DIAG;
  menuVisible = false;
  forceDisplayReset(true);
  displayDirty = true;
}

/** Выход со служебного экрана: всегда закрываем клапаны. */
static void closeServiceScreen() {
  manualValveCloseAll();
  serviceScreen = ServiceScreen::NONE;
  forceDisplayReset(true);
  displayDirty = true;
}

/**
 * 8.8.0: калибровка офсетов IMU по библиотеке MPU6050.
 * Машина должна стоять ровно и неподвижно (10-20 с). DMP на время калибровки
 * отключается, затем перезапускается. Офсеты сохраняются в config.txt и
 * применяются при старте (см. initializeDMP).
 */
static void runImuOffsetCalibration() {
  if (!mpuOk) {
    imuCalibResult = -1;
    return;
  }
  Serial.println("[IMU] Калибровка офсетов: НЕ двигайте машину (10-20 с)...");
  imuCalibResult = 0;
  mpu.setDMPEnabled(false);
  mpu.CalibrateGyro(6);
  mpu.CalibrateAccel(6);
  ConfigManager::setImuOffsets(mpu.getXGyroOffset(), mpu.getYGyroOffset(), mpu.getZGyroOffset(),
                               mpu.getXAccelOffset(), mpu.getYAccelOffset(), mpu.getZAccelOffset());
  settingsChanged = true;
  saveMenuSettings();  // офсеты сразу пишутся в config.txt
  mpu.setDMPEnabled(true);
  imuCalibLastRun = millis();
  imuCalibResult = 1;
  Serial.printf("[IMU] Офсеты сохранены: гиро (%d,%d,%d), аксель (%d,%d,%d)\n",
                ConfigManager::getImuGyroOffX(), ConfigManager::getImuGyroOffY(), ConfigManager::getImuGyroOffZ(),
                ConfigManager::getImuAccelOffX(), ConfigManager::getImuAccelOffY(), ConfigManager::getImuAccelOffZ());
}

/** Обработка кнопок на служебных экранах (вызывается из задачи кнопок). */
static void handleServiceInput() {
  switch (serviceScreen) {
    case ServiceScreen::VALVE_TEST: {
      if (button0.click()) {
        manualValveIndex = (manualValveIndex + MANUAL_VALVE_COUNT - 1) % MANUAL_VALVE_COUNT;
      }
      if (button1.click()) {
        manualValveIndex = (manualValveIndex + 1) % MANUAL_VALVE_COUNT;
      }
      // Кн3 удерживаем — выбранный клапан открыт; отпустили — закрылся
      if (button2.pressing()) {
        if (manualValveOpenIndex != manualValveIndex) {
          if (manualValveOpenIndex != 0xFF) manualValveSet(manualValveOpenIndex, false);
          manualValveSet(manualValveIndex, true);
          manualValveOpenIndex = manualValveIndex;
          manualValveOpenSince = millis();
        } else if (millis() - manualValveOpenSince > VALVE_MAX_COMMAND_MS) {
          Serial.println("[VALVE-TEST] Страховочный таймаут: клапан закрыт");
          manualValveSet(manualValveOpenIndex, false);
          manualValveOpenIndex = 0xFF;
        }
      } else if (manualValveOpenIndex != 0xFF) {
        manualValveSet(manualValveOpenIndex, false);
        manualValveOpenIndex = 0xFF;
      }
      if (button3.click()) {
        Serial.println("[VALVE-TEST] Выход, все клапаны закрыты");
        closeServiceScreen();
      }
      break;
    }

    case ServiceScreen::IMU_ZERO_CONFIRM: {
      if (button2.click()) {  // подтверждение
        ConfigManager::setZeroAngleX(constrain(angleX, -3.0f, 3.0f));
        ConfigManager::setZeroAngleY(constrain(angleY, -3.0f, 3.0f));
        editZeroAngleX = ConfigManager::getZeroAngleX();
        editZeroAngleY = ConfigManager::getZeroAngleY();
        settingsChanged = true;
        saveMenuSettings();
        Serial.printf("[IMU] Программный нуль углов: X=%.2f Y=%.2f\n",
                      ConfigManager::getZeroAngleX(), ConfigManager::getZeroAngleY());
        closeServiceScreen();
      }
      if (button3.click()) {  // отмена
        Serial.println("[IMU] Обнуление углов отменено");
        closeServiceScreen();
      }
      break;
    }

    case ServiceScreen::IMU_CALIB: {
      if (button2.click()) {
        runImuOffsetCalibration();
      }
      if (button3.click()) {
        closeServiceScreen();
      }
      break;
    }

    case ServiceScreen::MPU_DIAG: {
      if (button3.click()) {
        closeServiceScreen();
      }
      break;
    }

    default:
      break;
  }
}

/* ===== 8.8.0: отрисовка служебных экранов ===== */
static void drawValveTestScreen() {
  tft.fillScreen(theme::BG);
  ui.setTransparent(true);
  ui.setFont(UiFont::Tiny);
  ui.setColors(theme::TEXT_DIM, theme::BG);

  ui.box(theme::MARGIN, 2, theme::SCREEN_W - 2 * theme::MARGIN, 18, "РУЧНОЙ ТЕСТ КЛАПАНОВ",
         UiHAlign::Center, UiVAlign::Middle, false);

  const int16_t rowH = 20;
  int16_t y = 24;
  for (uint8_t i = 0; i < MANUAL_VALVE_COUNT; i++) {
    const bool selected = (i == manualValveIndex);
    const bool isOpen = (manualValveOpenIndex == i);
    if (selected) {
      tft.fillRoundRect(theme::MARGIN - 2, y - 1, theme::SCREEN_W - 2 * theme::MARGIN + 4, rowH, 3,
                        isOpen ? theme::OK : theme::PANEL);
    }
    ui.boxf(theme::MARGIN + 4, y, 150, rowH - 2, UiHAlign::Left, UiVAlign::Middle, false,
            "%s %s", selected ? ">" : " ", manualValveNames[i]);
    ui.box(theme::SCREEN_W - theme::MARGIN - 110, y, 110, rowH - 2, isOpen ? "ОТКРЫТ" : "закрыт",
           UiHAlign::Right, UiVAlign::Middle, false);
    y += rowH;
  }

  const uint32_t holdSec = (manualValveOpenIndex == 0xFF) ? 0 : (millis() - manualValveOpenSince) / 1000;
  ui.boxf(theme::MARGIN, y + 2, theme::SCREEN_W - 2 * theme::MARGIN, 16, UiHAlign::Left, UiVAlign::Middle, true,
          "МП: %.2f бар   открыт: %lu с / 15 с", masterPressure, (unsigned long)holdSec);
  ui.box(theme::MARGIN, y + 20, theme::SCREEN_W - 2 * theme::MARGIN, 16,
         "КН1/КН2-ВЫБОР  КН3-УДЕРЖ=ОТКРЫТ", UiHAlign::Left, UiVAlign::Middle, true);
  ui.box(theme::MARGIN, y + 36, theme::SCREEN_W - 2 * theme::MARGIN, 16,
         "КН4-ВЫХОД (все закрыть)  АВАРИЯ КН4+КН5", UiHAlign::Left, UiVAlign::Middle, true);
}

static void drawImuZeroConfirmScreen() {
  tft.fillScreen(theme::BG);
  ui.setTransparent(true);
  ui.setFont(UiFont::Tiny);
  ui.setColors(theme::TEXT_DIM, theme::BG);

  ui.box(theme::MARGIN, 6, theme::SCREEN_W - 2 * theme::MARGIN, 20, "ОБНУЛИТЬ УГЛЫ ПО ТЕКУЩЕМУ ПОЛОЖЕНИЮ",
         UiHAlign::Center, UiVAlign::Middle, false);
  ui.box(theme::MARGIN, 40, theme::SCREEN_W - 2 * theme::MARGIN, 16,
         "Текущее положение станет 0.00 / 0.00", UiHAlign::Center, UiVAlign::Middle, true);
  ui.boxf(theme::MARGIN, 70, theme::SCREEN_W - 2 * theme::MARGIN, 18, UiHAlign::Center, UiVAlign::Middle, true,
          "Поперечный: %.2f   Продольный: %.2f", angleX, angleY);
  ui.boxf(theme::MARGIN, 100, theme::SCREEN_W - 2 * theme::MARGIN, 18, UiHAlign::Center, UiVAlign::Middle, true,
          "Текущий нуль: %.2f / %.2f", ConfigManager::getZeroAngleX(), ConfigManager::getZeroAngleY());
  ui.box(theme::MARGIN, 150, theme::SCREEN_W - 2 * theme::MARGIN, 18,
         "Машина должна стоять на месте!", UiHAlign::Center, UiVAlign::Middle, true);
  ui.box(theme::MARGIN, 190, theme::SCREEN_W - 2 * theme::MARGIN, 18,
         "КН3 - ПОДТВЕРДИТЬ     КН4 - ОТМЕНА", UiHAlign::Center, UiVAlign::Middle, true);
}

static void drawImuCalibScreen() {
  tft.fillScreen(theme::BG);
  ui.setTransparent(true);
  ui.setFont(UiFont::Tiny);
  ui.setColors(theme::TEXT_DIM, theme::BG);

  ui.box(theme::MARGIN, 6, theme::SCREEN_W - 2 * theme::MARGIN, 20, "КАЛИБРОВКА ОФСЕТОВ IMU",
         UiHAlign::Center, UiVAlign::Middle, false);
  ui.box(theme::MARGIN, 40, theme::SCREEN_W - 2 * theme::MARGIN, 16,
         "Машина ровно, НЕПОДВИЖНО 10-20 с", UiHAlign::Center, UiVAlign::Middle, true);
  ui.box(theme::MARGIN, 62, theme::SCREEN_W - 2 * theme::MARGIN, 16,
         "DMP на время калибровки отключается", UiHAlign::Center, UiVAlign::Middle, true);

  if (imuCalibResult == 1) {
    ui.box(theme::MARGIN, 100, theme::SCREEN_W - 2 * theme::MARGIN, 18, "ОФСЕТЫ СОХРАНЕНЫ В КОНФИГ",
           UiHAlign::Center, UiVAlign::Middle, true);
  } else if (imuCalibResult < 0) {
    ui.box(theme::MARGIN, 100, theme::SCREEN_W - 2 * theme::MARGIN, 18, "ОШИБКА: MPU6050 недоступен",
           UiHAlign::Center, UiVAlign::Middle, true);
  } else {
    ui.box(theme::MARGIN, 100, theme::SCREEN_W - 2 * theme::MARGIN, 18, "Готово к запуску",
           UiHAlign::Center, UiVAlign::Middle, true);
  }

  ui.boxf(theme::MARGIN, 126, theme::SCREEN_W - 2 * theme::MARGIN, 16, UiHAlign::Center, UiVAlign::Middle, true,
          "гиро: %d %d %d", ConfigManager::getImuGyroOffX(), ConfigManager::getImuGyroOffY(),
          ConfigManager::getImuGyroOffZ());
  ui.boxf(theme::MARGIN, 144, theme::SCREEN_W - 2 * theme::MARGIN, 16, UiHAlign::Center, UiVAlign::Middle, true,
          "аксель: %d %d %d", ConfigManager::getImuAccelOffX(), ConfigManager::getImuAccelOffY(),
          ConfigManager::getImuAccelOffZ());
  ui.boxf(theme::MARGIN, 170, theme::SCREEN_W - 2 * theme::MARGIN, 16, UiHAlign::Center, UiVAlign::Middle, true,
          "Последняя калибровка: %lu с назад",
          (unsigned long)(imuCalibLastRun ? (millis() - imuCalibLastRun) / 1000 : 0));
  ui.box(theme::MARGIN, 200, theme::SCREEN_W - 2 * theme::MARGIN, 18,
         "КН3 - КАЛИБРОВАТЬ     КН4 - ВЫХОД", UiHAlign::Center, UiVAlign::Middle, true);
}

static void drawMpuDiagScreen() {
  tft.fillScreen(theme::BG);
  ui.setTransparent(true);
  ui.setFont(UiFont::Tiny);
  ui.setColors(theme::TEXT_DIM, theme::BG);

  ui.box(theme::MARGIN, 4, theme::SCREEN_W - 2 * theme::MARGIN, 18, "ДИАГНОСТИКА MPU6050",
         UiHAlign::Center, UiVAlign::Middle, false);

  int16_t ax = 0, ay = 0, az = 0, gx = 0, gy = 0, gz = 0;
  int deviceId = -1;
  float temp = 0.0f;
  if (mpuOk) {
    deviceId = mpu.getDeviceID();
    temp = mpu.getTemperature() / 340.0f + 36.53f;
    mpu.getMotion6(&ax, &ay, &az, &gx, &gy, &gz);
  }

  ui.boxf(theme::MARGIN, 26, theme::SCREEN_W - 2 * theme::MARGIN, 16, UiHAlign::Left, UiVAlign::Middle, true,
          "ID: 0x%02X   MPU: %s   DMP: %s", deviceId, mpuOk ? "OK" : "ОШИБКА",
          (mpuOk && mpu.getDMPEnabled()) ? "готов" : "нет");
  ui.boxf(theme::MARGIN, 44, theme::SCREEN_W - 2 * theme::MARGIN, 16, UiHAlign::Left, UiVAlign::Middle, true,
          "Температура: %.1f C   Порог детектора: %d", temp, ConfigManager::getImuMotionDet());
  ui.boxf(theme::MARGIN, 62, theme::SCREEN_W - 2 * theme::MARGIN, 16, UiHAlign::Left, UiVAlign::Middle, true,
          "Углы (с нулём): X=%.2f  Y=%.2f", angleX, angleY);
  ui.boxf(theme::MARGIN, 80, theme::SCREEN_W - 2 * theme::MARGIN, 16, UiHAlign::Left, UiVAlign::Middle, true,
          "Нуль конфига: X=%.2f  Y=%.2f", ConfigManager::getZeroAngleX(), ConfigManager::getZeroAngleY());
  ui.box(theme::MARGIN, 104, theme::SCREEN_W - 2 * theme::MARGIN, 16, "Сырые данные getMotion6:",
         UiHAlign::Left, UiVAlign::Middle, true);
  ui.boxf(theme::MARGIN, 122, theme::SCREEN_W - 2 * theme::MARGIN, 16, UiHAlign::Left, UiVAlign::Middle, true,
          "ax=%d ay=%d az=%d", ax, ay, az);
  ui.boxf(theme::MARGIN, 140, theme::SCREEN_W - 2 * theme::MARGIN, 16, UiHAlign::Left, UiVAlign::Middle, true,
          "gx=%d gy=%d gz=%d", gx, gy, gz);
  ui.boxf(theme::MARGIN, 158, theme::SCREEN_W - 2 * theme::MARGIN, 16, UiHAlign::Left, UiVAlign::Middle, true,
          "Офсеты гиро: %d %d %d", ConfigManager::getImuGyroOffX(), ConfigManager::getImuGyroOffY(),
          ConfigManager::getImuGyroOffZ());
  ui.boxf(theme::MARGIN, 176, theme::SCREEN_W - 2 * theme::MARGIN, 16, UiHAlign::Left, UiVAlign::Middle, true,
          "Офсеты аксель: %d %d %d", ConfigManager::getImuAccelOffX(), ConfigManager::getImuAccelOffY(),
          ConfigManager::getImuAccelOffZ());
  ui.boxf(theme::MARGIN, 194, theme::SCREEN_W - 2 * theme::MARGIN, 16, UiHAlign::Left, UiVAlign::Middle, true,
          "Ошибка MPU активна: %s", ErrorHandler::isErrorActive(ErrorHandler::Error::MPU) ? "ДА" : "нет");
  ui.box(theme::MARGIN, 214, theme::SCREEN_W - 2 * theme::MARGIN, 16, "КН4 - ВЫХОД",
         UiHAlign::Center, UiVAlign::Middle, true);
}

/** Отрисовка активного служебного экрана (вызывается из задачи дисплея). */
static void drawServiceScreen() {
  switch (serviceScreen) {
    case ServiceScreen::VALVE_TEST: drawValveTestScreen(); break;
    case ServiceScreen::IMU_ZERO_CONFIRM: drawImuZeroConfirmScreen(); break;
    case ServiceScreen::IMU_CALIB: drawImuCalibScreen(); break;
    case ServiceScreen::MPU_DIAG: drawMpuDiagScreen(); break;
    default: break;
  }
}

/* ============================================================================
   8.9.0: ЭКРАН ДВИЖЕНИЯ — «живой» экран режима MOVEMENT.
   Показывает: цели/факт по осям, карточки 4 подушек с метками целей, таймеры
   (в движении / стабилизация / следующая проверка / последняя корректировка),
   активные клапаны с анимацией потока и тренд давлений за 30 с.
   Данные только ЧИТАЮТСЯ — логика движения и выравнивания не изменяется.
   ============================================================================ */
constexpr uint8_t MV_TREND_N = 60;              // 60 сэмплов по 500 мс = 30 с
constexpr uint32_t MV_TREND_DT_MS = 500;        // период записи сэмпла тренда
constexpr uint32_t MV_ACTIVE_WINDOW_MS = 4000;  // окно «активности» клапана (для анимации)
constexpr int16_t MV_X = theme::MARGIN;         // 6
constexpr int16_t MV_CARD_W = 152;              // ширина карточки подушки
constexpr int16_t MV_CARD_H = 40;               // высота карточки подушки

static float mvTrendF[MV_TREND_N];  // тренд среднего по передним подушкам
static float mvTrendR[MV_TREND_N];  // тренд среднего по задним подушкам
static uint8_t mvTrendIdx = 0;
static uint8_t mvTrendCount = 0;
static uint32_t mvTrendLast = 0;

static float mvPadDisp[PAD_COUNT] = { 0, 0, 0, 0 };  // сглаженные (отображаемые) значения
static float mvFrontDisp = 0, mvRearDisp = 0, mvMasterDisp = 0, mvTempDisp = 0;

/** Экспоненциальное сглаживание — плавное «догоняние» значения. */
static inline float mvEase(float cur, float target, float k) {
  return cur + (target - cur) * k;
}

/** Снимок данных для экрана движения (состояние читается под мьютексом). */
struct MvData {
  float pad[PAD_COUNT];
  float master;
  float temp;
  float frontAvg, rearAvg;
  float targetFront, targetRear;
  float tol;
  uint32_t inMotionMs;
  uint32_t settleLeftMs, settleTotalMs;
  uint32_t nextCheckMs;
  uint32_t lastAdjFrontMs, lastAdjRearMs;  // 0 — корректировок ещё не было
  int8_t dirFront, dirRear;
  bool activeFront, activeRear;
};

static void mvReadData(MvData &d) {
  d.targetFront = ConfigManager::getMovementPressureFront();
  d.targetRear = ConfigManager::getMovementPressureRear();
  d.tol = ConfigManager::getMovementTolerance();
  d.master = 0.0f;
  d.temp = 0.0f;
  for (uint8_t i = 0; i < PAD_COUNT; i++) d.pad[i] = 0.0f;
  {
    MutexGuard guard(xStateMutex);
    if (guard) {
      for (uint8_t i = 0; i < PAD_COUNT; i++) d.pad[i] = pressure[i];
      d.master = masterPressure;
      d.temp = temperature;
    }
  }
  d.frontAvg = (d.pad[PAD_FRONT_LEFT] + d.pad[PAD_FRONT_RIGHT]) * 0.5f;
  d.rearAvg = (d.pad[PAD_REAR_LEFT] + d.pad[PAD_REAR_RIGHT]) * 0.5f;

  const uint32_t now = millis();
  d.inMotionMs = (movementStartMs > 0) ? (now - movementStartMs) : 0;

  d.settleTotalMs = (uint32_t)ConfigManager::getMovementSettleSec() * 1000UL;
  d.settleLeftMs = 0;
  if (movementEndTime > 0) {
    const uint32_t passed = now - movementEndTime;
    d.settleLeftMs = (passed < d.settleTotalMs) ? (d.settleTotalMs - passed) : 0;
  }

  const uint32_t checkInterval = (uint32_t)ConfigManager::getMovementCheckSec() * 1000UL;
  const uint32_t nextCheckAt = movementPressureLastCheck + checkInterval;
  d.nextCheckMs = (nextCheckAt > now) ? (nextCheckAt - now) : 0;

  d.lastAdjFrontMs = (movementLastAdjustFront > 0) ? (now - movementLastAdjustFront) : 0;
  d.lastAdjRearMs = (movementLastAdjustRear > 0) ? (now - movementLastAdjustRear) : 0;
  d.dirFront = movementLastAdjustFrontDir;
  d.dirRear = movementLastAdjustRearDir;
  d.activeFront = (movementLastAdjustFront > 0) && ((now - movementLastAdjustFront) < MV_ACTIVE_WINDOW_MS);
  d.activeRear = (movementLastAdjustRear > 0) && ((now - movementLastAdjustRear) < MV_ACTIVE_WINDOW_MS);
}

/** Полоса давления с меткой цели (вертикальная риска). */
static void mvDrawBar(int16_t x, int16_t y, int16_t w, int16_t h, float value, float scale,
                      float target, uint16_t color) {
  tft.fillRect(x, y, w, h, theme::TRACK);
  const int16_t fillW = (int16_t)((float)w * constrain(value / scale, 0.0f, 1.0f));
  if (fillW > 0) tft.fillRect(x, y, fillW, h, color);
  const int16_t tx = (int16_t)(x + (float)w * constrain(target / scale, 0.0f, 1.0f));
  tft.drawFastVLine(constrain(tx, (int16_t)(x + 1), (int16_t)(x + w - 2)), (int16_t)(y - 2),
                    (int16_t)(h + 4), theme::TEXT);
}

/** «Бегущие штрихи» вдоль полосы — индикация потока воздуха (анимация). */
static void mvDrawFlow(int16_t x, int16_t y, int16_t w, int16_t h, uint16_t color, uint32_t phaseMs) {
  const int16_t step = 8;
  const int16_t offset = (int16_t)((phaseMs / 40U) % (uint32_t)step);
  for (int16_t px = (int16_t)(x - step + offset); px < (int16_t)(x + w); px += step) {
    const int16_t x0 = (px < x) ? x : px;
    int16_t x1 = (int16_t)(px + 3);
    if (x1 > (int16_t)(x + w - 1)) x1 = (int16_t)(x + w - 1);
    if (x1 > x0) tft.drawFastHLine(x0, (int16_t)(y + h / 2), (int16_t)(x1 - x0), color);
  }
}

/** Тренд давлений за 30 с: две линии (перед/зад) + штриховые линии целей. */
static void mvDrawTrend(int16_t x, int16_t y, int16_t w, int16_t h, float targetFront,
                        float targetRear, float scale) {
  tft.fillRect(x, y, w, h, theme::PANEL);
  tft.drawRect(x, y, w, h, theme::BORDER);
  if (mvTrendCount < 2) return;

  const int16_t inner = (int16_t)(h - 4);
  const float sp = (float)(w - 3) / (float)(MV_TREND_N - 1);
  const int16_t yTf = (int16_t)(y + h - 2 - constrain(targetFront / scale, 0.0f, 1.0f) * (float)inner);
  const int16_t yTr = (int16_t)(y + h - 2 - constrain(targetRear / scale, 0.0f, 1.0f) * (float)inner);
  for (int16_t i = 2; i < (int16_t)(w - 4); i += 6) {
    tft.drawFastHLine((int16_t)(x + i), yTf, 3, theme::TEXT_DIM);
    tft.drawFastHLine((int16_t)(x + i), yTr, 3, theme::TEXT_DIM);
  }

  int16_t pxF = -1, pyF = 0, pxR = -1, pyR = 0;
  for (uint8_t k = 0; k < mvTrendCount; k++) {
    const uint8_t idx = (uint8_t)((mvTrendIdx + MV_TREND_N - mvTrendCount + k) % MV_TREND_N);
    const int16_t px = (int16_t)(x + 2 + (float)k * sp);
    const int16_t py1 = (int16_t)(y + h - 2 - constrain(mvTrendF[idx] / scale, 0.0f, 1.0f) * (float)inner);
    const int16_t py2 = (int16_t)(y + h - 2 - constrain(mvTrendR[idx] / scale, 0.0f, 1.0f) * (float)inner);
    if (pxF >= 0) {
      tft.drawLine(pxF, pyF, px, py1, theme::ACCENT);  // передние — cyan
      tft.drawLine(pxR, pyR, px, py2, theme::OK);      // задние — зелёный
    }
    pxF = px; pyF = py1; pxR = px; pyR = py2;
  }
}
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
