timurufa86/kamaz_leveler/kamaz_10_6_2_fr_adafruiti_OTA_NM/task_control.h

#pragma once
/**
 *  task_control.h — FreeRTOS controlTask: main control loop
 *  consuming IMU/pressure queues, running auto-leveling,
 *  manual maintenance, leak monitor, valve health check.
 */

void controlTask(void *pvParameters);
