timurufa86/kamaz_leveler/kamaz_10_16_8_fr_adafruiti_OTA_NM/pressure_read.cpp

#include "pressure_read.h"
#include "app_globals.h"
#include "app_types.h"
#include "app_pins.h"
#include "jhm1200.h"
#include "mutex_guard.h"
#include "event_bus.h"
#include "logger.h"
#include "valve_ctrl.h"
#include <Wire.h>
#include <cmath>

/* ── ConfigManager / ErrorHandler bridge functions (defined in .ino) ── */
extern float cfg_getPressureMin();
extern float cfg_getPressureMax();
extern float cfg_getPressureDeadband();
extern float cfg_getMasterLowBar();
extern float cfg_getMovementPressureFront();
extern float cfg_getMovementPressureRear();
extern float cfg_getMovementTolerance();
extern float cfg_getParkingPressureBar();
extern int   cfg_getInflateDelay();
extern int   cfg_getReleaseDelay();
extern int   cfg_getMasterCheckSec();
extern int   cfg_getMovementCheckSec();
extern int   cfg_getPressureStabilizeMs();

extern bool  cfg_errorIsActive(uint8_t err);
extern void  cfg_errorHandle(uint8_t err, const char *msg);
extern void  cfg_errorMarkCleared(uint8_t err);
extern void  cfg_errorUpdateTime(uint8_t err);
extern void  cfg_errorRemove(uint8_t err);
extern bool  cfg_errorIsPendingClear(uint8_t err);
extern void  cfg_errorCancelClear(uint8_t err);
extern bool  cfg_errorHasCriticalPneumatic();

/* ── .ino helpers ── */
void setDisplayDirty();
void emergencyStop();

/* ── ErrorHandler error codes (single source: app_types.h) ── */
static constexpr uint8_t ERR_SENSOR       = ERR_SENSOR_CODE;       // ErrorHandler::Error::SENSOR
static constexpr uint8_t ERR_LOW_PRESSURE = ERR_LOW_PRESSURE_CODE; // ErrorHandler::Error::LOW_PRESSURE

/* ====================  readPressure  ==================== */
float readPressure() {
#if ENABLE_SIMULATION
  static float simPressure = 4.5f;
  simPressure += ((float)random(-10, 10) / 100.0f);
  simPressure = constrain(simPressure, 3.0f, 6.0f);

  if (cfg_errorIsActive(ERR_SENSOR)) {
    cfg_errorMarkCleared(ERR_SENSOR);
  }
  return simPressure;
#endif

  if (!jhmReady || !Jhm1200::isReady()) {
    // 10.15.0: единый признак отказа — отрицательное значение. Раньше здесь
    // возвращался 0.0f, который вызывающие считали валидным «пустым» замером
    // (накачка всегда разрешена, пределы min/max не работают).
    return -1.0f;
  }

  static uint32_t lastReadTime = 0;
  static float lastGoodBar = 0.0f;
  static bool haveLast = false;
  const uint32_t now = millis();
  if (now - lastReadTime < 12) {
    return haveLast ? lastGoodBar : -1.0f;
  }
  lastReadTime = now;

  float bar = 0.0f;
  bool ok = false;
  {
    MutexGuard i2c(xI2CMutex, pdMS_TO_TICKS(150));
    if (!i2c) return haveLast ? lastGoodBar : -1.0f;
    ok = Jhm1200::readBar(bar);
  }

  static uint8_t consecutiveFails = 0;
  if (!ok) {
    consecutiveFails++;
    if (consecutiveFails < 8) {
      return haveLast ? lastGoodBar : -1.0f;
    }
    consecutiveFails = 0;
    static uint32_t lastErrorTime = 0;
    if (millis() - lastErrorTime > 5000) {
      lastErrorTime = millis();
      SERIAL_DBGLN("[WARN] JHM1200: ошибка чтения!");
    }
    if (!cfg_errorIsActive(ERR_SENSOR)) {
      cfg_errorHandle(ERR_SENSOR, "JHM1200 - ошибка чтения");
    } else {
      cfg_errorUpdateTime(ERR_SENSOR);
    }
    return -1.0f;  // 10.15.0: отказ датчика — не «0 бар»
  }
  consecutiveFails = 0;

  if (cfg_errorIsActive(ERR_SENSOR) && calibrationCompleted) {
    cfg_errorMarkCleared(ERR_SENSOR);
  }

  float localZeroBar = 0.0f;
  {
    MutexGuard guard(xCalibMutex);
    if (guard) {
      localZeroBar = g_pressureZeroBar;
    }
  }
  bar -= localZeroBar;
  if (bar < 0.02f) bar = 0.0f;
  if (bar > 10.0f) bar = 10.0f;

  /* Forward declarations for autoLevelingController — bridge */
  extern bool autoLevelIsBusy();
  const bool fastPath = manifoldIsBusy() || autoLevelIsBusy();
  if (!haveLast) {
    lastGoodBar = bar;
    haveLast = true;
  } else if (fastPath) {
    lastGoodBar = 0.35f * lastGoodBar + 0.65f * bar;
  } else {
    const float delta = bar - lastGoodBar;
    if (fabsf(delta) > 0.8f) {
      bar = lastGoodBar + (delta > 0 ? 0.8f : -0.8f);
    }
    lastGoodBar = 0.55f * lastGoodBar + 0.45f * bar;
  }
  return lastGoodBar;
}

/* ====================  initializeJhm1200  ==================== */
bool initializeJhm1200() {
  MutexGuard i2c(xI2CMutex, pdMS_TO_TICKS(500));
  if (!i2c && xI2CMutex != nullptr) return false;

  if (!Jhm1200::begin(Wire)) {
    jhmReady = false;
    SERIAL_DBGLN("[JHM1200] Не найден на адресе 0x78");
    return false;
  }
  jhmReady = true;
  return true;
}

/* ====================  checkPressureLimits  ==================== */
bool checkPressureLimits() {
#if ENABLE_SIMULATION
  return false;
#endif

  if (!calibrationCompleted) {
    return false;
  }

  if (!firstPressureMeasurementDone) {
    static uint32_t lastLog = 0;
    if (millis() - lastLog > 30000) {
      lastLog = millis();
      SERIAL_DBGLN("[CHECK] Ожидание первого замера давления...");
    }
    return false;
  }

  if (cfg_errorIsActive(ERR_SENSOR)) {
    return false;
  }

  float localMaster;
  {
    MutexGuard guard(xStateMutex);
    if (!guard) return false;
    localMaster = masterPressure;
  }

  float masterLow = cfg_getMasterLowBar();
  if (masterLow <= 0.0f) {
    if (cfg_errorIsActive(ERR_LOW_PRESSURE)) {
      cfg_errorRemove(ERR_LOW_PRESSURE);
      SERIAL_DBGLN("[CHECK] LOW_PRESSURE снята сразу (Низк.МП=0, проверка выкл.)");
    }
    return false;
  }

  if (localMaster < masterLow) {
    if (cfg_errorIsPendingClear(ERR_LOW_PRESSURE)) {
      cfg_errorCancelClear(ERR_LOW_PRESSURE);
      SERIAL_DBGLN("[CHECK] Отменено удаление LOW_PRESSURE (давление снова упало)");
    }

    if (!cfg_errorIsActive(ERR_LOW_PRESSURE)) {
      cfg_errorHandle(ERR_LOW_PRESSURE, "Низкое давление в магистрали");
      SERIAL_DBG("[CHECK] LOW_PRESSURE создана! МП: %.2f бар (порог: %.2f)\n",
                    localMaster, masterLow);
    } else {
      cfg_errorUpdateTime(ERR_LOW_PRESSURE);
    }
    return true;
  }

  if (cfg_errorIsActive(ERR_LOW_PRESSURE)) {
    if (!cfg_errorIsPendingClear(ERR_LOW_PRESSURE)) {
      cfg_errorMarkCleared(ERR_LOW_PRESSURE);
      SERIAL_DBG("[CHECK] LOW_PRESSURE будет удалена через 3 сек. Давление: %.2f бар\n",
                    localMaster);
    } else {
      static uint32_t lastPendingLog = 0;
      if (millis() - lastPendingLog > 5000) {
        lastPendingLog = millis();
        SERIAL_DBG("[CHECK] LOW_PRESSURE уже в очереди на удаление. Давление: %.2f бар\n",
                      localMaster);
      }
    }
  }

  return false;
}

/* ====================  checkAndAdjustMasterPressure  ==================== */
/* Периодический замер магистрали (canon B). Без сброса по max — центральная подача. */
void checkAndAdjustMasterPressure() {
  if (!calibrationCompleted || !firstPressureMeasurementDone) return;
  if (cfg_errorIsActive(ERR_SENSOR)) return;
  if (manifoldIsBusy() || otaValveLock || otaMode || otaInProgress) return;

  uint32_t now = millis();
  if (now - lastMasterPressureCheckTime < (uint32_t)cfg_getMasterCheckSec() * 1000UL) {
    return;
  }

  float master = 0.0f;
  if (!measureMaster(&master)) {
    SERIAL_DBGLN("[MASTER] sample skipped/failed");
    return;
  }

  SERIAL_DBG("[MASTER] periodic check: %.2f bar\n", master);
  checkPressureLimits();
}

/* ====================  requestPressureMeasurement  ==================== */
void requestPressureMeasurement() {
  if (xPressureWakeupQueue == nullptr) {
    SERIAL_DBGLN("[PRESS] Wakeup queue is null!");
    return;
  }

  static uint32_t lastRequestTime = 0;
  uint32_t now = millis();

  if (now - lastRequestTime < 80) {
    return;
  }

  uint32_t dummy = 1;
  BaseType_t result = xQueueSend(xPressureWakeupQueue, &dummy, pdMS_TO_TICKS(10));

  if (result == pdTRUE) {
    lastRequestTime = now;
    SERIAL_DBGLN("[PRESS] Measurement requested");
  } else {
    SERIAL_DBGLN("[PRESS] Failed to request measurement - queue full");
  }
}

/* ====================  updateLeakMonitor  ==================== */
void updateLeakMonitor() {
  static float baseline[PAD_COUNT];
  static uint32_t baselineMs = 0;
  static bool haveBaseline = false;

  extern bool autoLevelIsBusy();
  if (manifoldIsBusy() || autoLevelIsBusy() ||
      currentSystemMode == SystemMode::MOVEMENT || otaInProgress ||
      cfg_errorHasCriticalPneumatic()) {
    haveBaseline = false;
    return;
  }

  const uint32_t now = millis();
  for (uint8_t i = 0; i < PAD_COUNT; i++) {
    if (!pressureValid[i] || (now - pressureStampMs[i]) > 60000UL) {
      haveBaseline = false;
      return;
    }
  }

  if (!haveBaseline) {
    memcpy(baseline, pressure, sizeof(baseline));
    baselineMs = now;
    haveBaseline = true;
    return;
  }

  if (now - baselineMs < 600000UL) return;

  float worstDrop = 0.0f;
  int worstPad = -1;
  for (uint8_t i = 0; i < PAD_COUNT; i++) {
    const float drop = baseline[i] - pressure[i];
    if (drop > worstDrop) {
      worstDrop = drop;
      worstPad = (int)i;
    }
  }
  if (worstPad >= 0 && worstDrop >= 0.35f) {
    leakSuspect = true;
    strlcpy(leakSuspectPad, padNames[worstPad], sizeof(leakSuspectPad));
    SERIAL_DBG("[LEAK] Подозрение: %s падение %.2f бар за %lu с\n", leakSuspectPad, worstDrop,
                  (unsigned long)((now - baselineMs) / 1000));
  } else {
    leakSuspect = false;
    leakSuspectPad[0] = '\0';
  }
  haveBaseline = false;
}

/* ====================  setManualTargetPressure  ==================== */
void setManualTargetPressure(Pad pad) {
  MutexGuard guard(xStateMutex);
  if (guard) {
    manualTargetPressure[pad] = pressure[pad];
    manualTargetSet[pad] = true;
  }
  SERIAL_DBG("[MANUAL] Установлено целевое давление для %s: %.1f бар\n",
                padNames[pad], manualTargetPressure[pad]);
  setDisplayDirty();
}

/* ====================  setAllManualTargetsFromCurrent  ==================== */
void setAllManualTargetsFromCurrent() {
  MutexGuard guard(xStateMutex);
  if (guard) {
    for (uint8_t i = 0; i < PAD_COUNT; i++) {
      manualTargetPressure[i] = pressure[i];
      manualTargetSet[i] = true;
    }
  }
  SERIAL_DBGLN("[MANUAL] Установлены целевые давления для всех подушек из текущих значений");
  setDisplayDirty();
}

/* ====================  setManualTargetsFromParkingPolicy  ==================== */
void setManualTargetsFromParkingPolicy() {
  const float parking = cfg_getParkingPressureBar();
  float targets[PAD_COUNT];
  if (parking > 0.00f) {
    for (uint8_t i = 0; i < PAD_COUNT; i++) {
      targets[i] = parking;
    }
  } else {
    const float front = cfg_getMovementPressureFront();
    const float rear = cfg_getMovementPressureRear();
    targets[PAD_FRONT_LEFT] = front;
    targets[PAD_FRONT_RIGHT] = front;
    targets[PAD_REAR_LEFT] = rear;
    targets[PAD_REAR_RIGHT] = rear;
  }

  MutexGuard guard(xStateMutex);
  if (guard) {
    for (uint8_t i = 0; i < PAD_COUNT; i++) {
      manualTargetPressure[i] = targets[i];
      manualTargetSet[i] = true;
    }
  }
  SERIAL_DBG("[MANUAL] Цели стоянки: FL=%.2f FR=%.2f RL=%.2f RR=%.2f (parking=%.2f)\n",
                targets[PAD_FRONT_LEFT], targets[PAD_FRONT_RIGHT],
                targets[PAD_REAR_LEFT], targets[PAD_REAR_RIGHT], parking);
  setDisplayDirty();
}

/* ====================  masterSupplyReadyForWork  ==================== */
bool masterSupplyReadyForWork() {
#if ENABLE_SIMULATION
  return true;
#else
  const float masterLow = cfg_getMasterLowBar();
  if (masterLow <= 0.0f) return false;
  if (cfg_errorIsActive(ERR_LOW_PRESSURE)) return false;
  float localMaster = 0.0f;
  {
    MutexGuard guard(xStateMutex, pdMS_TO_TICKS(50));
    if (guard) localMaster = masterPressure;
    else return false;
  }
  return localMaster >= masterLow;
#endif
}

/* ====================  maintainManualPressure  ==================== */
void maintainManualPressure() {
  if (cfg_errorIsActive(ERR_SENSOR)) {
    static uint32_t lastLog = 0;
    if (millis() - lastLog > 30000) {
      lastLog = millis();
      SERIAL_DBGLN("[MANUAL] Датчик давления неисправен, поддержание давления приостановлено");
    }
    return;
  }

  if (!masterSupplyReadyForWork()) {
    static uint32_t lastLog = 0;
    if (millis() - lastLog > 30000) {
      lastLog = millis();
      SERIAL_DBGLN("[MANUAL] Поддержание пауза: нет МП / min P Маг.=0 / LOW_PRESSURE");
    }
    return;
  }

  static uint32_t lastAdjustFront = 0;
  static uint32_t lastAdjustRear = 0;
  static uint32_t lastPressureRequest = 0;

  uint32_t currentTime = millis();
  float p[PAD_COUNT];
  float tgt[PAD_COUNT];

  {
    MutexGuard guard(xStateMutex);
    if (!guard) return;
    for (uint8_t i = 0; i < PAD_COUNT; i++) {
      if (!manualTargetSet[i]) {
        manualTargetPressure[i] = pressure[i];
        manualTargetSet[i] = true;
      }
      p[i] = pressure[i];
      tgt[i] = manualTargetPressure[i];
    }
  }

  const float avgFront = (p[PAD_FRONT_LEFT] + p[PAD_FRONT_RIGHT]) * 0.5f;
  const float avgRear = (p[PAD_REAR_LEFT] + p[PAD_REAR_RIGHT]) * 0.5f;
  const float tgtFront = (tgt[PAD_FRONT_LEFT] + tgt[PAD_FRONT_RIGHT]) * 0.5f;
  const float tgtRear = (tgt[PAD_REAR_LEFT] + tgt[PAD_REAR_RIGHT]) * 0.5f;
  const float diffFront = tgtFront - avgFront;
  const float diffRear = tgtRear - avgRear;
  const bool farFront = fabsf(diffFront) > MANUAL_PRESSURE_TOLERANCE;
  const bool farRear = fabsf(diffRear) > MANUAL_PRESSURE_TOLERANCE;
  const uint32_t checkIv = (farFront || farRear)
                             ? MANUAL_FAR_CHECK_INTERVAL_MS
                             : MANUAL_TARGET_CHECK_INTERVAL_MS;

  if (currentTime - lastPressureRequest >= checkIv) {
    requestPressureMeasurement();
    lastPressureRequest = currentTime;
    vTaskDelay(pdMS_TO_TICKS(200));
  }

  const uint32_t inflMs = (uint32_t)cfg_getInflateDelay() * 1000UL;
  const uint32_t deflMs = (uint32_t)cfg_getReleaseDelay() * 1000UL;

  auto tryAxle = [&](bool front, float diff, uint32_t &lastAdj) {
    if (fabsf(diff) <= MANUAL_PRESSURE_TOLERANCE) return;
    if (currentTime - lastAdj < MANUAL_ADJUSTMENT_COOLDOWN_MS) return;
    if (manifoldIsBusy()) return;

    const bool inflate = diff > 0.0f;
    SERIAL_DBG("[MANUAL] ось %s %s: avg→цель Δ=%.2f\n",
                  front ? "FRONT" : "REAR",
                  inflate ? "INFL" : "DEFL", diff);
    if (pulseAxlePair(front, inflate, inflate ? inflMs : deflMs)) {
      lastAdj = millis();
      setDisplayDirty();
    }
  };

  tryAxle(true, diffFront, lastAdjustFront);
  tryAxle(false, diffRear, lastAdjustRear);
}

/* ====================  maintainMovementPressure  ==================== */
void maintainMovementPressure() {
  if (!masterSupplyReadyForWork()) {
    static uint32_t lastWaitLog = 0;
    if (millis() - lastWaitLog > 30000) {
      lastWaitLog = millis();
      SERIAL_DBGLN("[MOVEMENT] Поддержание пауза: нет МП / min P Маг.=0 / LOW_PRESSURE");
    }
    return;
  }

  static uint32_t lastAdjustmentTimeFront = 0;
  static uint32_t lastAdjustmentTimeRear = 0;
  static const uint32_t ADJUSTMENT_COOLDOWN_MS = 5000;
  static uint32_t lastPressureCheck = 0;

  uint32_t currentTime = millis();

  if (currentTime - lastPressureCheck >= 120000) {
    requestPressureMeasurement();
    lastPressureCheck = currentTime;
    vTaskDelay(pdMS_TO_TICKS(200));
  }

  float targetPressureFront = cfg_getMovementPressureFront();
  float targetPressureRear = cfg_getMovementPressureRear();
  float minPressure = cfg_getPressureMin();

  float avgPressureFront, avgPressureRear;
  float currentPressure[PAD_COUNT];
  float currentMaster;

  {
    MutexGuard guard(xStateMutex);
    if (!guard) return;
    memcpy(currentPressure, pressure, sizeof(pressure));
    currentMaster = masterPressure;
    avgPressureFront = (currentPressure[PAD_FRONT_LEFT] + currentPressure[PAD_FRONT_RIGHT]) / 2.0f;
    avgPressureRear = (currentPressure[PAD_REAR_LEFT] + currentPressure[PAD_REAR_RIGHT]) / 2.0f;
  }

  float masterLow = cfg_getMasterLowBar();
  if (masterLow > 0.0f && currentMaster < masterLow) {
    SERIAL_DBG("[MOVEMENT] Низкое давление в магистрали: %.1f бар < %.1f\n",
                  currentMaster, masterLow);

    extern bool errorScreenBlocking;
    if (!cfg_errorIsActive(ERR_LOW_PRESSURE)) {
      cfg_errorHandle(ERR_LOW_PRESSURE, "Низкое давление в магистрали");
      errorScreenBlocking = true;
      emergencyStop();
    }
    return;
  }

  float diffFront = targetPressureFront - avgPressureFront;
  float maxPressure = cfg_getPressureMax();

  bool canAdjustFront = true;
  if (diffFront > 0) {
    if (currentPressure[PAD_FRONT_LEFT] >= maxPressure - cfg_getPressureDeadband() || currentPressure[PAD_FRONT_RIGHT] >= maxPressure - cfg_getPressureDeadband()) {
      canAdjustFront = false;
      SERIAL_DBGLN("[MOVEMENT] Передние подушки достигли MAX давления!");
    }
  } else if (diffFront < 0) {
    if (currentPressure[PAD_FRONT_LEFT] <= minPressure + cfg_getPressureDeadband() || currentPressure[PAD_FRONT_RIGHT] <= minPressure + cfg_getPressureDeadband()) {
      canAdjustFront = false;
      SERIAL_DBGLN("[MOVEMENT] Передние подушки достигли MIN давления!");
    }
  }

  if (canAdjustFront && fabsf(diffFront) > cfg_getMovementTolerance() && (currentTime - lastAdjustmentTimeFront >= ADJUSTMENT_COOLDOWN_MS)) {
    const uint32_t inflMs = (uint32_t)cfg_getInflateDelay() * 1000UL;
    const uint32_t deflMs = (uint32_t)cfg_getReleaseDelay() * 1000UL;

    if (diffFront > 0) {
      SERIAL_DBG("[MOVEMENT] Накачка передних: %.1f -> %.1f\n", avgPressureFront, targetPressureFront);
      pulseAxlePair(true, true, inflMs);
    } else {
      SERIAL_DBG("[MOVEMENT] Стравливание передних: %.1f -> %.1f\n", avgPressureFront, targetPressureFront);
      pulseAxlePair(true, false, deflMs);
    }
    lastAdjustmentTimeFront = currentTime;
    movementLastAdjustFront = currentTime;
    movementLastAdjustFrontDir = (diffFront > 0) ? 1 : -1;
    setDisplayDirty();
  }

  float diffRear = targetPressureRear - avgPressureRear;

  bool canAdjustRear = true;
  if (diffRear > 0) {
    if (currentPressure[PAD_REAR_LEFT] >= maxPressure - cfg_getPressureDeadband() || currentPressure[PAD_REAR_RIGHT] >= maxPressure - cfg_getPressureDeadband()) {
      canAdjustRear = false;
      SERIAL_DBGLN("[MOVEMENT] Задние подушки достигли MAX давления!");
    }
  } else if (diffRear < 0) {
    if (currentPressure[PAD_REAR_LEFT] <= minPressure + cfg_getPressureDeadband() || currentPressure[PAD_REAR_RIGHT] <= minPressure + cfg_getPressureDeadband()) {
      canAdjustRear = false;
      SERIAL_DBGLN("[MOVEMENT] Задние подушки достигли MIN давления!");
    }
  }

  if (canAdjustRear && fabsf(diffRear) > cfg_getMovementTolerance() && (currentTime - lastAdjustmentTimeRear >= ADJUSTMENT_COOLDOWN_MS)) {
    const uint32_t inflMs = (uint32_t)cfg_getInflateDelay() * 1000UL;
    const uint32_t deflMs = (uint32_t)cfg_getReleaseDelay() * 1000UL;

    if (diffRear > 0) {
      SERIAL_DBG("[MOVEMENT] Накачка задних: %.1f -> %.1f\n", avgPressureRear, targetPressureRear);
      pulseAxlePair(false, true, inflMs);
    } else {
      SERIAL_DBG("[MOVEMENT] Стравливание задних: %.1f -> %.1f\n", avgPressureRear, targetPressureRear);
      pulseAxlePair(false, false, deflMs);
    }
    lastAdjustmentTimeRear = currentTime;
    movementLastAdjustRear = currentTime;
    movementLastAdjustRearDir = (diffRear > 0) ? 1 : -1;
    setDisplayDirty();
  }
}
