timurufa86/kamaz_leveler/kamaz_10_16_8_fr_adafruiti_OTA_NM/ota_net.cpp

#include "ota_net.h"
#include "ota_download_ca.h"
#include "logger.h"
#include "app_globals.h"
#include "task_pool.h"
#include "task_monitor.h"
#include "valve_ctrl.h"
#include "event_bus.h"
#include "error_handler.h"
#include "ha_api.h"

#include <WiFi.h>
#include <WiFiClientSecure.h>
#include <HTTPClient.h>
#include <LittleFS.h>
#include <esp_heap_caps.h>
#include <esp_ota_ops.h>
#include <Update.h>
#include <new>

/* 10.15.0: проверка сертификата включена. CA-бандл ядра подключается, если
   заголовок доступен; иначе соединение остаётся незащищённым, но это
   фиксируется флагом otaTlsInsecure и громким сообщением в Serial. */
#if __has_include("esp_crt_bundle.h")
#include "esp_crt_bundle.h"
#define KAMAZ_OTA_HAS_CERT_BUNDLE 1
#elif __has_include(<mbedtls/esp_crt_bundle.h>)
#include <mbedtls/esp_crt_bundle.h>
#define KAMAZ_OTA_HAS_CERT_BUNDLE 1
#else
#define KAMAZ_OTA_HAS_CERT_BUNDLE 0
#endif

volatile bool otaTlsInsecure = false;

void otaConfigureTls(WiFiClientSecure *client) {
  if (!client) return;
#if KAMAZ_OTA_HAS_CERT_BUNDLE
  extern const uint8_t rootca_crt_bundle_start[] asm("_binary_x509_crt_bundle_start");
  extern const uint8_t rootca_crt_bundle_end[] asm("_binary_x509_crt_bundle_end");
  const size_t bundleLen = static_cast<size_t>(rootca_crt_bundle_end - rootca_crt_bundle_start);
  if (bundleLen > 0) {
    client->setCACertBundle(rootca_crt_bundle_start, bundleLen);
    otaTlsInsecure = false;
    return;
  }
#endif
  client->setInsecure();
  otaTlsInsecure = true;
  SERIAL_DBGLN("[OTA-TLS] ВНИМАНИЕ: CA-бандл недоступен, проверка сертификата ОТКЛЮЧЕНА");
}

/**
 * 10.15.4: TLS только для соединения скачивания образа — закреплённые корни
 * (Sectigo E46 для github.com, ISRG X1 для release-assets.githubusercontent.com).
 * Полный CA-бандл ESP-IDF после esp_ota_begin() уже не помещается в кучу: проверка
 * цепочки падала с MBEDTLS X509 fatal, и прерванная загрузка не могла
 * переподключиться и продолжиться с места обрыва. Закреплённые корни требуют
 * единиц КБ. Целостность образа по-прежнему гарантирует SHA-256 из digest,
 * полученного по отдельному проверенному API-соединению.
 */
void otaConfigureTlsDownload(WiFiClientSecure *client) {
  if (!client) return;
  client->setCACert(OTA_DOWNLOAD_CA_PEM);
  otaTlsInsecure = false;
}

/**
 * 10.15.5: image-download TLS without certificate verification (see header).
 */
void otaConfigureTlsInsecureDownload(WiFiClientSecure *client) {
  if (!client) return;
  client->setInsecure();
  otaTlsInsecure = true;
}

/** 10.15.0: прошивка и метаданные загружаются только по https. */
bool otaUrlIsHttps(const char *url) {
  return url != nullptr && strncmp(url, "https://", 8) == 0;
}

void githubOtaDefragHeap() {
  // Two-pass coalesce: grab every large free block, free LIFO.
  for (int pass = 0; pass < 2; pass++) {
    void *hold[48];
    int n = 0;
    size_t sz = heap_caps_get_largest_free_block(MALLOC_CAP_8BIT | MALLOC_CAP_INTERNAL);
    while (n < 48 && sz >= 512) {
      hold[n] = heap_caps_malloc(sz, MALLOC_CAP_8BIT | MALLOC_CAP_INTERNAL);
      if (!hold[n]) {
        sz /= 2;
        continue;
      }
      n++;
      sz = heap_caps_get_largest_free_block(MALLOC_CAP_8BIT | MALLOC_CAP_INTERNAL);
    }
    while (n > 0) {
      heap_caps_free(hold[--n]);
    }
  }
}

// TLS-reserve disabled: parking 28KB split the free list so maxBlk stuck ~36KB
// and mbedTLS BIGNUM failed even with ~85KB free. Prefer stack trims + defrag.
void githubOtaReserveTlsHeap(const char *why) {
  (void)why;
}

void githubOtaReleaseTlsHeap(const char *why) {
  (void)why;
}

volatile bool s_otaWorkersPaused = false;
static uint16_t s_otaPauseDepth = 0;
static bool s_otaPauseHadValveLock = false;

void githubOtaPauseWorkers(bool pause) {
  if (pause) {
    if (s_otaPauseDepth == 0) {
      s_otaPauseHadValveLock = otaValveLock;
      // 10.15.0: сначала закрыть пневматику, и только потом морозить задачи —
      // раньше vTaskSuspend заставал открытые клапаны на всю TLS-сессию.
      otaQuiesceForNetwork();
      // 10.16.0: остановить HTTP-сервер HA — освободить сокеты и ~5 КБ кучи под TLS.
      haOtaBegin();
    }
    s_otaPauseDepth++;
  } else {
    if (s_otaPauseDepth == 0) return;       // лишний resume игнорируем
    s_otaPauseDepth--;
    if (s_otaPauseDepth > 0) return;        // вложенная пауза ещё активна
    otaValveLock = s_otaPauseHadValveLock;  // вернуть прежнее состояние
    haOtaEnd();
  }
  s_otaWorkersPaused = pause;

  const uint8_t idxs[] = {taskIndex_Event,   taskIndex_Display, taskIndex_IMU,
                          taskIndex_Control, taskIndex_Valve,   taskIndex_Pressure,
                          taskIndex_ErrRec,  taskIndex_Button,  taskIndex_Calib};
  TaskHandle_t self = xTaskGetCurrentTaskHandle();
  for (uint8_t idx : idxs) {
    if (idx == 0xFF) continue;
    // 10.15.0: задача, вызвавшая сеть (кнопки/дисплей), не усыпляет саму себя —
    // vTaskSuspend себя оставлял xDisplayMutex захваченным навсегда.
    if (TaskPool::getHandle(idx) == self) continue;
    if (pause) TaskPool::suspendTask(idx);
    else TaskPool::resumeTask(idx);
  }
}

void githubOtaPrintHeap(const char *tag) {
  SERIAL_DBG("[OTA-HEAP] %s free=%u maxBlk=%u int=%u\n", tag ? tag : "?",
                static_cast<unsigned>(ESP.getFreeHeap()),
                static_cast<unsigned>(ESP.getMaxAllocHeap()),
                static_cast<unsigned>(heap_caps_get_free_size(MALLOC_CAP_INTERNAL)));
}

void githubOtaHeartbeat() {
  extern uint8_t taskIndex_OTA;
  TaskPool::markRun(taskIndex_OTA);
  TaskMonitor::updateTaskStatus(TaskMonitor::TASK_OTA);
  // 10.15.0: метки остановленных задач больше не подделываются — монитор
  // честно пропускает проверку, пока пауза активна (см. TaskMonitor::checkTasks).
}

static esp_ota_handle_t s_ghOtaHandle = 0;
static bool s_ghOtaActive = false;
static const esp_partition_t *s_ghOtaPart = nullptr;

esp_ota_handle_t  getGhOtaHandle()   { return s_ghOtaHandle; }
bool              getGhOtaActive()    { return s_ghOtaActive; }
const esp_partition_t *getGhOtaPart() { return s_ghOtaPart; }
void setGhOtaHandle(esp_ota_handle_t h) { s_ghOtaHandle = h; }
void setGhOtaActive(bool v)             { s_ghOtaActive = v; }
void setGhOtaPart(const esp_partition_t *p) { s_ghOtaPart = p; }

void githubOtaClearUpdate(const char *why) {
  if (s_ghOtaActive) {
    SERIAL_DBG("[GH-OTA] abort esp_ota (%s) handle=%u\n", why ? why : "?",
                  static_cast<unsigned>(s_ghOtaHandle));
    esp_ota_abort(s_ghOtaHandle);
    s_ghOtaActive = false;
    s_ghOtaHandle = 0;
    s_ghOtaPart = nullptr;
  }
  if (Update.isRunning()) {
    SERIAL_DBG("[GH-OTA] abort Update (%s)\n", why ? why : "?");
    Update.abort();
  }
  Update.clearError();
}

void githubOtaEndInstallSession(const char *why) {
  otaInProgress = false;
  githubOtaReserveTlsHeap(why ? why : "ota-end");
  githubOtaPauseWorkers(false);
  /* 10.15.6: every download exit restores the tasks freed at install start, so
     the menu "install latest" path gets the same heap headroom as the serial
     path. Idempotent (no-op when nothing was freed). */
  githubOtaRestoreWorkerTasks();
}

bool githubResolveDownloadUrl(const char *url, char *out, size_t outLen,
                              const char *acceptHdr) {
  if (!url || !out || outLen < 24) return false;
  strlcpy(out, url, outLen);
  // Only API asset URLs need a 302 → objects.githubusercontent.com hop.
  if (!strstr(url, "api.github.com/") || !strstr(url, "/releases/assets/")) {
    return true;
  }
  if (WiFi.status() != WL_CONNECTED) return false;
  if (strncmp(url, "https://", 8) != 0) return false;

  const char *p = url + 8;
  const char *slash = strchr(p, '/');
  if (!slash) return false;
  char host[96];
  const size_t hostLen = static_cast<size_t>(slash - p);
  if (hostLen == 0 || hostLen >= sizeof(host)) return false;
  memcpy(host, p, hostLen);
  host[hostLen] = '\0';
  const char *path = slash;

  WiFi.setSleep(false);
  githubOtaReleaseTlsHeap("resolve-url");
  if (!otaInProgress) githubOtaPauseWorkers(true);
  githubOtaDefragHeap();
  vTaskDelay(pdMS_TO_TICKS(40));

  bool ok = false;
  WiFiClientSecure *client = new (std::nothrow) WiFiClientSecure();
  if (!client) {
    if (!otaInProgress) githubOtaPauseWorkers(false);
    return false;
  }
  otaConfigureTls(client);
  client->setHandshakeTimeout(25);
  client->setTimeout(20000);

  // Raw GET — HTTPClient often returns 302 with empty Location on ESP32.
  // Long GitHub Location (~900+ chars) must not use Arduino String (frag/fail → empty).
  if (client->connect(host, 443)) {
    client->printf(
        "GET %s HTTP/1.0\r\n"
        "Host: %s\r\n"
        "User-Agent: kamaz-leveler/10.14.15\r\n"
        "Accept: %s\r\n"
        "X-GitHub-Api-Version: 2022-11-28\r\n"
        "Connection: close\r\n\r\n",
        path, host, acceptHdr ? acceptHdr : "application/octet-stream");

    // Slurp status+headers until CRLFCRLF (heap — avoid permanent BSS).
    constexpr size_t kHdrCap = 3072;
    char *hdrBuf = static_cast<char *>(malloc(kHdrCap));
    if (!hdrBuf) {
      SERIAL_DBGLN("[GH-OTA] resolve hdr malloc fail");
      client->stop();
      delete client;
      if (!otaInProgress) {
        githubOtaReserveTlsHeap("resolve-done");
        githubOtaPauseWorkers(false);
      }
      return false;
    }
    size_t hdrLen = 0;
    const uint32_t t0 = millis();
    bool hdrDone = false;
    while (!hdrDone && hdrLen + 1 < kHdrCap && (millis() - t0) < 25000) {
      githubOtaHeartbeat();
      if (client->available()) {
        const int b = client->read();
        if (b < 0) {
          delay(1);
          continue;
        }
        hdrBuf[hdrLen++] = static_cast<char>(b);
        if (hdrLen >= 4 && hdrBuf[hdrLen - 4] == '\r' && hdrBuf[hdrLen - 3] == '\n' &&
            hdrBuf[hdrLen - 2] == '\r' && hdrBuf[hdrLen - 1] == '\n') {
          hdrDone = true;
        }
      } else if (!client->connected() && !client->available()) {
        break;
      } else {
        delay(1);
      }
    }
    hdrBuf[hdrLen] = '\0';

    int code = -1;
    if (strncmp(hdrBuf, "HTTP/", 5) == 0) {
      const char *sp = strchr(hdrBuf, ' ');
      if (sp) code = atoi(sp + 1);
    }
    SERIAL_DBG("[GH-OTA] resolve GET > HTTP %d hdr=%u done=%d\n", code,
                  static_cast<unsigned>(hdrLen), hdrDone ? 1 : 0);

    char loc[1200];
    loc[0] = '\0';
    const char *pLoc = strstr(hdrBuf, "\nLocation:");
    if (!pLoc) pLoc = strstr(hdrBuf, "\nlocation:");
    if (pLoc) {
      pLoc = strchr(pLoc, ':');
      if (pLoc) {
        ++pLoc;
        while (*pLoc == ' ' || *pLoc == '\t') ++pLoc;
        size_t n = 0;
        while (pLoc[n] && pLoc[n] != '\r' && pLoc[n] != '\n' && n + 1 < sizeof(loc)) {
          loc[n] = pLoc[n];
          ++n;
        }
        loc[n] = '\0';
      }
    }
    SERIAL_DBG("[GH-OTA] resolve Location len=%u\n", static_cast<unsigned>(strlen(loc)));

    if ((code == 301 || code == 302 || code == 307 || code == 308) && strlen(loc) >= 12) {
      if (strlen(loc) + 1 <= outLen) {
        strlcpy(out, loc, outLen);
        SERIAL_DBG("[GH-OTA] resolve -> %.80s...\n", out);
        ok = true;
      } else {
        SERIAL_DBG("[GH-OTA] resolve Location too long %u >= %u\n",
                      static_cast<unsigned>(strlen(loc)), static_cast<unsigned>(outLen));
      }
    } else if (code == 200 || code == 206) {
      ok = true;  // no redirect needed
    } else if (code > 0) {
      SERIAL_DBG("[GH-OTA] resolve unexpected HTTP %d\n", code);
    }
    free(hdrBuf);
  } else {
    char errBuf[128];
    const int elen = client->lastError(errBuf, sizeof(errBuf));
    SERIAL_DBG("[GH-OTA] resolve TLS fail (%d): %s\n", elen, errBuf);
  }

  client->stop();
  delete client;
  if (!otaInProgress) {
    githubOtaReserveTlsHeap("resolve-done");
    githubOtaPauseWorkers(false);
  }
  return ok;
}
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
