timurufa86/kamaz_leveler/(commit log)

2026-09-22 Link project to C:/my/libraries and add build tooling
    - arduino-cli.yaml: sketchbook= C:/my so libraries resolve from C:/my/libraries (project-scoped, no global changes)
    - build.cmd: compile/upload helper using arduino-cli.yaml
    - README.md: toolchain, build, libraries, release notes
    - .gitignore: ignore compiler cache (libraries/, *.d) and build artifacts
    Verified: arduino-cli compile -b esp32:esp32:esp32 --warnings none produces a firmware .bin
2026-09-22 Release 8.5.9: fix display flicker; rename sketch to 8_5_9 (keep 8_5_8)
    Bump VERSION to 8.5.9, update build.cmd/arduino-cli.yaml/README/OTA rule to point at kamaz_8_5_9. Keep 8_5_8 as previous version. Custom 16MB partition table added to both sketch folders.
    [partitions.csv]
2026-09-22 Kamaz-Leveler 8.6.0: U8g2 typography and new UI layer
    All screens except the GEM menu render with U8g2_for_Adafruit_GFX (UTF-8 Cyrillic, true font sizes instead of setTextSize): new ui_theme.h, ui_fonts.h, ui_text.cpp/h; redesigned main screen (status bar, pad cards with large values and min/max threshold bars, instrument tilt gauge); unified service screens (OTA, error, calibration, Wi-Fi scan, valve test, splash); dropped unused GFX fonts. Menu: displayDirty on menu entry, registerKeyPress under xDisplayMutex. Build: compiler.c.elf.extra_flags=-Wl,--allow-multiple-definition because GEM pulls in the U8g2 library and its u8g2_fonts.c duplicates font symbols.
    [partitions.csv]
2026-09-23 Kamaz-Leveler 8.6.1: explicit U8g2_for_Adafruit_GFX include and docs sync
    PATCH release on top of 8.6.0. The U8g2 library was already pulled in transitively via ui_fonts.h/ui_text.h, but the sketch kept a stale commented-out include from 8.5.x; now it is declared explicitly. README documents the mandatory linker flag -Wl,--allow-multiple-definition (GEM pulls in the U8g2 library whose u8g2_fonts.c duplicates font symbols). Version bumped to 8.6.1 across sketch folder, VERSION string, build.cmd, MODULES.md and release notes. Build: [BUILD] OK, sketch 1375590 B (8%), globals 61952 B (18%).
    [partitions.csv]
2026-09-23 Kamaz-Leveler 8.7.0: menu from any mode, GitHub update section, live info page
    Menu: opens by holding the pair KN3+KN4 (GPIO15+GPIO17, 2 s) from every mode/screen; emergency stop keeps priority on the pair KN4+KN5 (GPIO17+GPIO34); all other menu entry paths removed; hints and code comments now match the real buttons. Navigation: GEM back items via setParentMenuPage, main page exit action, menu value column fixed (menuValuesLeftOffset 15 -> 150, titles were truncated to 1 char), key hint drawn in the menu title bar. New Updates section: GitHub release list (/releases?per_page=5 with ArduinoJson filter), release card (date/size/status/SHA-256), install latest or any selected release via the ex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
    [partitions.csv]
2026-09-23 Kamaz-Leveler 8.8.0: tunable params, manual valve test, IMU calibration (config v3)
    ConfigManager format v3: +25 fields (master check, manual max time, pressure deadband, auto zones, movement, display, IMU motion threshold, 6 IMU offsets, programmatic zero angles); atomic save with /config.bak + read-back check; dumpToSerial; applyRuntimeSettings (no reboot needed). Hard-coded tuning constants replaced by config getters. New menu pages: IMU / MPU6050, Nastroyki (live config view); manual valve test screen (6 outputs, valve open while KN3 held, 15 s timeout, fail-safe closing); MPU diagnostics; backlight timeout with wake-on-press. Docs: README + MODULES + RELEASE_NOTES.
    [partitions.csv]
2026-09-23 Kamaz-Leveler 8.9.0: live MOVEMENT screen (targets, timers, trend, mode icons)
    New self-drawn displayMovementScreen(): front/rear target vs actual with tolerance-coloured delta, four pad cards with target ticks, timers (in-motion, settle countdown bar, next pressure check, last correction), active-valve flow animation, 30 s sparkline trend, mode icon (iconMovingL) + pulse in the status bar, exponential smoothing and per-frame dirty updates. Display-only globals exposed: movementLastAdjustFront/Rear (+Dir) and movementStartMs. No config changes (format stays 3); movement/leveling logic untouched.
    [partitions.csv]
2026-09-30 Release 10.1.22: MOT+DMP gyro motion, zero-angle fix, factory gyro offsets.
    Adds sketch kamaz_10_1_22 with reliable movement detection for driving, fixed IMU zeroing, menu cleanup, and OTA-ready build.cmd pointer.
    [partitions.csv]
2026-10-02 chore: add kamaz_10_4_1 sketch as modularization baseline
    [partitions.csv]
2026-10-02 refactor(modules): phase2 imu extract
    - imu_dmp.h/.cpp: initializeDMP(), MPU6050 mpu, GKalman filterX/filterY,
    i2cBusRecover(), i2cScanLog()
    - imu_motion.h/.cpp: detectMotionFromIMU(), g_mot* motion detection state
    - task_imu.h/.cpp: imuTask(), g_imu* stream/stats state
    - app_globals: movement state (isMoving, movementModeActive, etc.),
    ENABLE_MPU6050/ENABLE_SIMULATION feature flags, imuQueueDropCount
    - app_types: PAD_COUNT, IMUData, PressureData structs
    - .ino: cfg_* bridge functions for ConfigManager/ErrorHandler/TaskMonitor
    (inline methods can't be called cross-TU)
    - Dead code wrapped in #if 0 (initializeDMP, imuTask bodies in .ino)
    No logic changes — cut-paste move only. Build g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
    [app_globals.cpp, app_globals.h, app_types.h, imu_dmp.cpp, imu_dmp.h, imu_motion.cpp, imu_motion.h, task_imu.cpp]
2026-10-02 refactor(modules): phase3 pneumatics extract
2026-10-02 refactor(modules): phase5 wiring-only ino
2026-10-03 fix(watchdog): restore OTA/Valve TaskMonitor heartbeats
    Valve used index 10 (ErrorRecovery) instead of TASK_VALVE=9; OTA lost updateTaskStatus after modular extract. Bump to 10.4.8 and grow WatchdogTask stack.
    [ota_net.cpp, task_ota.cpp, task_valve.cpp]
2026-10-03 fix(imu): gentler MPU I2C probe before bus recover
    Avoid Wire.end on first attempt; include 0x78 in scan log; TEST I2C reports mpu68/mpu69. Bump to 10.4.9.
    [imu_dmp.cpp]
2026-10-03 feat(imu): add configurable DLPF default MPU6050_DLPF_BW_5
    Config v9 imuDlpfMode (0..6), menu DLPF spinner, apply after DMP. Default mode 6 = 5 Hz for vibration rejection. VERSION 10.5.0.
    [config_manager.cpp, config_manager.h, imu_dmp.cpp, ui_menu_build.cpp, ui_menu_build.h]
2026-10-03 feat(imu): MPU menu regroup, ±8G accel FS, clear spinner labels (10.5.1)
    Move MOT/DLPF/detection into MPU page; Movement keeps pressures/timers only.
    Config v10 adds imuAccelFs (default FS_8); angle UI slimmed to smoothness preset.
2026-10-03 fix(imu): use world-frame linear accel for motion RMS (10.5.2)
    Apply Electronic Cats MotionApps 6.12 guidance: dmpGetLinearAccelInWorld
    so linAcc detection is independent of sensor tilt.
    [task_imu.cpp]
2026-10-03 fix(ui): enlarge GEM checkbox sprites 2x (10.6.1)
    Default 7x8 checkmark was hard to see on ST7789 with Cyrillic fonts.
    [ui_menu_build.cpp]
2026-10-03 refactor(menu): nest System/ValveBlock pages, drop Save item (10.6.2)
    Move OTA/Display/Info under System; Pressure/Valves/Test under Valve block.
    Save still happens on menu exit.
2026-10-03 chore(release): rename sketch to 10.6.2 and sync build.cmd
    Align folder/ino names with VERSION for OTA publish of v10.6.2.
    [partitions.csv]
2026-10-03 release(10.6.4): pressure menu labels and master check in minutes
    Widen GEM label column; rename pressure items; Проверка P Маг. uses minutes (stored as sec×60).
    [menu_tree_10_6_4.xlsx]
2026-10-03 fix(ota): download firmware via api.github.com asset URL
    github.com/releases/download TLS fails (BIGNUM alloc). Use releases API + digest sha256 and Accept octet-stream on api.github.com.
    [ota_install.cpp, ota_install.h, ota_list.cpp, ui_ota_menu.cpp]
2026-10-03 fix(ota): resolve GitHub asset 302 to CDN before stream download
    HTTP/1.0 client was not following api.github.com redirects; resolve Location then stream from objects.githubusercontent.com.
    [ota_install.cpp, ota_list.cpp, ota_net.cpp, ota_net.h]
2026-10-04 release(10.7.25): snapshot working firmware; keep 10.6.x only
    Pin kamaz_10_7_25 as current sketch (GitHub WiFi OTA proven), retain
    kamaz_10_6_2 lineage, and remove older 8.x/9.x/10.0–10.4 trees.
2026-10-13 release(10.14.22): modular FreeRTOS firmware, 4MB custom partition
    Adds the current sketch kamaz_10_14_22_fr_adafruiti_OTA_NM (V 10.14.22 FreeRTOS OTA) and the previous 10.14.21 iteration; drops the superseded kamaz_10_6_2 sketch.
    build.cmd compiles 10_14_22 with PartitionScheme=custom,FlashSize=4M (1.75MB OTA slots; app image 1531952 B = 83.5% of a slot).
    Adds bench data and tooling: runs/*.csv, tools/btn_test.py, _dmp_motion_discover.py, _stat_motion_drive.py.
2026-10-13 fix(safety,ota): 10.15.0 — latching emergency stop, pressure guards, verified OTA only
    Pneumatics: emergencyStop() now latches (reset with a second KN1+KN4 hold) and forces the pins low without waiting for a mutex; pressure is re-read every 100 ms inside pad/axle/side pulses with a post-pulse check; manual hold guarded every 500 ms; valve pins de-energised in the first lines of setup(); valve test closes INFL while waiting for supply, doses it 2s/3s with a 5 min timeout, and valveTestAbort() releases manifoldBusy on cancel/emergency.
    OTA: removed the HTTPUpdate fallback that activated an image without checking SHA-256; https-only; known size passed on the install-latest path; CA bundle TL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
2026-10-17 fix(wdt): 10.15.1 — reconfigure TWDT instead of double init; bump patch version
    Arduino core creates the Task Watchdog before setup(), so esp_task_wdt_init()
    returned ESP_ERR_INVALID_STATE and ESP-IDF logged 'E task_wdt: TWDT already
    initialized' on every boot. initWatchdog() now reconfigures the running TWDT
    (esp_task_wdt_reconfigure, timeout TASK_WDT_TIMEOUT_MS) and falls back to the
    core configuration if reconfiguration fails. Task monitoring, valve close on
    hang and the emergency latch are unchanged.
    SemVer PATCH bump: renamed the sketch folder and .ino to kamaz_10_15_1...,
    synced build.cmd, README, MODULES.md and RELEASE_NOTES per the versioning rule.
2026-10-17 fix(ota): 10.15.2 — resume interrupted CDN download; clean TWDT init
    Hardware OTA test of 10.15.1 failed at ~540KB of 1.6MB. Diagnostics (TEST DEBUG ON)
    showed DNS/TCP/TLS to release-assets.githubusercontent.com were fine: the CDN
    closes the long keep-alive session mid-download, and the old code treated a
    dropped socket as fatal, restarting the whole attempt from zero; the retry even
    probed github.com again and lost the resolved CDN URL after a failed HEAD (-1).
    OTA install path:
    - recover a dropped keep-alive socket (empty status line / short chunk) by
    reconnecting and resuming from the byte offset already written; bounded to
    60 recoveries per attempt, then one full retry;
    - 16KB Ran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
2026-10-17 fix(ota): 10.15.3 — keep 4KB download chunk so TLS chain verification fits heap
    10.15.2 was withdrawn: its 16KB static chunk buffer shrank the heap and the largest
    contiguous block (measured on the board: ~98KB/61KB -> ~86KB/37KB), and ESP-IDF's
    CA bundle verification then failed for api.github.com with MBEDTLS
    "X509 - A fatal error occurred, eg the chain is too long or the vrfy callback
    failed" (-12288). With TLS to the GitHub API broken, the release list and every OTA
    check failed, so 10.15.2 could neither list nor install anything.
    - chunk buffer back to 4KB (same as 10.15.0/10.15.1), which restores TLS
    (verified on hardware: heap ~98KB, max block ~61KB, HTTP 200 from api.github.com)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
2026-10-17 fix(ota): 10.15.4 — pin download roots so interrupted OTA download can resume
    10.15.3 still failed the install: the download reached 659KB, the CDN closed the
    keep-alive session, resume triggered, but every reconnect failed TLS verification:
    E (712856) esp-x509-crt-bundle: Failed to verify certificate
    [GH-OTA] DIAG tls lastError(-12288)=X509 - A fatal error occurred ...
    Cause: after esp_ota_begin() and part of the image written, the free heap is no
    longer enough for the ESP-IDF CA bundle chain verification (bundle parsing needs
    tens of KB and one large contiguous block). The first connection still works
    (~96KB free), so the download starts, but no reconnect can verify -> resuming an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
2026-10-17 docs(ota): record 10.15.4 on-hardware verification status honestly
    The 10.15.4 release notes claimed the OTA install fully works, but the on-board
    test shows the image download still stalls:
    - release list, digest and TLS paths work;
    - the 1.6MB image download drops at ~540-660KB regardless of chunk size (4KB/16KB);
    - reconnects either get an empty response or cannot pass chain verification
    (after esp_ota_begin() the heap is 87-91KB, while CA-bundle verification needs
    more - the measured threshold on this board is ~96KB);
    - the same file downloads from a PC in 1.9s at 854KB/s with a matching SHA-256, so
    GitHub/the CDN are fine; the Wi-Fi link (-62..-84 dBm) is the likely cause.
    State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
2026-10-17 wip(ota): 10.15.5 — link telemetry, streaming GET attempt, 300KB socket rotation (not released; reconnect TLS still fails at 84-88KB heap)
2026-10-17 wip(ota): 10.15.5 — insecure download TLS, 16KB dynamic chunk, single client; measured: TLS connect fails once free heap < ~88KB (79KB with 16KB buffer)
2026-10-17 feat(ota): 10.15.5 — verified OTA install: insecure download TLS + SHA digest, 4KB chunks with 300KB socket rotation, fresh CDN URL per attempt, EventBus 128->32 (+7KB heap); on-board install of 10.1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
2026-10-17 release(10.15.5): verified OTA install; notes with on-board evidence and asset hash
2026-10-18 release(10.15.6): free worker-task stacks during OTA install (+21.7KB heap), restore on failure; verified install of 10.15.5 with slot switch
2026-10-18 fix(ota): release taken mutexes on skip; free worker tasks on every install path
    Review findings fixed in this commit:
    - githubOtaFreeWorkerTasks() leaked already-acquired mutexes when a later
    xSemaphoreTake timed out (a paused worker holding a mutex) -> permanent
    deadlock for any caller. Now releases everything taken before returning.
    - Worker-task freeing (the +21.7KB OTA heap headroom) was only wired into the
    serial install path (installGitHubReleaseIndex). Moved it into
    downloadGitHubFirmware() after pause and restore into
    githubOtaEndInstallSession(), so the menu "install latest" path
    (checkGitHubUpdate(true)) also frees tasks; removed the redundant nested
    pause/free/resto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
2026-10-18 fix(safety): float abs truncation, stale pressure clobber, false WATCHDOG, latch bypass
    Batch 1 of the full-firmware review (safety-critical findings):
    - abs(float) -> fabsf() in auto_level, pressure_read, task_control, task_imu,
    task_pressure, ui_screens. int abs() truncated thresholds below 1 (angles,
    bars, °C) -> auto-leveling ignored sub-degree tilt, movement correction only
    fired at >=1 bar, UI redraw thresholds were frozen.
    - task_pressure: during valve work / ERR_VALVE / otaValveLock the task published
    and copied its (stale) `pd` snapshot over the fresh pad/master values that
    valve_ctrl had just stored -> health-check saw dP=0, raised a false ERR_VALVE
    and triggered emer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
2026-10-18 fix(robustness): config save verification, latch checks, mutex consistency, counters
    Batch 2+3 of the full-firmware review (non-critical correctness/hygiene):
    - config_manager::save(): no longer ignores a failed /config.txt -> /config.bak
    rename, and returns false when the written file fails the read-back
    verification (previously reported success anyway).
    - valve_ctrl: emergencyStop resets manualTargetSet under xStateMutex (was
    xValveMutex while every other accessor uses xStateMutex -> write/write race);
    sendValveCommand rejects commands while the emergency latch is set.
    - task_valve: the queue path now also stops executing commands while
    emergencyIsLatched() (previously only valv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
2026-10-18 release(10.15.7): full-firmware audit fixes — float abs, stale pressure, false WATCHDOG, latch checks, config/mutex/counter hygiene
2026-10-18 fix(ha): reject unknown/forbidden config keys with 403 + list (10.16.1); set device IP in HA package/docs
2026-10-18 docs(ha): drop package script: block (conflicts with scripts.yaml include); dashboard buttons call rest_command directly
2026-10-18 feat(ha): static IP (WIFI IP), X-Api-Key header fix (collectHeaders), HA badge redraw, token/helpers/config sensor in package (10.16.3)
2026-11-01 feat(ha): mirrored pitch/roll gauge card (custom:kamaz-tilt) + single mode toggle script
2026-11-01 docs: handoff for adding a second device to Home Assistant
2026-11-04 feat(hw): add board v2 KiCad package, hardware docs and renders
    - hardware/: KiCad 10 project (2 layers, case 15-8), docs (HARDWARE, PLACEMENT_TABLE, CALCULATIONS),
    renders, production files (gerber/drill/step/BOM) and export scripts
    - hardware/3d + kicad/3dmodels: STEP models for DevKitC, BTS724G, 74HCT541D, AP3211, TPS54560B
    - .gitignore: skip hardware/backups, *.kicad_prl, *.lck
    - README: link to hardware/
2026-11-04 feat(fw): board v2 hardware map and TZ v11 specs
    - hw_map.h: PCAL9555APW map, fail-safe VLV_EN rule, BTS724G open-drain diagnostics, active-low buttons
    - TZ v11: PCAL9555 sensors, E1 implementation, agent prompt
    - PROMPT_hardware_schematic_pcb.md, _PARKED_FILES.md
2026-11-04 ci: build the firmware with arduino-cli on every push and PR
    - .github/workflows/firmware-build.yml: esp32 core 3.3.11, FQBN with the custom 4M partition
    scheme and -Wl,--allow-multiple-definition, same sketch and flags as build.cmd
    - .github/arduino-libraries.txt: 11 libraries pinned to the versions the local build uses
    (extracted from fwbuild/compile_commands.json)
2026-11-04 ci: vendor GEM and pin GFX so CI reproduces the local build
    First run failed at ui_menu_build.cpp:651 — GEMItem::setMultiplySep is missing from the
    released GEM 1.8.1, while the local copy is a master snapshot that has it.
    - ci/libraries/GEM: vendored copy (src + metadata), used via --libraries
    - .github/arduino-libraries.txt: GEM removed; Adafruit GFX pinned last because ST7735 pulls a newer one
2026-11-04 ci: really vendor GEM and track ci/libraries
    The previous commit added ci/libraries/GEM but nothing was tracked: the unanchored
    "libraries/" rule in .gitignore excludes every directory with that name, so the CI
    checkout had no GEM at all (GEM_adafruit_gfx.h not found).
    - .gitignore: /libraries/ instead of libraries/ (root-anchored, intent unchanged)
    - ci/libraries/GEM: 35 files now actually committed
